MarkDannemiller/JackOLantern/research/concepts/README.md

# Concepts

Received from Mark in chat, 2026-10-24.

| File | What it is | Design cues taken |
|---|---|---|
| `20261024-sketch-notebook.jpg` | Original notebook sketch, "Pumpkin animatronic / scarecrow" | Legless torso on a pole and base; skeletal arms with hands; head with a curled stem; Will Cogley eye mechanism; jaw on a pivot; neck pitch and yaw. Features: looks at approaching people, speaks voice lines, recognises waving and mouth motion; later voice recognition. Camera could hide in the stem |
| `20261024-head-real-build.jpg` | The 2023 head as built | Orange printed facade, blue LED eyes, camera in the nose, toothed jaw, black neck with push rods |
| `20261024-concept-art-cowboy.jpg` | Character concept art (AI image) | Cowboy hat, green bandana with pink stars, tattered orange leather vest with star cut-outs, belt and holster, segmented weathered-orange arm shells with exposed mechanical joints, a metal robotic hand tipping the hat, visible rods in the torso |
