MarkDannemiller/JackOLantern/deliverables/2026-10-25-design-report/index.html

Delta Robotics · design report, revision 2 · 25 Oct 2026 · draft for Mark's review

# Joyful Jack

A body and two moving arms for our animatronic pumpkin cowboy, designed three ways, every screw modelled, each with a step-by-step build guide, and tested in a physics simulation before anything is bought.

Tiers A, B and C side by side

$894Tier A, Beginner

$1,381Tier B, Midrange

$2,370Tier C, Maxed

810parts and fasteners in tier B

Milwaukee M18battery packs

Where Jack comes from

## A head that already works, looking for a body

Jack's head was built in 2023: printed orange face, glowing blue eyes, blinking eyelids, a talking jaw, and a neck that turns and nods. A camera in his nose finds faces so he can look at whoever walks up, and he has a few dozen cowboy voice lines. This project gives him a torso, two arms and hands, and a battery so he can stand on his own all evening.

Original notebook sketch

The first sketch. A scarecrow on a pole, no legs, a heavy base.

The real head

The real head. Reused as-is in every tier.

Concept art

The character. Hat, bandana, tattered vest, weathered orange arm shells.

The three versions

## Pick how much Jack can do

All three share the same head, base, costume and battery system. They differ in the arms, the hands and how much they can sense.

Tier A

Tier A · was under $500

### Beginner

$894

A first build: hobby servos, plywood torso, and still a character people stop for.

See tier A →

Tier B

Tier B · was up to $1,200

### Midrange

$1,381

The one to build for a season of events: smart motors, safer, and he never has to sleep.

See tier B →

Tier C

Tier C · no cap set

### Maxed

$2,370

The show piece: real robot hands with fingers that each move on their own.

See tier C →

| Tier ABeginner | Tier BMidrange | Tier CMaxed
Price (new parts) | $894 | $1,381 | $2,370
Moving joints, each arm | 3 + grip | 5 + 2-motor hand | 6 + 8-motor hand
Hands | Mitt, 1 motor | Glove, 2 motors | Humanoid, 8 motors
Feels resistance | No | Yes | Yes
Battery | 1 pack | 2 packs, hot swap | 2 packs + wall
Swap a battery while running | No | Yes | Yes
Runs the arms | Head computer | Head computer | Own computer
Parts / screws and fittings | 139 / 427 | 198 / 612 | 210 / 614
Build guide | 70 pages | 100 pages | 106 pages

Recommendation: build tier B. It is still the best value: motors that feel resistance make Jack safer around children, and two batteries mean he never has to stop. Modelling every part raised all three prices: proper bearings, belts, shoulder springs and about 600 screws and inserts replace the rough first-pass joints, so tier B is now $1,381 against the old $1,200 cap and tier A $894 against $500. Tier C's hands can be added to a tier B Jack later, since the arms share the same frame, belts and wiring.

What every Jack has

## How he stands, and what powers him

### A bucket of concrete for feet

Jack has no legs. He stands on a steel pipe set into a 5-gallon bucket filled with concrete, about 44 kg, sitting on a 24-inch plywood disc that hides under his costume. The pipe screws into a floor flange cast into the concrete.

### One battery system

He runs on the Milwaukee M18 packs we already own. A dock with a switch and a fuse takes the pack. A cut-off module switches everything off before the pack runs flat, because an M18 pack can't be relied on to protect itself without a Milwaukee tool attached. Converters then make the voltages each part needs.

### A big red stop button

A latching emergency stop on his back cuts power to every motor at once, while the computer stays on. In tiers B and C the button holds a heavy-duty relay, so it also stops the hands.

Tier B with the costume off

Costume off (tier B). The aluminium frame on the steel pole, the shoulder springs either side, and the electronics board. Arms hang on their stops, so a power cut drops nothing.

### How long he runs

A 12 Ah pack holds about 216 watt-hours. We will measure Jack's real power draw on the bench. Until then, here are planning figures (assumed draws, 85% converter efficiency):

If Jack averages | 12 Ah pack | 8 Ah pack
30 W (mostly idle) | ~6 h | ~4 h
50 W (regular gestures) | ~3.7 h | ~2.4 h
80 W (busy all evening) | ~2.3 h | ~1.5 h

Tiers B and C swap packs without stopping, and tier C can also run from the wall.

### Keeping him upright

In the simulation, a push at shoulder height with both arms out tips him at 154–164 N (about 16–17 kg of force). A teenager leaning on his shoulder could do that.

For events: lay two 25 lb sandbags on the plywood disc under the costume: the simulation then needs 205–215 N, about a third more. Or tie the pole to a post.

A

Tier A · was under $500

## Beginner

A first build: hobby servos, plywood torso, and still a character people stop for.

$894new parts; your own flannel shirt

Tier A Joyful Jack, rendered

### How he works

Eight hobby servos, the kind used in RC cars: at each shoulder two 35 kg·cm servos, at the elbow a 25 kg·cm one, each driving its joint through a 3:1 toothed belt, plus one in each mitt. A second servo board joins the one already in the head, so the head's computer runs everything. The torso is a box of 12 mm birch plywood on the steel pole.

### What he can do

- Waves: lifts his arm forward and up and waves from the elbow
- Grips a light candy bag with a one-motor mitt
- Shoulder springs carry the arm's weight, so the small motors only move it
- Runs on one M18 pack with a low-battery cut-off
- Big red stop button on his back

### What he can't

- Feel when he touches someone (no feedback from the motors)
- Twist his upper arm or wrist
- Swap the battery without switching off

139 parts · 427 screws, nuts and inserts · 21 cables · 2.7 kg of printed parts

Tier A arm, costume off

The arm, every part modelled. Belt-driven shoulder and elbow hubs on thin bearings, the servos, the screws that hold them, and the mitt.

Tier A shoulder and balancer

The shoulder. Two extension springs on the torso pull a Dyneema cord over pulleys to a lever on the shoulder hub: a "zero-length spring" balancer that cancels most of the arm's weight at every angle.

Tier A hands

The hands. A cartoon mitt: three fingers as one paddle close against a thumb, driven by one servo on a shoulder-bolt pivot. Rubber pads give it grip.

Tier A from behind, costume off

From behind. The battery pack (red) in its dock, the stop button, and the electronics board.

Tier A exploded view

Every part, pulled apart. Base and pole stay put, the torso lifts, the arms move out, the head rises, and every screw lifts out of its hole.

### Proven in simulation

The whole robot in NVIDIA Isaac Sim with real masses from the 3D model, a 0.25 kg bag in the right hand, the shoulder springs on, and each motor limited so no belt is pulled past its rating.

Wave forearm up, waving for 10 s | Passes | worst joint 35% of motor max, within 3° of target, belts at 58% of rating
Wave, springs removed the same, without the shoulder balancer | Passes | worst joint 56% of motor max, within 3° of target, belts at 92% of rating
Reach and grip arm forward, hand closes | Passes | worst joint 31% of motor max, within 2° of target, belts at 51% of rating
Arm straight out to the side, then forward, 7 s each (stress test) | Limit | the shoulder can't hold it: 19° short of target, at its limit 30% of the time
Emergency stop power cut at full reach | Passes | The arms drop to their rest stops and nothing falls.

### Where the money goes

$894 in new parts, plus 7 small items not yet priced

Arms, motors, belts$299

Power and safety$185

Controllers and computer$14.95

Torso frame$117

Base and pole$80.83

Screws and fittings$95.43

3D-printing filament$69.56

WiringTBD

Costume$32.65

ToolsTBD

Tier A system in Protoboard

The wiring, in Protoboard. Every box is a real part with its voltages; Protoboard checked every connection: 0 problems.

Build guide, tier A (PDF, 70 pages)Step-by-step assembly with every part, screw and torque, made by the Protoboard stack from the same model.

Full parts list for tier A (58 lines)

Group | Item | Qty | Each | Line | Price from
Arms, motors, belts | Shoulder servos (flex x2 + out x2), 35 kg·cm class DIYmall 2 Sets 35kg DS3235 Digital Servo, coreless, full metal gear, 270° (ASIN B0CCNFQC6S); pack = 2 servos + | 2 | $48.00 | $96.00 | source (https://www.amazon.com/dp/B0CCNFQC6S)
Arms, motors, belts | Elbow servos, 25 kg class, 270° DSSERVO DS3225 MG, 270° angle option, with metal arm/horn accessory option (AIFitLab DSSERVO store) | 2 | $20.00 | $40.00 | source (https://aifitlab.com/products/dsservo-ds3225-mg-servo-motor)
Arms, motors, belts | Century 90CS balancer springs Extension spring 0.625 OD, 27 lbf | 4 | $9.37 | $37.48 | source (https://www.centuryspring.com/shop/90cs)
Arms, motors, belts | 6806-2RS joint bearings 6806-2RS bearing 30x42x7, 10-pack (DEEG) | 2 | $13.59 | $27.18 | source (https://www.amazon.com/dp/B0CJ6YY81X)
Arms, motors, belts | GT3 9 mm belts, 240 mm (shoulder joints) 3GT (GT2-3M) closed belt 240 mm / 80T, 9 mm, 5 pcs | 1 | $20.67 | $20.67 | source (https://www.amazon.com/dp/B0FFZ968GT)
Arms, motors, belts | GT3 9 mm belts, 210 mm (elbow) 3GT (GT2-3M) closed belt 210 mm / 70T, 9 mm, 5 pcs | 1 | $20.67 | $20.67 | source (https://www.amazon.com/dp/B0FFZC2YJB)
Arms, motors, belts | Hand grip servos (tier A), MG996R 4-pack Hosyond MG996R 55 g metal-gear digital servo, 4-pack | 1 | $16.99 | $16.99 | source (https://www.amazon.com/s?k=hosyond+mg996r+4+pack)
Arms, motors, belts | 2 mm Dyneema balancer cord 2 mm Dyneema cord, 20 m, 200 kg | 1 | $9.00 | $9.00 | source (https://www.amazon.com/dp/B00Q9IHLBS)
Arms, motors, belts | 624-2RS balancer sheave bearings 624-2RS bearing 4x13x5, 16-pack (uxcell) | 1 | $8.49 | $8.49 | source (https://www.amazon.com/dp/B0CLY84GJX)
Arms, motors, belts | 625-2RS driver outboard bearings 625-2RS bearing 5x16x5, 10-pack (C3) | 1 | $7.99 | $7.99 | source (https://www.amazon.com/dp/B07X8PK5HW)
Arms, motors, belts | Shoulder screws 5 x 8, M4 Shoulder screw 5 mm x 8 mm shoulder, M4, 16 pcs (MECCANIXITY) | 1 | $7.79 | $7.79 | source (https://www.amazon.com/dp/B0FDQVBNB9)
Arms, motors, belts | 5 x 16 mm driver dowels Dowel pin 5x16 mm, 304 stainless, 15 pcs (HARFINGTON) - not hardened | 1 | $6.29 | $6.29 | source (https://www.amazon.com/dp/B0F6CZZTK6)
Power and safety | Milwaukee M18 battery adapter with switch, fuse and 12 AWG leads Generic 'Power Wheel Adapter for Milwaukee M18' with on/off switch, 30 A blade fuse, 12 AWG leads, 1-pack (Ama | 1 | $34.99 | $34.99 | source (https://www.newegg.com/p/1WM-0071-00050)
Power and safety | Bucks (tier A): one 6.8 V rail for both arms, one 5-6 V rail for the head servos, one 5.1 V for the Pi DROK 300W Power Supply Module, DC 3.5-30V to 0.8-29V 10A adjustable buck with voltmeter (DROK product code 200 | 3 | $10.20 | $30.60 | source (https://www.droking.com/dc-buck/300W-Power-Supply-Module-DC-3.5-30V-to-0.8-29V-10A-Buck-Converter-Adjustable-Voltage-Regulator-Adapter-Driver-Module-Voltmeter)
Power and safety | 12 AWG silicone wire, red + black BNTECHGO 12 AWG silicone wire, 10 ft red + 10 ft black (Amazon ASIN B01ABOPMEI) | 1 | $27.52 | $27.52 | source (https://www.newegg.com/PISKEKAT-Work-Lights/BrandSubCat/ID-218576-2092/Page-13)
Power and safety | E-stop enclosure E-stop enclosure, 1-hole yellow (Schneider XALK01H7) - recheck | 1 | $26.02 | $26.02 | source (https://www.mouser.com/ProductDetail/Schneider-Electric/XALK01H7?qs=4R4UwjOJpC3Qi7CgpTrn7w%3D%3D)
Power and safety | Servo extension leads, 300 mm, 10-pack Generic 300 mm male-female servo extension, 26 AWG, JR/Futaba (10 pcs) | 2 | $9.95 | $19.90 | source (https://www.ebay.de/itm/335657377415)
Power and safety | Latching mushroom emergency stop, 22 mm, NC 22mm NC red mushroom emergency stop push button, 40 mm head, latching (ZB2-BE102C / XB2-BS142 style) | 1 | $12.17 | $12.17 | source (https://www.fridayparts.com/22mm-nc-n-c-red-mushroom-emergency-stop-push-button-switch-600v-10a-zb2-be102c-xb2-bs142)
Power and safety | Adjustable low-voltage cutoff for 5S Li-ion (~18 V) pack XH-M609 digital low voltage disconnect module, 12-36 V, relay output (Amazon ASIN B0FJ8NC729, MTDELE) | 1 | $9.99 | $9.99 | source (https://sentinel.rocketium.com/products/amazon/B0FJ8NC729)
Power and safety | Inline ATC fuse holder, 12 AWG Eaton Bussmann BK/HHD ATC in-line fuse holder, 12 Ga. leads (24 A) | 4 | $2.18 | $8.72 | source (https://www.waytekwire.com/product/eaton-s-bussmann-series-bk-hhd-atc-in-line-fuse)
Power and safety | ATC blade fuse assortment Bussmann ATC fuse assortment, variety pack (10/15/20/25/30 A) | 1 | $8.32 | $8.32 | source (https://www.walmart.com/ip/1764066057)
Power and safety | XT60 connector pairs Amass XT60 connectors, 2 pairs, yellow (BuddyRC SKU 002-0201) | 2 | $3.49 | $6.98 | source (https://buddyrc.com/products/genuine-xt60-connectors-2-pairs-yellow-1)
Controllers and computer | Second PCA9685 16-channel servo driver Adafruit 16-Channel 12-bit PWM/Servo Driver, I2C (PCA9685), Product ID 815 | 1 | $14.95 | $14.95 | source (https://www.adafruit.com/product/815)
Torso frame | 1/2 in birch plywood for the tier A torso box 1/2 in birch plywood project panel 2 x 4 ft, A2 (Home Depot) | 1 | $40.22 | $40.22 | source (https://www.homedepot.com/p/Falken-Design-1-2-in-x-2-ft-x-4-ft-Birch-Plywood-Project-Panel-FALKENDESIGN-PW-Birch-A2-1-2-2448/319137400)
Torso frame | 2020 extrusion, cut list 102 mm x2, 190 mm x2 Maker Store USA V-Slot 20x20mm, clear anodized, SKU LR-2020-S, 500 mm length | 2 | $6.75 | $13.50 | source (https://makerstore.cc/product/v-slot-20-x-20mm/)
Torso frame | 6 mm 6061 plate for the neck plate (150 x 150) 6061 aluminium plate 6 mm, 6 x 6 in (152 x 152 mm), 1 pc | 1 | $12.99 | $12.99 | source (https://www.amazon.com/dp/B0H87TP596)
Torso frame | M5 drop-in T-nuts for 2020 Drop-in tee nut M5, 10-pack (Maker Store) | 1 | $11.93 | $11.93 | source (https://makerstore.cc/product/drop-in-tee-nuts-pack-of-10/)
Torso frame | 1/4 in plywood, 2 x 4 ft project panel (torso ribs, tier A) B/C Sanded Plywood Project Panel 1/4 in x 2 ft x 4 ft (Home Depot Internet # 205748601) | 1 | $11.22 | $11.22 | source (https://homedepot.com/p/1-4-in-x-2-ft-x-4-ft-B-C-Sanded-Plywood-Project-Panel-00102/205748601)
Torso frame | #4 x 1/2 in wood screws (trays, board) #4 x 1/2 in flat head wood screw, zinc, 100 pcs | 1 | $7.35 | $7.35 | source (https://www.amazon.com/dp/B07C52W8WL)
Torso frame | Cast 90 deg corner brackets, 20 series Cast 90 deg corner bracket 20 series (Maker Store) | 4 | $1.80 | $7.20 | source (https://makerstore.cc/product/cast-90-degree-corner-bracket/)
Torso frame | #8 x 1-1/4 in wood screws (ply torso) #8 x 1-1/4 in flat head wood screw, 100 pcs (Hillman 35054) | 1 | $6.98 | $6.98 | source (https://www.amazon.com/dp/B00OTWQSIS)
Torso frame | M5 hammer-in tee nuts M5 hammer-in tee nut, 4-prong, zinc, 60 pcs (Hitefu) | 1 | $5.49 | $5.49 | source (https://www.amazon.com/dp/B0CLJBLYSC)
Torso frame | #8 x 3/4 in wood screw TBD | 1 | TBD | TBD
Base and pole | ALTERNATE for the 24 in round pine board: 3/4 in birch plywood 2x2 ft project panel, cut to a 24 in circle in-house Falken Design 3/4 in x 2 ft x 2 ft Birch Plywood Project Panel, FALKENDESIGN-PW-Birch-A2-3-4-2424 (HD 31913741 | 1 | $29.49 | $29.49 | source (https://www.homedepot.com/p/Falken-Design-3-4-in-x-2-ft-x-2-ft-Birch-Plywood-Project-Panel-FALKENDESIGN-PW-Birch-A2-3-4-2424/319137413)
Base and pole | 1 in x 30 in black nipple (mast) 1 in x 30 in Sch 40 black steel nipple, threaded both ends | 1 | $17.75 | $17.75 | source (https://www.globalindustrial.com/p/1-x-30-schedule-40-black-carbon-steel-nipple-700-3000-psi)
Base and pole | 1 in floor flange for center post Southland 1 in. Black Malleable Iron Threaded Floor Flange 521-605HN | 2 | $6.97 | $13.94 | source (https://homedepot.com/p/Southland-1-in-Black-Malleable-Iron-Threaded-Floor-Flange-521-605HN/100179931)
Base and pole | hex-bolt-1-4-20x1.25in (kit includes the nylock nuts and washers) 1/4-20 x 1-1/4 in hex bolt kit with nylock nuts and washers, 18 sets | 1 | $8.99 | $8.99 | source (https://www.amazon.com/dp/B0DM1WDZRL)
Base and pole | Concrete mix to fill bucket (~18.9 L = 0.667 cu ft) Quikrete Concrete Mix No. 1101, 80 lb bag (Home Depot model 110180) | 1 | $5.68 | $5.68 | source (https://shopsavvy.com/products/quickrete-80lb-concrete-mix)
Base and pole | 5 US gallon plastic bucket (ballast base) The Home Depot 5 Gallon Orange Homer Bucket, model 05GLHD2 (Internet #100087613) | 1 | $4.98 | $4.98 | source (https://www.homedepot.com/p/The-Home-Depot-5-Gallon-Orange-Homer-Bucket-05GLHD2/100087613)
Screws and fittings | Heat-set inserts M4 Heat-set insert M4 x 8.1, 50 pcs (CNC Kitchen via 3DJake) - recheck | 2 | $11.18 | $22.36 | source (https://www.3djake.com/cnc-kitchen/threaded-inserts-m4-standard)
Screws and fittings | Heat-set inserts M3 Heat-set insert M3 x 5.7, 100 pcs (Prusa, CNC Kitchen design) - recheck | 2 | $10.99 | $21.98 | source (https://www.prusa3d.com/product/heat-set-inserts/)
Screws and fittings | Socket head cap screws M4 (10 mm x32, 12 mm x4, 16 mm x8, 25 mm x2) SHCS M4 kit 6/8/10/12/16/20/25 mm, black oxide 12.9, 520 pcs | 1 | $8.99 | $8.99 | source (https://www.amazon.com/dp/B0GG8SZC1W)
Screws and fittings | Socket head cap screws M5 (10 mm x4, 12 mm x6, 16 mm x4, 20 mm x8) SHCS M5 kit 8/10/12/16/20/25/30 mm, black oxide 12.9, 290 pcs | 1 | $8.99 | $8.99 | source (https://www.amazon.com/dp/B0GG8RHBP7)
Screws and fittings | Socket head cap screws M3 (8 mm x8, 12 mm x56) SHCS M3 kit 6/8/10/12/16/20/25/30 mm, black oxide 12.9, 600 pcs | 1 | $7.99 | $7.99 | source (https://www.amazon.com/dp/B0DZT7HVTM)
Screws and fittings | Socket head cap screws M3 x 14 SHCS M3 x 14, black oxide 12.9, 120 pcs | 1 | $5.49 | $5.49 | source (https://www.amazon.com/dp/B0F31SWDP3)
Screws and fittings | iso7089-m4 M4 flat washer 9 mm OD, 304 SS, 100 pcs | 1 | $4.99 | $4.99 | source (https://www.amazon.com/dp/B0BGH6YLB7)
Screws and fittings | iso7089-m5 M5 flat washer 10 mm OD, 304 SS, 100 pcs | 1 | $4.99 | $4.99 | source (https://www.amazon.com/dp/B0BGHBH8RM)
Screws and fittings | iso10511-m4 M4 nylon-insert lock nut, 304 SS, 80 pcs | 1 | $4.86 | $4.86 | source (https://www.amazon.com/dp/B0DHLHY34R)
Screws and fittings | iso10511-m5 M5 nylon-insert lock nut, 304 SS, 50 pcs | 1 | $4.79 | $4.79 | source (https://www.amazon.com/dp/B0D8THJQNM)
3D-printing filament | PETG-CF filament (2123 g printed) PETG-CF 1 kg (Elegoo), black | 3 | $18.99 | $56.97 | source (https://www.amazon.com/dp/B0F37YCK6K)
3D-printing filament | PETG filament (555 g printed) PETG 1 kg (Elegoo Rapid PETG), black | 1 | $12.59 | $12.59 | source (https://www.amazon.com/dp/B0CPF7FDTG)
Wiring | 14 AWG silicone wire, 1.3 m (red and black counted) TBD | 1 | TBD | TBD
Wiring | 16 AWG silicone wire, 1.9 m (red and black counted) TBD | 1 | TBD | TBD
Wiring | 18 AWG silicone wire, 2.8 m (red and black counted) TBD | 1 | TBD | TBD
Wiring | 20 AWG silicone wire, 0.3 m (red and black counted) TBD | 1 | TBD | TBD
Wiring | 26 AWG silicone wire, 0.5 m (red and black counted) TBD | 1 | TBD | TBD
Costume | Cowboy / western vest TiaoBug Men's 3-piece faux suede western cowboy vest set (vest + bandanna + hat), black | 1 | $32.65 | $32.65 | source (https://www.walmart.com/ip/9980614009)
Tools | M5 tap and handle TBD | 1 | TBD | TBD
Total (TBD rows not included) | | | | $894

B

Tier B · was up to $1,200

## Midrange

The one to build for a season of events: smart motors, safer, and he never has to sleep.

$1,381new parts

Tier B Joyful Jack, rendered

### How he works

Fourteen Feetech STS3215 smart servos, the motors used in popular open-source robot arms. At each shoulder and elbow the servo drives a hollow hub on two thin bearings through a 3:1 toothed belt; the upper-arm and wrist twists are driven directly. A spring-and-cable balancer at each shoulder carries the arm's weight. An aluminium frame in the torso carries two Milwaukee packs, joined so one can be swapped live.

### What he can do

- Waves properly: the upper arm twists, so the hand comes up palm out
- Glove hands that open and close around a cup or a bag handle
- Every motor reports its position, load and temperature
- Two battery packs: pull one while the other keeps him going
- Tells you when the battery is getting low

### What he can't

- Move individual fingers
- Hold an arm straight out to the side for long (shown in the simulation below)

198 parts · 612 screws, nuts and inserts · 35 cables · 2.7 kg of printed parts

Tier B arm, costume off

The arm, every part modelled. Belt-driven shoulder and elbow hubs on thin bearings, the servos, the screws that hold them, and the glove hand.

Tier B shoulder and balancer

The shoulder. Two extension springs on the torso pull a Dyneema cord over pulleys to a lever on the shoulder hub: a "zero-length spring" balancer that cancels most of the arm's weight at every angle.

Tier B hands

The hands. A glove hand in a big cartoon glove: four fingers linked to close together around an object, and a separately driven thumb.

Tier B from behind, costume off

From behind. The battery packs (red) in their docks, the stop button, and the electronics board.

Tier B exploded view

Every part, pulled apart. Base and pole stay put, the torso lifts, the arms move out, the head rises, and every screw lifts out of its hole.

### Proven in simulation

The whole robot in NVIDIA Isaac Sim with real masses from the 3D model, a 0.25 kg bag in the right hand, the shoulder springs on, and each motor limited so no belt is pulled past its rating.

Wave forearm up, waving for 10 s | Passes | worst joint 65% of motor max, within 1° of target, belt briefly at its limit
Wave, springs removed the same, without the shoulder balancer | Limit | the shoulder can't hold it: 38° short of target, at its limit 14% of the time
Reach and grip arm forward, hand closes | Passes | worst joint 40% of motor max, within 2° of target, belts at 61% of rating
Arm straight out to the side, then forward, 7 s each (stress test) | Limit | the shoulder can't hold it: 99° short of target, at its limit 45% of the time
Emergency stop power cut at full reach | Passes | The arms drop to their rest stops and nothing falls.

### Where the money goes

$1,381 in new parts, plus 5 small items not yet priced

Arms, motors, belts$454

Hands$17.99

Power and safety$353

Controllers and computer$24.93

Torso frame$205

Base and pole$89.82

Screws and fittings$110

3D-printing filament$69.56

Wiring$11.97

Costume$44.63

ToolsTBD

Tier B system in Protoboard

The wiring, in Protoboard. Every box is a real part with its voltages; Protoboard checked every connection: 0 problems.

Build guide, tier B (PDF, 100 pages)Step-by-step assembly with every part, screw and torque, made by the Protoboard stack from the same model.

Full parts list for tier B (64 lines)

Group | Item | Qty | Each | Line | Price from
Arms, motors, belts | Serial bus servo 12 V 30 kg.cm (wrist/forearm/hand joints) Feetech ST3215-C047 12V 30 kg.cm, 1:345 (Seeed SKU 108090003); equivalent STS3215-C018 12V 1/345 | 14 | $22.00 | $308 | source (https://www.seeedstudio.com/STS3215-30KG-Serial-Servo-p-6340.html)
Arms, motors, belts | Century 90CS balancer springs Extension spring 0.625 OD, 27 lbf | 4 | $9.37 | $37.48 | source (https://www.centuryspring.com/shop/90cs)
Arms, motors, belts | 6806-2RS joint bearings 6806-2RS bearing 30x42x7, 10-pack (DEEG) | 2 | $13.59 | $27.18 | source (https://www.amazon.com/dp/B0CJ6YY81X)
Arms, motors, belts | GT3 9 mm belts, 240 mm (shoulder joints) 3GT (GT2-3M) closed belt 240 mm / 80T, 9 mm, 5 pcs | 1 | $20.67 | $20.67 | source (https://www.amazon.com/dp/B0FFZ968GT)
Arms, motors, belts | GT3 9 mm belts, 210 mm (elbow) 3GT (GT2-3M) closed belt 210 mm / 70T, 9 mm, 5 pcs | 1 | $20.67 | $20.67 | source (https://www.amazon.com/dp/B0FFZC2YJB)
Arms, motors, belts | 2 mm Dyneema balancer cord 2 mm Dyneema cord, 20 m, 200 kg | 1 | $9.00 | $9.00 | source (https://www.amazon.com/dp/B00Q9IHLBS)
Arms, motors, belts | 624-2RS balancer sheave bearings 624-2RS bearing 4x13x5, 16-pack (uxcell) | 1 | $8.49 | $8.49 | source (https://www.amazon.com/dp/B0CLY84GJX)
Arms, motors, belts | 625-2RS driver outboard bearings 625-2RS bearing 5x16x5, 10-pack (C3) | 1 | $7.99 | $7.99 | source (https://www.amazon.com/dp/B07X8PK5HW)
Arms, motors, belts | Shoulder screws 5 x 8, M4 Shoulder screw 5 mm x 8 mm shoulder, M4, 16 pcs (MECCANIXITY) | 1 | $7.79 | $7.79 | source (https://www.amazon.com/dp/B0FDQVBNB9)
Arms, motors, belts | 5 x 16 mm driver dowels Dowel pin 5x16 mm, 304 stainless, 15 pcs (HARFINGTON) - not hardened | 1 | $6.29 | $6.29 | source (https://www.amazon.com/dp/B0F6CZZTK6)
Hands | TPU 95A filament 1 kg ELEGOO TPU 95A 1.75 mm 1 kg | 1 | $17.99 | $17.99 | source (https://us.elegoo.com/products/tpu-filament-1-75mm-colored-1kg)
Power and safety | 18 AWG silicone wire, red + black BNTECHGO 18 AWG silicone wire spool, 25 ft red + 25 ft black (150 strands tinned copper, 200 C, 600 V) | 1 | $45.99 | $45.99 | source (https://bigamart.com/product/bntechgo-18-gauge-silicone-wire-spool-50-ft-ultra-flexible-high-temp-200-deg-c-600v-18-awg-silicone-wire-150-strands-of-tinned-co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)
Power and safety | Milwaukee M18 battery adapter with switch, fuse and 12 AWG leads Generic 'Power Wheel Adapter for Milwaukee M18' with on/off switch, 30 A blade fuse, 12 AWG leads, 1-pack (Ama | 1 | $34.99 | $34.99 | source (https://www.newegg.com/p/1WM-0071-00050)
Power and safety | Milwaukee M18 battery adapter with switch, fuse and 12 AWG leads Generic 'Power Wheel Adapter for Milwaukee M18' with on/off switch, 30 A blade fuse, 12 AWG leads, 1-pack (Ama | 1 | $34.99 | $34.99 | source (https://www.newegg.com/p/1WM-0071-00050)
Power and safety | 18 V -> 12 V DC-DC buck, 20 A EKYLIN 24V to 12V 20A 240W step-down converter, DC 15-40V input (Amazon ASIN B01JAIC9EM) | 2 | $17.47 | $34.94 | source (https://www.amazon.com/dp/B01JAIC9EM)
Power and safety | Blade fuse block, 6-way ATC/ATO, with negative bus Sea-Dog blade style LED indicator fuse block with negative bus bar, 6 circuit, 445185-1 | 1 | $30.99 | $30.99 | source (https://www.drsa.com/products/sea-dog-blade-style-led-indicator-fuse-block-w-negative-bus-bar-6-circuit-445185-1)
Power and safety | ALTERNATE for the Pi 5 V buck: Pololu D24V50F5 5 V 5 A step-down Pololu D24V50F5, item #2851 | 1 | $29.95 | $29.95 | source (https://www.pololu.com/product/2851)
Power and safety | Ideal-diode OR of two battery inputs GODIYMODULES / DIY-Module 40A-60A ideal diode module, single channel (Amazon ASIN B0DDBYNDX5), one per input i | 2 | $13.99 | $27.98 | source (https://www.amazon.com/dp/B0DDBYNDX5)
Power and safety | 12 AWG silicone wire, red + black BNTECHGO 12 AWG silicone wire, 10 ft red + 10 ft black (Amazon ASIN B01ABOPMEI) | 1 | $27.52 | $27.52 | source (https://www.newegg.com/PISKEKAT-Work-Lights/BrandSubCat/ID-218576-2092/Page-13)
Power and safety | E-stop enclosure E-stop enclosure, 1-hole yellow (Schneider XALK01H7) - recheck | 1 | $26.02 | $26.02 | source (https://www.mouser.com/ProductDetail/Schneider-Electric/XALK01H7?qs=4R4UwjOJpC3Qi7CgpTrn7w%3D%3D)
Power and safety | Latching mushroom emergency stop, 22 mm, NC 22mm NC red mushroom emergency stop push button, 40 mm head, latching (ZB2-BE102C / XB2-BS142 style) | 1 | $12.17 | $12.17 | source (https://www.fridayparts.com/22mm-nc-n-c-red-mushroom-emergency-stop-push-button-switch-600v-10a-zb2-be102c-xb2-bs142)
Power and safety | XT60 connector pairs Amass XT60 connectors, 2 pairs, yellow (BuddyRC SKU 002-0201) | 3 | $3.49 | $10.47 | source (https://buddyrc.com/products/genuine-xt60-connectors-2-pairs-yellow-1)
Power and safety | Buck for the head's servo rail (5-6 V) DROK 300W Power Supply Module, DC 3.5-30V to 0.8-29V 10A adjustable buck with voltmeter (DROK product code 200 | 1 | $10.20 | $10.20 | source (https://www.droking.com/dc-buck/300W-Power-Supply-Module-DC-3.5-30V-to-0.8-29V-10A-Buck-Converter-Adjustable-Voltage-Regulator-Adapter-Driver-Module-Voltmeter)
Power and safety | Adjustable low-voltage cutoff for 5S Li-ion (~18 V) pack XH-M609 digital low voltage disconnect module, 12-36 V, relay output (Amazon ASIN B0FJ8NC729, MTDELE) | 1 | $9.99 | $9.99 | source (https://sentinel.rocketium.com/products/amazon/B0FJ8NC729)
Power and safety | Relay >=30 A for actuator rail, switched by e-stop TEMCo 24V 40A 4-pin Bosch-style automotive relay, SPST (SKU CN0345) | 1 | $8.73 | $8.73 | source (https://temcoindustrial.com/24v-40a-4-pin-bosch-style-automotive-relay-spst/)
Power and safety | ATC blade fuse assortment Bussmann ATC fuse assortment, variety pack (10/15/20/25/30 A) | 1 | $8.32 | $8.32 | source (https://www.walmart.com/ip/1764066057)
Controllers and computer | Current/voltage monitor, I2C (chosen) Adafruit INA228 I2C 85V 20-bit high/low side power monitor, STEMMA QT (product 5832) | 1 | $14.95 | $14.95 | source (https://www.adafruit.com/product/5832)
Controllers and computer | Bus servo driver / USB-TTL adapter Waveshare Bus Servo Adapter (A), SKU 25514 | 2 | $4.99 | $9.98 | source (https://www.waveshare.com/bus-servo-adapter-a.htm)
Torso frame | M5 drop-in T-nuts for 2020 Drop-in tee nut M5, 10-pack (Maker Store) | 6 | $11.93 | $71.58 | source (https://makerstore.cc/product/drop-in-tee-nuts-pack-of-10/)
Torso frame | 2020 extrusion, cut list 100 mm x4, 102 mm x2, 180 mm x4, 190 mm x2, 340 mm x4 Maker Store USA V-Slot 20x20mm, clear anodized, SKU LR-2020-S, 500 mm length | 7 | $6.75 | $47.25 | source (https://makerstore.cc/product/v-slot-20-x-20mm/)
Torso frame | Cast 90 deg corner brackets, 20 series Cast 90 deg corner bracket 20 series (Maker Store) | 20 | $1.80 | $36.00 | source (https://makerstore.cc/product/cast-90-degree-corner-bracket/)
Torso frame | Plate for the torso base plate (220 x 140) 6061 aluminium plate 1/4 in, 6 x 12 in (152 x 305 mm) | 1 | $18.99 | $18.99 | source (https://www.amazon.com/dp/B0BF18PQJG)
Torso frame | 6 mm 6061 plate for the neck plate (150 x 150) 6061 aluminium plate 6 mm, 6 x 6 in (152 x 152 mm), 1 pc | 1 | $12.99 | $12.99 | source (https://www.amazon.com/dp/B0H87TP596)
Torso frame | 1/4 in plywood panel for the electronics board B/C Sanded Plywood Project Panel 1/4 in x 2 ft x 4 ft (Home Depot Internet # 205748601) | 1 | $11.22 | $11.22 | source (https://homedepot.com/p/1-4-in-x-2-ft-x-4-ft-B-C-Sanded-Plywood-Project-Panel-00102/205748601)
Torso frame | #4 x 1/2 in wood screws (trays, board) #4 x 1/2 in flat head wood screw, zinc, 100 pcs | 1 | $7.35 | $7.35 | source (https://www.amazon.com/dp/B07C52W8WL)
Base and pole | ALTERNATE for the 24 in round pine board: 3/4 in birch plywood 2x2 ft project panel, cut to a 24 in circle in-house Falken Design 3/4 in x 2 ft x 2 ft Birch Plywood Project Panel, FALKENDESIGN-PW-Birch-A2-3-4-2424 (HD 31913741 | 1 | $29.49 | $29.49 | source (https://www.homedepot.com/p/Falken-Design-3-4-in-x-2-ft-x-2-ft-Birch-Plywood-Project-Panel-FALKENDESIGN-PW-Birch-A2-3-4-2424/319137413)
Base and pole | 1 in x 30 in black nipple (mast) 1 in x 30 in Sch 40 black steel nipple, threaded both ends | 1 | $17.75 | $17.75 | source (https://www.globalindustrial.com/p/1-x-30-schedule-40-black-carbon-steel-nipple-700-3000-psi)
Base and pole | 1 in floor flange for center post Southland 1 in. Black Malleable Iron Threaded Floor Flange 521-605HN | 2 | $6.97 | $13.94 | source (https://homedepot.com/p/Southland-1-in-Black-Malleable-Iron-Threaded-Floor-Flange-521-605HN/100179931)
Base and pole | hex-bolt-1-4-20x1in (kit includes the nylock nuts and washers) 1/4-20 x 1 in hex bolt kit with nylock nuts and washers, 18 sets | 1 | $8.99 | $8.99 | source (https://www.amazon.com/dp/B0DM1ZJJYB)
Base and pole | hex-bolt-1-4-20x1.25in (kit includes the nylock nuts and washers) 1/4-20 x 1-1/4 in hex bolt kit with nylock nuts and washers, 18 sets | 1 | $8.99 | $8.99 | source (https://www.amazon.com/dp/B0DM1WDZRL)
Base and pole | Concrete mix to fill bucket (~18.9 L = 0.667 cu ft) Quikrete Concrete Mix No. 1101, 80 lb bag (Home Depot model 110180) | 1 | $5.68 | $5.68 | source (https://shopsavvy.com/products/quickrete-80lb-concrete-mix)
Base and pole | 5 US gallon plastic bucket (ballast base) The Home Depot 5 Gallon Orange Homer Bucket, model 05GLHD2 (Internet #100087613) | 1 | $4.98 | $4.98 | source (https://www.homedepot.com/p/The-Home-Depot-5-Gallon-Orange-Homer-Bucket-05GLHD2/100087613)
Screws and fittings | Heat-set inserts M3 Heat-set insert M3 x 5.7, 100 pcs (Prusa, CNC Kitchen design) - recheck | 2 | $10.99 | $21.98 | source (https://www.prusa3d.com/product/heat-set-inserts/)
Screws and fittings | Socket head cap screws M5 (10 mm x41, 12 mm x18, 20 mm x4) SHCS M5 kit 8/10/12/16/20/25/30 mm, black oxide 12.9, 290 pcs | 2 | $8.99 | $17.98 | source (https://www.amazon.com/dp/B0GG8RHBP7)
Screws and fittings | Servo case screws PA2X8 M2 x 8 self-tapping pan head, 50 pcs (METALLIXITY) | 2 | $5.69 | $11.38 | source (https://www.amazon.com/dp/B0FJDJ9H5V)
Screws and fittings | Heat-set inserts M4 Heat-set insert M4 x 8.1, 50 pcs (CNC Kitchen via 3DJake) - recheck | 1 | $11.18 | $11.18 | source (https://www.3djake.com/cnc-kitchen/threaded-inserts-m4-standard)
Screws and fittings | Socket head cap screws M4 (12 mm x4, 16 mm x8, 20 mm x4) SHCS M4 kit 6/8/10/12/16/20/25 mm, black oxide 12.9, 520 pcs | 1 | $8.99 | $8.99 | source (https://www.amazon.com/dp/B0GG8SZC1W)
Screws and fittings | Socket head cap screws M3 (6 mm x16, 8 mm x32, 12 mm x64, 30 mm x12) SHCS M3 kit 6/8/10/12/16/20/25/30 mm, black oxide 12.9, 600 pcs | 1 | $7.99 | $7.99 | source (https://www.amazon.com/dp/B0DZT7HVTM)
Screws and fittings | Servo case screws PA2X6 M2 x 6 self-tapping pan head, 50 pcs (METALLIXITY) | 1 | $5.69 | $5.69 | source (https://www.amazon.com/dp/B0FJDMLVFY)
Screws and fittings | Socket head cap screws M3 x 14 SHCS M3 x 14, black oxide 12.9, 120 pcs | 1 | $5.49 | $5.49 | source (https://www.amazon.com/dp/B0F31SWDP3)
Screws and fittings | iso7089-m4 M4 flat washer 9 mm OD, 304 SS, 100 pcs | 1 | $4.99 | $4.99 | source (https://www.amazon.com/dp/B0BGH6YLB7)
Screws and fittings | iso7089-m5 M5 flat washer 10 mm OD, 304 SS, 100 pcs | 1 | $4.99 | $4.99 | source (https://www.amazon.com/dp/B0BGHBH8RM)
Screws and fittings | iso10511-m4 M4 nylon-insert lock nut, 304 SS, 80 pcs | 1 | $4.86 | $4.86 | source (https://www.amazon.com/dp/B0DHLHY34R)
Screws and fittings | iso10511-m5 M5 nylon-insert lock nut, 304 SS, 50 pcs | 1 | $4.79 | $4.79 | source (https://www.amazon.com/dp/B0D8THJQNM)
3D-printing filament | PETG-CF filament (2071 g printed) PETG-CF 1 kg (Elegoo), black | 3 | $18.99 | $56.97 | source (https://www.amazon.com/dp/B0F37YCK6K)
3D-printing filament | PETG filament (582 g printed) PETG 1 kg (Elegoo Rapid PETG), black | 1 | $12.59 | $12.59 | source (https://www.amazon.com/dp/B0CPF7FDTG)
Wiring | Feetech 5264 3-pin bus cables (14 in the chains) Feetech 5264 3P servo cable 900 mm, 6 pcs (Waveshare) - recheck | 3 | $3.99 | $11.97 | source (https://www.waveshare.com/sr-cable-5264-3pin.htm?sku=34172)
Wiring | 14 AWG silicone wire, 2.9 m (red and black counted) TBD | 1 | TBD | TBD
Wiring | 16 AWG silicone wire, 1.0 m (red and black counted) TBD | 1 | TBD | TBD
Wiring | 20 AWG silicone wire, 0.9 m (red and black counted) TBD | 1 | TBD | TBD
Wiring | 26 AWG silicone wire, 0.4 m (red and black counted) TBD | 1 | TBD | TBD
Costume | Cowboy / western vest TiaoBug Men's 3-piece faux suede western cowboy vest set (vest + bandanna + hat), black | 1 | $32.65 | $32.65 | source (https://www.walmart.com/ip/9980614009)
Costume | Men's plaid flannel shirt George Men's and Big Men's Flannel Shirt with Long Sleeves (Walmart item 5454053875) | 1 | $11.98 | $11.98 | source (https://www.walmart.com/ip/George-Men-s-and-Big-Men-s-Flannel-Shirt-with-Long-Sleeves-Sizes-XS-3XLT/5454053875)
Tools | M5 tap and handle TBD | 1 | TBD | TBD
Total (TBD rows not included) | | | | $1,381

C

Tier C · no cap set

## Maxed

The show piece: real robot hands with fingers that each move on their own.

$2,370new parts

Tier C Joyful Jack, rendered

### How he works

Tier B's arm, upgraded: stronger 50 kg·cm STS3250 motors at both shoulder joints and the elbow (still through belts), plus a wrist that bends. Each hand is a Pollen Robotics AmazingHand: an open-source hand with eight tiny motors in the palm. A Raspberry Pi 5 in the chest runs the arms and hands. A mains supply joins the two battery packs.

### What he can do

- Humanoid hands: four fingers, each with two moving joints
- A wrist that bends as well as twists, for a hat-tip like the concept art
- Batteries plus wall power, so he can run all day indoors
- His own computer in the chest for the arms and hands

### What he can't

- Thumbs (the hand used has four fingers, which suits a cartoon)
- Strong grip: the hand's grip force is not published

210 parts · 614 screws, nuts and inserts · 43 cables · 2.4 kg of printed parts

Tier C arm, costume off

The arm, every part modelled. Belt-driven shoulder and elbow hubs on thin bearings, the servos, the screws that hold them, and the AmazingHand.

Tier C shoulder and balancer

The shoulder. Two extension springs on the torso pull a Dyneema cord over pulleys to a lever on the shoulder hub: a "zero-length spring" balancer that cancels most of the arm's weight at every angle.

Tier C hands

The hands. The Pollen AmazingHand: four fingers, two joints each, eight micro servos, 400 g. Open source (designs CC BY 4.0), sold as a kit by Seeed Studio.

Tier C from behind, costume off

From behind. The battery packs (red) in their docks, the stop button, and the electronics board.

Tier C exploded view

Every part, pulled apart. Base and pole stay put, the torso lifts, the arms move out, the head rises, and every screw lifts out of its hole.

### Proven in simulation

The whole robot in NVIDIA Isaac Sim with real masses from the 3D model, a 0.25 kg bag in the right hand, the shoulder springs on, and each motor limited so no belt is pulled past its rating.

Wave forearm up, waving for 10 s | Passes | worst joint 37% of motor max, within 2° of target, belts at 96% of rating
Wave, springs removed the same, without the shoulder balancer | Limit | the shoulder can't hold it: 43° short of target, at its limit 20% of the time
Reach and grip arm forward, hand closes | Passes | worst joint 36% of motor max, within 2° of target, belts at 92% of rating
Arm straight out to the side, then forward, 7 s each (stress test) | Limit | the shoulder can't hold it: 59° short of target, at its limit 39% of the time
Emergency stop power cut at full reach | Passes | The arms drop to their rest stops and nothing falls.

### Where the money goes

$2,370 in new parts, plus 5 small items not yet priced

Arms, motors, belts$860

Hands$216

Power and safety$548

Controllers and computer$211

Torso frame$205

Base and pole$89.82

Screws and fittings$118

3D-printing filament$69.56

Wiring$7.98

Costume$44.63

ToolsTBD

Tier C system in Protoboard

The wiring, in Protoboard. Every box is a real part with its voltages; Protoboard checked every connection: 0 errors, 2 notes explained in the decision log.

Build guide, tier C (PDF, 106 pages)Step-by-step assembly with every part, screw and torque, made by the Protoboard stack from the same model.

Full parts list for tier C (76 lines)

Group | Item | Qty | Each | Line | Price from
Arms, motors, belts | High-torque serial bus servo (shoulder/elbow joints) Feetech STS3250 (ST-3250-C001, 12 V 50 kg.cm, magnetic encoder, double shaft, with bracket); alt variant STS32 | 6 | $97.00 | $582 | source (https://aifitlab.com/products/feetech-sts3250-servo-motor)
Arms, motors, belts | Serial bus servo 12 V 30 kg.cm (wrist/forearm/hand joints) Feetech ST3215-C047 12V 30 kg.cm, 1:345 (Seeed SKU 108090003); equivalent STS3215-C018 12V 1/345 | 6 | $22.00 | $132 | source (https://www.seeedstudio.com/STS3215-30KG-Serial-Servo-p-6340.html)
Arms, motors, belts | Century 90CS balancer springs Extension spring 0.625 OD, 27 lbf | 4 | $9.37 | $37.48 | source (https://www.centuryspring.com/shop/90cs)
Arms, motors, belts | 6806-2RS joint bearings 6806-2RS bearing 30x42x7, 10-pack (DEEG) | 2 | $13.59 | $27.18 | source (https://www.amazon.com/dp/B0CJ6YY81X)
Arms, motors, belts | GT3 9 mm belts, 240 mm (shoulder joints) 3GT (GT2-3M) closed belt 240 mm / 80T, 9 mm, 5 pcs | 1 | $20.67 | $20.67 | source (https://www.amazon.com/dp/B0FFZ968GT)
Arms, motors, belts | GT3 9 mm belts, 210 mm (elbow) 3GT (GT2-3M) closed belt 210 mm / 70T, 9 mm, 5 pcs | 1 | $20.67 | $20.67 | source (https://www.amazon.com/dp/B0FFZC2YJB)
Arms, motors, belts | 2 mm Dyneema balancer cord 2 mm Dyneema cord, 20 m, 200 kg | 1 | $9.00 | $9.00 | source (https://www.amazon.com/dp/B00Q9IHLBS)
Arms, motors, belts | 624-2RS balancer sheave bearings 624-2RS bearing 4x13x5, 16-pack (uxcell) | 1 | $8.49 | $8.49 | source (https://www.amazon.com/dp/B0CLY84GJX)
Arms, motors, belts | 625-2RS driver outboard bearings 625-2RS bearing 5x16x5, 10-pack (C3) | 1 | $7.99 | $7.99 | source (https://www.amazon.com/dp/B07X8PK5HW)
Arms, motors, belts | Shoulder screws 5 x 8, M4 Shoulder screw 5 mm x 8 mm shoulder, M4, 16 pcs (MECCANIXITY) | 1 | $7.79 | $7.79 | source (https://www.amazon.com/dp/B0FDQVBNB9)
Arms, motors, belts | 5 x 16 mm driver dowels Dowel pin 5x16 mm, 304 stainless, 15 pcs (HARFINGTON) - not hardened | 1 | $6.29 | $6.29 | source (https://www.amazon.com/dp/B0F6CZZTK6)
Hands | AmazingHand kit, right hand Seeed Studio Amazing Hand (Right Hand) developer kit, SKU 100063642 | 1 | $99.00 | $99.00 | source (https://www.seeedstudio.com/Amazing-Hand-Right-Hand-The-Open-Source-Robotic-Hand-Developer-Kit.html)
Hands | AmazingHand kit, left hand Seeed Studio Amazing Hand (Left Hand) kit, SKU 100062181 | 1 | $99.00 | $99.00 | source (https://www.seeedstudio.com/amazinghand-open-source-robotic-hand-kit.html)
Hands | TPU 95A filament 1 kg ELEGOO TPU 95A 1.75 mm 1 kg | 1 | $17.99 | $17.99 | source (https://us.elegoo.com/products/tpu-filament-1-75mm-colored-1kg)
Power and safety | 5 V hand servo rail buck (one per hand) Pololu D36V50F5 5 V 5.5 A step-down, item 4091 | 2 | $39.95 | $79.90 | source (https://www.pololu.com/product/4091)
Power and safety | 18 AWG silicone wire, red + black BNTECHGO 18 AWG silicone wire spool, 25 ft red + 25 ft black (150 strands tinned copper, 200 C, 600 V) | 1 | $45.99 | $45.99 | source (https://bigamart.com/product/bntechgo-18-gauge-silicone-wire-spool-50-ft-ultra-flexible-high-temp-200-deg-c-600v-18-awg-silicone-wire-150-strands-of-tinned-co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)
Power and safety | Ideal-diode OR of two battery inputs GODIYMODULES / DIY-Module 40A-60A ideal diode module, single channel (Amazon ASIN B0DDBYNDX5), one per input i | 3 | $13.99 | $41.97 | source (https://www.amazon.com/dp/B0DDBYNDX5)
Power and safety | Custom PDB: JLCPCB 2-layer 100x100 mm, 5 pcs, economic PCBA (lot) JLCPCB | 1 | $38.00 | $38.00 | source (https://jlcpcb.com/help/article/pcb-assembly-price)
Power and safety | Milwaukee M18 battery adapter with switch, fuse and 12 AWG leads Generic 'Power Wheel Adapter for Milwaukee M18' with on/off switch, 30 A blade fuse, 12 AWG leads, 1-pack (Ama | 1 | $34.99 | $34.99 | source (https://www.newegg.com/p/1WM-0071-00050)
Power and safety | Milwaukee M18 battery adapter with switch, fuse and 12 AWG leads Generic 'Power Wheel Adapter for Milwaukee M18' with on/off switch, 30 A blade fuse, 12 AWG leads, 1-pack (Ama | 1 | $34.99 | $34.99 | source (https://www.newegg.com/p/1WM-0071-00050)
Power and safety | 18 V -> 12 V DC-DC buck, 20 A EKYLIN 24V to 12V 20A 240W step-down converter, DC 15-40V input (Amazon ASIN B01JAIC9EM) | 2 | $17.47 | $34.94 | source (https://www.amazon.com/dp/B01JAIC9EM)
Power and safety | 24 V mains supply (third OR input) Mean Well LRS-350-24 | 1 | $31.40 | $31.40 | source (https://punchouttest.digikey.com.mx/en/products/detail/mean-well-usa-inc/LRS-350-24/7705034)
Power and safety | Blade fuse block, 6-way ATC/ATO, with negative bus Sea-Dog blade style LED indicator fuse block with negative bus bar, 6 circuit, 445185-1 | 1 | $30.99 | $30.99 | source (https://www.drsa.com/products/sea-dog-blade-style-led-indicator-fuse-block-w-negative-bus-bar-6-circuit-445185-1)
Power and safety | ALTERNATE for the Pi 5 V buck: Pololu D24V50F5 5 V 5 A step-down Pololu D24V50F5, item #2851 | 1 | $29.95 | $29.95 | source (https://www.pololu.com/product/2851)
Power and safety | 12 AWG silicone wire, red + black BNTECHGO 12 AWG silicone wire, 10 ft red + 10 ft black (Amazon ASIN B01ABOPMEI) | 1 | $27.52 | $27.52 | source (https://www.newegg.com/PISKEKAT-Work-Lights/BrandSubCat/ID-218576-2092/Page-13)
Power and safety | E-stop enclosure E-stop enclosure, 1-hole yellow (Schneider XALK01H7) - recheck | 1 | $26.02 | $26.02 | source (https://www.mouser.com/ProductDetail/Schneider-Electric/XALK01H7?qs=4R4UwjOJpC3Qi7CgpTrn7w%3D%3D)
Power and safety | Latching mushroom emergency stop, 22 mm, NC 22mm NC red mushroom emergency stop push button, 40 mm head, latching (ZB2-BE102C / XB2-BS142 style) | 1 | $12.17 | $12.17 | source (https://www.fridayparts.com/22mm-nc-n-c-red-mushroom-emergency-stop-push-button-switch-600v-10a-zb2-be102c-xb2-bs142)
Power and safety | XT60 connector pairs Amass XT60 connectors, 2 pairs, yellow (BuddyRC SKU 002-0201) | 3 | $3.49 | $10.47 | source (https://buddyrc.com/products/genuine-xt60-connectors-2-pairs-yellow-1)
Power and safety | Buck for the torso Raspberry Pi 5, set to 5.1 V (tier C) DROK 300W Power Supply Module, DC 3.5-30V to 0.8-29V 10A adjustable buck with voltmeter (DROK product code 200 | 1 | $10.20 | $10.20 | source (https://www.droking.com/dc-buck/300W-Power-Supply-Module-DC-3.5-30V-to-0.8-29V-10A-Buck-Converter-Adjustable-Voltage-Regulator-Adapter-Driver-Module-Voltmeter)
Power and safety | Buck for the head's servo rail (5-6 V) DROK 300W Power Supply Module, DC 3.5-30V to 0.8-29V 10A adjustable buck with voltmeter (DROK product code 200 | 1 | $10.20 | $10.20 | source (https://www.droking.com/dc-buck/300W-Power-Supply-Module-DC-3.5-30V-to-0.8-29V-10A-Buck-Converter-Adjustable-Voltage-Regulator-Adapter-Driver-Module-Voltmeter)
Power and safety | Adjustable low-voltage cutoff for 5S Li-ion (~18 V) pack XH-M609 digital low voltage disconnect module, 12-36 V, relay output (Amazon ASIN B0FJ8NC729, MTDELE) | 1 | $9.99 | $9.99 | source (https://sentinel.rocketium.com/products/amazon/B0FJ8NC729)
Power and safety | Relay >=30 A for actuator rail, switched by e-stop TEMCo 24V 40A 4-pin Bosch-style automotive relay, SPST (SKU CN0345) | 1 | $8.73 | $8.73 | source (https://temcoindustrial.com/24v-40a-4-pin-bosch-style-automotive-relay-spst/)
Power and safety | ATC blade fuse assortment Bussmann ATC fuse assortment, variety pack (10/15/20/25/30 A) | 1 | $8.32 | $8.32 | source (https://www.walmart.com/ip/1764066057)
Power and safety | Custom PDB: current/voltage monitor (one per input) TI INA226AIDGSR | 3 | $2.66 | $7.98 | source (https://punchouttest.digikey.com.mx/en/products/detail/texas-instruments/INA226AIDGSR/2687236)
Power and safety | Custom PDB: eFuse per output branch TI TPS25982 (TPS259824ONRGET, 24-VQFN 4x4) | 2 | $3.82 | $7.64 | source (https://punchouttest.digikey.com.mx/en/products/detail/texas-instruments/TPS259824ONRGET/10273222)
Power and safety | Custom PDB: ideal-diode controller (one per OR input) TI LM74700QDBVRQ1 | 3 | $1.89 | $5.67 | source (https://punchouttest.digikey.com.mx/en/products/detail/texas-instruments/LM74700QDBVRQ1/10434692)
Controllers and computer | Main computer Raspberry Pi 5 8 GB | 1 | $175 | $175 | source (https://www.pishop.us/product/raspberry-pi-5-8gb/)
Controllers and computer | Current/voltage monitor, I2C (chosen) Adafruit INA228 I2C 85V 20-bit high/low side power monitor, STEMMA QT (product 5832) | 1 | $14.95 | $14.95 | source (https://www.adafruit.com/product/5832)
Controllers and computer | Pi cooling Raspberry Pi Active Cooler (SC1148) | 1 | $10.95 | $10.95 | source (https://www.pishop.us/product/raspberry-pi-active-cooler/)
Controllers and computer | Bus servo driver / USB-TTL adapter Waveshare Bus Servo Adapter (A), SKU 25514 | 2 | $4.99 | $9.98 | source (https://www.waveshare.com/bus-servo-adapter-a.htm)
Torso frame | M5 drop-in T-nuts for 2020 Drop-in tee nut M5, 10-pack (Maker Store) | 6 | $11.93 | $71.58 | source (https://makerstore.cc/product/drop-in-tee-nuts-pack-of-10/)
Torso frame | 2020 extrusion, cut list 100 mm x4, 102 mm x2, 180 mm x4, 190 mm x2, 340 mm x4 Maker Store USA V-Slot 20x20mm, clear anodized, SKU LR-2020-S, 500 mm length | 7 | $6.75 | $47.25 | source (https://makerstore.cc/product/v-slot-20-x-20mm/)
Torso frame | Cast 90 deg corner brackets, 20 series Cast 90 deg corner bracket 20 series (Maker Store) | 20 | $1.80 | $36.00 | source (https://makerstore.cc/product/cast-90-degree-corner-bracket/)
Torso frame | Plate for the torso base plate (220 x 140) 6061 aluminium plate 1/4 in, 6 x 12 in (152 x 305 mm) | 1 | $18.99 | $18.99 | source (https://www.amazon.com/dp/B0BF18PQJG)
Torso frame | 6 mm 6061 plate for the neck plate (150 x 150) 6061 aluminium plate 6 mm, 6 x 6 in (152 x 152 mm), 1 pc | 1 | $12.99 | $12.99 | source (https://www.amazon.com/dp/B0H87TP596)
Torso frame | 1/4 in plywood panel for the electronics board B/C Sanded Plywood Project Panel 1/4 in x 2 ft x 4 ft (Home Depot Internet # 205748601) | 1 | $11.22 | $11.22 | source (https://homedepot.com/p/1-4-in-x-2-ft-x-4-ft-B-C-Sanded-Plywood-Project-Panel-00102/205748601)
Torso frame | #4 x 1/2 in wood screws (trays, board) #4 x 1/2 in flat head wood screw, zinc, 100 pcs | 1 | $7.35 | $7.35 | source (https://www.amazon.com/dp/B07C52W8WL)
Base and pole | ALTERNATE for the 24 in round pine board: 3/4 in birch plywood 2x2 ft project panel, cut to a 24 in circle in-house Falken Design 3/4 in x 2 ft x 2 ft Birch Plywood Project Panel, FALKENDESIGN-PW-Birch-A2-3-4-2424 (HD 31913741 | 1 | $29.49 | $29.49 | source (https://www.homedepot.com/p/Falken-Design-3-4-in-x-2-ft-x-2-ft-Birch-Plywood-Project-Panel-FALKENDESIGN-PW-Birch-A2-3-4-2424/319137413)
Base and pole | 1 in x 30 in black nipple (mast) 1 in x 30 in Sch 40 black steel nipple, threaded both ends | 1 | $17.75 | $17.75 | source (https://www.globalindustrial.com/p/1-x-30-schedule-40-black-carbon-steel-nipple-700-3000-psi)
Base and pole | 1 in floor flange for center post Southland 1 in. Black Malleable Iron Threaded Floor Flange 521-605HN | 2 | $6.97 | $13.94 | source (https://homedepot.com/p/Southland-1-in-Black-Malleable-Iron-Threaded-Floor-Flange-521-605HN/100179931)
Base and pole | hex-bolt-1-4-20x1in (kit includes the nylock nuts and washers) 1/4-20 x 1 in hex bolt kit with nylock nuts and washers, 18 sets | 1 | $8.99 | $8.99 | source (https://www.amazon.com/dp/B0DM1ZJJYB)
Base and pole | hex-bolt-1-4-20x1.25in (kit includes the nylock nuts and washers) 1/4-20 x 1-1/4 in hex bolt kit with nylock nuts and washers, 18 sets | 1 | $8.99 | $8.99 | source (https://www.amazon.com/dp/B0DM1WDZRL)
Base and pole | Concrete mix to fill bucket (~18.9 L = 0.667 cu ft) Quikrete Concrete Mix No. 1101, 80 lb bag (Home Depot model 110180) | 1 | $5.68 | $5.68 | source (https://shopsavvy.com/products/quickrete-80lb-concrete-mix)
Base and pole | 5 US gallon plastic bucket (ballast base) The Home Depot 5 Gallon Orange Homer Bucket, model 05GLHD2 (Internet #100087613) | 1 | $4.98 | $4.98 | source (https://www.homedepot.com/p/The-Home-Depot-5-Gallon-Orange-Homer-Bucket-05GLHD2/100087613)
Screws and fittings | Heat-set inserts M3 Heat-set insert M3 x 5.7, 100 pcs (Prusa, CNC Kitchen design) - recheck | 2 | $10.99 | $21.98 | source (https://www.prusa3d.com/product/heat-set-inserts/)
Screws and fittings | Socket head cap screws M5 (10 mm x41, 12 mm x18, 20 mm x4) SHCS M5 kit 8/10/12/16/20/25/30 mm, black oxide 12.9, 290 pcs | 2 | $8.99 | $17.98 | source (https://www.amazon.com/dp/B0GG8RHBP7)
Screws and fittings | Socket head cap screws M3 (6 mm x16, 8 mm x16, 12 mm x72, 20 mm x8, 30 mm x12) SHCS M3 kit 6/8/10/12/16/20/25/30 mm, black oxide 12.9, 600 pcs | 2 | $7.99 | $15.98 | source (https://www.amazon.com/dp/B0DZT7HVTM)
Screws and fittings | Servo case screws PA2X8 M2 x 8 self-tapping pan head, 50 pcs (METALLIXITY) | 2 | $5.69 | $11.38 | source (https://www.amazon.com/dp/B0FJDJ9H5V)
Screws and fittings | Heat-set inserts M4 Heat-set insert M4 x 8.1, 50 pcs (CNC Kitchen via 3DJake) - recheck | 1 | $11.18 | $11.18 | source (https://www.3djake.com/cnc-kitchen/threaded-inserts-m4-standard)
Screws and fittings | Socket head cap screws M4 (12 mm x4, 16 mm x8, 20 mm x4) SHCS M4 kit 6/8/10/12/16/20/25 mm, black oxide 12.9, 520 pcs | 1 | $8.99 | $8.99 | source (https://www.amazon.com/dp/B0GG8SZC1W)
Screws and fittings | Servo case screws PA2X6 M2 x 6 self-tapping pan head, 50 pcs (METALLIXITY) | 1 | $5.69 | $5.69 | source (https://www.amazon.com/dp/B0FJDMLVFY)
Screws and fittings | Socket head cap screws M3 x 14 SHCS M3 x 14, black oxide 12.9, 120 pcs | 1 | $5.49 | $5.49 | source (https://www.amazon.com/dp/B0F31SWDP3)
Screws and fittings | iso7089-m4 M4 flat washer 9 mm OD, 304 SS, 100 pcs | 1 | $4.99 | $4.99 | source (https://www.amazon.com/dp/B0BGH6YLB7)
Screws and fittings | iso7089-m5 M5 flat washer 10 mm OD, 304 SS, 100 pcs | 1 | $4.99 | $4.99 | source (https://www.amazon.com/dp/B0BGHBH8RM)
Screws and fittings | iso10511-m4 M4 nylon-insert lock nut, 304 SS, 80 pcs | 1 | $4.86 | $4.86 | source (https://www.amazon.com/dp/B0DHLHY34R)
Screws and fittings | iso10511-m5 M5 nylon-insert lock nut, 304 SS, 50 pcs | 1 | $4.79 | $4.79 | source (https://www.amazon.com/dp/B0D8THJQNM)
3D-printing filament | PETG-CF filament (2194 g printed) PETG-CF 1 kg (Elegoo), black | 3 | $18.99 | $56.97 | source (https://www.amazon.com/dp/B0F37YCK6K)
3D-printing filament | PETG filament (163 g printed) PETG 1 kg (Elegoo Rapid PETG), black | 1 | $12.59 | $12.59 | source (https://www.amazon.com/dp/B0CPF7FDTG)
Wiring | Feetech 5264 3-pin bus cables (12 in the chains) Feetech 5264 3P servo cable 900 mm, 6 pcs (Waveshare) - recheck | 2 | $3.99 | $7.98 | source (https://www.waveshare.com/sr-cable-5264-3pin.htm?sku=34172)
Wiring | 14 AWG silicone wire, 3.0 m (red and black counted) TBD | 1 | TBD | TBD
Wiring | 16 AWG silicone wire, 1.0 m (red and black counted) TBD | 1 | TBD | TBD
Wiring | 20 AWG silicone wire, 0.9 m (red and black counted) TBD | 1 | TBD | TBD
Wiring | 26 AWG silicone wire, 0.4 m (red and black counted) TBD | 1 | TBD | TBD
Costume | Cowboy / western vest TiaoBug Men's 3-piece faux suede western cowboy vest set (vest + bandanna + hat), black | 1 | $32.65 | $32.65 | source (https://www.walmart.com/ip/9980614009)
Costume | Men's plaid flannel shirt George Men's and Big Men's Flannel Shirt with Long Sleeves (Walmart item 5454053875) | 1 | $11.98 | $11.98 | source (https://www.walmart.com/ip/George-Men-s-and-Big-Men-s-Flannel-Shirt-with-Long-Sleeves-Sizes-XS-3XLT/5454053875)
Tools | M5 tap and handle TBD | 1 | TBD | TBD
Total (TBD rows not included) | | | | $2,370

See him move

## Animations

A walkthrough of the recommended build, the physics simulation of its wave, then each tier taken apart and put back together.

System walkthrough, tier B. The wave, the costume coming off, the battery packs and electronics, the shoulder springs, the arm and glove hand, and the head. 37 seconds.

Isaac Sim, tier B wave. The physics simulation: real masses, a 0.25 kg bag in the hand, motors with their real torque and speed limits, shoulder springs on. Every joint keeps up and no belt passes its rating.

Tier A exploded view

Tier B exploded view

Tier C exploded view

Before we build

## What still needs a decision or a test

### Decisions for Mark

1. Which tier to build. Recommended: B, with C's hands as a later upgrade.
2. Sign the design brief (it sets what "done" means: runtime per pack, tip test, gesture list).
3. What Jack should hold: we assumed a 0.25 kg candy bag.
4. Gestures: keep arms raised forward rather than straight out sideways (the simulation's one limit), or add a second spring at the shoulder-out joint.
5. Indoor only, or outdoors too? Rain changes the electronics enclosure.
6. Is the overall height (about 1.7 m with the hat) right?

### Bench tests before the first event

1. Set each shoulder and elbow servo's torque limit (the simulation's belt limit) before the first power-up.
2. Weigh the head (assumed 2 kg in the tip check).
3. Measure average power with the arms moving, which sets the real runtime.
4. Check the stop relay switches on reliably from a part-drained pack (tiers B and C).
5. Set the low-battery cut-off from the cell datasheet (about 15–16 V).
6. Tip test with sandbags, and a pinch check at every joint.

### Things we found in the existing head

Its code sets two pins by physical number while using the chip's own pin numbering, so the "power" pins for the neck limit switch may not exist. One file imports a misspelled library name, and voice lines use paths from the old computer. None of this affects the body design, but they are worth fixing when the software is next opened.

### How sure are these numbers?

Prices were looked up on 24 Oct 2026, mostly from store listings, and will move; quantities come straight from the 3D model, packs bought whole. A few items (some wire gauges, an M5 tap) are not priced yet. The simulation uses the model's weights and the makers' motor ratings; the hobby servos publish no continuous rating, so we assumed a third of their maximum. The belt rating is the belt maker's figure. The head's 2 kg is an assumption until weighed. Nothing has been ordered.

Built in the Protoboard stack: the head, body, arms and power systems of all three tiers are modelled and checked in projects/internal/2026-10-24-joyful-jack/protoboard (choose a tier with JJ_TIER=a|b|c). Mechanical model, every part and fastener: protoboard/cad/mech. Build guides: protoboard release 0.2.0-a/b/c. Simulation: NVIDIA Isaac Sim 6.2, protoboard/cad/mech/sim, results in protoboard/docs/sim-results.md. Wiring cut lists: protoboard/docs/wiring. Renders: Blender. Prices: research/sourcing/20261025-bom-v2.md. Decisions: protoboard/docs/decisions.md.
