MarkDannemiller/JackOLantern/research/links.md

# Links

<!--
PHASE 1. The ledger. One row per link, newest first.

A link whose takeaway you cannot write in one line was not actually read.
Every row is dated: a vendor capability, a price or a stock level is only
true on the day it was captured.

Tags, short and lowercase: part, reference-design, manufacturing, standard,
competitor, teardown, tooling, paper.

Search order for this repo: Firecrawl, then Exa, then native search. Report
every drop - which tool failed, on what, and what you used instead.
-->

| URL | Title | Captured | Takeaway | Tag |
|---|---|---|---|---|
|  |  |  |  |  |

## Search drops

<!-- Every time a search tool failed and you fell back. Date, tool, what it
failed on, what you used instead. -->

-
