MarkDannemiller/JackOLantern/research/sourcing/20261025-bom-v2.md

# BOM v2 per tier (generated by build_bom_v2.py; do not edit)

Quantities come from the built model; prices are point-in-time (2026-10-24). Rules at the end.

## Tier A: $894.06 (old cap $500)

By group: arm $298.55, base $80.83, control $14.95, costume $32.65, fasteners $95.43, power $185.21, print $69.56, tools $0.00, torso $116.88, wiring $0.00

Unpriced (TBD): #8 x 3/4 in wood screw; M5 tap and handle; 14 AWG silicone wire, 1.3 m (red and black counted); 16 AWG silicone wire, 1.9 m (red and black counted); 18 AWG silicone wire, 2.8 m (red and black counted); 20 AWG silicone wire, 0.3 m (red and black counted); 26 AWG silicone wire, 0.5 m (red and black counted)

| Group | Item | Choice | Need | Qty | Unit $ | Line $ | Vendor | Confidence |
|---|---|---|---:|---:|---:|---:|---|---|
| base | 5 US gallon plastic bucket (ballast base) | The Home Depot 5 Gallon Orange Homer Bucket, model 05GLHD2 (Internet # | 1 | 1 | 4.98 | 4.98 | The Home Depot | from listing/secondary source |
| base | Concrete mix to fill bucket (~18.9 L = 0.667 cu ft) | Quikrete Concrete Mix No. 1101, 80 lb bag (Home Depot model 110180) | 1 | 1 | 5.68 | 5.68 | Lowe's (price via ShopSavvy aggregator) | from listing/secondary source |
| base | 1 in floor flange for center post | Southland 1 in. Black Malleable Iron Threaded Floor Flange 521-605HN | 2 | 2 | 6.97 | 13.94 | The Home Depot | from listing/secondary source |
| base | ALTERNATE for the 24 in round pine board: 3/4 in birch plywood 2x2 ft project panel, cut to a 24 in circle in-house | Falken Design 3/4 in x 2 ft x 2 ft Birch Plywood Project Panel, FALKEN | 1 | 1 | 29.49 | 29.49 | The Home Depot | from listing/secondary source |
| power | Milwaukee M18 battery adapter with switch, fuse and 12 AWG leads | Generic 'Power Wheel Adapter for Milwaukee M18' with on/off switch, 30 | 1 | 1 | 34.99 | 34.99 | Newegg (third-party seller); Amazon alternative https://www.amazon.com/dp/B0BVG1HTM2 | from listing/secondary source |
| power | Adjustable low-voltage cutoff for 5S Li-ion (~18 V) pack | XH-M609 digital low voltage disconnect module, 12-36 V, relay output ( | 1 | 1 | 9.99 | 9.99 | Amazon (MTDELE), price via tracker | from listing/secondary source |
| power | Latching mushroom emergency stop, 22 mm, NC | 22mm NC red mushroom emergency stop push button, 40 mm head, latching  | 1 | 1 | 12.17 | 12.17 | FridayParts | verified on vendor page |
| power | ATC blade fuse assortment | Bussmann ATC fuse assortment, variety pack (10/15/20/25/30 A) | 1 | 1 | 8.32 | 8.32 | Walmart | from listing/secondary source |
| power | 12 AWG silicone wire, red + black | BNTECHGO 12 AWG silicone wire, 10 ft red + 10 ft black (Amazon ASIN B0 | 1 | 1 | 27.52 | 27.52 | Newegg (category listing); Amazon https://www.amazon.com/dp/B01ABOPMEI | from listing/secondary source |
| costume | Cowboy / western vest | TiaoBug Men's 3-piece faux suede western cowboy vest set (vest + banda | 1 | 1 | 32.65 | 32.65 | Walmart (marketplace seller TiaoBug) | from listing/secondary source |
| power | Servo extension leads, 300 mm, 10-pack | Generic 300 mm male-female servo extension, 26 AWG, JR/Futaba (10 pcs) | 2 | 2 | 9.95 | 19.90 | eBay (US seller) | from listing/secondary source |
| power | Inline ATC fuse holder, 12 AWG | Eaton Bussmann BK/HHD ATC in-line fuse holder, 12 Ga. leads (24 A) | 4 | 4 | 2.18 | 8.72 | Waytek | from listing/secondary source |
| power | XT60 connector pairs | Amass XT60 connectors, 2 pairs, yellow (BuddyRC SKU 002-0201) | 2 | 2 | 3.49 | 6.98 | BuddyRC | verified on vendor page |
| arm | Shoulder servos (flex x2 + out x2), 35 kg·cm class | DIYmall 2 Sets 35kg DS3235 Digital Servo, coreless, full metal gear, 2 | 2 | 2 | 48.00 | 96.00 | Amazon (DIYmall) | from listing/secondary source |
| arm | Elbow servos, 25 kg class, 270° | DSSERVO DS3225 MG, 270° angle option, with metal arm/horn accessory op | 2 | 2 | 20.00 | 40.00 | AIFitLab (DSSERVO reseller) | from listing/secondary source |
| arm | Hand grip servos (tier A), MG996R 4-pack | Hosyond MG996R 55 g metal-gear digital servo, 4-pack | 1 | 1 | 16.99 | 16.99 | Amazon | from listing/secondary source |
| control | Second PCA9685 16-channel servo driver | Adafruit 16-Channel 12-bit PWM/Servo Driver, I2C (PCA9685), Product ID | 1 | 1 | 14.95 | 14.95 | Adafruit | verified on vendor page |
| power | Bucks (tier A): one 6.8 V rail for both arms, one 5-6 V rail for the head servos, one 5.1 V for the Pi | DROK 300W Power Supply Module, DC 3.5-30V to 0.8-29V 10A adjustable bu | 3 | 3 | 10.20 | 30.60 | DROK (droking.com) | verified on vendor page |
| torso | 1/4 in plywood, 2 x 4 ft project panel (torso ribs, tier A) | B/C Sanded Plywood Project Panel 1/4 in x 2 ft x 4 ft (Home Depot Inte | 1 | 1 | 11.22 | 11.22 | Home Depot | from listing/secondary source |
| arm | 6806-2RS joint bearings | 6806-2RS bearing 30x42x7, 10-pack (DEEG) | 12 | 2 | 13.59 | 27.18 | Amazon (DEEG) | listing |
| arm | 625-2RS driver outboard bearings | 625-2RS bearing 5x16x5, 10-pack (C3) | 6 | 1 | 7.99 | 7.99 | Amazon | listing |
| arm | 624-2RS balancer sheave bearings | 624-2RS bearing 4x13x5, 16-pack (uxcell) | 4 | 1 | 8.49 | 8.49 | Amazon (uxcell) | listing |
| arm | GT3 9 mm belts, 240 mm (shoulder joints) | 3GT (GT2-3M) closed belt 240 mm / 80T, 9 mm, 5 pcs | 4 | 1 | 20.67 | 20.67 | Amazon | listing |
| arm | GT3 9 mm belts, 210 mm (elbow) | 3GT (GT2-3M) closed belt 210 mm / 70T, 9 mm, 5 pcs | 2 | 1 | 20.67 | 20.67 | Amazon | listing |
| arm | 5 x 16 mm driver dowels | Dowel pin 5x16 mm, 304 stainless, 15 pcs (HARFINGTON) - not hardened | 6 | 1 | 6.29 | 6.29 | Amazon (HARFINGTON) | listing |
| arm | Century 90CS balancer springs | Extension spring 0.625 OD, 27 lbf | 4 | 4 | 9.37 | 37.48 | Century Spring | listing |
| arm | 2 mm Dyneema balancer cord | 2 mm Dyneema cord, 20 m, 200 kg | 1 | 1 | 9.00 | 9.00 | Amazon | listing |
| arm | Shoulder screws 5 x 8, M4 | Shoulder screw 5 mm x 8 mm shoulder, M4, 16 pcs (MECCANIXITY) | 4 | 1 | 7.79 | 7.79 | Amazon (MECCANIXITY) | listing |
| fasteners | Heat-set inserts M3 | Heat-set insert M3 x 5.7, 100 pcs (Prusa, CNC Kitchen design) - rechec | 96 | 2 | 10.99 | 21.98 | Prusa Research | listing |
| fasteners | Heat-set inserts M4 | Heat-set insert M4 x 8.1, 50 pcs (CNC Kitchen via 3DJake) - recheck | 48 | 2 | 11.18 | 22.36 | 3DJake (CNC Kitchen reseller, US site) | listing |
| fasteners | Socket head cap screws M3 (8 mm x8, 12 mm x56) | SHCS M3 kit 6/8/10/12/16/20/25/30 mm, black oxide 12.9, 600 pcs | 56 | 1 | 7.99 | 7.99 | Amazon | listing |
| fasteners | Socket head cap screws M3 x 14 | SHCS M3 x 14, black oxide 12.9, 120 pcs | 64 | 1 | 5.49 | 5.49 | Amazon | listing |
| fasteners | Socket head cap screws M4 (10 mm x32, 12 mm x4, 16 mm x8, 25 mm x2) | SHCS M4 kit 6/8/10/12/16/20/25 mm, black oxide 12.9, 520 pcs | 32 | 1 | 8.99 | 8.99 | Amazon | listing |
| fasteners | Socket head cap screws M5 (10 mm x4, 12 mm x6, 16 mm x4, 20 mm x8) | SHCS M5 kit 8/10/12/16/20/25/30 mm, black oxide 12.9, 290 pcs | 8 | 1 | 8.99 | 8.99 | Amazon | listing |
| fasteners | iso10511-m4 | M4 nylon-insert lock nut, 304 SS, 80 pcs | 2 | 1 | 4.86 | 4.86 | Amazon | listing |
| fasteners | iso10511-m5 | M5 nylon-insert lock nut, 304 SS, 50 pcs | 4 | 1 | 4.79 | 4.79 | Amazon | listing |
| fasteners | iso7089-m4 | M4 flat washer 9 mm OD, 304 SS, 100 pcs | 12 | 1 | 4.99 | 4.99 | Amazon | listing |
| fasteners | iso7089-m5 | M5 flat washer 10 mm OD, 304 SS, 100 pcs | 4 | 1 | 4.99 | 4.99 | Amazon | listing |
| base | hex-bolt-1-4-20x1.25in (kit includes the nylock nuts and washers) | 1/4-20 x 1-1/4 in hex bolt kit with nylock nuts and washers, 18 sets | 8 | 1 | 8.99 | 8.99 | Amazon | listing |
| torso | #8 x 1-1/4 in wood screws (ply torso) | #8 x 1-1/4 in flat head wood screw, 100 pcs (Hillman 35054) | 16 | 1 | 6.98 | 6.98 | Amazon (Hillman) | listing |
| torso | #8 x 3/4 in wood screw | TBD | 1 | 1 |  | TBD | TBD | TBD |
| torso | #4 x 1/2 in wood screws (trays, board) | #4 x 1/2 in flat head wood screw, zinc, 100 pcs | 16 | 1 | 7.35 | 7.35 | Amazon | listing |
| torso | M5 hammer-in tee nuts | M5 hammer-in tee nut, 4-prong, zinc, 60 pcs (Hitefu) | 8 | 1 | 5.49 | 5.49 | Amazon (Hitefu) | listing |
| torso | M5 drop-in T-nuts for 2020 | Drop-in tee nut M5, 10-pack (Maker Store) | 4 | 1 | 11.93 | 11.93 | Maker Store USA | listing |
| torso | Cast 90 deg corner brackets, 20 series | Cast 90 deg corner bracket 20 series (Maker Store) | 4 | 4 | 1.80 | 7.20 | Maker Store USA | listing |
| torso | 2020 extrusion, cut list 102 mm x2, 190 mm x2 | Maker Store USA V-Slot 20x20mm, clear anodized, SKU LR-2020-S, 500 mm  | 584 | 2 | 6.75 | 13.50 | Maker Store USA | estimate |
| tools | M5 tap and handle | TBD | 1 | 1 |  | TBD | TBD | TBD |
| base | 1 in x 30 in black nipple (mast) | 1 in x 30 in Sch 40 black steel nipple, threaded both ends | 1 | 1 | 17.75 | 17.75 | Global Industrial (MSI) | listing |
| torso | 6 mm 6061 plate for the neck plate (150 x 150) | 6061 aluminium plate 6 mm, 6 x 6 in (152 x 152 mm), 1 pc | 1 | 1 | 12.99 | 12.99 | Amazon | listing |
| torso | 1/2 in birch plywood for the tier A torso box | 1/2 in birch plywood project panel 2 x 4 ft, A2 (Home Depot) | 1 | 1 | 40.22 | 40.22 | Home Depot (Falken Design) | snippet, unconfirmed |
| print | PETG-CF filament (2123 g printed) | PETG-CF 1 kg (Elegoo), black | 2.44 | 3 | 18.99 | 56.97 | Amazon (ELEGOO) | listing |
| print | PETG filament (555 g printed) | PETG 1 kg (Elegoo Rapid PETG), black | 0.64 | 1 | 12.59 | 12.59 | Amazon (ELEGOO) | listing |
| power | E-stop enclosure | E-stop enclosure, 1-hole yellow (Schneider XALK01H7) - recheck | 1 | 1 | 26.02 | 26.02 | Mouser | listing |
| wiring | 14 AWG silicone wire, 1.3 m (red and black counted) | TBD | 1 | 1 |  | TBD | TBD | TBD |
| wiring | 16 AWG silicone wire, 1.9 m (red and black counted) | TBD | 1 | 1 |  | TBD | TBD | TBD |
| wiring | 18 AWG silicone wire, 2.8 m (red and black counted) | TBD | 1 | 1 |  | TBD | TBD | TBD |
| wiring | 20 AWG silicone wire, 0.3 m (red and black counted) | TBD | 1 | 1 |  | TBD | TBD | TBD |
| wiring | 26 AWG silicone wire, 0.5 m (red and black counted) | TBD | 1 | 1 |  | TBD | TBD | TBD |

## Tier B: $1,381.40 (old cap $1200)

By group: arm $453.56, base $89.82, control $24.93, costume $44.63, fasteners $110.31, hand $17.99, power $353.25, print $69.56, tools $0.00, torso $205.38, wiring $11.97

Unpriced (TBD): M5 tap and handle; 14 AWG silicone wire, 2.9 m (red and black counted); 16 AWG silicone wire, 1.0 m (red and black counted); 20 AWG silicone wire, 0.9 m (red and black counted); 26 AWG silicone wire, 0.4 m (red and black counted)

| Group | Item | Choice | Need | Qty | Unit $ | Line $ | Vendor | Confidence |
|---|---|---|---:|---:|---:|---:|---|---|
| base | 5 US gallon plastic bucket (ballast base) | The Home Depot 5 Gallon Orange Homer Bucket, model 05GLHD2 (Internet # | 1 | 1 | 4.98 | 4.98 | The Home Depot | from listing/secondary source |
| base | Concrete mix to fill bucket (~18.9 L = 0.667 cu ft) | Quikrete Concrete Mix No. 1101, 80 lb bag (Home Depot model 110180) | 1 | 1 | 5.68 | 5.68 | Lowe's (price via ShopSavvy aggregator) | from listing/secondary source |
| base | 1 in floor flange for center post | Southland 1 in. Black Malleable Iron Threaded Floor Flange 521-605HN | 2 | 2 | 6.97 | 13.94 | The Home Depot | from listing/secondary source |
| base | ALTERNATE for the 24 in round pine board: 3/4 in birch plywood 2x2 ft project panel, cut to a 24 in circle in-house | Falken Design 3/4 in x 2 ft x 2 ft Birch Plywood Project Panel, FALKEN | 1 | 1 | 29.49 | 29.49 | The Home Depot | from listing/secondary source |
| power | Milwaukee M18 battery adapter with switch, fuse and 12 AWG leads | Generic 'Power Wheel Adapter for Milwaukee M18' with on/off switch, 30 | 1 | 1 | 34.99 | 34.99 | Newegg (third-party seller); Amazon alternative https://www.amazon.com/dp/B0BVG1HTM2 | from listing/secondary source |
| power | Adjustable low-voltage cutoff for 5S Li-ion (~18 V) pack | XH-M609 digital low voltage disconnect module, 12-36 V, relay output ( | 1 | 1 | 9.99 | 9.99 | Amazon (MTDELE), price via tracker | from listing/secondary source |
| power | Latching mushroom emergency stop, 22 mm, NC | 22mm NC red mushroom emergency stop push button, 40 mm head, latching  | 1 | 1 | 12.17 | 12.17 | FridayParts | verified on vendor page |
| power | ATC blade fuse assortment | Bussmann ATC fuse assortment, variety pack (10/15/20/25/30 A) | 1 | 1 | 8.32 | 8.32 | Walmart | from listing/secondary source |
| power | 12 AWG silicone wire, red + black | BNTECHGO 12 AWG silicone wire, 10 ft red + 10 ft black (Amazon ASIN B0 | 1 | 1 | 27.52 | 27.52 | Newegg (category listing); Amazon https://www.amazon.com/dp/B01ABOPMEI | from listing/secondary source |
| costume | Cowboy / western vest | TiaoBug Men's 3-piece faux suede western cowboy vest set (vest + banda | 1 | 1 | 32.65 | 32.65 | Walmart (marketplace seller TiaoBug) | from listing/secondary source |
| costume | Men's plaid flannel shirt | George Men's and Big Men's Flannel Shirt with Long Sleeves (Walmart it | 1 | 1 | 11.98 | 11.98 | Walmart | from listing/secondary source |
| power | Blade fuse block, 6-way ATC/ATO, with negative bus | Sea-Dog blade style LED indicator fuse block with negative bus bar, 6  | 1 | 1 | 30.99 | 30.99 | DRSA | from listing/secondary source |
| power | 18 AWG silicone wire, red + black | BNTECHGO 18 AWG silicone wire spool, 25 ft red + 25 ft black (150 stra | 1 | 1 | 45.99 | 45.99 | Bigamart (reseller) | from listing/secondary source |
| power | XT60 connector pairs | Amass XT60 connectors, 2 pairs, yellow (BuddyRC SKU 002-0201) | 3 | 3 | 3.49 | 10.47 | BuddyRC | verified on vendor page |
| power | ALTERNATE for the Pi 5 V buck: Pololu D24V50F5 5 V 5 A step-down | Pololu D24V50F5, item #2851 | 1 | 1 | 29.95 | 29.95 | Pololu | from listing/secondary source |
| power | Buck for the head's servo rail (5-6 V) | DROK 300W Power Supply Module, DC 3.5-30V to 0.8-29V 10A adjustable bu | 1 | 1 | 10.20 | 10.20 | DROK (droking.com) | verified on vendor page |
| control | Current/voltage monitor, I2C (chosen) | Adafruit INA228 I2C 85V 20-bit high/low side power monitor, STEMMA QT  | 1 | 1 | 14.95 | 14.95 | Adafruit | verified on vendor page |
| power | Relay >=30 A for actuator rail, switched by e-stop | TEMCo 24V 40A 4-pin Bosch-style automotive relay, SPST (SKU CN0345) | 1 | 1 | 8.73 | 8.73 | TEMCo Industrial | verified on vendor page |
| arm | Serial bus servo 12 V 30 kg.cm (wrist/forearm/hand joints) | Feetech ST3215-C047 12V 30 kg.cm, 1:345 (Seeed SKU 108090003); equival | 14 | 14 | 22.00 | 308.00 | Seeed Studio | verified on vendor page |
| control | Bus servo driver / USB-TTL adapter | Waveshare Bus Servo Adapter (A), SKU 25514 | 2 | 2 | 4.99 | 9.98 | Waveshare | verified on vendor page |
| power | 18 V -> 12 V DC-DC buck, 20 A | EKYLIN 24V to 12V 20A 240W step-down converter, DC 15-40V input (Amazo | 2 | 2 | 17.47 | 34.94 | Amazon (sold by LinkoTech) | from listing/secondary source |
| power | Ideal-diode OR of two battery inputs | GODIYMODULES / DIY-Module 40A-60A ideal diode module, single channel ( | 2 | 2 | 13.99 | 27.98 | Amazon (sold by DIY-Module) | from listing/secondary source |
| power | Milwaukee M18 battery adapter with switch, fuse and 12 AWG leads | Generic 'Power Wheel Adapter for Milwaukee M18' with on/off switch, 30 | 1 | 1 | 34.99 | 34.99 | Newegg (third-party seller); Amazon alternative https://www.amazon.com/dp/B0BVG1HTM2 | from listing/secondary source |
| hand | TPU 95A filament 1 kg | ELEGOO TPU 95A 1.75 mm 1 kg | 1 | 1 | 17.99 | 17.99 | ELEGOO (US store) | from listing/secondary source |
| arm | 6806-2RS joint bearings | 6806-2RS bearing 30x42x7, 10-pack (DEEG) | 20 | 2 | 13.59 | 27.18 | Amazon (DEEG) | listing |
| arm | 625-2RS driver outboard bearings | 625-2RS bearing 5x16x5, 10-pack (C3) | 6 | 1 | 7.99 | 7.99 | Amazon | listing |
| arm | 624-2RS balancer sheave bearings | 624-2RS bearing 4x13x5, 16-pack (uxcell) | 4 | 1 | 8.49 | 8.49 | Amazon (uxcell) | listing |
| arm | GT3 9 mm belts, 240 mm (shoulder joints) | 3GT (GT2-3M) closed belt 240 mm / 80T, 9 mm, 5 pcs | 4 | 1 | 20.67 | 20.67 | Amazon | listing |
| arm | GT3 9 mm belts, 210 mm (elbow) | 3GT (GT2-3M) closed belt 210 mm / 70T, 9 mm, 5 pcs | 2 | 1 | 20.67 | 20.67 | Amazon | listing |
| arm | 5 x 16 mm driver dowels | Dowel pin 5x16 mm, 304 stainless, 15 pcs (HARFINGTON) - not hardened | 6 | 1 | 6.29 | 6.29 | Amazon (HARFINGTON) | listing |
| arm | Century 90CS balancer springs | Extension spring 0.625 OD, 27 lbf | 4 | 4 | 9.37 | 37.48 | Century Spring | listing |
| arm | 2 mm Dyneema balancer cord | 2 mm Dyneema cord, 20 m, 200 kg | 1 | 1 | 9.00 | 9.00 | Amazon | listing |
| arm | Shoulder screws 5 x 8, M4 | Shoulder screw 5 mm x 8 mm shoulder, M4, 16 pcs (MECCANIXITY) | 2 | 1 | 7.79 | 7.79 | Amazon (MECCANIXITY) | listing |
| fasteners | Heat-set inserts M3 | Heat-set insert M3 x 5.7, 100 pcs (Prusa, CNC Kitchen design) - rechec | 108 | 2 | 10.99 | 21.98 | Prusa Research | listing |
| fasteners | Heat-set inserts M4 | Heat-set insert M4 x 8.1, 50 pcs (CNC Kitchen via 3DJake) - recheck | 14 | 1 | 11.18 | 11.18 | 3DJake (CNC Kitchen reseller, US site) | listing |
| fasteners | Socket head cap screws M3 (6 mm x16, 8 mm x32, 12 mm x64, 30 mm x12) | SHCS M3 kit 6/8/10/12/16/20/25/30 mm, black oxide 12.9, 600 pcs | 64 | 1 | 7.99 | 7.99 | Amazon | listing |
| fasteners | Socket head cap screws M3 x 14 | SHCS M3 x 14, black oxide 12.9, 120 pcs | 56 | 1 | 5.49 | 5.49 | Amazon | listing |
| fasteners | Socket head cap screws M4 (12 mm x4, 16 mm x8, 20 mm x4) | SHCS M4 kit 6/8/10/12/16/20/25 mm, black oxide 12.9, 520 pcs | 8 | 1 | 8.99 | 8.99 | Amazon | listing |
| fasteners | Socket head cap screws M5 (10 mm x41, 12 mm x18, 20 mm x4) | SHCS M5 kit 8/10/12/16/20/25/30 mm, black oxide 12.9, 290 pcs | 41 | 2 | 8.99 | 17.98 | Amazon | listing |
| fasteners | Servo case screws PA2X6 | M2 x 6 self-tapping pan head, 50 pcs (METALLIXITY) | 32 | 1 | 5.69 | 5.69 | Amazon (METALLIXITY) | listing |
| fasteners | Servo case screws PA2X8 | M2 x 8 self-tapping pan head, 50 pcs (METALLIXITY) | 80 | 2 | 5.69 | 11.38 | Amazon (METALLIXITY) | listing |
| fasteners | iso10511-m4 | M4 nylon-insert lock nut, 304 SS, 80 pcs | 4 | 1 | 4.86 | 4.86 | Amazon | listing |
| fasteners | iso10511-m5 | M5 nylon-insert lock nut, 304 SS, 50 pcs | 4 | 1 | 4.79 | 4.79 | Amazon | listing |
| fasteners | iso7089-m4 | M4 flat washer 9 mm OD, 304 SS, 100 pcs | 16 | 1 | 4.99 | 4.99 | Amazon | listing |
| fasteners | iso7089-m5 | M5 flat washer 10 mm OD, 304 SS, 100 pcs | 4 | 1 | 4.99 | 4.99 | Amazon | listing |
| base | hex-bolt-1-4-20x1in (kit includes the nylock nuts and washers) | 1/4-20 x 1 in hex bolt kit with nylock nuts and washers, 18 sets | 4 | 1 | 8.99 | 8.99 | Amazon | listing |
| base | hex-bolt-1-4-20x1.25in (kit includes the nylock nuts and washers) | 1/4-20 x 1-1/4 in hex bolt kit with nylock nuts and washers, 18 sets | 4 | 1 | 8.99 | 8.99 | Amazon | listing |
| torso | #4 x 1/2 in wood screws (trays, board) | #4 x 1/2 in flat head wood screw, zinc, 100 pcs | 24 | 1 | 7.35 | 7.35 | Amazon | listing |
| torso | M5 drop-in T-nuts for 2020 | Drop-in tee nut M5, 10-pack (Maker Store) | 49 | 6 | 11.93 | 71.58 | Maker Store USA | listing |
| torso | Cast 90 deg corner brackets, 20 series | Cast 90 deg corner bracket 20 series (Maker Store) | 20 | 20 | 1.80 | 36.00 | Maker Store USA | listing |
| torso | 2020 extrusion, cut list 100 mm x4, 102 mm x2, 180 mm x4, 190 mm x2, 340 mm x4 | Maker Store USA V-Slot 20x20mm, clear anodized, SKU LR-2020-S, 500 mm  | 3064 | 7 | 6.75 | 47.25 | Maker Store USA | estimate |
| tools | M5 tap and handle | TBD | 1 | 1 |  | TBD | TBD | TBD |
| base | 1 in x 30 in black nipple (mast) | 1 in x 30 in Sch 40 black steel nipple, threaded both ends | 1 | 1 | 17.75 | 17.75 | Global Industrial (MSI) | listing |
| torso | 6 mm 6061 plate for the neck plate (150 x 150) | 6061 aluminium plate 6 mm, 6 x 6 in (152 x 152 mm), 1 pc | 1 | 1 | 12.99 | 12.99 | Amazon | listing |
| torso | Plate for the torso base plate (220 x 140) | 6061 aluminium plate 1/4 in, 6 x 12 in (152 x 305 mm) | 1 | 1 | 18.99 | 18.99 | Amazon | listing |
| torso | 1/4 in plywood panel for the electronics board | B/C Sanded Plywood Project Panel 1/4 in x 2 ft x 4 ft (Home Depot Inte | 1 | 1 | 11.22 | 11.22 | Home Depot | from listing/secondary source |
| print | PETG-CF filament (2071 g printed) | PETG-CF 1 kg (Elegoo), black | 2.38 | 3 | 18.99 | 56.97 | Amazon (ELEGOO) | listing |
| print | PETG filament (582 g printed) | PETG 1 kg (Elegoo Rapid PETG), black | 0.67 | 1 | 12.59 | 12.59 | Amazon (ELEGOO) | listing |
| wiring | Feetech 5264 3-pin bus cables (14 in the chains) | Feetech 5264 3P servo cable 900 mm, 6 pcs (Waveshare) - recheck | 14 | 3 | 3.99 | 11.97 | Waveshare | listing |
| power | E-stop enclosure | E-stop enclosure, 1-hole yellow (Schneider XALK01H7) - recheck | 1 | 1 | 26.02 | 26.02 | Mouser | listing |
| wiring | 14 AWG silicone wire, 2.9 m (red and black counted) | TBD | 1 | 1 |  | TBD | TBD | TBD |
| wiring | 16 AWG silicone wire, 1.0 m (red and black counted) | TBD | 1 | 1 |  | TBD | TBD | TBD |
| wiring | 20 AWG silicone wire, 0.9 m (red and black counted) | TBD | 1 | 1 |  | TBD | TBD | TBD |
| wiring | 26 AWG silicone wire, 0.4 m (red and black counted) | TBD | 1 | 1 |  | TBD | TBD | TBD |

## Tier C: $2,370.13

By group: arm $859.56, base $89.82, control $210.88, costume $44.63, fasteners $118.30, hand $215.99, power $548.03, print $69.56, tools $0.00, torso $205.38, wiring $7.98

Unpriced (TBD): M5 tap and handle; 14 AWG silicone wire, 3.0 m (red and black counted); 16 AWG silicone wire, 1.0 m (red and black counted); 20 AWG silicone wire, 0.9 m (red and black counted); 26 AWG silicone wire, 0.4 m (red and black counted)

| Group | Item | Choice | Need | Qty | Unit $ | Line $ | Vendor | Confidence |
|---|---|---|---:|---:|---:|---:|---|---|
| base | 5 US gallon plastic bucket (ballast base) | The Home Depot 5 Gallon Orange Homer Bucket, model 05GLHD2 (Internet # | 1 | 1 | 4.98 | 4.98 | The Home Depot | from listing/secondary source |
| base | Concrete mix to fill bucket (~18.9 L = 0.667 cu ft) | Quikrete Concrete Mix No. 1101, 80 lb bag (Home Depot model 110180) | 1 | 1 | 5.68 | 5.68 | Lowe's (price via ShopSavvy aggregator) | from listing/secondary source |
| base | 1 in floor flange for center post | Southland 1 in. Black Malleable Iron Threaded Floor Flange 521-605HN | 2 | 2 | 6.97 | 13.94 | The Home Depot | from listing/secondary source |
| base | ALTERNATE for the 24 in round pine board: 3/4 in birch plywood 2x2 ft project panel, cut to a 24 in circle in-house | Falken Design 3/4 in x 2 ft x 2 ft Birch Plywood Project Panel, FALKEN | 1 | 1 | 29.49 | 29.49 | The Home Depot | from listing/secondary source |
| power | Milwaukee M18 battery adapter with switch, fuse and 12 AWG leads | Generic 'Power Wheel Adapter for Milwaukee M18' with on/off switch, 30 | 1 | 1 | 34.99 | 34.99 | Newegg (third-party seller); Amazon alternative https://www.amazon.com/dp/B0BVG1HTM2 | from listing/secondary source |
| power | Adjustable low-voltage cutoff for 5S Li-ion (~18 V) pack | XH-M609 digital low voltage disconnect module, 12-36 V, relay output ( | 1 | 1 | 9.99 | 9.99 | Amazon (MTDELE), price via tracker | from listing/secondary source |
| power | Latching mushroom emergency stop, 22 mm, NC | 22mm NC red mushroom emergency stop push button, 40 mm head, latching  | 1 | 1 | 12.17 | 12.17 | FridayParts | verified on vendor page |
| power | ATC blade fuse assortment | Bussmann ATC fuse assortment, variety pack (10/15/20/25/30 A) | 1 | 1 | 8.32 | 8.32 | Walmart | from listing/secondary source |
| power | 12 AWG silicone wire, red + black | BNTECHGO 12 AWG silicone wire, 10 ft red + 10 ft black (Amazon ASIN B0 | 1 | 1 | 27.52 | 27.52 | Newegg (category listing); Amazon https://www.amazon.com/dp/B01ABOPMEI | from listing/secondary source |
| costume | Cowboy / western vest | TiaoBug Men's 3-piece faux suede western cowboy vest set (vest + banda | 1 | 1 | 32.65 | 32.65 | Walmart (marketplace seller TiaoBug) | from listing/secondary source |
| costume | Men's plaid flannel shirt | George Men's and Big Men's Flannel Shirt with Long Sleeves (Walmart it | 1 | 1 | 11.98 | 11.98 | Walmart | from listing/secondary source |
| power | Blade fuse block, 6-way ATC/ATO, with negative bus | Sea-Dog blade style LED indicator fuse block with negative bus bar, 6  | 1 | 1 | 30.99 | 30.99 | DRSA | from listing/secondary source |
| power | 18 AWG silicone wire, red + black | BNTECHGO 18 AWG silicone wire spool, 25 ft red + 25 ft black (150 stra | 1 | 1 | 45.99 | 45.99 | Bigamart (reseller) | from listing/secondary source |
| power | XT60 connector pairs | Amass XT60 connectors, 2 pairs, yellow (BuddyRC SKU 002-0201) | 3 | 3 | 3.49 | 10.47 | BuddyRC | verified on vendor page |
| power | ALTERNATE for the Pi 5 V buck: Pololu D24V50F5 5 V 5 A step-down | Pololu D24V50F5, item #2851 | 1 | 1 | 29.95 | 29.95 | Pololu | from listing/secondary source |
| power | Buck for the torso Raspberry Pi 5, set to 5.1 V (tier C) | DROK 300W Power Supply Module, DC 3.5-30V to 0.8-29V 10A adjustable bu | 1 | 1 | 10.20 | 10.20 | DROK (droking.com) | verified on vendor page |
| power | Buck for the head's servo rail (5-6 V) | DROK 300W Power Supply Module, DC 3.5-30V to 0.8-29V 10A adjustable bu | 1 | 1 | 10.20 | 10.20 | DROK (droking.com) | verified on vendor page |
| control | Current/voltage monitor, I2C (chosen) | Adafruit INA228 I2C 85V 20-bit high/low side power monitor, STEMMA QT  | 1 | 1 | 14.95 | 14.95 | Adafruit | verified on vendor page |
| power | Relay >=30 A for actuator rail, switched by e-stop | TEMCo 24V 40A 4-pin Bosch-style automotive relay, SPST (SKU CN0345) | 1 | 1 | 8.73 | 8.73 | TEMCo Industrial | verified on vendor page |
| arm | High-torque serial bus servo (shoulder/elbow joints) | Feetech STS3250 (ST-3250-C001, 12 V 50 kg.cm, magnetic encoder, double | 6 | 6 | 97.00 | 582.00 | AIFit Lab (Feetech reseller) | from listing/secondary source |
| arm | Serial bus servo 12 V 30 kg.cm (wrist/forearm/hand joints) | Feetech ST3215-C047 12V 30 kg.cm, 1:345 (Seeed SKU 108090003); equival | 6 | 6 | 22.00 | 132.00 | Seeed Studio | verified on vendor page |
| hand | AmazingHand kit, right hand | Seeed Studio Amazing Hand (Right Hand) developer kit, SKU 100063642 | 1 | 1 | 99.00 | 99.00 | Seeed Studio | verified on vendor page |
| hand | AmazingHand kit, left hand | Seeed Studio Amazing Hand (Left Hand) kit, SKU 100062181 | 1 | 1 | 99.00 | 99.00 | Seeed Studio | verified on vendor page |
| power | 5 V hand servo rail buck (one per hand) | Pololu D36V50F5 5 V 5.5 A step-down, item 4091 | 2 | 2 | 39.95 | 79.90 | Pololu | verified on vendor page |
| control | Main computer | Raspberry Pi 5 8 GB | 1 | 1 | 175.00 | 175.00 | PiShop.us (approved reseller) | verified on vendor page |
| control | Pi cooling | Raspberry Pi Active Cooler (SC1148) | 1 | 1 | 10.95 | 10.95 | PiShop.us | verified on vendor page |
| control | Bus servo driver / USB-TTL adapter | Waveshare Bus Servo Adapter (A), SKU 25514 | 2 | 2 | 4.99 | 9.98 | Waveshare | verified on vendor page |
| power | 18 V -> 12 V DC-DC buck, 20 A | EKYLIN 24V to 12V 20A 240W step-down converter, DC 15-40V input (Amazo | 2 | 2 | 17.47 | 34.94 | Amazon (sold by LinkoTech) | from listing/secondary source |
| power | Ideal-diode OR of two battery inputs | GODIYMODULES / DIY-Module 40A-60A ideal diode module, single channel ( | 3 | 3 | 13.99 | 41.97 | Amazon (sold by DIY-Module) | from listing/secondary source |
| power | Milwaukee M18 battery adapter with switch, fuse and 12 AWG leads | Generic 'Power Wheel Adapter for Milwaukee M18' with on/off switch, 30 | 1 | 1 | 34.99 | 34.99 | Newegg (third-party seller); Amazon alternative https://www.amazon.com/dp/B0BVG1HTM2 | from listing/secondary source |
| power | 24 V mains supply (third OR input) | Mean Well LRS-350-24 | 1 | 1 | 31.40 | 31.40 | DigiKey | from listing/secondary source |
| hand | TPU 95A filament 1 kg | ELEGOO TPU 95A 1.75 mm 1 kg | 1 | 1 | 17.99 | 17.99 | ELEGOO (US store) | from listing/secondary source |
| power | Custom PDB: JLCPCB 2-layer 100x100 mm, 5 pcs, economic PCBA (lot) | JLCPCB | 1 | 1 | 38.00 | 38.00 | JLCPCB | estimate |
| power | Custom PDB: ideal-diode controller (one per OR input) | TI LM74700QDBVRQ1 | 3 | 3 | 1.89 | 5.67 | DigiKey | from listing/secondary source |
| power | Custom PDB: eFuse per output branch | TI TPS25982 (TPS259824ONRGET, 24-VQFN 4x4) | 2 | 2 | 3.82 | 7.64 | DigiKey | from listing/secondary source |
| power | Custom PDB: current/voltage monitor (one per input) | TI INA226AIDGSR | 3 | 3 | 2.66 | 7.98 | DigiKey | from listing/secondary source |
| arm | 6806-2RS joint bearings | 6806-2RS bearing 30x42x7, 10-pack (DEEG) | 20 | 2 | 13.59 | 27.18 | Amazon (DEEG) | listing |
| arm | 625-2RS driver outboard bearings | 625-2RS bearing 5x16x5, 10-pack (C3) | 6 | 1 | 7.99 | 7.99 | Amazon | listing |
| arm | 624-2RS balancer sheave bearings | 624-2RS bearing 4x13x5, 16-pack (uxcell) | 4 | 1 | 8.49 | 8.49 | Amazon (uxcell) | listing |
| arm | GT3 9 mm belts, 240 mm (shoulder joints) | 3GT (GT2-3M) closed belt 240 mm / 80T, 9 mm, 5 pcs | 4 | 1 | 20.67 | 20.67 | Amazon | listing |
| arm | GT3 9 mm belts, 210 mm (elbow) | 3GT (GT2-3M) closed belt 210 mm / 70T, 9 mm, 5 pcs | 2 | 1 | 20.67 | 20.67 | Amazon | listing |
| arm | 5 x 16 mm driver dowels | Dowel pin 5x16 mm, 304 stainless, 15 pcs (HARFINGTON) - not hardened | 6 | 1 | 6.29 | 6.29 | Amazon (HARFINGTON) | listing |
| arm | Century 90CS balancer springs | Extension spring 0.625 OD, 27 lbf | 4 | 4 | 9.37 | 37.48 | Century Spring | listing |
| arm | 2 mm Dyneema balancer cord | 2 mm Dyneema cord, 20 m, 200 kg | 1 | 1 | 9.00 | 9.00 | Amazon | listing |
| arm | Shoulder screws 5 x 8, M4 | Shoulder screw 5 mm x 8 mm shoulder, M4, 16 pcs (MECCANIXITY) | 2 | 1 | 7.79 | 7.79 | Amazon (MECCANIXITY) | listing |
| fasteners | Heat-set inserts M3 | Heat-set insert M3 x 5.7, 100 pcs (Prusa, CNC Kitchen design) - rechec | 116 | 2 | 10.99 | 21.98 | Prusa Research | listing |
| fasteners | Heat-set inserts M4 | Heat-set insert M4 x 8.1, 50 pcs (CNC Kitchen via 3DJake) - recheck | 14 | 1 | 11.18 | 11.18 | 3DJake (CNC Kitchen reseller, US site) | listing |
| fasteners | Socket head cap screws M3 (6 mm x16, 8 mm x16, 12 mm x72, 20 mm x8, 30 mm x12) | SHCS M3 kit 6/8/10/12/16/20/25/30 mm, black oxide 12.9, 600 pcs | 72 | 2 | 7.99 | 15.98 | Amazon | listing |
| fasteners | Socket head cap screws M3 x 14 | SHCS M3 x 14, black oxide 12.9, 120 pcs | 56 | 1 | 5.49 | 5.49 | Amazon | listing |
| fasteners | Socket head cap screws M4 (12 mm x4, 16 mm x8, 20 mm x4) | SHCS M4 kit 6/8/10/12/16/20/25 mm, black oxide 12.9, 520 pcs | 8 | 1 | 8.99 | 8.99 | Amazon | listing |
| fasteners | Socket head cap screws M5 (10 mm x41, 12 mm x18, 20 mm x4) | SHCS M5 kit 8/10/12/16/20/25/30 mm, black oxide 12.9, 290 pcs | 41 | 2 | 8.99 | 17.98 | Amazon | listing |
| fasteners | Servo case screws PA2X6 | M2 x 6 self-tapping pan head, 50 pcs (METALLIXITY) | 16 | 1 | 5.69 | 5.69 | Amazon (METALLIXITY) | listing |
| fasteners | Servo case screws PA2X8 | M2 x 8 self-tapping pan head, 50 pcs (METALLIXITY) | 80 | 2 | 5.69 | 11.38 | Amazon (METALLIXITY) | listing |
| fasteners | iso10511-m4 | M4 nylon-insert lock nut, 304 SS, 80 pcs | 4 | 1 | 4.86 | 4.86 | Amazon | listing |
| fasteners | iso10511-m5 | M5 nylon-insert lock nut, 304 SS, 50 pcs | 4 | 1 | 4.79 | 4.79 | Amazon | listing |
| fasteners | iso7089-m4 | M4 flat washer 9 mm OD, 304 SS, 100 pcs | 16 | 1 | 4.99 | 4.99 | Amazon | listing |
| fasteners | iso7089-m5 | M5 flat washer 10 mm OD, 304 SS, 100 pcs | 4 | 1 | 4.99 | 4.99 | Amazon | listing |
| base | hex-bolt-1-4-20x1in (kit includes the nylock nuts and washers) | 1/4-20 x 1 in hex bolt kit with nylock nuts and washers, 18 sets | 4 | 1 | 8.99 | 8.99 | Amazon | listing |
| base | hex-bolt-1-4-20x1.25in (kit includes the nylock nuts and washers) | 1/4-20 x 1-1/4 in hex bolt kit with nylock nuts and washers, 18 sets | 4 | 1 | 8.99 | 8.99 | Amazon | listing |
| torso | #4 x 1/2 in wood screws (trays, board) | #4 x 1/2 in flat head wood screw, zinc, 100 pcs | 34 | 1 | 7.35 | 7.35 | Amazon | listing |
| torso | M5 drop-in T-nuts for 2020 | Drop-in tee nut M5, 10-pack (Maker Store) | 49 | 6 | 11.93 | 71.58 | Maker Store USA | listing |
| torso | Cast 90 deg corner brackets, 20 series | Cast 90 deg corner bracket 20 series (Maker Store) | 20 | 20 | 1.80 | 36.00 | Maker Store USA | listing |
| torso | 2020 extrusion, cut list 100 mm x4, 102 mm x2, 180 mm x4, 190 mm x2, 340 mm x4 | Maker Store USA V-Slot 20x20mm, clear anodized, SKU LR-2020-S, 500 mm  | 3064 | 7 | 6.75 | 47.25 | Maker Store USA | estimate |
| tools | M5 tap and handle | TBD | 1 | 1 |  | TBD | TBD | TBD |
| base | 1 in x 30 in black nipple (mast) | 1 in x 30 in Sch 40 black steel nipple, threaded both ends | 1 | 1 | 17.75 | 17.75 | Global Industrial (MSI) | listing |
| torso | 6 mm 6061 plate for the neck plate (150 x 150) | 6061 aluminium plate 6 mm, 6 x 6 in (152 x 152 mm), 1 pc | 1 | 1 | 12.99 | 12.99 | Amazon | listing |
| torso | Plate for the torso base plate (220 x 140) | 6061 aluminium plate 1/4 in, 6 x 12 in (152 x 305 mm) | 1 | 1 | 18.99 | 18.99 | Amazon | listing |
| torso | 1/4 in plywood panel for the electronics board | B/C Sanded Plywood Project Panel 1/4 in x 2 ft x 4 ft (Home Depot Inte | 1 | 1 | 11.22 | 11.22 | Home Depot | from listing/secondary source |
| print | PETG-CF filament (2194 g printed) | PETG-CF 1 kg (Elegoo), black | 2.52 | 3 | 18.99 | 56.97 | Amazon (ELEGOO) | listing |
| print | PETG filament (163 g printed) | PETG 1 kg (Elegoo Rapid PETG), black | 0.19 | 1 | 12.59 | 12.59 | Amazon (ELEGOO) | listing |
| wiring | Feetech 5264 3-pin bus cables (12 in the chains) | Feetech 5264 3P servo cable 900 mm, 6 pcs (Waveshare) - recheck | 12 | 2 | 3.99 | 7.98 | Waveshare | listing |
| power | E-stop enclosure | E-stop enclosure, 1-hole yellow (Schneider XALK01H7) - recheck | 1 | 1 | 26.02 | 26.02 | Mouser | listing |
| wiring | 14 AWG silicone wire, 3.0 m (red and black counted) | TBD | 1 | 1 |  | TBD | TBD | TBD |
| wiring | 16 AWG silicone wire, 1.0 m (red and black counted) | TBD | 1 | 1 |  | TBD | TBD | TBD |
| wiring | 20 AWG silicone wire, 0.9 m (red and black counted) | TBD | 1 | 1 |  | TBD | TBD | TBD |
| wiring | 26 AWG silicone wire, 0.4 m (red and black counted) | TBD | 1 | 1 |  | TBD | TBD | TBD |

## Rules

* packs are bought whole: qty = ceil(need / pack); fasteners get 10 % spare before packing
  * a socket-screw kit's per-size count is not stated by the sellers: assumed pack / sizes (TBD: confirm)
  * filament = printed mass x 1.15 (supports, purge, failed prints; assumption), whole 1 kg spools
  * extrusion is bin-packed into 500 mm bars with 3 mm kerf; ends tapped M5 by the builder
  * an item without a price is a TBD row: it counts as unpriced, never as $0
The old caps (A < $500, B <= $1200) are reported for comparison only: the user lifted them for this round.
