MarkDannemiller/JackOLantern/research/sourcing/20261024-bom-final.md

# Joyful Jack: final bills of materials by tier

Generated by `build_final_bom.py` from `20261024-bom.json` (researched 2026-10-24) plus the substitutions made to fit the caps. Prices are point-in-time and mostly from listings or search snippets; each row keeps its source and confidence in the JSON. The existing head (Raspberry Pi 4, PCA9685, head servos, camera) and the Milwaukee M18 packs are not counted (Mark, 2026-10-24).

## Tier A: $498.05 (cap $500, headroom $1.95)

| Group | Item | Choice | Qty | Unit | Line |
|---|---|---|---:|---:|---:|
| arm | Shoulder servos (flex x2 + out x2), 35 kg·cm class | DIYmall 2 Sets 35kg DS3235 Digital Servo, coreless, full metal gear, 2 | 2 | $48.00 | $96.00 |
| arm | Elbow servos, 25 kg class, 270° | DSSERVO DS3225 MG, 270° angle option, with metal arm/horn accessory op | 2 | $20.00 | $40.00 |
| arm | Extension springs, shoulder counterbalance | Grainger 1NAE3 crossover centre loop extension spring, 0.5 in OD, 0.06 | 2 | $9.08 | $18.16 |
| arm | Hand grip servos (tier A), MG996R 4-pack | Hosyond MG996R 55 g metal-gear digital servo, 4-pack | 1 | $16.99 | $16.99 |
| base | ALTERNATE for the 24 in round pine board: 3/4 in birch plywood 2x2 ft project panel, cut to a 24 in circle in-house | Falken Design 3/4 in x 2 ft x 2 ft Birch Plywood Project Panel, FALKEN | 1 | $29.49 | $29.49 |
| base | 1 in black steel pipe, ~36 in, threaded both ends (center post) | PLUMBFLEX 1 in. x 36 in. Black Steel Pipe 1036PBL (1 in nominal, 1.315 | 1 | $16.06 | $16.06 |
| base | 1 in floor flange for center post | Southland 1 in. Black Malleable Iron Threaded Floor Flange 521-605HN | 1 | $6.97 | $6.97 |
| base | Concrete mix to fill bucket (~18.9 L = 0.667 cu ft) | Quikrete Concrete Mix No. 1101, 80 lb bag (Home Depot model 110180) | 1 | $5.68 | $5.68 |
| base | 5 US gallon plastic bucket (ballast base) | The Home Depot 5 Gallon Orange Homer Bucket, model 05GLHD2 (Internet # | 1 | $4.98 | $4.98 |
| control | Second PCA9685 16-channel servo driver | Adafruit 16-Channel 12-bit PWM/Servo Driver, I2C (PCA9685), Product ID | 1 | $14.95 | $14.95 |
| costume | Cowboy / western vest | TiaoBug Men's 3-piece faux suede western cowboy vest set (vest + banda | 1 | $32.65 | $32.65 |
| fasteners | M3 socket head cap screw kit | MYWISH 550-Piece M3 Hex Socket Cap Screws and Nuts Kit, 304 stainless, | 1 | $17.73 | $17.73 |
| power | Milwaukee M18 battery adapter with switch, fuse and 12 AWG leads | Generic 'Power Wheel Adapter for Milwaukee M18' with on/off switch, 30 | 1 | $34.99 | $34.99 |
| power | Bucks (tier A): one 6.8 V rail for both arms, one 5-6 V rail for the head servos, one 5.1 V for the Pi | DROK 300W Power Supply Module, DC 3.5-30V to 0.8-29V 10A adjustable bu | 3 | $10.20 | $30.60 |
| power | 12 AWG silicone wire, red + black | BNTECHGO 12 AWG silicone wire, 10 ft red + 10 ft black (Amazon ASIN B0 | 1 | $27.52 | $27.52 |
| power | Servo extension leads, 300 mm, 10-pack | Generic 300 mm male-female servo extension, 26 AWG, JR/Futaba (10 pcs) | 2 | $9.95 | $19.90 |
| power | Latching mushroom emergency stop, 22 mm, NC | 22mm NC red mushroom emergency stop push button, 40 mm head, latching  | 1 | $12.17 | $12.17 |
| power | Adjustable low-voltage cutoff for 5S Li-ion (~18 V) pack | XH-M609 digital low voltage disconnect module, 12-36 V, relay output ( | 1 | $9.99 | $9.99 |
| power | Inline ATC fuse holder, 12 AWG | Eaton Bussmann BK/HHD ATC in-line fuse holder, 12 Ga. leads (24 A) | 4 | $2.18 | $8.72 |
| power | ATC blade fuse assortment | Bussmann ATC fuse assortment, variety pack (10/15/20/25/30 A) | 1 | $8.32 | $8.32 |
| power | XT60 connector pairs | Amass XT60 connectors, 2 pairs, yellow (BuddyRC SKU 002-0201) | 2 | $3.49 | $6.98 |
| torso | PETG filament 1 kg | ELEGOO PETG PRO 1.75 mm 1 kg | 2 | $13.99 | $27.98 |
| torso | 1/4 in plywood, 2 x 4 ft project panel (torso ribs, tier A) | B/C Sanded Plywood Project Panel 1/4 in x 2 ft x 4 ft (Home Depot Inte | 1 | $11.22 | $11.22 |

## Tier B: $1,174.95 (cap $1,200, headroom $25.05)

| Group | Item | Choice | Qty | Unit | Line |
|---|---|---|---:|---:|---:|
| arm | Serial bus servo 12 V 30 kg.cm (wrist/forearm/hand joints) | Feetech ST3215-C047 12V 30 kg.cm, 1:345 (Seeed SKU 108090003); equival | 14 | $22.00 | $308.00 |
| arm | 8 mm shaft bearings | Phidgets Flanged Rotary Bearing for 8mm shaft (2 pcs), TRM4500_0 | 6 | $4.00 | $24.00 |
| arm | Extension springs, shoulder counterbalance | Grainger 1NAE3 crossover centre loop extension spring, 0.5 in OD, 0.06 | 2 | $9.08 | $18.16 |
| arm | GT2 driven pulley (large), shoulder flex reduction | Phidgets GT2 Pulley 8mm bore 60 teeth, TRM4105_0 | 6 | $3.00 | $18.00 |
| arm | GT2 drive pulley (small), shoulder flex reduction | Phidgets GT2 Pulley 8mm bore 22 teeth, TRM4102_0 | 6 | $2.75 | $16.50 |
| arm | GT2 6 mm closed belt, 220 mm | Phidgets GT2 closed-loop timing belt 6 mm x 220 mm, TRM4203_0 | 6 | $1.50 | $9.00 |
| arm | 8 mm steel shaft | Phidgets 8mm precision ground rotary shaft, TRM4000_0, 1 m (cut to len | 1 | $6.50 | $6.50 |
| base | ALTERNATE for the 24 in round pine board: 3/4 in birch plywood 2x2 ft project panel, cut to a 24 in circle in-house | Falken Design 3/4 in x 2 ft x 2 ft Birch Plywood Project Panel, FALKEN | 1 | $29.49 | $29.49 |
| base | Collar on 1 in pipe to set torso height | Kee Klamp 75-6 Collar, size 6 (fits 1 in nominal / 1.315 in OD pipe),  | 1 | $16.85 | $16.85 |
| base | 1 in black steel pipe, ~36 in, threaded both ends (center post) | PLUMBFLEX 1 in. x 36 in. Black Steel Pipe 1036PBL (1 in nominal, 1.315 | 1 | $16.06 | $16.06 |
| base | 1 in floor flange for center post | Southland 1 in. Black Malleable Iron Threaded Floor Flange 521-605HN | 1 | $6.97 | $6.97 |
| base | Concrete mix to fill bucket (~18.9 L = 0.667 cu ft) | Quikrete Concrete Mix No. 1101, 80 lb bag (Home Depot model 110180) | 1 | $5.68 | $5.68 |
| base | 5 US gallon plastic bucket (ballast base) | The Home Depot 5 Gallon Orange Homer Bucket, model 05GLHD2 (Internet # | 1 | $4.98 | $4.98 |
| control | Current/voltage monitor, I2C (chosen) | Adafruit INA228 I2C 85V 20-bit high/low side power monitor, STEMMA QT  | 1 | $14.95 | $14.95 |
| control | Bus servo driver / USB-TTL adapter | Waveshare Bus Servo Adapter (A), SKU 25514 | 2 | $4.99 | $9.98 |
| costume | Cowboy / western vest | TiaoBug Men's 3-piece faux suede western cowboy vest set (vest + banda | 1 | $32.65 | $32.65 |
| costume | Large white cartoon 4-finger gloves | Fun World Adult Giant Cartoon Hand Gloves, item FUN6197AD (4-finger, w | 1 | $19.99 | $19.99 |
| costume | Men's plaid flannel shirt | George Men's and Big Men's Flannel Shirt with Long Sleeves (Walmart it | 1 | $11.98 | $11.98 |
| fasteners | M5 tee nuts for 2020 (25 pack) | Maker Store Tee Nuts (25 Pack), SKU HARD-TNUT-PACK25, M5 option | 3 | $20.00 | $60.00 |
| fasteners | M5 low-profile screws, 10 mm (25 pack) | Maker Store M5 Low Profile Screws, SKU SCREWS-M5-LP, 10 mm x 25 pcs | 3 | $6.20 | $18.60 |
| fasteners | M3 socket head cap screw kit | MYWISH 550-Piece M3 Hex Socket Cap Screws and Nuts Kit, 304 stainless, | 1 | $17.73 | $17.73 |
| fasteners | M3 heat-set inserts, 100-pack | CNC Kitchen Heat Set Inserts - M3 standard (M3 x 5.7 mm), 100 pcs, sol | 1 | $10.99 | $10.99 |
| hand | TPU 95A filament 1 kg | ELEGOO TPU 95A 1.75 mm 1 kg | 1 | $17.99 | $17.99 |
| power | 18 AWG silicone wire, red + black | BNTECHGO 18 AWG silicone wire spool, 25 ft red + 25 ft black (150 stra | 1 | $45.99 | $45.99 |
| power | Milwaukee M18 battery adapter with switch, fuse and 12 AWG leads | Generic 'Power Wheel Adapter for Milwaukee M18' with on/off switch, 30 | 1 | $34.99 | $34.99 |
| power | Milwaukee M18 battery adapter with switch, fuse and 12 AWG leads | Generic 'Power Wheel Adapter for Milwaukee M18' with on/off switch, 30 | 1 | $34.99 | $34.99 |
| power | 18 V -> 12 V DC-DC buck, 20 A | EKYLIN 24V to 12V 20A 240W step-down converter, DC 15-40V input (Amazo | 2 | $17.47 | $34.94 |
| power | Blade fuse block, 6-way ATC/ATO, with negative bus | Sea-Dog blade style LED indicator fuse block with negative bus bar, 6  | 1 | $30.99 | $30.99 |
| power | ALTERNATE for the Pi 5 V buck: Pololu D24V50F5 5 V 5 A step-down | Pololu D24V50F5, item #2851 | 1 | $29.95 | $29.95 |
| power | Ideal-diode OR of two battery inputs | GODIYMODULES / DIY-Module 40A-60A ideal diode module, single channel ( | 2 | $13.99 | $27.98 |
| power | 12 AWG silicone wire, red + black | BNTECHGO 12 AWG silicone wire, 10 ft red + 10 ft black (Amazon ASIN B0 | 1 | $27.52 | $27.52 |
| power | Latching mushroom emergency stop, 22 mm, NC | 22mm NC red mushroom emergency stop push button, 40 mm head, latching  | 1 | $12.17 | $12.17 |
| power | XT60 connector pairs | Amass XT60 connectors, 2 pairs, yellow (BuddyRC SKU 002-0201) | 3 | $3.49 | $10.47 |
| power | Buck for the head's servo rail (5-6 V) | DROK 300W Power Supply Module, DC 3.5-30V to 0.8-29V 10A adjustable bu | 1 | $10.20 | $10.20 |
| power | Adjustable low-voltage cutoff for 5S Li-ion (~18 V) pack | XH-M609 digital low voltage disconnect module, 12-36 V, relay output ( | 1 | $9.99 | $9.99 |
| power | Relay >=30 A for actuator rail, switched by e-stop | TEMCo 24V 40A 4-pin Bosch-style automotive relay, SPST (SKU CN0345) | 1 | $8.73 | $8.73 |
| power | ATC blade fuse assortment | Bussmann ATC fuse assortment, variety pack (10/15/20/25/30 A) | 1 | $8.32 | $8.32 |
| torso | 2020 V-slot extrusion, 500 mm | Maker Store USA V-Slot 20x20mm, clear anodized, SKU LR-2020-S, 500 mm  | 10 | $6.75 | $67.50 |
| torso | Corner brackets for 2020 | Maker Store Cast 90 Degree Corner Bracket, SKU BRAC-90CAST | 24 | $1.80 | $43.20 |
| torso | PETG filament 1 kg | ELEGOO PETG PRO 1.75 mm 1 kg | 3 | $13.99 | $41.97 |

## Tier C: $2,139.69 (no cap)

| Group | Item | Choice | Qty | Unit | Line |
|---|---|---|---:|---:|---:|
| arm | High-torque serial bus servo (shoulder/elbow joints) | Feetech STS3250 (ST-3250-C001, 12 V 50 kg.cm, magnetic encoder, double | 6 | $97.00 | $582.00 |
| arm | Serial bus servo 12 V 30 kg.cm (wrist/forearm/hand joints) | Feetech ST3215-C047 12V 30 kg.cm, 1:345 (Seeed SKU 108090003); equival | 6 | $22.00 | $132.00 |
| arm | 8 mm shaft bearings | Phidgets Flanged Rotary Bearing for 8mm shaft (2 pcs), TRM4500_0 | 6 | $4.00 | $24.00 |
| arm | Extension springs, shoulder counterbalance | Grainger 1NAE3 crossover centre loop extension spring, 0.5 in OD, 0.06 | 2 | $9.08 | $18.16 |
| arm | GT2 driven pulley (large), shoulder flex reduction | Phidgets GT2 Pulley 8mm bore 60 teeth, TRM4105_0 | 6 | $3.00 | $18.00 |
| arm | GT2 drive pulley (small), shoulder flex reduction | Phidgets GT2 Pulley 8mm bore 22 teeth, TRM4102_0 | 6 | $2.75 | $16.50 |
| arm | GT2 6 mm closed belt, 220 mm | Phidgets GT2 closed-loop timing belt 6 mm x 220 mm, TRM4203_0 | 6 | $1.50 | $9.00 |
| arm | 8 mm steel shaft | Phidgets 8mm precision ground rotary shaft, TRM4000_0, 1 m (cut to len | 1 | $6.50 | $6.50 |
| base | ALTERNATE for the 24 in round pine board: 3/4 in birch plywood 2x2 ft project panel, cut to a 24 in circle in-house | Falken Design 3/4 in x 2 ft x 2 ft Birch Plywood Project Panel, FALKEN | 1 | $29.49 | $29.49 |
| base | Collar on 1 in pipe to set torso height | Kee Klamp 75-6 Collar, size 6 (fits 1 in nominal / 1.315 in OD pipe),  | 1 | $16.85 | $16.85 |
| base | 1 in black steel pipe, ~36 in, threaded both ends (center post) | PLUMBFLEX 1 in. x 36 in. Black Steel Pipe 1036PBL (1 in nominal, 1.315 | 1 | $16.06 | $16.06 |
| base | 1 in floor flange for center post | Southland 1 in. Black Malleable Iron Threaded Floor Flange 521-605HN | 1 | $6.97 | $6.97 |
| base | Concrete mix to fill bucket (~18.9 L = 0.667 cu ft) | Quikrete Concrete Mix No. 1101, 80 lb bag (Home Depot model 110180) | 1 | $5.68 | $5.68 |
| base | 5 US gallon plastic bucket (ballast base) | The Home Depot 5 Gallon Orange Homer Bucket, model 05GLHD2 (Internet # | 1 | $4.98 | $4.98 |
| control | Main computer | Raspberry Pi 5 8 GB | 1 | $175.00 | $175.00 |
| control | Current/voltage monitor, I2C (chosen) | Adafruit INA228 I2C 85V 20-bit high/low side power monitor, STEMMA QT  | 1 | $14.95 | $14.95 |
| control | Pi cooling | Raspberry Pi Active Cooler (SC1148) | 1 | $10.95 | $10.95 |
| control | Bus servo driver / USB-TTL adapter | Waveshare Bus Servo Adapter (A), SKU 25514 | 2 | $4.99 | $9.98 |
| costume | Cowboy / western vest | TiaoBug Men's 3-piece faux suede western cowboy vest set (vest + banda | 1 | $32.65 | $32.65 |
| costume | Men's plaid flannel shirt | George Men's and Big Men's Flannel Shirt with Long Sleeves (Walmart it | 1 | $11.98 | $11.98 |
| fasteners | M5 tee nuts for 2020 (25 pack) | Maker Store Tee Nuts (25 Pack), SKU HARD-TNUT-PACK25, M5 option | 3 | $20.00 | $60.00 |
| fasteners | M5 low-profile screws, 10 mm (25 pack) | Maker Store M5 Low Profile Screws, SKU SCREWS-M5-LP, 10 mm x 25 pcs | 3 | $6.20 | $18.60 |
| fasteners | M3 socket head cap screw kit | MYWISH 550-Piece M3 Hex Socket Cap Screws and Nuts Kit, 304 stainless, | 1 | $17.73 | $17.73 |
| fasteners | M3 heat-set inserts, 100-pack | CNC Kitchen Heat Set Inserts - M3 standard (M3 x 5.7 mm), 100 pcs, sol | 1 | $10.99 | $10.99 |
| hand | AmazingHand kit, right hand | Seeed Studio Amazing Hand (Right Hand) developer kit, SKU 100063642 | 1 | $99.00 | $99.00 |
| hand | AmazingHand kit, left hand | Seeed Studio Amazing Hand (Left Hand) kit, SKU 100062181 | 1 | $99.00 | $99.00 |
| hand | TPU 95A filament 1 kg | ELEGOO TPU 95A 1.75 mm 1 kg | 1 | $17.99 | $17.99 |
| power | 5 V hand servo rail buck (one per hand) | Pololu D36V50F5 5 V 5.5 A step-down, item 4091 | 2 | $39.95 | $79.90 |
| power | 18 AWG silicone wire, red + black | BNTECHGO 18 AWG silicone wire spool, 25 ft red + 25 ft black (150 stra | 1 | $45.99 | $45.99 |
| power | Ideal-diode OR of two battery inputs | GODIYMODULES / DIY-Module 40A-60A ideal diode module, single channel ( | 3 | $13.99 | $41.97 |
| power | Custom PDB: JLCPCB 2-layer 100x100 mm, 5 pcs, economic PCBA (lot) | JLCPCB | 1 | $38.00 | $38.00 |
| power | Milwaukee M18 battery adapter with switch, fuse and 12 AWG leads | Generic 'Power Wheel Adapter for Milwaukee M18' with on/off switch, 30 | 1 | $34.99 | $34.99 |
| power | Milwaukee M18 battery adapter with switch, fuse and 12 AWG leads | Generic 'Power Wheel Adapter for Milwaukee M18' with on/off switch, 30 | 1 | $34.99 | $34.99 |
| power | 18 V -> 12 V DC-DC buck, 20 A | EKYLIN 24V to 12V 20A 240W step-down converter, DC 15-40V input (Amazo | 2 | $17.47 | $34.94 |
| power | 24 V mains supply (third OR input) | Mean Well LRS-350-24 | 1 | $31.40 | $31.40 |
| power | Blade fuse block, 6-way ATC/ATO, with negative bus | Sea-Dog blade style LED indicator fuse block with negative bus bar, 6  | 1 | $30.99 | $30.99 |
| power | ALTERNATE for the Pi 5 V buck: Pololu D24V50F5 5 V 5 A step-down | Pololu D24V50F5, item #2851 | 1 | $29.95 | $29.95 |
| power | 12 AWG silicone wire, red + black | BNTECHGO 12 AWG silicone wire, 10 ft red + 10 ft black (Amazon ASIN B0 | 1 | $27.52 | $27.52 |
| power | Latching mushroom emergency stop, 22 mm, NC | 22mm NC red mushroom emergency stop push button, 40 mm head, latching  | 1 | $12.17 | $12.17 |
| power | XT60 connector pairs | Amass XT60 connectors, 2 pairs, yellow (BuddyRC SKU 002-0201) | 3 | $3.49 | $10.47 |
| power | Buck for the torso Raspberry Pi 5, set to 5.1 V (tier C) | DROK 300W Power Supply Module, DC 3.5-30V to 0.8-29V 10A adjustable bu | 1 | $10.20 | $10.20 |
| power | Buck for the head's servo rail (5-6 V) | DROK 300W Power Supply Module, DC 3.5-30V to 0.8-29V 10A adjustable bu | 1 | $10.20 | $10.20 |
| power | Adjustable low-voltage cutoff for 5S Li-ion (~18 V) pack | XH-M609 digital low voltage disconnect module, 12-36 V, relay output ( | 1 | $9.99 | $9.99 |
| power | Relay >=30 A for actuator rail, switched by e-stop | TEMCo 24V 40A 4-pin Bosch-style automotive relay, SPST (SKU CN0345) | 1 | $8.73 | $8.73 |
| power | ATC blade fuse assortment | Bussmann ATC fuse assortment, variety pack (10/15/20/25/30 A) | 1 | $8.32 | $8.32 |
| power | Custom PDB: current/voltage monitor (one per input) | TI INA226AIDGSR | 3 | $2.66 | $7.98 |
| power | Custom PDB: eFuse per output branch | TI TPS25982 (TPS259824ONRGET, 24-VQFN 4x4) | 2 | $3.82 | $7.64 |
| power | Custom PDB: ideal-diode controller (one per OR input) | TI LM74700QDBVRQ1 | 3 | $1.89 | $5.67 |
| torso | 2020 V-slot extrusion, 500 mm | Maker Store USA V-Slot 20x20mm, clear anodized, SKU LR-2020-S, 500 mm  | 10 | $6.75 | $67.50 |
| torso | Corner brackets for 2020 | Maker Store Cast 90 Degree Corner Bracket, SKU BRAC-90CAST | 24 | $1.80 | $43.20 |
| torso | PETG filament 1 kg | ELEGOO PETG PRO 1.75 mm 1 kg | 3 | $13.99 | $41.97 |
