MarkDannemiller/JackOLantern/research/sourcing/20261024-bom.md

# Joyful Jack: sourcing BOM, three tiers

Prices read 2026-10-24 with web search and fetch only (no distributor APIs: the hub doctor reports amazon-data and distributor-data degraded). Nothing ordered. Source data: `20261024-bom.json` (one row per item with specs, spec source, notes). Conf.: **V** verified on vendor page, **L** listing or secondary source (search snippet, tracker, mirror), **E** labelled estimate. Shipping and tax excluded. Amazon links are untagged: `AMAZON_PARTNER_TAG` is unset on this machine.

## Totals

| Tier | Shared | Tier items | **Total** | Cap | Over / under |
|---|---:|---:|---:|---|---|
| A | 423.94 | 480.39 | **904.33** | < $500 | over by $404.33 |
| B | 423.94 | 1179.30 | **1603.24** | <= $1200 | over by $403.24 |
| C | 423.94 | 1708.82 | **2132.76** | none (aim < ~$3000-3500) | under by $1367.24 |

Tier total = shared items + that tier's items. Unpriced lines (null) count as $0 and are listed under Gaps.

## Shared (all tiers)

| Group | Item | Choice | Qty | Unit (USD) | Line (USD) | Conf. | Link |
|---|---|---|---:|---:|---:|---|---|
| base | 5 US gallon plastic bucket (ballast base) | The Home Depot 5 Gallon Orange Homer Bucket, model 05GLHD2 (Internet #100087613) | 1 | 4.98 | 4.98 | L | [link](https://www.homedepot.com/p/The-Home-Depot-5-Gallon-Orange-Homer-Bucket-05GLHD2/100087613) |
| base | Concrete mix to fill bucket (~18.9 L = 0.667 cu ft) | Quikrete Concrete Mix No. 1101, 80 lb bag (Home Depot model 110180) | 2 | 5.68 | 11.36 | L | [link](https://shopsavvy.com/products/quickrete-80lb-concrete-mix) |
| base | 1 in black steel pipe, ~36 in, threaded both ends (center post) | PLUMBFLEX 1 in. x 36 in. Black Steel Pipe 1036PBL (1 in nominal, 1.315 in OD) | 1 | 16.06 | 16.06 | L | [link](https://www.homedepot.com/p/PLUMBFLEX-1-in-x-36-in-Black-Steel-Pipe-1036PBL/307752681) |
| base | 1 in floor flange for center post | Southland 1 in. Black Malleable Iron Threaded Floor Flange 521-605HN | 1 | 6.97 | 6.97 | L | [link](https://homedepot.com/p/Southland-1-in-Black-Malleable-Iron-Threaded-Floor-Flange-521-605HN/100179931) |
| base | 24 in round 3/4 in wood disc (base top / skirt plate) | 0.75 in. x 24 in. x 24 in. Edge-Glued Round Pine Board, pack of 1 (model 1-24) | 1 | 52.04 | 52.04 | L | [link](https://www.homedepot.com/p/0-75-in-x-24-in-x-24-in-Edge-Glued-Round-Common-Softwood-Boards-Pine-Wood-Round-Boards-Pack-of-1-1-24/328667854) |
| base | Collar on 1 in pipe to set torso height | Kee Klamp 75-6 Collar, size 6 (fits 1 in nominal / 1.315 in OD pipe), galvanized, set screw included | 1 | 16.85 | 16.85 | V | [link](https://www.simplifiedbuilding.com/75-6-collar-1) |
| power | Milwaukee M18 battery adapter with switch, fuse and 12 AWG leads | Generic 'Power Wheel Adapter for Milwaukee M18' with on/off switch, 30 A blade fuse, 12 AWG leads, 1-pack (Amazon ASIN B0BVG1HTM2, seller LIANQUAN) | 1 | 34.99 | 34.99 | L | [link](https://www.newegg.com/p/1WM-0071-00050) |
| power | Adjustable low-voltage cutoff for 5S Li-ion (~18 V) pack | XH-M609 digital low voltage disconnect module, 12-36 V, relay output (Amazon ASIN B0FJ8NC729, MTDELE) | 1 | 9.99 | 9.99 | L | [link](https://sentinel.rocketium.com/products/amazon/B0FJ8NC729) |
| power | 18 V to 5 V buck for Raspberry Pi, >=5 A | Pololu D36V50F5, 5 V 5.5 A step-down regulator (Pololu item #4091) | 1 | 39.95 | 39.95 | V | [link](https://www.pololu.com/product/4091) |
| power | Latching mushroom emergency stop, 22 mm, NC | 22mm NC red mushroom emergency stop push button, 40 mm head, latching (ZB2-BE102C / XB2-BS142 style) | 1 | 12.17 | 12.17 | V | [link](https://www.fridayparts.com/22mm-nc-n-c-red-mushroom-emergency-stop-push-button-switch-600v-10a-zb2-be102c-xb2-bs142) |
| power | Relay >=30 A for actuator rail, switched by e-stop | TEMCo 24V 40A 4-pin Bosch-style automotive relay, SPST (SKU CN0345) | 1 | 8.73 | 8.73 | V | [link](https://temcoindustrial.com/24v-40a-4-pin-bosch-style-automotive-relay-spst/) |
| power | Blade fuse block, 6-way ATC/ATO, with negative bus | Sea-Dog blade style LED indicator fuse block with negative bus bar, 6 circuit, 445185-1 | 1 | 30.99 | 30.99 | L | [link](https://www.drsa.com/products/sea-dog-blade-style-led-indicator-fuse-block-w-negative-bus-bar-6-circuit-445185-1) |
| power | ATC blade fuse assortment | Bussmann ATC fuse assortment, variety pack (10/15/20/25/30 A) | 1 | 8.32 | 8.32 | L | [link](https://www.walmart.com/ip/1764066057) |
| power | 12 AWG silicone wire, red + black | BNTECHGO 12 AWG silicone wire, 10 ft red + 10 ft black (Amazon ASIN B01ABOPMEI) | 1 | 27.52 | 27.52 | L | [link](https://www.newegg.com/PISKEKAT-Work-Lights/BrandSubCat/ID-218576-2092/Page-13) |
| power | 18 AWG silicone wire, red + black | BNTECHGO 18 AWG silicone wire spool, 25 ft red + 25 ft black (150 strands tinned copper, 200 C, 600 V) | 1 | 45.99 | 45.99 | L | [link](https://bigamart.com/product/bntechgo-18-gauge-silicone-wire-spool-50-ft-ultra-flexible-high-temp-200-deg-c-600v-18-awg-silicone-wire-150-strands-of-tinned-copper-wi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) |
| power | XT60 connector pairs | Amass XT60 connectors, 2 pairs, yellow (BuddyRC SKU 002-0201) | 3 | 3.49 | 10.47 | V | [link](https://buddyrc.com/products/genuine-xt60-connectors-2-pairs-yellow-1) |
| control | Current/voltage monitor, I2C (chosen) | Adafruit INA228 I2C 85V 20-bit high/low side power monitor, STEMMA QT (product 5832) | 1 | 14.95 | 14.95 | V | [link](https://www.adafruit.com/product/5832) |
| costume | Men's plaid flannel shirt | George Men's and Big Men's Flannel Shirt with Long Sleeves (Walmart item 5454053875) | 1 | 11.98 | 11.98 | L | [link](https://www.walmart.com/ip/George-Men-s-and-Big-Men-s-Flannel-Shirt-with-Long-Sleeves-Sizes-XS-3XLT/5454053875) |
| costume | Cowboy / western vest | TiaoBug Men's 3-piece faux suede western cowboy vest set (vest + bandanna + hat), black | 1 | 32.65 | 32.65 | L | [link](https://www.walmart.com/ip/9980614009) |
| costume | Bandana | Red/navy paisley cotton bandana, 22 x 22 in | 1 | 6.99 | 6.99 | L | [link](https://www.walmart.com/ip/140581042) |
| costume | Large white cartoon 4-finger gloves | Fun World Adult Giant Cartoon Hand Gloves, item FUN6197AD (4-finger, white, one size) | 1 | 19.99 | 19.99 | V | [link](https://www.halloweencostumes.com/adult-giant-cartoon-hand-gloves.html) |
| | **Subtotal** | | | | **423.94** | | |

Reference only, not bought (qty 0): M18 HIGH OUTPUT 12.0 Ah (48-11-1812) and XC8.0 (48-11-1880) packs; a generic INA226 board; swap alternates. See the JSON.

## Tier A, Beginner (8 PWM servos)

| Group | Item | Choice | Qty | Unit (USD) | Line (USD) | Conf. | Link |
|---|---|---|---:|---:|---:|---|---|
| arm | Shoulder servos (flex x2 + out x2), 35 kg·cm class | DIYmall 2 Sets 35kg DS3235 Digital Servo, coreless, full metal gear, 270° (ASIN B0CCNFQC6S); pack = 2 servos + 2x 25T servo arms + accessories. Standard (non-HV) DS3235 / DS3235-270 per the DSSERVO datasheet. | 2 | 48.00 | 96.00 | L | [link](https://www.amazon.com/dp/B0CCNFQC6S) |
| arm | Elbow servos, 25 kg class, 270° | DSSERVO DS3225 MG, 270° angle option, with metal arm/horn accessory option (AIFitLab DSSERVO store) | 2 | 20.00 | 40.00 | L | [link](https://aifitlab.com/products/dsservo-ds3225-mg-servo-motor) |
| hand | Hand servos, 20 kg class | DSSERVO DS3218 MG, 270° option, Metal Arm / Metal Servo Horn accessory option (AIFitLab DSSERVO store) | 2 | 17.00 | 34.00 | V | [link](https://aifitlab.com/products/dsservo-ds3218-mg-servo-motor) |
| control | Second PCA9685 16-channel servo driver | Adafruit 16-Channel 12-bit PWM/Servo Driver, I2C (PCA9685), Product ID 815 | 1 | 14.95 | 14.95 | V | [link](https://www.adafruit.com/product/815) |
| power | Servo-rail bucks: one per arm (2) plus one for the head's existing servo rail (1) | DROK 300W Power Supply Module, DC 3.5-30V to 0.8-29V 10A adjustable buck with voltmeter (DROK product code 200143) | 3 | 10.20 | 30.60 | V | [link](https://www.droking.com/dc-buck/300W-Power-Supply-Module-DC-3.5-30V-to-0.8-29V-10A-Buck-Converter-Adjustable-Voltage-Regulator-Adapter-Driver-Module-Voltmeter) |
| arm | Aluminium multi-function servo brackets (for 8 servos) | 4PCS Multi-function Servo Motor Bracket, aluminium, for MG995/MG996R standard servos (eBay item 234045722398); 4 brackets per pack | 2 | 10.99 | 21.98 | L | [link](https://www.ebay.com/itm/234045722398) |
| arm | Shoulder-flex 2:1 reduction: servo spline to 8 mm REX adapter | ServoCity 8mm REX Servo Shaft (25 Tooth Spline, 36mm Length), SKU 1922-0025-0036 | 2 | 10.99 | 21.98 | V | [link](https://www.servocity.com/8mm-rex-servo-shaft-25-tooth-spline-36mm-length/) |
| arm | Shoulder-flex 2:1 reduction: 20T driver pulley | ServoCity 2mm Pitch GT2 Pinion Timing Pulley (8mm REX Bore, 20 Tooth), SKU 3422-4008-0020 | 2 | 7.99 | 15.98 | V | [link](https://www.servocity.com/2mm-pitch-gt2-pinion-timing-pulley-8mm-rex-bore-20-tooth/) |
| arm | Shoulder-flex 2:1 reduction: 40T driven pulley | ServoCity 2mm Pitch GT2 Pinion Timing Pulley (8mm REX Bore, 40 Tooth), SKU 3422-4008-0040 | 2 | 9.99 | 19.98 | V | [link](https://www.servocity.com/2mm-pitch-gt2-pinion-timing-pulley-8mm-rex-bore-40-tooth/) |
| arm | Shoulder-flex closed GT2 belt | ServoCity 2mm Pitch GT2 Timing Belt (6mm Width, 216mm Pitch Length, 108 Tooth), SKU 3423-0006-0216 | 2 | 3.79 | 7.58 | V | [link](https://www.servocity.com/2mm-pitch-gt2-timing-belt-6mm-width-216mm-pitch-length-108-tooth/) |
| arm | Shoulder-flex output shaft, 8 mm | ServoCity 8mm REX Shaft with E-Clip (Stainless Steel, 104mm Length), 2106 series, SKU 2106-4008-1040 | 2 | 5.59 | 11.18 | V | [link](https://www.servocity.com/2106-series-stainless-steel-rex-shaft-8mm-diameter-104mm-length/) |
| arm | 608-size bearings (8x22x7 mm) for the shoulder shafts | ServoCity 8mm ID Non-Flanged Ball Bearing (22mm OD, 7mm Thickness), 2-pack, SKU 1600-0722-0008 | 2 | 3.99 | 7.98 | V | [link](https://www.servocity.com/8mm-id-x-22mm-od-non-flanged-ball-bearing-2-pack/) |
| arm | Shoulder counterbalance springs | STOREHOUSE Assorted Spring Set, 200-piece (extension and compression), Harbor Freight SKU 67562 | 1 | 4.99 | 4.99 | V | [link](https://www.harborfreight.com/200-piece-assorted-spring-set-67562.html) |
| torso | PETG filament 1.75 mm, 1 kg | Polymaker PolyLite PETG 1.75 mm 1 kg (Grey, MatterHackers SKU MUR5Z8PG) | 3 | 21.99 | 65.97 | L | [link](https://matterhackers.com/store/l/polymaker-polylite-petg-grey-175mm-1kg/sk/MUR5Z8PG) |
| torso | 6 mm (1/4 in) Baltic birch plywood, 12x24 in, laser grade | Woodpeckers Baltic Birch Plywood 6 mm (1/4 in) x 12 x 24 in, B/BB grade, box of 6 sheets | 1 | 50.11 | 50.11 | L | [link](https://woodartsupply.com/products/baltic-birch-plywood-6-mm-1-4-x-12-x-24-inch-craft-wood-box-of-6-b-bb-grade-baltic-birch-sheets-perfect-for-laser-cnc-cutting-and-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) |
| fasteners | M3 socket head cap screw kit | MYWISH 550-Piece M3 Hex Socket Cap Screws and Nuts Kit, 304 stainless, DIN912, with washers and wrenches (SF-TZ00085) | 1 | 17.73 | 17.73 | L | [link](https://www.homedepot.com/p/MYWISH-550-Piece-M3-Hex-Socket-Cap-Screws-and-Nuts-Kit-304-Stainless-Steel-DIN912-with-Washers-and-Wrenches-SF-TZ00085/337777102) |
| fasteners | M4 screw kit | MYWISH 380-Piece M4 Screw Nuts & Bolts Assortment Kit, 304 stainless, button head socket cap (SF-TZ00003) | 1 | 8.39 | 8.39 | L | [link](https://www.homedepot.com/p/MYWISH-380-Pieces-M4-Screw-Nuts-Bolts-Assortment-Kit-304-Stainless-Steel-Button-Head-Socket-Cap-Metric-Screws-Bolts-in-Silver-SF-TZ00003/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) |
| fasteners | M3 heat-set inserts, 100-pack | CNC Kitchen Heat Set Inserts - M3 standard (M3 x 5.7 mm), 100 pcs, sold by Prusa Research | 1 | 10.99 | 10.99 | V | [link](https://www.prusa3d.com/product/heat-set-inserts-m3-standard-100-pcs/) |
| | **Subtotal** | | | | **480.39** | | |

## Tier B, Midrange (14 Feetech STS bus servos on 12 V)

| Group | Item | Choice | Qty | Unit (USD) | Line (USD) | Conf. | Link |
|---|---|---|---:|---:|---:|---|---|
| arm | High-torque serial bus servo (shoulder/elbow joints) | Feetech STS3250 (ST-3250-C001, 12 V 50 kg.cm, magnetic encoder, double shaft, with bracket); alt variant STS3250-C002 (1/345) at OpenELAB | 6 | 97.00 | 582.00 | L | [link](https://aifitlab.com/products/feetech-sts3250-servo-motor) |
| arm | Serial bus servo 12 V 30 kg.cm (wrist/forearm/hand joints) | Feetech ST3215-C047 12V 30 kg.cm, 1:345 (Seeed SKU 108090003); equivalent STS3215-C018 12V 1/345 | 8 | 22.00 | 176.00 | V | [link](https://www.seeedstudio.com/STS3215-30KG-Serial-Servo-p-6340.html) |
| control | Bus servo driver / USB-TTL adapter | Waveshare Bus Servo Adapter (A), SKU 25514 | 2 | 4.99 | 9.98 | V | [link](https://www.waveshare.com/bus-servo-adapter-a.htm) |
| power | 18 V -> 12 V DC-DC buck, 20 A | EKYLIN 24V to 12V 20A 240W step-down converter, DC 15-40V input (Amazon ASIN B01JAIC9EM) | 2 | 17.47 | 34.94 | L | [link](https://www.amazon.com/dp/B01JAIC9EM) |
| power | 2nd M18 battery adapter (same as shared) | Generic 'Power Wheel Adapter for Milwaukee M18' with on/off switch, 30 A blade fuse, 12 AWG leads, 1-pack (Amazon ASIN B0BVG1HTM2, seller LIANQUAN) | 1 | 34.99 | 34.99 | L | [link](https://www.newegg.com/p/1WM-0071-00050) |
| power | Ideal-diode OR of two battery inputs | GODIYMODULES / DIY-Module 40A-60A ideal diode module, single channel (Amazon ASIN B0DDBYNDX5), one per input into a common bus | 2 | 13.99 | 27.98 | L | [link](https://www.amazon.com/dp/B0DDBYNDX5) |
| torso | 2020 V-slot extrusion, 500 mm | Maker Store USA V-Slot 20x20mm, clear anodized, SKU LR-2020-S, 500 mm length | 10 | 6.75 | 67.50 | E | [link](https://makerstore.cc/product/v-slot-20-x-20mm/) |
| torso | Corner brackets for 2020 | Maker Store Cast 90 Degree Corner Bracket, SKU BRAC-90CAST | 24 | 1.80 | 43.20 | V | [link](https://makerstore.cc/product/cast-90-degree-corner-bracket/) |
| fasteners | M5 tee nuts for 2020 (25 pack) | Maker Store Tee Nuts (25 Pack), SKU HARD-TNUT-PACK25, M5 option | 3 | 20.00 | 60.00 | E | [link](https://makerstore.cc/product/tee-nuts-25-pack/) |
| fasteners | M5 low-profile screws, 10 mm (25 pack) | Maker Store M5 Low Profile Screws, SKU SCREWS-M5-LP, 10 mm x 25 pcs | 3 | 6.20 | 18.60 | E | [link](https://makerstore.cc/product-category/screws/low-profile/low-profile-m5/) |
| arm | GT2 drive pulley (small), shoulder flex reduction | Phidgets GT2 Pulley 8mm bore 22 teeth, TRM4102_0 | 2 | 2.75 | 5.50 | V | [link](https://www.phidgets.com/?prodid=751) |
| arm | GT2 driven pulley (large), shoulder flex reduction | Phidgets GT2 Pulley 8mm bore 60 teeth, TRM4105_0 | 2 | 3.00 | 6.00 | V | [link](https://www.phidgets.com/?prodid=754) |
| arm | GT2 6 mm closed belt, 220 mm | Phidgets GT2 closed-loop timing belt 6 mm x 220 mm, TRM4203_0 | 2 | 1.50 | 3.00 | V | [link](https://phidgets.com/?catid=42&pcid=35&tier=2) |
| arm | GT2 6 mm closed belt, 276 mm | Phidgets GT2 closed-loop timing belt 6 mm x 276 mm, TRM4204_0 | 2 | 1.50 | 3.00 | V | [link](https://phidgets.com/?catid=42&pcid=35&tier=2) |
| arm | 8 mm steel shaft | Phidgets 8mm precision ground rotary shaft, TRM4000_0, 1 m (cut to length) | 1 | 6.50 | 6.50 | V | [link](https://www.phidgets.com/?tier=3&catid=83&pcid=74&prodid=730) |
| arm | 8 mm shaft bearings | Phidgets Flanged Rotary Bearing for 8mm shaft (2 pcs), TRM4500_0 | 2 | 4.00 | 8.00 | V | [link](https://www.phidgets.com/?prodid=874) |
| torso | PETG filament 1 kg | ELEGOO PETG PRO 1.75 mm 1 kg | 4 | 13.99 | 55.96 | L | [link](https://us.elegoo.com/products/petg-pro-filament-1-75mm-colored-1kg) |
| hand | TPU 95A filament 1 kg | ELEGOO TPU 95A 1.75 mm 1 kg | 1 | 17.99 | 17.99 | L | [link](https://us.elegoo.com/products/tpu-filament-1-75mm-colored-1kg) |
| arm | Extension springs, shoulder counterbalance | Grainger 1NAE3 crossover centre loop extension spring, 0.5 in OD, 0.063 in wire, carbon steel, pack of 3 | 2 | 9.08 | 18.16 | L | [link](https://www.grainger.com/product/Extension-Spring-Crossover-1NAE3) |
| | **Subtotal** | | | | **1179.30** | | |

## Tier C, Maxed (B's arms + wrist pitch + AmazingHand x2)

Tier C carries every tier B line (tagged `(Carried from tier B.)` in the JSON) except: STS3215 8 -> 4 (fingers and thumb replaced by the hands) and ideal-diode modules 2 -> 3 (24 V mains input).

| Group | Item | Choice | Qty | Unit (USD) | Line (USD) | Conf. | Link |
|---|---|---|---:|---:|---:|---|---|
| arm | High-torque serial bus servo (shoulder/elbow joints) | Feetech STS3250 (ST-3250-C001, 12 V 50 kg.cm, magnetic encoder, double shaft, with bracket); alt variant STS3250-C002 (1/345) at OpenELAB | 6 | 97.00 | 582.00 | L | [link](https://aifitlab.com/products/feetech-sts3250-servo-motor) |
| arm | Serial bus servo 12 V 30 kg.cm (wrist/forearm/hand joints) | Feetech ST3215-C047 12V 30 kg.cm, 1:345 (Seeed SKU 108090003); equivalent STS3215-C018 12V 1/345 | 4 | 22.00 | 88.00 | V | [link](https://www.seeedstudio.com/STS3215-30KG-Serial-Servo-p-6340.html) |
| control | Bus servo driver / USB-TTL adapter | Waveshare Bus Servo Adapter (A), SKU 25514 | 2 | 4.99 | 9.98 | V | [link](https://www.waveshare.com/bus-servo-adapter-a.htm) |
| power | 18 V -> 12 V DC-DC buck, 20 A | EKYLIN 24V to 12V 20A 240W step-down converter, DC 15-40V input (Amazon ASIN B01JAIC9EM) | 2 | 17.47 | 34.94 | L | [link](https://www.amazon.com/dp/B01JAIC9EM) |
| power | 2nd M18 battery adapter (same as shared) | Generic 'Power Wheel Adapter for Milwaukee M18' with on/off switch, 30 A blade fuse, 12 AWG leads, 1-pack (Amazon ASIN B0BVG1HTM2, seller LIANQUAN) | 1 | 34.99 | 34.99 | L | [link](https://www.newegg.com/p/1WM-0071-00050) |
| power | Ideal-diode OR of two battery inputs | GODIYMODULES / DIY-Module 40A-60A ideal diode module, single channel (Amazon ASIN B0DDBYNDX5), one per input into a common bus | 3 | 13.99 | 41.97 | L | [link](https://www.amazon.com/dp/B0DDBYNDX5) |
| torso | 2020 V-slot extrusion, 500 mm | Maker Store USA V-Slot 20x20mm, clear anodized, SKU LR-2020-S, 500 mm length | 10 | 6.75 | 67.50 | E | [link](https://makerstore.cc/product/v-slot-20-x-20mm/) |
| torso | Corner brackets for 2020 | Maker Store Cast 90 Degree Corner Bracket, SKU BRAC-90CAST | 24 | 1.80 | 43.20 | V | [link](https://makerstore.cc/product/cast-90-degree-corner-bracket/) |
| fasteners | M5 tee nuts for 2020 (25 pack) | Maker Store Tee Nuts (25 Pack), SKU HARD-TNUT-PACK25, M5 option | 3 | 20.00 | 60.00 | E | [link](https://makerstore.cc/product/tee-nuts-25-pack/) |
| fasteners | M5 low-profile screws, 10 mm (25 pack) | Maker Store M5 Low Profile Screws, SKU SCREWS-M5-LP, 10 mm x 25 pcs | 3 | 6.20 | 18.60 | E | [link](https://makerstore.cc/product-category/screws/low-profile/low-profile-m5/) |
| arm | GT2 drive pulley (small), shoulder flex reduction | Phidgets GT2 Pulley 8mm bore 22 teeth, TRM4102_0 | 2 | 2.75 | 5.50 | V | [link](https://www.phidgets.com/?prodid=751) |
| arm | GT2 driven pulley (large), shoulder flex reduction | Phidgets GT2 Pulley 8mm bore 60 teeth, TRM4105_0 | 2 | 3.00 | 6.00 | V | [link](https://www.phidgets.com/?prodid=754) |
| arm | GT2 6 mm closed belt, 220 mm | Phidgets GT2 closed-loop timing belt 6 mm x 220 mm, TRM4203_0 | 2 | 1.50 | 3.00 | V | [link](https://phidgets.com/?catid=42&pcid=35&tier=2) |
| arm | GT2 6 mm closed belt, 276 mm | Phidgets GT2 closed-loop timing belt 6 mm x 276 mm, TRM4204_0 | 2 | 1.50 | 3.00 | V | [link](https://phidgets.com/?catid=42&pcid=35&tier=2) |
| arm | 8 mm steel shaft | Phidgets 8mm precision ground rotary shaft, TRM4000_0, 1 m (cut to length) | 1 | 6.50 | 6.50 | V | [link](https://www.phidgets.com/?tier=3&catid=83&pcid=74&prodid=730) |
| arm | 8 mm shaft bearings | Phidgets Flanged Rotary Bearing for 8mm shaft (2 pcs), TRM4500_0 | 2 | 4.00 | 8.00 | V | [link](https://www.phidgets.com/?prodid=874) |
| torso | PETG filament 1 kg | ELEGOO PETG PRO 1.75 mm 1 kg | 4 | 13.99 | 55.96 | L | [link](https://us.elegoo.com/products/petg-pro-filament-1-75mm-colored-1kg) |
| hand | TPU 95A filament 1 kg | ELEGOO TPU 95A 1.75 mm 1 kg | 1 | 17.99 | 17.99 | L | [link](https://us.elegoo.com/products/tpu-filament-1-75mm-colored-1kg) |
| arm | Extension springs, shoulder counterbalance | Grainger 1NAE3 crossover centre loop extension spring, 0.5 in OD, 0.063 in wire, carbon steel, pack of 3 | 2 | 9.08 | 18.16 | L | [link](https://www.grainger.com/product/Extension-Spring-Crossover-1NAE3) |
| hand | AmazingHand kit, right hand | Seeed Studio Amazing Hand (Right Hand) developer kit, SKU 100063642 | 1 | 99.00 | 99.00 | V | [link](https://www.seeedstudio.com/Amazing-Hand-Right-Hand-The-Open-Source-Robotic-Hand-Developer-Kit.html) |
| hand | AmazingHand kit, left hand | Seeed Studio Amazing Hand (Left Hand) kit, SKU 100062181 | 1 | 99.00 | 99.00 | V | [link](https://www.seeedstudio.com/amazinghand-open-source-robotic-hand-kit.html) |
| hand | Bus servo USB adapter for hands (optional, Pi-side single bus) | Waveshare Bus Servo Adapter (A) | 1 | 4.99 | 4.99 | V | [link](https://www.waveshare.com/bus-servo-adapter-a.htm) |
| power | 5 V hand servo rail buck (one per hand) | Pololu D36V50F5 5 V 5.5 A step-down, item 4091 | 2 | 39.95 | 79.90 | V | [link](https://www.pololu.com/product/4091) |
| arm | Wrist pitch servo (one per arm) | Feetech ST3215-C047 (STS3215) 12 V 30 kg.cm, SKU 108090003 | 2 | 22.00 | 44.00 | V | [link](https://www.seeedstudio.com/STS3215-30KG-Serial-Servo-p-6340.html) |
| control | Main computer | Raspberry Pi 5 8 GB | 1 | 175.00 | 175.00 | V | [link](https://www.pishop.us/product/raspberry-pi-5-8gb/) |
| control | Pi cooling | Raspberry Pi Active Cooler (SC1148) | 1 | 10.95 | 10.95 | V | [link](https://www.pishop.us/product/raspberry-pi-active-cooler/) |
| power | 24 V mains supply (third OR input) | Mean Well LRS-350-24 | 1 | 31.40 | 31.40 | L | [link](https://punchouttest.digikey.com.mx/en/products/detail/mean-well-usa-inc/LRS-350-24/7705034) |
| power | Custom PDB: ideal-diode controller (one per OR input) | TI LM74700QDBVRQ1 | 3 | 1.89 | 5.67 | L | [link](https://punchouttest.digikey.com.mx/en/products/detail/texas-instruments/LM74700QDBVRQ1/10434692) |
| power | Custom PDB: N-channel MOSFETs for the ideal diodes | TBD | 3 | n/a | TBD | E | - |
| power | Custom PDB: eFuse per output branch | TI TPS25982 (TPS259824ONRGET, 24-VQFN 4x4) | 2 | 3.82 | 7.64 | L | [link](https://punchouttest.digikey.com.mx/en/products/detail/texas-instruments/TPS259824ONRGET/10273222) |
| power | Custom PDB: current/voltage monitor (one per input) | TI INA226AIDGSR | 3 | 2.66 | 7.98 | L | [link](https://punchouttest.digikey.com.mx/en/products/detail/texas-instruments/INA226AIDGSR/2687236) |
| power | Custom PDB: JLCPCB 2-layer 100x100 mm, 5 pcs, economic PCBA (lot) | JLCPCB | 1 | 38.00 | 38.00 | E | [link](https://jlcpcb.com/help/article/pcb-assembly-price) |
| | **Subtotal** | | | | **1708.82** | | |

## Over the cap: cheapest swaps

Every swap price below is a real listing from this session (see the JSON alternates, qty 0) or a line already in the BOM. Nothing is dropped from the files; the swaps are proposals for Mark.

**Shared swaps (help every tier), -$39.54:**

| Swap | Saves |
|---|---:|
| 24 in pine round ($52.04) -> Falken 3/4 in 2x2 ft birch panel, cut round in-house ($29.49) | 22.55 |
| Drop the separate bandana: the TiaoBug vest set already includes one | 6.99 |
| Pololu D36V50F5 ($39.95) -> Pololu D24V50F5 5 V 5 A, 38 V max in ($29.95) | 10.00 |

**Tier A** is $904.33 as specced, over by **$404.33**. The shared set alone is $423.94 (base $108, power and safety $229, costume $72), which leaves $76 for 8 servos that cost $170. Cheapest swaps that keep the scope:

| Swap | Saves |
|---|---:|
| Shared swaps above | 39.54 |
| Polymaker PETG ($21.99) -> ELEGOO PETG PRO ($13.99), x3 | 24.00 |
| Print the 20T/40T GT2 pulleys onto the included metal horns; drop the ServoCity REX servo shafts and pulleys (keep the belts, shafts and bearings) | 57.94 |
| Print the servo brackets; drop the 2 aluminium bracket packs | 21.98 |
| **Result** | **$760.87, still over by $260.87** |

Scope or accounting levers that would close the rest (Mark's call, in this order): take plywood, PETG and fastener kits from shop stock (-$129.19 -> $631.68); count the costume outside the cap (-$64.62 -> $567.06); drop the shoulder-out pair, 3 servos per arm (-$48.00 -> $519.06); power the head from its existing supply instead of a third DROK buck (-$10.20 -> $508.86); buy short 12 AWG and 18 AWG kits instead of the 20 ft and 50 ft spools (saves part of the $73.51 wire spend; a cheaper priced listing was not found). **Conclusion: tier A under $500 is not reachable with the full shared base, safety and power set unless shop stock and the costume are outside the cap.**

**Tier B** is $1,603.24, over by **$403.24**. The 6 STS3250 at $97 are $582 (and that price is weak: a search snippet for a backordered listing). Cheapest swap:

| Swap | Saves |
|---|---:|
| All 6 STS3250 -> STS3215-C047 12 V 30 kg·cm ($22, Seeed, verified), each on a 22T:60T GT2 stage (2.73:1): -$450.00, plus 4 more Phidgets belt sets (22T $2.75 + 60T $3.00 + belt $1.50 + bearing pair $4.00) for shoulder-out and elbow, +$45.00 | 405.00 |
| **Result** | **$1,198.24, under by $1.76** |
| Plus the shared swaps | **$1,158.70, under by $41.30** |

Trade-off: through 2.73:1 the STS3215 gives about 82 kg·cm stall and 27 kg·cm rated at the joint (from 30 / 10 kg·cm at 12 V), above the 48 kg·cm static shoulder estimate only with the spring counterbalance, and the joints run 2.73x slower. Keeping the STS3250 on shoulder flex only (swap 4) comes to $1,308.70 with the shared swaps, still over by $108.70. Re-price the STS3250 from Feetech's own AliExpress store or Partabot before deciding: at about $43 each the mixed build would fit.

**Tier C** is $2,132.76, inside the $3,000-3,500 aim. Applying the tier B servo swap here too would bring it to $1,727.76.

## Key findings

- **M18 over-discharge: assume the pack does not cut itself off behind a plain adapter.** Milwaukee lists "Discharge Protection" and per-cell monitoring as battery features but does not say the pack disconnects itself without a tool ([Milwaukee](https://www.milwaukeetool.com/products/details/m18-redlithium-compact-battery-two-pack/48-11-1811)). The Power Tool Institute says protection electronics are not all inside the pack and that an adapter "may not allow it to appropriately protect the battery during discharge" ([PTI](https://www.powertoolinstitute.com/?p=376)). Adapter makers warn about it or add their own cutoff ([PartsBuilt](https://www.partsbuilt.com/battery-adapter-with-low-voltage-protection-milwaukee-dewalt-compatible)). So the shared BOM keeps the XH-M609 cutoff, set to about 15.0-16.0 V (TBD from the cell datasheet). Its 20 A relay switches the main relay coil, not the actuator current.
- **M18 reference packs:** HIGH OUTPUT HD12.0 (48-11-1812): 18 V, 12.0 Ah; XC8.0 (48-11-1880): 18 V, 8.0 Ah. These figures come from retailer pages because the spec table on milwaukeetool.com did not load (the site lists both as no longer available). 216 Wh and 144 Wh are 18 V x Ah, not Milwaukee figures.
- **E-stop relay coil:** TEMCo 40 A relay with a 24 V coil. Whether it pulls in at 15 V is not published: bench-test before committing. A 12 V coil would be overdriven at 21 V (1.75x).
- **INA226 vs INA228:** the shared line is the Adafruit INA228 ($14.95, 85 V, verified). Generic INA226 boards are about $2-4 street price (no US vendor price confirmed) and use a 0.1 ohm shunt that reads only to about 0.8 A. Either part needs an external shunt to read the full actuator current.
- **STS3215 12 V variant:** C018 and C047 are both the 12 V, 30 kg·cm, 1:345 part; no Feetech page distinguishing them was found. The 7.4 V parts are C001 (1/345), C044 (1/191) and C046 (1/147).
- **AmazingHand** ([repo](https://github.com/pollen-robotics/AmazingHand), [Seeed wiki](https://wiki.seeedstudio.com/hand_amazinghand/)): 8 Feetech SCS0009 per hand (4 fingers x 2 DOF, all in the palm), 400 g; Pollen's published BOM is EUR 116.89 / $135.59 for the mechanics, $148.80 with the Waveshare driver; Feetech SCS bus from a Waveshare driver (Python on a Pi) or an Arduino with the TTL Linker; external 5 V / 2 A per hand; software Apache 2.0, CAD CC BY 4.0; grip force not published. Seeed sells kits at $99 per hand (kit contents not listed by Seeed: confirm).
- **Hand comparison:** LEAP Hand, 16 Dynamixel XC330, about $1,797 per hand from ROBOTIS, CAD CC BY-NC-SA (non-commercial). InMoov hand, 5 tendon fingers with servos in the forearm, no current cost found. Inspire RH56DFX from about $5,783 per hand (reseller). **Recommended: AmazingHand.** It already has 4 fingers, keeps its actuators in the palm and costs about 1/18 of a LEAP hand.

## Alternates and risks

- **Price confidence:** Amazon, Home Depot, Walmart and Newegg hid prices from fetch, so most of their prices are search snippets (L). The DigiKey IC prices come from a DigiKey mirror. The concrete price is from a tracker last updated May 2025. Re-check before ordering.
- **Tier A servo rail:** the DS3235 is 5-7.4 V (32 kg·cm at 6 V, 35 at 7.4 V), so a 6.0-6.8 V rail gives about 32-33 kg·cm. Worst-case arm stall is about 19.4 A, so the BOM uses one DROK 10 A buck per arm rather than one 20 A module (generic 20 A modules are 15 A continuous), plus one for the head (its load is TBD).
- **Tier A springs:** the $4.99 Harbor Freight assortment has no published rates and is likely too light for 20-40 N. Size real springs once CAD gives arm mass and centre of mass.
- **Tier B 12 V bucks:** 2 EKYLIN 15-40 V to 12 V 20 A modules, one per arm, since all 14 servos stalling at once draw about 47 A. Whether they hold 12 V at 15 V input is unknown; this matters at the end of a pack. They also take 24 V, which suits tier C.
- **Ideal-diode modules:** no ready-made dual-input LM74700 or LM5050 board rated 20 A or more was found. The BOM uses single-channel 40 A modules (controller IC not named) with their outputs tied.
- **M18 adapter fuse:** its 30 A fuse is above its leads' 18-20 A rating. Fuse lower downstream.
- **Tier B extrusion:** 10 x 500 mm instead of 8 (a 350 x 250 x 450 box has 12 edges, about 4.2 m). Maker Store shows one price range per product, so the extrusion, T-nut and screw lines are marked E.
- **Tier C hand bus:** the Waveshare Bus Servo Adapter (A) page states 9-12.6 V input, which conflicts with 5 V SCS0009 use; Pollen's BOM uses a Waveshare driver at 5 V. Confirm before relying on it. Never share a bus with the 12 V STS servos.
- **Tier C power ICs:** the TPS25982 tops out at 24 V recommended (30 V absolute max), so use it on the 12 V branches only; TI points to the pin-compatible TPS25983 (26 V, 20 A, not priced). The JLCPCB $38 is an estimate (5 boards, economic assembly, about 120 joints and 5 extended parts) that excludes components, shipping and 2 oz copper.
- **Raspberry Pi 5 8 GB:** $175 at PiShop (it has risen from $80 at launch; $175 since April 2026); Adafruit shows $200. The Active Cooler is $10.95, not the old $5.

## Gaps (could not find)

- STS3250: no Feetech-official or US-authorised price; $97 is a search snippet for a backordered listing.
- Custom PDB MOSFETs: part not chosen, price null.
- INA226 board from a US vendor; SCS0009 sold singly in the US.
- Fuse block voltage and current rating; XT60 current rating; relay coil current and minimum pull-in voltage; the cutoff module's standby drain.
- Exact contents of the Seeed AmazingHand kit; grip force for any of the open hands.
- Current InMoov hand cost; TPS25983 price; JLCPCB shipping.
- DSSERVO's own store has no prices; DS3225MG dimensions are missing and its torque figures conflict between sellers.
