MarkDannemiller/JackOLantern/(list of files, cad)

Other CAD files:
inbox/vendor-cad/amazinghand-finger-frame-1.step
protoboard/parts/catalog/towerpro-sg90/artifacts/cad/towerpro-sg90.step
protoboard/parts/local/mech/bearing-624-2rs/body.step
protoboard/parts/local/mech/bearing-625-2rs/body.step
protoboard/parts/local/mech/bearing-6806-2rs/body.step
protoboard/parts/local/mech/brac-90cast-20/body.step
protoboard/parts/local/mech/bucket-5gal/body.step
protoboard/parts/local/mech/concrete-fill/body.step
protoboard/parts/local/mech/dowel-5x16/body.step
protoboard/parts/local/mech/dyneema-2mm-260/body.step
protoboard/parts/local/mech/floor-flange-1in/body.step
protoboard/parts/local/mech/gt3-belt-210-9mm/body.step
protoboard/parts/local/mech/gt3-belt-240-9mm/body.step
protoboard/parts/local/mech/hfs5-2020-100-rail-y-bc--rail_y_top_l/body.step
protoboard/parts/local/mech/hfs5-2020-100-rail-y/body.step
protoboard/parts/local/mech/hfs5-2020-102-neck-post-bc--neck_post_f/body.step
protoboard/parts/local/mech/hfs5-2020-102-neck-post/body.step
protoboard/parts/local/mech/hfs5-2020-180-rail-x-bc--rail_x_bot_f/body.step
protoboard/parts/local/mech/hfs5-2020-180-rail-x-bc--rail_x_top_f/body.step
protoboard/parts/local/mech/hfs5-2020-180-rail-x/body.step
protoboard/parts/local/mech/hfs5-2020-190-balancer-column/body.step
protoboard/parts/local/mech/hfs5-2020-340-upright-bc--upright_rb/body.step
protoboard/parts/local/mech/hfs5-2020-340-upright/body.step
protoboard/parts/local/mech/hw/heatset-insert-m3/out/body.step
protoboard/parts/local/mech/hw/heatset-insert-m4/out/body.step
protoboard/parts/local/mech/hw/nylock-1-4-20/out/body.step
protoboard/parts/local/mech/hw/pa2x6/out/body.step
protoboard/parts/local/mech/hw/pa2x8/out/body.step
protoboard/parts/local/mech/hw/tnut-2020-m5/out/body.step
protoboard/parts/local/mech/jj-body-bus/body.step
protoboard/parts/local/mech/jj-body-dock/body.step
protoboard/parts/local/mech/jj-body-drok/body.step
protoboard/parts/local/mech/jj-body-ekylin/body.step
protoboard/parts/local/mech/jj-body-estop/body.step
protoboard/parts/local/mech/jj-body-fuse_inline/body.step
protoboard/parts/local/mech/jj-body-fuses/body.step
protoboard/parts/local/mech/jj-body-ideal_diode/body.step
protoboard/parts/local/mech/jj-body-lvc/body.step
protoboard/parts/local/mech/jj-body-monitor/body.step
protoboard/parts/local/mech/jj-body-pack/body.step
protoboard/parts/local/mech/jj-body-pca/body.step
protoboard/parts/local/mech/jj-body-pi5/body.step
protoboard/parts/local/mech/jj-body-pololu/body.step
protoboard/parts/local/mech/jj-body-relay/body.step
protoboard/parts/local/mech/pipe-nipple-1x30/body.step
protoboard/parts/local/mech/pollen-amazinghand-l/body.step
protoboard/parts/local/mech/pollen-amazinghand-r/body.step
protoboard/parts/local/mech/servo-ds3235/body.step
protoboard/parts/local/mech/servo-sts3215/body.step
protoboard/parts/local/mech/servo-sts3250/body.step
protoboard/parts/local/mech/spring-century-90cs/body.step
protoboard/parts/local/mech/spring-to5220rcs/body.step
protoboard/src/mech/parts/jj-arm-elbow-housing-a/body.step
protoboard/src/mech/parts/jj-arm-elbow-housing/body.step
protoboard/src/mech/parts/jj-arm-fore-body-a/body.step
protoboard/src/mech/parts/jj-arm-fore-body/body.step
protoboard/src/mech/parts/jj-arm-fore-fork-in-a/body.step
protoboard/src/mech/parts/jj-arm-fore-fork-in/body.step
protoboard/src/mech/parts/jj-arm-fore-fork-out-a/body.step
protoboard/src/mech/parts/jj-arm-fore-fork-out/body.step
protoboard/src/mech/parts/jj-arm-j1-bal-anchor-a/body.step
protoboard/src/mech/parts/jj-arm-j1-bal-anchor/body.step
protoboard/src/mech/parts/jj-arm-j1-bal-equalizer-a/body.step
protoboard/src/mech/parts/jj-arm-j1-bal-equalizer/body.step
protoboard/src/mech/parts/jj-arm-j1-bal-lever-a/body.step
protoboard/src/mech/parts/jj-arm-j1-bal-lever/body.step
protoboard/src/mech/parts/jj-arm-j1-bal-post-a/body.step
protoboard/src/mech/parts/jj-arm-j1-bal-post/body.step
protoboard/src/mech/parts/jj-arm-j1-bal-spool-a/body.step
protoboard/src/mech/parts/jj-arm-j1-bal-spool/body.step
protoboard/src/mech/parts/jj-arm-j1-housing-a/body.step
protoboard/src/mech/parts/jj-arm-j1-housing/body.step
protoboard/src/mech/parts/jj-arm-upper-head-a/body.step
protoboard/src/mech/parts/jj-arm-upper-head/body.step
protoboard/src/mech/parts/jj-arm-yoke-a/body.step
protoboard/src/mech/parts/jj-arm-yoke/body.step
protoboard/src/mech/parts/jj-base-skirt/body.step
protoboard/src/mech/parts/jj-cable-sheave-22/body.step
protoboard/src/mech/parts/jj-cap-48t/body.step
protoboard/src/mech/parts/jj-cap-60t/body.step
protoboard/src/mech/parts/jj-electronics-board-a/body.step
protoboard/src/mech/parts/jj-electronics-board-b/body.step
protoboard/src/mech/parts/jj-electronics-board-c/body.step
protoboard/src/mech/parts/jj-estop-bracket-a/body.step
protoboard/src/mech/parts/jj-estop-bracket-bc/body.step
protoboard/src/mech/parts/jj-hand-b-fingers-l/body.step
protoboard/src/mech/parts/jj-hand-b-fingers/body.step
protoboard/src/mech/parts/jj-hand-b-palm-l/body.step
protoboard/src/mech/parts/jj-hand-b-palm/body.step
protoboard/src/mech/parts/jj-hand-b-thumb-l/body.step
protoboard/src/mech/parts/jj-hand-b-thumb/body.step
protoboard/src/mech/parts/jj-hand-c-adapter-l/body.step
protoboard/src/mech/parts/jj-hand-c-adapter/body.step
protoboard/src/mech/parts/jj-hub-48t-gt3/body.step
protoboard/src/mech/parts/jj-hub-60t-gt3/body.step
protoboard/src/mech/parts/jj-mitt-a-paddle-l/body.step
protoboard/src/mech/parts/jj-mitt-a-paddle/body.step
protoboard/src/mech/parts/jj-mitt-a-palm-l/body.step
protoboard/src/mech/parts/jj-mitt-a-palm/body.step
protoboard/src/mech/parts/jj-neck-plate/body.step
protoboard/src/mech/parts/jj-pulley-16t-gt3-horn/body.step
protoboard/src/mech/parts/jj-pulley-20t-gt3-horn/body.step
protoboard/src/mech/parts/jj-torso-a-bottom/body.step
protoboard/src/mech/parts/jj-torso-a-side-l/body.step
protoboard/src/mech/parts/jj-torso-a-side-r/body.step
protoboard/src/mech/parts/jj-torso-a-top/body.step
protoboard/src/mech/parts/jj-torso-base-plate/body.step
protoboard/src/mech/parts/jj-tray-bus/body.step
protoboard/src/mech/parts/jj-tray-drok/body.step
protoboard/src/mech/parts/jj-tray-ekylin/body.step
protoboard/src/mech/parts/jj-tray-fuse_inline/body.step
protoboard/src/mech/parts/jj-tray-fuses/body.step
protoboard/src/mech/parts/jj-tray-ideal_diode/body.step
protoboard/src/mech/parts/jj-tray-lvc/body.step
protoboard/src/mech/parts/jj-tray-monitor/body.step
protoboard/src/mech/parts/jj-tray-pca/body.step
protoboard/src/mech/parts/jj-tray-pi5/body.step
protoboard/src/mech/parts/jj-tray-pololu/body.step
protoboard/src/mech/parts/jj-tray-relay/body.step
protoboard/src/mech/parts/jj-twist-horn-disc/body.step
protoboard/src/mech/parts/jj-twist-hub/body.step
protoboard/src/mech/parts/jj-wrist-c-block-l/body.step
protoboard/src/mech/parts/jj-wrist-c-block/body.step
protoboard/src/mech/parts/jj-wrist-c-fork-in-l/body.step
protoboard/src/mech/parts/jj-wrist-c-fork-in/body.step
protoboard/src/mech/parts/jj-wrist-c-fork-out-l/body.step
protoboard/src/mech/parts/jj-wrist-c-fork-out/body.step
inbox/vendor-cad/amazinghand-link.step
inbox/vendor-cad/amazinghand-finger-frame-2.step
inbox/vendor-cad/amazinghand-r-wrist-interface.step
inbox/vendor-cad/amazinghand-proximal-shell.step
inbox/vendor-cad/amazinghand-distal.step
inbox/vendor-cad/amazinghand-r-top-shell.step
inbox/vendor-cad/amazinghand-r-palm-shell.step
inbox/vendor-cad/amazinghand-gimbal.step
inbox/vendor-cad/amazinghand-r-hand-plate.step
inbox/vendor-cad/amazinghand-distal-shell.step
inbox/vendor-cad/amazinghand-proximal.step
inbox/20261024-facade.f3z
inbox/20261024-facade.stp
inbox/20261024-head-assembly.f3z
inbox/20261024-head-assembly.stp
protoboard/parts/local/mech/hw/hex-bolt-1-4-20x1.25in/out/body.step
protoboard/parts/local/mech/hw/hex-bolt-1-4-20x1in/out/body.step
protoboard/parts/local/mech/hw/iso10511-m4/out/body.step
protoboard/parts/local/mech/hw/iso10511-m5/out/body.step
protoboard/parts/local/mech/hw/iso4762-m3x12/out/body.step
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
