MarkDannemiller/JackOLantern/protoboard/docs/wiring/harness-a.md

# Wiring harness, tier A (generated by cad/mech/harness.py; do not edit)

21 cables. Lengths are cut lengths from the assembled model (rules at the end).

| Cable | From | To | Conductors | AWG | Ends | Cut (mm) | Note |
|---|---|---|---|---|---|---:|---|
| dock-lvc | dock:lead_plus | lvc:vin | +, - | 12 | XT60 / ferrules | 450 | pack trunk, 30 A dock fuse; return paired from dock |
| lvc-fuse-pi | lvc:vout | fuse_pi:vin | + | 18 | ferrules / USB-C pigtail | 290 | 5 V computer feeds |
| lvc-estop | lvc:vout | estop:vin | + | 20 | ferrules / 6.3 mm spade | 290 | E-stop chain (relay coil) |
| estop-fuse-head | estop:vout | fuse_head:vin | + | 16 | ferrules / servo header | 440 | head and hand servo rails |
| estop-fuse-arm | estop:vout | fuse_arm:vin | + | 14 | ring terminal / 6.3 mm spade / ferrules | 500 | actuator feeds |
| fuse-buck-pi | fuse_pi:vout | buck_pi:vin | +, - | 18 | ferrules / USB-C pigtail | 390 | 5 V computer feeds; return paired from dock |
| fuse-buck-head | fuse_head:vout | buck_head:vin | +, - | 16 | ferrules / servo header | 260 | head and hand servo rails; return paired from dock |
| fuse-buck-arm | fuse_arm:vout | buck_arm:vin | +, - | 14 | ring terminal / 6.3 mm spade / ferrules | 220 | actuator feeds; return paired from dock |
| pi-5v | buck_pi:vout | head:pi_5v_in | +, - | 18 | ferrules / USB-C pigtail | 380 | 5 V computer feeds; return paired from dock |
| head-servo-rail | buck_head:vout | head:servo_vplus_in | +, - | 16 | ferrules / servo header | 460 | head and hand servo rails; return paired from dock |
| arm-rail | buck_arm:vout | arm_driver:vplus_in | +, - | 14 | ring terminal / 6.3 mm spade / ferrules | 190 | actuator feeds; return paired from head |
| arm-driver-i2c | head:i2c | arm_driver:i2c | i2c | 26 | STEMMA QT / JST-SH 4-pin | 480 | I2C |
| arm-driver-logic | head:logic_3v3 | arm_driver:vcc | +, - | 18 | ferrules | 480 | other power; return paired from head |
| ch0 | arm_driver:ch0 | arm_r:shoulder_flex_servo | signal, V+, GND | 22 | 3-pin 0.1 in servo plug (extension lead) | 630 | hobby servo signal + power |
| ch1 | arm_driver:ch1 | arm_r:shoulder_out_servo | signal, V+, GND | 22 | 3-pin 0.1 in servo plug (extension lead) | 700 | hobby servo signal + power |
| ch2 | arm_driver:ch2 | arm_r:elbow_servo | signal, V+, GND | 22 | 3-pin 0.1 in servo plug (extension lead) | 780 | hobby servo signal + power |
| ch3 | arm_driver:ch3 | arm_r:grip_servo | signal, V+, GND | 22 | 3-pin 0.1 in servo plug (extension lead) | 1070 | hobby servo signal + power |
| ch4 | arm_driver:ch4 | arm_l:shoulder_flex_servo | signal, V+, GND | 22 | 3-pin 0.1 in servo plug (extension lead) | 540 | hobby servo signal + power |
| ch5 | arm_driver:ch5 | arm_l:shoulder_out_servo | signal, V+, GND | 22 | 3-pin 0.1 in servo plug (extension lead) | 710 | hobby servo signal + power |
| ch6 | arm_driver:ch6 | arm_l:elbow_servo | signal, V+, GND | 22 | 3-pin 0.1 in servo plug (extension lead) | 780 | hobby servo signal + power |
| ch7 | arm_driver:ch7 | arm_l:grip_servo | signal, V+, GND | 22 | 3-pin 0.1 in servo plug (extension lead) | 1070 | hobby servo signal + power |

## Wire to buy (red and black counted separately)

| AWG | Total (m) |
|---|---:|
| 12 | 0.9 |
| 14 | 1.3 |
| 16 | 1.9 |
| 18 | 2.8 |
| 20 | 0.3 |
| 22 | 6.3 |
| 26 | 0.5 |

## Rules

* a supply and its return travel in one cable (a ground link pairs with the supply link to the same part)
  * the Feetech serial bus is daisy-chained along each arm in joint order, through the hollow joint hubs; the
    model draws it as a star from the adapter (each servo linked to the adapter), the build chains it
  * cut length = path between the ends (sum of the x, y and z offsets, routed along the frame) x 1.1, plus
    80 mm for terminations and service loops, plus 120 mm at every arm joint a cable crosses; rounded up to 10 mm
  * gauge from the current the branch can carry (fuse or regulator rating): 12 AWG for the pack trunk (30 A
    fuse), 14 AWG for the 12 V arm feeds (20 A converters), 16 AWG for the head servo rail (DROK, 10 A),
    18 AWG for 5 V logic feeds, 20 AWG for the E-stop chain, 26 AWG signals; ampacity per the silicone-wire
    sellers' tables cited in research/sourcing (assumption: short runs inside the torso, 200 C silicone)
