MarkDannemiller/JackOLantern/protoboard/docs/wiring/harness-c.md

# Wiring harness, tier C (generated by cad/mech/harness.py; do not edit)

43 cables. Lengths are cut lengths from the assembled model (rules at the end).

| Cable | From | To | Conductors | AWG | Ends | Cut (mm) | Note |
|---|---|---|---|---|---|---:|---|
| arm-r-bus-1 | arm_r/bus_adapter | arm_r/shoulder_flex | signal, V+ 12 V, GND | - | Molex 5264 3-pin both ends (Feetech servo cable) | 650 | daisy chain from the bus adapter; through 0 joint hub(s) |
| arm-r-bus-2 | arm_r/shoulder_flex | arm_r/shoulder_out | signal, V+ 12 V, GND | - | Molex 5264 3-pin both ends (Feetech servo cable) | 410 | daisy chain from the previous servo; through 1 joint hub(s) |
| arm-r-bus-3 | arm_r/shoulder_out | arm_r/upper_twist | signal, V+ 12 V, GND | - | Molex 5264 3-pin both ends (Feetech servo cable) | 300 | daisy chain from the previous servo; through 1 joint hub(s) |
| arm-r-bus-4 | arm_r/upper_twist | arm_r/elbow | signal, V+ 12 V, GND | - | Molex 5264 3-pin both ends (Feetech servo cable) | 280 | daisy chain from the previous servo; through 1 joint hub(s) |
| arm-r-bus-5 | arm_r/elbow | arm_r/wrist_twist | signal, V+ 12 V, GND | - | Molex 5264 3-pin both ends (Feetech servo cable) | 480 | daisy chain from the previous servo; through 1 joint hub(s) |
| arm-r-bus-6 | arm_r/wrist_twist | arm_r/wrist_pitch | signal, V+ 12 V, GND | - | Molex 5264 3-pin both ends (Feetech servo cable) | 310 | daisy chain from the previous servo; through 1 joint hub(s) |
| arm-l-bus-1 | arm_l/bus_adapter | arm_l/shoulder_flex | signal, V+ 12 V, GND | - | Molex 5264 3-pin both ends (Feetech servo cable) | 560 | daisy chain from the bus adapter; through 0 joint hub(s) |
| arm-l-bus-2 | arm_l/shoulder_flex | arm_l/shoulder_out | signal, V+ 12 V, GND | - | Molex 5264 3-pin both ends (Feetech servo cable) | 410 | daisy chain from the previous servo; through 1 joint hub(s) |
| arm-l-bus-3 | arm_l/shoulder_out | arm_l/upper_twist | signal, V+ 12 V, GND | - | Molex 5264 3-pin both ends (Feetech servo cable) | 300 | daisy chain from the previous servo; through 1 joint hub(s) |
| arm-l-bus-4 | arm_l/upper_twist | arm_l/elbow | signal, V+ 12 V, GND | - | Molex 5264 3-pin both ends (Feetech servo cable) | 280 | daisy chain from the previous servo; through 1 joint hub(s) |
| arm-l-bus-5 | arm_l/elbow | arm_l/wrist_twist | signal, V+ 12 V, GND | - | Molex 5264 3-pin both ends (Feetech servo cable) | 480 | daisy chain from the previous servo; through 1 joint hub(s) |
| arm-l-bus-6 | arm_l/wrist_twist | arm_l/wrist_pitch | signal, V+ 12 V, GND | - | Molex 5264 3-pin both ends (Feetech servo cable) | 310 | daisy chain from the previous servo; through 1 joint hub(s) |
| dock1-or | dock_1:lead_plus | or_1:vin | +, - | 12 | XT60 / ferrules | 440 | pack trunk, 30 A dock fuse; return paired from dock_1 |
| dock2-or | dock_2:lead_plus | or_2:vin | +, - | 12 | XT60 / ferrules | 480 | pack trunk, 30 A dock fuse; return paired from dock_1 |
| or1-bus | or_1:vout | monitor:shunt_in | +, - | 12 | XT60 / ferrules | 220 | pack trunk, 30 A dock fuse; return paired from dock_1 |
| or2-bus | or_2:vout | monitor:shunt_in | +, - | 12 | XT60 / ferrules | 150 | pack trunk, 30 A dock fuse; return paired from dock_1 |
| monitor-lvc | monitor:shunt_out | lvc:vin | +, - | 12 | XT60 / ferrules | 270 | pack trunk, 30 A dock fuse; return paired from dock_1 |
| lvc-fuses | lvc:vout | fuses:feed | +, - | 12 | XT60 / ferrules | 180 | pack trunk, 30 A dock fuse; return paired from dock_1 |
| act-relay | fuses:out1 | relay:contact_30 | +, - | 14 | ring terminal / 6.3 mm spade / ferrules | 170 | actuator feeds; return paired from dock_1 |
| estop-feed | fuses:out3 | estop:vin | + | 20 | ferrules / 6.3 mm spade | 320 | E-stop chain (relay coil) |
| estop-coil | estop:vout | relay:coil_86 | +, - | 20 | ferrules / 6.3 mm spade | 300 | E-stop chain (relay coil); return paired from dock_1 |
| relay-arm-r | relay:contact_87 | buck_arm_r:vin | +, - | 14 | ring terminal / 6.3 mm spade / ferrules | 380 | actuator feeds; return paired from dock_1 |
| relay-arm-l | relay:contact_87 | buck_arm_l:vin | +, - | 14 | ring terminal / 6.3 mm spade / ferrules | 280 | actuator feeds; return paired from dock_1 |
| relay-head | relay:contact_87 | buck_head:vin | +, - | 14 | ring terminal / 6.3 mm spade / ferrules | 320 | actuator feeds; return paired from dock_1 |
| pi-feed | fuses:out2 | buck_pi:vin | +, - | 18 | ferrules / USB-C pigtail | 160 | 5 V computer feeds; return paired from dock_1 |
| mains-or | mains:v24 | or_3:vin | +, - | 12 | XT60 / ferrules | TBD | pack trunk, 30 A dock fuse; return paired from dock_1 |
| or3-bus | or_3:vout | monitor:shunt_in | +, - | 12 | XT60 / ferrules | 130 | pack trunk, 30 A dock fuse; return paired from dock_1 |
| pi-5v | buck_pi:vout | head:pi_5v_in | +, - | 18 | ferrules / USB-C pigtail | 460 | 5 V computer feeds; return paired from dock_1 |
| head-servo-rail | buck_head:vout | head:servo_vplus_in | +, - | 16 | ferrules / servo header | 490 | head and hand servo rails; return paired from dock_1 |
| monitor-i2c | head:i2c | monitor:i2c | i2c | 26 | STEMMA QT / JST-SH 4-pin | 370 | I2C |
| monitor-logic | head:logic_3v3 | monitor:vin | +, - | 18 | ferrules | 370 | other power; return paired from dock_1 |
| pi5-feed | fuses:out4 | buck_pi5:vin | +, - | 18 | ferrules / USB-C pigtail | 160 | 5 V computer feeds; return paired from dock_1 |
| pi5-5v | buck_pi5:vout | pi5:usb_c_power | + | 18 | ferrules / USB-C pigtail | TBD | 5 V computer feeds |
| hand-r-feed | relay:contact_87 | buck_hand_r:vin | +, - | 18 | ferrules | 270 | other power; return paired from dock_1 |
| hand-l-feed | relay:contact_87 | buck_hand_l:vin | +, - | 18 | ferrules | 330 | other power; return paired from dock_1 |
| hand-r-5v | buck_hand_r:vout | arm_r:hand_5v | +, - | 18 | ferrules | 890 | other power; return paired from dock_1 |
| hand-l-5v | buck_hand_l:vout | arm_l:hand_5v | +, - | 18 | ferrules | 870 | other power; return paired from dock_1 |
| arm-r-12v | buck_arm_r:vout | arm_r:power_in | +, - | 14 | ring terminal / 6.3 mm spade / ferrules | 170 | actuator feeds; return paired from dock_1 |
| arm-l-12v | buck_arm_l:vout | arm_l:power_in | +, - | 14 | ring terminal / 6.3 mm spade / ferrules | 170 | actuator feeds; return paired from dock_1 |
| arm-r-usb | pi5:usb2_0 | arm_r:usb | usb | - | USB-A to USB-C cable (bought) | TBD | USB |
| arm-l-usb | pi5:usb2_1 | arm_l:usb | usb | - | USB-A to USB-C cable (bought) | TBD | USB |
| hand-r-usb | pi5:usb3_0 | arm_r:hand_usb | usb | - | USB-A to USB-C cable (bought) | TBD | USB |
| hand-l-usb | pi5:usb3_1 | arm_l:hand_usb | usb | - | USB-A to USB-C cable (bought) | TBD | USB |

## Wire to buy (red and black counted separately)

| AWG | Total (m) |
|---|---:|
| 12 | 3.7 |
| 14 | 3.0 |
| 16 | 1.0 |
| 18 | 7.0 |
| 20 | 0.9 |
| 26 | 0.4 |

## Rules

* a supply and its return travel in one cable (a ground link pairs with the supply link to the same part)
  * the Feetech serial bus is daisy-chained along each arm in joint order, through the hollow joint hubs; the
    model draws it as a star from the adapter (each servo linked to the adapter), the build chains it
  * cut length = path between the ends (sum of the x, y and z offsets, routed along the frame) x 1.1, plus
    80 mm for terminations and service loops, plus 120 mm at every arm joint a cable crosses; rounded up to 10 mm
  * gauge from the current the branch can carry (fuse or regulator rating): 12 AWG for the pack trunk (30 A
    fuse), 14 AWG for the 12 V arm feeds (20 A converters), 16 AWG for the head servo rail (DROK, 10 A),
    18 AWG for 5 V logic feeds, 20 AWG for the E-stop chain, 26 AWG signals; ampacity per the silicone-wire
    sellers' tables cited in research/sourcing (assumption: short runs inside the torso, 200 C silicone)
