MarkDannemiller/JackOLantern/protoboard/docs/joyful-jack-b-assembly-guide.html

Joyful Jack, Tier B, MidrangeAssembly guideJJ-B-AG

PR0TOBOARD · UHD

Rev A2026-10-24JJ-B-AG

Assembly guide

Joyful Jack, Tier B, Midrange

Pumpkin-head cowboy: the existing head plus two seven-actuator Feetech arms with glove hands, two hot-swappable M18 packs, battery monitoring and a relay E-stop.

Exploded along each joint's axis in fastener-stack order (229 mates, 588 hardware parts).

Exploded along each joint's axis in fastener-stack order (229 mates, 588 hardware parts).

Steps

42

mechanical and wiring

Mates

229

from assemble()

Hardware

588

screws, spacers, standoffs, nuts

Parts

789

104 BOM lines

## How this guide is made

Steps, parts and hardware come from the UHD model: mates and fastener stacks from assemble(), wiring from wiringChecklist. The coverage table at the end lists where every mate, fastener and wire appears.

A Assumption: the model marks this value as an assumption (assumption trait)D Derived: computed from model values; formula in the provenance appendix— Not in model: the model does not state this value (data gap)Unmarked values are cited from the part's sources (sources.json) or are design values of the model.

PR0TOBOARD · UHDGenerated from the UHD model of joyful-jack by @protoboardai/ext-docsJJ-B-AG · Rev A · 2026-10-24

PR0TOBOARD · UHDJJ-B-AG · Rev A · 2026-10-2401 / 116

Joyful Jack, Tier B, MidrangeAssembly guideJJ-B-AG

# 01Before you begin

## Contents

1. 01Before you begin02
2. 02Kit contents03
3. 03Hardware07
4. 04Build the base: skirt, bucket, flanges and mast13
5. 05Build the torso frame on the top flange (1 of 5)14
6. 06Build the torso frame on the top flange (2 of 5)16
7. 07Build the torso frame on the top flange (3 of 5)18
8. 08Build the torso frame on the top flange (4 of 5)20
9. 09Build the torso frame on the top flange (5 of 5)22
10. 10Fit the neck posts and the neck plate (1 of 2)23
11. 11Fit the neck posts and the neck plate (2 of 2)25
12. 12Fit the electronics board, its trays and the E-stop bracket (1 of 3)26
13. 13Fit the electronics board, its trays and the E-stop bracket (2 of 3)27
14. 14Fit the electronics board, its trays and the E-stop bracket (3 of 3)29
15. 15Put the power parts in their trays and bolt down the battery docks (1 of 2)30
16. 16Put the power parts in their trays and bolt down the battery docks (2 of 2)31
17. 17Right arm: shoulder housing, J1 servo, belt and springs (1 of 2)32
18. 18Right arm: shoulder housing, J1 servo, belt and springs (2 of 2)34
19. 19Right arm: yoke and upper arm (shoulder-out and twist joints) (1 of 3)36
20. 20Right arm: yoke and upper arm (shoulder-out and twist joints) (2 of 3)38
21. 21Right arm: yoke and upper arm (shoulder-out and twist joints) (3 of 3)40
22. 22Right arm: elbow housing and elbow drive (1 of 2)42
23. 23Right arm: elbow housing and elbow drive (2 of 2)43
24. 24Right arm: forearm and wrist-twist joint (1 of 2)45
25. 25Right arm: forearm and wrist-twist joint (2 of 2)47
26. 26Right arm: hand (1 of 2)48
27. 27Right arm: hand (2 of 2)49
28. 28Left arm: shoulder housing, J1 servo, belt and springs (1 of 2)50
29. 29Left arm: shoulder housing, J1 servo, belt and springs (2 of 2)52
30. 30Left arm: yoke and upper arm (shoulder-out and twist joints) (1 of 3)54
31. 31Left arm: yoke and upper arm (shoulder-out and twist joints) (2 of 3)56
32. 32Left arm: yoke and upper arm (shoulder-out and twist joints) (3 of 3)58
33. 33Left arm: elbow housing and elbow drive (1 of 2)60
34. 34Left arm: elbow housing and elbow drive (2 of 2)61
35. 35Left arm: forearm and wrist-twist joint (1 of 2)63
36. 36Left arm: forearm and wrist-twist joint (2 of 2)65
37. 37Left arm: hand (1 of 2)66
38. 38Left arm: hand (2 of 2)67
39. 39Mount the arms on the torso68
40. 40Fit the head on the neck plate69
41. 41Slide the battery packs onto the docks70
42. 42Wire the right arm: servo bus and power71
43. 43Wire the left arm: servo bus and power73
44. 44Wire the head: computer, servo rail and monitor bus75
45. 45Wire the power system: packs, docks, protection, fuses and converters77
46. 46Coverage79

## Tools

- 7 mm nut driver for M4 nyloc hex nut, ISO 10511
- 8 mm nut driver for M5 nyloc hex nut, ISO 10511
- 10 mm nut driver for M5 roll-in T-nut for 2020 extrusion
- 11.1 mm nut driver for 1/4-20 nylon-insert lock nut, zinc

Derived from the fasteners in the model: hex keys from each screw's stated socket or the ISO 4762 socket size for its thread, drivers and spanners from each nut's and standoff's across-flats.

## Reading the figures

Already assembled

Fitted in this step

Hardware for this step

Assembly axis

Parts are drawn exploded along each joint's axis in stacking order, from the model's fastener stacks and mate gaps.

NOTE Each step's torque line gives the tightening torque of the part turned, from the harness's fastener stack. 20 of them are assumptions (marked A): no frame, motor or DJI source states a torque, so they are derated from supplier tables for the screw grade into steel. Threadlocker is only advised where a harness says so (steel into aluminium).

PR0TOBOARD · UHDJJ-B-AG · Rev A · 2026-10-2402 / 116

Joyful Jack, Tier B, MidrangeAssembly guideJJ-B-AG

# 02Kit contentsdocs/joyful-jack-b-bom.json



×24

#4 x 0.5 in flat head wood screw

wood-screw-4x0.5in



×2

1 in floor flange, malleable iron (Anvil FIG 1190)

floor-flange-1in



×1

1 in x 30 in black steel pipe nipple (NPS, threaded both ends)

pipe-nipple-1x30



×8

1/4-20 nylon-insert lock nut, zinc

nylock-1-4-20



×4

1/4-20 x 1 in hex bolt, zinc

hex-bolt-1-4-20x1in



×4

1/4-20 x 1.25 in hex bolt, zinc

hex-bolt-1-4-20x1.25in



×1

2020 aluminium extrusion, 100 mm (rail-y), M5 tapped both ends

hfs5-2020-100-rail-y-bc--rail_y_top_r



×1

2020 aluminium extrusion, 100 mm (rail-y), M5 tapped both ends

hfs5-2020-100-rail-y-bc--rail_y_top_l



×1

2020 aluminium extrusion, 100 mm (rail-y), M5 tapped both ends

hfs5-2020-100-rail-y-bc--rail_y_bot_r



×1

2020 aluminium extrusion, 100 mm (rail-y), M5 tapped both ends

hfs5-2020-100-rail-y-bc--rail_y_bot_l



×1

2020 aluminium extrusion, 102 mm (neck-post), M5 tapped both ends

hfs5-2020-102-neck-post-bc--neck_post_f



×1

2020 aluminium extrusion, 102 mm (neck-post), M5 tapped both ends

hfs5-2020-102-neck-post-bc--neck_post_b



×1

2020 aluminium extrusion, 180 mm (rail-x), M5 tapped both ends

hfs5-2020-180-rail-x-bc--rail_x_top_f



×1

2020 aluminium extrusion, 180 mm (rail-x), M5 tapped both ends

hfs5-2020-180-rail-x-bc--rail_x_top_b



×1

2020 aluminium extrusion, 180 mm (rail-x), M5 tapped both ends

hfs5-2020-180-rail-x-bc--rail_x_bot_f



×1

2020 aluminium extrusion, 180 mm (rail-x), M5 tapped both ends

hfs5-2020-180-rail-x-bc--rail_x_bot_b



×1

2020 aluminium extrusion, 340 mm (upright), M5 tapped both ends

hfs5-2020-340-upright-bc--upright_rf



×1

2020 aluminium extrusion, 340 mm (upright), M5 tapped both ends

hfs5-2020-340-upright-bc--upright_rb



×1

2020 aluminium extrusion, 340 mm (upright), M5 tapped both ends

hfs5-2020-340-upright-bc--upright_lf



×1

2020 aluminium extrusion, 340 mm (upright), M5 tapped both ends

hfs5-2020-340-upright-bc--upright_lb



×6

5 mm x 16 mm hardened steel dowel pin (ISO 8734)

dowel-5x16



×1

5 US gal HDPE bucket (lid not used)

bucket-5gal



×1

6-way ATC fuse block with negative bus

fuse-block-6way



×6

625-2RS ball bearing (5 x 16 x 5 mm)

bearing-625-2rs



×20

6806-2RS ball bearing (30 x 42 x 7 mm)

bearing-6806-2rs

PR0TOBOARD · UHDJJ-B-AG · Rev A · 2026-10-2403 / 116

Joyful Jack, Tier B, MidrangeAssembly guideJJ-B-AG



×1

Adafruit INA228 power monitor (0x44)

adafruit-ina228



×1

Base skirt: 24 in round, 3/4 in birch plywood

jj-base-skirt



×2

Belt-joint bearing cap (48T housing)

jj-cap-48t



×4

Belt-joint bearing cap (60T housing)

jj-cap-60t



×2

Belt-joint hub with 48T GT3 pulley (hollow, 14 mm bore)

jj-hub-48t-gt3



×4

Belt-joint hub with 60T GT3 pulley (hollow, 14 mm bore)

jj-hub-60t-gt3



×20

Cast 90 deg corner bracket, 20 series (one M5 per leg)

brac-90cast-20



×8

Century Spring TO-5220RCS torsion spring (180 deg legs, right hand wind)

spring-to5220rcs



×1

Concrete fill, about 2 x 50 lb bags of quick-setting concrete

concrete-fill



×2

Driver pulley, 16T GT3, on the STS horn

jj-pulley-16t-gt3-horn



×4

Driver pulley, 20T GT3, on the STS horn

jj-pulley-20t-gt3-horn



×1

DROK 300 W adjustable buck (10 A)

drok-300w-buck



×4

DSSERVO DS3225MG 25 kg digital servo (270°)

dsservo-ds3225mg-270



×1

E-stop bracket (on the back of the shoulders)

jj-estop-bracket-bc



×2

EKYLIN 12 V 20 A buck

ekylin-12v-20a-buck



×2

Elbow housing (J4 drum and servo)

jj-arm-elbow-housing



×1

Electronics board, tier B: 6 mm birch plywood 180 x 290

jj-electronics-board-b



×1

Emergency stop, 22 mm, latching, NC

estop-22mm-nc



×14

Feetech STS3215 12 V serial bus servo

feetech-sts3215-c047



×2

Forearm body (J5 servo and twist bearings)

jj-arm-fore-body



×2

Forearm fork plate (inboard)

jj-arm-fore-fork-in



×2

Forearm fork plate (outboard)

jj-arm-fore-fork-out



×1

Glove fingers (four, on one servo)

jj-hand-b-fingers



×1

Glove fingers (four, on one servo) (left)

jj-hand-b-fingers-l



×1

Glove hand palm

jj-hand-b-palm

PR0TOBOARD · UHDJJ-B-AG · Rev A · 2026-10-2404 / 116

Joyful Jack, Tier B, MidrangeAssembly guideJJ-B-AG



×1

Glove hand palm (left)

jj-hand-b-palm-l



×1

Glove thumb

jj-hand-b-thumb



×1

Glove thumb (left)

jj-hand-b-thumb-l



×2

GT3 (3 mm pitch) closed belt, 210 mm (70 teeth), 9 mm wide

gt3-belt-210-9mm



×4

GT3 (3 mm pitch) closed belt, 240 mm (80 teeth), 9 mm wide

gt3-belt-240-9mm



×2

Ideal-diode module, 40 A

ideal-diode-40a



×2

J1 shoulder housing (on the torso)

jj-arm-j1-housing



×2

J1 spring arbor (on hub face B)

jj-arm-j1-spring-arbor



×2

J2 spring arbor (on the yoke's back fork arm)

jj-arm-j2-spring-arbor



×2

M18 battery adapter (switch, 30 A fuse, 12 AWG)

m18-power-wheel-adapter



×116

M3 brass heat-set insert (4.6 mm OD x 5.7 mm)

heatset-insert-m3



×72

M3 x 12 SHCS

iso4762-m3x12



×56

M3 x 14 SHCS

iso4762-m3x14



×12

M3 x 30 SHCS

iso4762-m3x30



×16

M3 x 6 SHCS

iso4762-m3x6



×32

M3 x 8 SHCS

iso4762-m3x8



×8

M4 flat washer, ISO 7089

iso7089-m4



×4

M4 nyloc hex nut, ISO 10511

iso10511-m4



×4

M4 x 20 SHCS

iso4762-m4x20



×4

M5 flat washer, ISO 7089

iso7089-m5



×4

M5 nyloc hex nut, ISO 10511

iso10511-m5



×49

M5 roll-in T-nut for 2020 extrusion

tnut-2020-m5



×41

M5 x 10 SHCS

iso4762-m5x10



×14

M5 x 12 SHCS

iso4762-m5x12



×4

M5 x 20 SHCS

iso4762-m5x20

PR0TOBOARD · UHDJJ-B-AG · Rev A · 2026-10-2405 / 116

Joyful Jack, Tier B, MidrangeAssembly guideJJ-B-AG



×2

Milwaukee M18 REDLITHIUM pack (owned)

milwaukee-m18-pack



×1

Neck plate, 6 mm 6061 aluminium

jj-neck-plate

no CAD

×1

Neck yaw home switch (model TBD)

yaw-home-switch

no CAD

×1

NEMA 17 pancake stepper (model TBD)

nema17-pancake-stepper

no CAD

×1

OV5647 IR-cut camera module

ov5647-ir-cut-camera



×32

PA2.0 x 6 pan head self-tapping screw (for plastic)

pa2x6



×80

PA2.0 x 8 pan head self-tapping screw (for plastic)

pa2x8

no CAD

×1

PCA9685 16-channel servo driver breakout (0x40)

pca9685-16ch-servo-driver



×1

Pololu D24V50F5 5 V 5 A buck

pololu-d24v50f5

no CAD

×1

Raspberry Pi 4 Model B

raspberry-pi-4-model-b



×2

Shoulder yoke

jj-arm-yoke

no CAD

×1

Step/dir stepper driver (model TBD)

stepper-driver-step-dir



×1

TEMCo 24 V 40 A relay (SPST-NO)

temco-relay-24v-40a



×1

Torso base plate, 6 mm 6061 aluminium, 220 x 140

jj-torso-base-plate



×6

TowerPro SG90 Micro Servo

towerpro-sg90



×1

Tray for the 6-way ATC fuse block with negative bus

jj-tray-fuses



×1

Tray for the Adafruit INA228 breakout

jj-tray-monitor



×1

Tray for the DROK 300 W buck converter

jj-tray-drok



×2

Tray for the EKYLIN 12 V 20 A buck converter

jj-tray-ekylin



×2

Tray for the Ideal diode module, 40 A

jj-tray-ideal_diode



×1

Tray for the Pololu D24V50F5 / D36V50F5 5 V regulator

jj-tray-pololu



×1

Tray for the Temco 24 V 40 A automotive relay

jj-tray-relay



×2

Tray for the Waveshare Bus Servo Adapter

jj-tray-bus



×1

Tray for the XH-M609 low-voltage cutoff

jj-tray-lvc



×4

Twist-joint horn disc

jj-twist-horn-disc



×4

Twist-joint hub (6806 pair)

jj-twist-hub



×2

Upper arm (J2 housing, J2 and J3 servos)

jj-arm-upper-head



×4

Waveshare Bus Servo Adapter (A)

waveshare-bus-servo-adapter-a



×1

XH-M609 low-voltage cutoff

xh-m609-lvc

Quantities from the generated BOM; drawings are the parts' CAD artifacts, not to scale.

PR0TOBOARD · UHDJJ-B-AG · Rev A · 2026-10-2406 / 116

Joyful Jack, Tier B, MidrangeAssembly guideJJ-B-AG

# 03Hardwarefastener stacks

Every screw, spacer, standoff and nut is placed by a harness's fastenerStack. The sections below are drawn from those positions and the mate gaps: one hole of each joint, to one scale, millimetres from the structure face.

Hardware by harness (continued)

Harness | Parts placed | Torque | Used in
4 x M5 x 20 socket head cap screw joint head_on_neck_plate | 4 × M5 flat washer, ISO 7089 4 × M5 nyloc hex nut, ISO 10511 4 × M5 x 20 SHCS | 2.5 N·mA M5 nyloc hex nut, ISO 10511 | Step 37
2 x M4 x 20 socket head cap screw ×2 joint dock_1_on_base, dock_2_on_base | 8 × M4 flat washer, ISO 7089 4 × M4 nyloc hex nut, ISO 10511 4 × M4 x 20 SHCS | 1.2 N·mA M4 nyloc hex nut, ISO 10511 | Step 13
2 x M5 x 12 socket head cap screw ×2 joint arm_r_foot, arm_l_foot | 4 × M5 roll-in T-nut for 2020 extrusion 4 × M5 x 12 SHCS | 2.5 N·mA M5 x 12 SHCS | Step 36
4 x 1/4-20 x 1.25 in hex bolt joint body/bucket_on_skirt | 4 × 1/4-20 x 1.25 in hex bolt, zinc 4 × 1/4-20 nylon-insert lock nut, zinc | 6 N·mA 1/4-20 nylon-insert lock nut, zinc | Step 1
4 x 1/4-20 x 1 in hex bolt joint body/plate_on_flange | 4 × 1/4-20 nylon-insert lock nut, zinc 4 × 1/4-20 x 1 in hex bolt, zinc | 8 N·mA 1/4-20 nylon-insert lock nut, zinc | Step 2
1 x M5 x 12 socket head cap screw ×4 joint body/upright_rf_on_plate, body/upright_rb_on_plate, body/upright_lf_on_plate, body/upright_lb_on_plate | 4 × M5 x 12 SHCS | 2.5 N·mA M5 x 12 SHCS | Step 2

PR0TOBOARD · UHDJJ-B-AG · Rev A · 2026-10-2407 / 116

Joyful Jack, Tier B, MidrangeAssembly guideJJ-B-AG

Hardware by harness (continued)

Harness | Parts placed | Torque | Used in

1 x M5 x 10 socket head cap screw ×41
joint body/bracket_01_on_rail, body/bracket_01_on_upright, body/bracket_02_on_rail, body/bracket_02_on_upright, body/bracket_03_on_rail, body/bracket_03_on_upright, body/bracket_04_on_rail, body/bracket_04_on_upright, body/bracket_05_on_rail, body/bracket_05_on_upright, body/bracket_06_on_rail, body/bracket_06_on_upright, body/bracket_07_on_rail, body/bracket_07_on_upright, body/bracket_08_on_rail, body/bracket_08_on_upright, body/bracket_09_on_rail, body/bracket_09_on_upright, body/bracket_10_on_rail, body/bracket_10_on_upright, body/bracket_11_on_rail, body/bracket_11_on_upright, body/bracket_12_on_rail, body/bracket_12_on_upright, body/bracket_13_on_rail, body/bracket_13_on_upright, body/bracket_14_on_rail, body/bracket_14_on_upright, body/bracket_15_on_rail, body/bracket_15_on_upright, body/bracket_16_on_rail, body/bracket_16_on_upright, body/neck_post_f_bracket_0_on_rail, body/neck_post_f_bracket_0_on_post, body/neck_post_f_bracket_1_on_rail, body/neck_post_f_bracket_1_on_post, body/neck_post_b_bracket_0_on_rail, body/neck_post_b_bracket_0_on_post, body/neck_post_b_bracket_1_on_rail, body/neck_post_b_bracket_1_on_post, body/estop_bracket_on_rail

41 × M5 roll-in T-nut for 2020 extrusion
41 × M5 x 10 SHCS

2.5 N·mA M5 x 10 SHCS

Step 2, Step 3, Step 4, Step 5, Step 6, Step 7, Step 8, Step 11
1 x M5 x 12 socket head cap screw ×2 joint body/neck_plate_on_neck_post_f, body/neck_plate_on_neck_post_b | 2 × M5 x 12 SHCS | 2.5 N·mA M5 x 12 SHCS | Step 7, Step 8
1 x M5 x 12 socket head cap screw ×4 joint body/ebd_tab_0, body/ebd_tab_1, body/ebd_tab_2, body/ebd_tab_3 | 4 × M5 roll-in T-nut for 2020 extrusion 4 × M5 x 12 SHCS | 2.5 N·mA M5 x 12 SHCS | Step 9
2 x #4 x 0.5 in flat head wood screw ×12 joint body/tray_or_1_on_board, body/tray_or_2_on_board, body/tray_monitor_on_board, body/tray_lvc_on_board, body/tray_fuses_on_board, body/tray_relay_on_board, body/tray_buck_head_on_board, body/tray_buck_pi_on_board, body/tray_buck_arm_r_on_board, body/tray_buck_arm_l_on_board, body/tray_arm_r__bus_adapter_on_board, body/tray_arm_l__bus_adapter_on_board | 24 × #4 x 0.5 in flat head wood screw | 0.5 N·mA #4 x 0.5 in flat head wood screw | Step 9, Step 10, Step 11

PR0TOBOARD · UHDJJ-B-AG · Rev A · 2026-10-2408 / 116

Joyful Jack, Tier B, MidrangeAssembly guideJJ-B-AG

Hardware by harness (continued)

Harness | Parts placed | Torque | Used in

4 x PA2.0 x 8 pan head self-tapping screw (for plastic) ×20
joint arm_r/arm_r_j1_servo_case_top, arm_r/arm_r_j1_servo_case_bottom, arm_r/arm_r_j2_servo_case_top, arm_r/arm_r_j2_servo_case_bottom, arm_r/arm_r_j3_servo_case_top, arm_r/arm_r_j3_servo_case_bottom, arm_r/arm_r_j4_servo_case_top, arm_r/arm_r_j4_servo_case_bottom, arm_r/arm_r_j5_servo_case_top, arm_r/arm_r_j5_servo_case_bottom, arm_l/arm_l_j1_servo_case_top, arm_l/arm_l_j1_servo_case_bottom, arm_l/arm_l_j2_servo_case_top, arm_l/arm_l_j2_servo_case_bottom, arm_l/arm_l_j3_servo_case_top, arm_l/arm_l_j3_servo_case_bottom, arm_l/arm_l_j4_servo_case_top, arm_l/arm_l_j4_servo_case_bottom, arm_l/arm_l_j5_servo_case_top, arm_l/arm_l_j5_servo_case_bottom

80 × PA2.0 x 8 pan head self-tapping screw (for plastic)

0.15 N·mA PA2.0 x 8 pan head self-tapping screw (for plastic)

Step 14, Step 16, Step 17, Step 19, Step 21, Step 25, Step 27, Step 28, Step 30, Step 32
4 x M3 x 14 socket head cap screw ×6 joint arm_r/arm_r_j1_driver_on_horn, arm_r/arm_r_j2_driver_on_horn, arm_r/arm_r_j4_driver_on_horn, arm_l/arm_l_j1_driver_on_horn, arm_l/arm_l_j2_driver_on_horn, arm_l/arm_l_j4_driver_on_horn | 24 × M3 x 14 SHCS | 0.5 N·mA M3 x 14 SHCS | Step 14, Step 16, Step 19, Step 25, Step 27, Step 30
4 x M3 x 14 socket head cap screw ×6 joint arm_r/arm_r_j1_cap_on_drum, arm_r/arm_r_j2_cap_on_drum, arm_r/arm_r_j4_cap_on_drum, arm_l/arm_l_j1_cap_on_drum, arm_l/arm_l_j2_cap_on_drum, arm_l/arm_l_j4_cap_on_drum | 24 × M3 brass heat-set insert (4.6 mm OD x 5.7 mm) 24 × M3 x 14 SHCS | 0.36 N·mA M3 x 14 SHCS | Step 15, Step 17, Step 20, Step 26, Step 28, Step 31
4 x M3 x 12 socket head cap screw ×16 joint arm_r/arm_r_j1_arbor_on_hub, arm_r/arm_r_yoke_on_j1_hub, arm_r/arm_r_yoke_fork_face_a, arm_r/arm_r_yoke_fork_face_b, arm_r/arm_r_j2_arbor_on_yoke, arm_r/arm_r_fork_in_on_j4, arm_r/arm_r_fork_out_on_j4, arm_r/arm_r_hand_palm_on_wrist, arm_l/arm_l_j1_arbor_on_hub, arm_l/arm_l_yoke_on_j1_hub, arm_l/arm_l_yoke_fork_face_a, arm_l/arm_l_yoke_fork_face_b, arm_l/arm_l_j2_arbor_on_yoke, arm_l/arm_l_fork_in_on_j4, arm_l/arm_l_fork_out_on_j4, arm_l/arm_l_hand_palm_on_wrist | 64 × M3 brass heat-set insert (4.6 mm OD x 5.7 mm) 64 × M3 x 12 SHCS | 0.36 N·mA M3 x 12 SHCS | Step 15, Step 17, Step 18, Step 21, Step 23, Step 26, Step 28, Step 29, Step 32, Step 34
4 x M3 x 6 socket head cap screw ×4 joint arm_r/arm_r_j3_disc_on_horn, arm_r/arm_r_j5_disc_on_horn, arm_l/arm_l_j3_disc_on_horn, arm_l/arm_l_j5_disc_on_horn | 16 × M3 x 6 SHCS | 0.5 N·mA M3 x 6 SHCS | Step 18, Step 22, Step 29, Step 33

PR0TOBOARD · UHDJJ-B-AG · Rev A · 2026-10-2409 / 116

Joyful Jack, Tier B, MidrangeAssembly guideJJ-B-AG

Hardware by harness (continued)

Harness | Parts placed | Torque | Used in
3 x M3 x 30 socket head cap screw ×4 joint arm_r/arm_r_j3_hub_to_disc, arm_r/arm_r_j5_hub_to_disc, arm_l/arm_l_j3_hub_to_disc, arm_l/arm_l_j5_hub_to_disc | 12 × M3 brass heat-set insert (4.6 mm OD x 5.7 mm) 12 × M3 x 30 SHCS | 0.36 N·mA M3 x 30 SHCS | Step 18, Step 22, Step 29, Step 33
4 x M3 x 14 socket head cap screw ×2 joint arm_r/arm_r_elbow_on_j3_hub, arm_l/arm_l_elbow_on_j3_hub | 8 × M3 brass heat-set insert (4.6 mm OD x 5.7 mm) 8 × M3 x 14 SHCS | 0.36 N·mA M3 x 14 SHCS | Step 20, Step 31
2 x M3 x 12 socket head cap screw ×4 joint arm_r/arm_r_fork_in_to_body, arm_r/arm_r_fork_out_to_body, arm_l/arm_l_fork_in_to_body, arm_l/arm_l_fork_out_to_body | 8 × M3 brass heat-set insert (4.6 mm OD x 5.7 mm) 8 × M3 x 12 SHCS | 0.36 N·mA M3 x 12 SHCS | Step 22, Step 33
4 x PA2.0 x 6 pan head self-tapping screw (for plastic) ×8 joint arm_r/arm_r_hand_fingers_servo_case_top, arm_r/arm_r_hand_fingers_servo_case_bottom, arm_r/arm_r_hand_thumb_servo_case_top, arm_r/arm_r_hand_thumb_servo_case_bottom, arm_l/arm_l_hand_fingers_servo_case_top, arm_l/arm_l_hand_fingers_servo_case_bottom, arm_l/arm_l_hand_thumb_servo_case_top, arm_l/arm_l_hand_thumb_servo_case_bottom | 32 × PA2.0 x 6 pan head self-tapping screw (for plastic) | 0.15 N·mA PA2.0 x 6 pan head self-tapping screw (for plastic) | Step 23, Step 34
4 x M3 x 8 socket head cap screw ×8 joint arm_r/arm_r_hand_fingers_on_horn, arm_r/arm_r_hand_fingers_on_rear_horn, arm_r/arm_r_hand_thumb_on_horn, arm_r/arm_r_hand_thumb_on_rear_horn, arm_l/arm_l_hand_fingers_on_horn, arm_l/arm_l_hand_fingers_on_rear_horn, arm_l/arm_l_hand_thumb_on_horn, arm_l/arm_l_hand_thumb_on_rear_horn | 32 × M3 x 8 SHCS | 0.5 N·mA M3 x 8 SHCS | Step 24, Step 35

4 x M5 x 20 socket head cap screw jj-joint-007

2 x M4 x 20 socket head cap screw jj-joint-023

2 x M5 x 12 socket head cap screw jj-joint-029

4 x 1/4-20 x 1.25 in hex bolt jj-joint-001

PR0TOBOARD · UHDJJ-B-AG · Rev A · 2026-10-2410 / 116

Joyful Jack, Tier B, MidrangeAssembly guideJJ-B-AG

4 x 1/4-20 x 1 in hex bolt jj-joint-020

1 x M5 x 12 socket head cap screw jj-joint-021

1 x M5 x 10 socket head cap screw jj-joint-006

1 x M5 x 12 socket head cap screw jj-joint-004

1 x M5 x 12 socket head cap screw jj-joint-022

2 x #4 x 0.5 in flat head wood screw jj-joint-009

4 x PA2.0 x 8 pan head self-tapping screw (for plastic) jj-joint-024

4 x M3 x 14 socket head cap screw jj-joint-025

4 x M3 x 14 socket head cap screw jj-joint-026

4 x M3 x 12 socket head cap screw jj-joint-015

4 x M3 x 6 socket head cap screw jj-joint-013

3 x M3 x 30 socket head cap screw jj-joint-014

PR0TOBOARD · UHDJJ-B-AG · Rev A · 2026-10-2411 / 116

Joyful Jack, Tier B, MidrangeAssembly guideJJ-B-AG

4 x M3 x 14 socket head cap screw jj-joint-016

2 x M3 x 12 socket head cap screw jj-joint-027

4 x PA2.0 x 6 pan head self-tapping screw (for plastic) jj-joint-028

4 x M3 x 8 socket head cap screw jj-joint-017

PR0TOBOARD · UHDJJ-B-AG · Rev A · 2026-10-2412 / 116

Joyful Jack, Tier B, MidrangeAssembly guideJJ-B-AG

1

## Build the base: skirt, bucket, flanges and mast

mates: body/bucket_on_skirt, body/concrete_in_bucket, body/flange_in_concrete, body/mast_in_flange, body/flange_on_mast



A×1

5 US gal HDPE bucket (lid not used)



B×1

Concrete fill, about 2 x 50 lb bags of quick-setting concrete



C×2

1 in floor flange, malleable iron (Anvil FIG 1190)



D×1

1 in x 30 in black steel pipe nipple (NPS, threaded both ends)



E×4

1/4-20 x 1.25 in hex bolt, zinc



F×4

1/4-20 nylon-insert lock nut, zinc

Build the base: skirt, bucket, flanges and mast: parts exploded along each joint's axis in stacking order; lettered as in the parts strip.

Figure 1Build the base: skirt, bucket, flanges and mast: parts exploded along each joint's axis in stacking order; lettered as in the parts strip.

1. Insert 4 × 1/4-20 x 1.25 in hex bolt, zinc from below, up through the bucket bolts (4 x 1/4-20 through the skirt).
2. Seat the 5 US gal HDPE bucket (lid not used) onto the bucket bolts (4 x 1/4-20 through the skirt).
3. Finish with 4 × 1/4-20 nylon-insert lock nut, zinc; tighten until snug.
4. Seat the Concrete fill, about 2 x 50 lb bags of quick-setting concrete onto the inside floor.
5. Seat the 1 in floor flange, malleable iron (Anvil FIG 1190) onto the bottom flange bed (first lift).
6. Seat the 1 in x 30 in black steel pipe nipple (NPS, threaded both ends) onto the 1 in NPT socket.
7. Seat the 1 in floor flange, malleable iron (Anvil FIG 1190) onto the top thread.

Torque 6 N·mA 1/4-20 nylon-insert lock nut, zincTools 11.1 mm nut driverStep 1 of 42

CAUTION Concrete is heavy and sets fast: pour it in the bucket where it will stand, set the bottom flange on the first pour with the mast plumb, pour the rest round it and let it cure before loading the mast.

PR0TOBOARD · UHDJJ-B-AG · Rev A · 2026-10-2413 / 116

Joyful Jack, Tier B, MidrangeAssembly guideJJ-B-AG

2

## Build the torso frame on the top flange (1 of 5)

mates: body/plate_on_flange, body/upright_rf_on_plate, body/upright_rb_on_plate, body/upright_lf_on_plate, body/upright_lb_on_plate, body/bracket_01_on_rail, body/bracket_01_on_upright, body/bracket_02_on_rail



A×1

Torso base plate, 6 mm 6061 aluminium, 220 x 140



B×1

2020 aluminium extrusion, 340 mm (upright), M5 tapped both ends



C×1

2020 aluminium extrusion, 340 mm (upright), M5 tapped both ends



D×1

2020 aluminium extrusion, 340 mm (upright), M5 tapped both ends



E×1

2020 aluminium extrusion, 340 mm (upright), M5 tapped both ends



F×1

Cast 90 deg corner bracket, 20 series (one M5 per leg)



G×1

2020 aluminium extrusion, 180 mm (rail-x), M5 tapped both ends



H×1

2020 aluminium extrusion, 100 mm (rail-y), M5 tapped both ends



J×4

1/4-20 nylon-insert lock nut, zinc



K×4

1/4-20 x 1 in hex bolt, zinc



L×4

M5 x 12 SHCS



M×3

M5 roll-in T-nut for 2020 extrusion



N×3

M5 x 10 SHCS

Build the torso frame on the top flange (1 of 5): parts exploded along each joint's axis in stacking order; lettered as in the parts strip.

Figure 2Build the torso frame on the top flange (1 of 5): parts exploded along each joint's axis in stacking order; lettered as in the parts strip.

PR0TOBOARD · UHDJJ-B-AG · Rev A · 2026-10-2414 / 116

Joyful Jack, Tier B, MidrangeAssembly guideJJ-B-AG

1. Insert 4 × 1/4-20 x 1 in hex bolt, zinc from below, up through the top flange (4 x 1/4-20).
2. Seat the Torso base plate, 6 mm 6061 aluminium, 220 x 140 onto the top flange (4 x 1/4-20).
3. Finish with 4 × 1/4-20 nylon-insert lock nut, zinc; tighten until snug.
4. Seat the 2020 aluminium extrusion, 340 mm (upright), M5 tapped both ends onto the end A (M5 tap).
5. Drive 1 × M5 x 12 SHCS from above, head down.
6. Seat the 2020 aluminium extrusion, 340 mm (upright), M5 tapped both ends onto the end A (M5 tap).
7. Drive 1 × M5 x 12 SHCS from above, head down.
8. Seat the 2020 aluminium extrusion, 340 mm (upright), M5 tapped both ends onto the end A (M5 tap).
9. Drive 1 × M5 x 12 SHCS from above, head down.
10. Seat the 2020 aluminium extrusion, 340 mm (upright), M5 tapped both ends onto the end A (M5 tap).
11. Drive 1 × M5 x 12 SHCS from above, head down.
12. Finish with 1 × M5 roll-in T-nut for 2020 extrusion; tighten until snug.
13. Seat the 2020 aluminium extrusion, 180 mm (rail-x), M5 tapped both ends onto the T-slot (bracket bracket_01).
14. Drive 1 × M5 x 10 SHCS from above, head down.
15. Finish with 1 × M5 roll-in T-nut for 2020 extrusion; tighten until snug.
16. Seat the Cast 90 deg corner bracket, 20 series (one M5 per leg) onto the T-slot (bracket bracket_01).
17. Insert 1 × M5 x 10 SHCS from the opposite side.
18. Finish with 1 × M5 roll-in T-nut for 2020 extrusion; tighten until snug.
19. Seat the 2020 aluminium extrusion, 100 mm (rail-y), M5 tapped both ends onto the T-slot (bracket bracket_02).
20. Drive 1 × M5 x 10 SHCS from above, head down.

Torque 8 N·mA 1/4-20 nylon-insert lock nut, zinc · 4 x 1/4-20 x 1 in hex bolt; 2.5 N·mA M5 x 12 SHCS · 1 x M5 x 12 socket head cap screw; 2.5 N·mA M5 x 10 SHCS · 1 x M5 x 10 socket head cap screwTools 10 mm nut driver, 11.1 mm nut driverStep 2 of 42

TIP Roll each T-nut into its slot before closing the rail; fit brackets loosely, square the box, then tighten.

PR0TOBOARD · UHDJJ-B-AG · Rev A · 2026-10-2415 / 116

Joyful Jack, Tier B, MidrangeAssembly guideJJ-B-AG

3

## Build the torso frame on the top flange (2 of 5)

mates: body/bracket_02_on_upright, body/bracket_03_on_rail, body/bracket_03_on_upright, body/bracket_04_on_rail, body/bracket_04_on_upright, body/bracket_05_on_rail, body/bracket_05_on_upright, body/bracket_06_on_rail



A×4

Cast 90 deg corner bracket, 20 series (one M5 per leg)



B×1

2020 aluminium extrusion, 180 mm (rail-x), M5 tapped both ends



C×1

2020 aluminium extrusion, 100 mm (rail-y), M5 tapped both ends



D×8

M5 roll-in T-nut for 2020 extrusion



E×8

M5 x 10 SHCS

Build the torso frame on the top flange (2 of 5): parts exploded along each joint's axis in stacking order; lettered as in the parts strip.

Figure 3Build the torso frame on the top flange (2 of 5): parts exploded along each joint's axis in stacking order; lettered as in the parts strip.

PR0TOBOARD · UHDJJ-B-AG · Rev A · 2026-10-2416 / 116

Joyful Jack, Tier B, MidrangeAssembly guideJJ-B-AG

1. Finish with 1 × M5 roll-in T-nut for 2020 extrusion; tighten until snug.
2. Seat the Cast 90 deg corner bracket, 20 series (one M5 per leg) onto the T-slot (bracket bracket_02).
3. Insert 1 × M5 x 10 SHCS from the opposite side.
4. Finish with 1 × M5 roll-in T-nut for 2020 extrusion; tighten until snug.
5. Seat the 2020 aluminium extrusion, 180 mm (rail-x), M5 tapped both ends onto the T-slot (bracket bracket_03).
6. Drive 1 × M5 x 10 SHCS from above, head down.
7. Finish with 1 × M5 roll-in T-nut for 2020 extrusion; tighten until snug.
8. Seat a Cast 90 deg corner bracket, 20 series (one M5 per leg) onto each T-slot (bracket bracket_03).
9. Insert 1 × M5 x 10 SHCS from the opposite side. Repeat on all 2.
10. Finish with 1 × M5 roll-in T-nut for 2020 extrusion; tighten until snug.
11. Seat the Cast 90 deg corner bracket, 20 series (one M5 per leg) onto the T-slot (bracket bracket_04).
12. Drive 1 × M5 x 10 SHCS from above, head down.
13. Finish with 1 × M5 roll-in T-nut for 2020 extrusion; tighten until snug.
14. Seat the Cast 90 deg corner bracket, 20 series (one M5 per leg) onto the T-slot (bracket bracket_05).
15. Drive 1 × M5 x 10 SHCS from above, head down.
16. Finish with 1 × M5 roll-in T-nut for 2020 extrusion; tighten until snug.
17. Seat the Cast 90 deg corner bracket, 20 series (one M5 per leg) onto the T-slot (bracket bracket_05).
18. Insert 1 × M5 x 10 SHCS from the opposite side.
19. Finish with 1 × M5 roll-in T-nut for 2020 extrusion; tighten until snug.
20. Seat the 2020 aluminium extrusion, 100 mm (rail-y), M5 tapped both ends onto the T-slot (bracket bracket_06).
21. Drive 1 × M5 x 10 SHCS from above, head down.

Torque 2.5 N·mA M5 x 10 SHCSTools 10 mm nut driverStep 3 of 42

PR0TOBOARD · UHDJJ-B-AG · Rev A · 2026-10-2417 / 116

Joyful Jack, Tier B, MidrangeAssembly guideJJ-B-AG

4

## Build the torso frame on the top flange (3 of 5)

mates: body/bracket_06_on_upright, body/bracket_07_on_rail, body/bracket_07_on_upright, body/bracket_08_on_rail, body/bracket_08_on_upright, body/bracket_09_on_rail, body/bracket_09_on_upright, body/bracket_10_on_rail



A×4

Cast 90 deg corner bracket, 20 series (one M5 per leg)



B×1

2020 aluminium extrusion, 180 mm (rail-x), M5 tapped both ends



C×1

2020 aluminium extrusion, 100 mm (rail-y), M5 tapped both ends



D×8

M5 roll-in T-nut for 2020 extrusion



E×8

M5 x 10 SHCS

Build the torso frame on the top flange (3 of 5): parts exploded along each joint's axis in stacking order; lettered as in the parts strip.

Figure 4Build the torso frame on the top flange (3 of 5): parts exploded along each joint's axis in stacking order; lettered as in the parts strip.

PR0TOBOARD · UHDJJ-B-AG · Rev A · 2026-10-2418 / 116

Joyful Jack, Tier B, MidrangeAssembly guideJJ-B-AG

1. Finish with 1 × M5 roll-in T-nut for 2020 extrusion; tighten until snug.
2. Seat the Cast 90 deg corner bracket, 20 series (one M5 per leg) onto the T-slot (bracket bracket_06).
3. Insert 1 × M5 x 10 SHCS from the opposite side.
4. Finish with 1 × M5 roll-in T-nut for 2020 extrusion; tighten until snug.
5. Seat the Cast 90 deg corner bracket, 20 series (one M5 per leg) onto the T-slot (bracket bracket_07).
6. Drive 1 × M5 x 10 SHCS from above, head down.
7. Finish with 1 × M5 roll-in T-nut for 2020 extrusion; tighten until snug.
8. Seat a Cast 90 deg corner bracket, 20 series (one M5 per leg) onto each T-slot (bracket bracket_07).
9. Insert 1 × M5 x 10 SHCS from the opposite side. Repeat on all 2.
10. Finish with 1 × M5 roll-in T-nut for 2020 extrusion; tighten until snug.
11. Seat the Cast 90 deg corner bracket, 20 series (one M5 per leg) onto the T-slot (bracket bracket_08).
12. Drive 1 × M5 x 10 SHCS from above, head down.
13. Finish with 1 × M5 roll-in T-nut for 2020 extrusion; tighten until snug.
14. Seat the 2020 aluminium extrusion, 180 mm (rail-x), M5 tapped both ends onto the T-slot (bracket bracket_09).
15. Drive 1 × M5 x 10 SHCS from above, head down.
16. Finish with 1 × M5 roll-in T-nut for 2020 extrusion; tighten until snug.
17. Seat the Cast 90 deg corner bracket, 20 series (one M5 per leg) onto the T-slot (bracket bracket_09).
18. Insert 1 × M5 x 10 SHCS from the opposite side.
19. Finish with 1 × M5 roll-in T-nut for 2020 extrusion; tighten until snug.
20. Seat the 2020 aluminium extrusion, 100 mm (rail-y), M5 tapped both ends onto the T-slot (bracket bracket_10).
21. Drive 1 × M5 x 10 SHCS from above, head down.

Torque 2.5 N·mA M5 x 10 SHCSTools 10 mm nut driverStep 4 of 42

PR0TOBOARD · UHDJJ-B-AG · Rev A · 2026-10-2419 / 116

Joyful Jack, Tier B, MidrangeAssembly guideJJ-B-AG

5

## Build the torso frame on the top flange (4 of 5)

mates: body/bracket_10_on_upright, body/bracket_11_on_rail, body/bracket_11_on_upright, body/bracket_12_on_rail, body/bracket_12_on_upright, body/bracket_13_on_rail, body/bracket_13_on_upright, body/bracket_14_on_rail



A×4

Cast 90 deg corner bracket, 20 series (one M5 per leg)



B×1

2020 aluminium extrusion, 180 mm (rail-x), M5 tapped both ends



C×1

2020 aluminium extrusion, 100 mm (rail-y), M5 tapped both ends



D×8

M5 roll-in T-nut for 2020 extrusion



E×8

M5 x 10 SHCS

Build the torso frame on the top flange (4 of 5): parts exploded along each joint's axis in stacking order; lettered as in the parts strip.

Figure 5Build the torso frame on the top flange (4 of 5): parts exploded along each joint's axis in stacking order; lettered as in the parts strip.

PR0TOBOARD · UHDJJ-B-AG · Rev A · 2026-10-2420 / 116

Joyful Jack, Tier B, MidrangeAssembly guideJJ-B-AG

1. Finish with 1 × M5 roll-in T-nut for 2020 extrusion; tighten until snug.
2. Seat the Cast 90 deg corner bracket, 20 series (one M5 per leg) onto the T-slot (bracket bracket_10).
3. Insert 1 × M5 x 10 SHCS from the opposite side.
4. Finish with 1 × M5 roll-in T-nut for 2020 extrusion; tighten until snug.
5. Seat the 2020 aluminium extrusion, 180 mm (rail-x), M5 tapped both ends onto the T-slot (bracket bracket_11).
6. Drive 1 × M5 x 10 SHCS from above, head down.
7. Finish with 1 × M5 roll-in T-nut for 2020 extrusion; tighten until snug.
8. Seat a Cast 90 deg corner bracket, 20 series (one M5 per leg) onto each T-slot (bracket bracket_11).
9. Insert 1 × M5 x 10 SHCS from the opposite side. Repeat on all 2.
10. Finish with 1 × M5 roll-in T-nut for 2020 extrusion; tighten until snug.
11. Seat the Cast 90 deg corner bracket, 20 series (one M5 per leg) onto the T-slot (bracket bracket_12).
12. Drive 1 × M5 x 10 SHCS from above, head down.
13. Finish with 1 × M5 roll-in T-nut for 2020 extrusion; tighten until snug.
14. Seat the Cast 90 deg corner bracket, 20 series (one M5 per leg) onto the T-slot (bracket bracket_13).
15. Drive 1 × M5 x 10 SHCS from above, head down.
16. Finish with 1 × M5 roll-in T-nut for 2020 extrusion; tighten until snug.
17. Seat the Cast 90 deg corner bracket, 20 series (one M5 per leg) onto the T-slot (bracket bracket_13).
18. Insert 1 × M5 x 10 SHCS from the opposite side.
19. Finish with 1 × M5 roll-in T-nut for 2020 extrusion; tighten until snug.
20. Seat the 2020 aluminium extrusion, 100 mm (rail-y), M5 tapped both ends onto the T-slot (bracket bracket_14).
21. Drive 1 × M5 x 10 SHCS from above, head down.

Torque 2.5 N·mA M5 x 10 SHCSTools 10 mm nut driverStep 5 of 42

PR0TOBOARD · UHDJJ-B-AG · Rev A · 2026-10-2421 / 116

Joyful Jack, Tier B, MidrangeAssembly guideJJ-B-AG

6

## Build the torso frame on the top flange (5 of 5)

mates: body/bracket_14_on_upright, body/bracket_15_on_rail, body/bracket_15_on_upright, body/bracket_16_on_rail, body/bracket_16_on_upright



A×3

Cast 90 deg corner bracket, 20 series (one M5 per leg)



B×5

M5 roll-in T-nut for 2020 extrusion



C×5

M5 x 10 SHCS

Build the torso frame on the top flange (5 of 5): parts exploded along each joint's axis in stacking order; lettered as in the parts strip.

Figure 6Build the torso frame on the top flange (5 of 5): parts exploded along each joint's axis in stacking order; lettered as in the parts strip.

1. Finish with 1 × M5 roll-in T-nut for 2020 extrusion; tighten until snug.
2. Seat the Cast 90 deg corner bracket, 20 series (one M5 per leg) onto the T-slot (bracket bracket_14).
3. Insert 1 × M5 x 10 SHCS from the opposite side.
4. Finish with 1 × M5 roll-in T-nut for 2020 extrusion; tighten until snug.
5. Seat the Cast 90 deg corner bracket, 20 series (one M5 per leg) onto the T-slot (bracket bracket_15).
6. Drive 1 × M5 x 10 SHCS from above, head down.
7. Finish with 1 × M5 roll-in T-nut for 2020 extrusion; tighten until snug.
8. Seat a Cast 90 deg corner bracket, 20 series (one M5 per leg) onto each T-slot (bracket bracket_15).
9. Insert 1 × M5 x 10 SHCS from the opposite side. Repeat on all 2.
10. Finish with 1 × M5 roll-in T-nut for 2020 extrusion; tighten until snug.
11. Seat the Cast 90 deg corner bracket, 20 series (one M5 per leg) onto the T-slot (bracket bracket_16).
12. Drive 1 × M5 x 10 SHCS from above, head down.

Torque 2.5 N·mA M5 x 10 SHCSTools 10 mm nut driverStep 6 of 42

PR0TOBOARD · UHDJJ-B-AG · Rev A · 2026-10-2422 / 116

Joyful Jack, Tier B, MidrangeAssembly guideJJ-B-AG

7

## Fit the neck posts and the neck plate (1 of 2)

mates: body/neck_plate_on_neck_post_f, body/neck_post_f_bracket_0_on_rail, body/neck_post_f_bracket_0_on_post, body/neck_post_f_bracket_1_on_rail, body/neck_post_f_bracket_1_on_post



A×2

Cast 90 deg corner bracket, 20 series (one M5 per leg)



B×1

2020 aluminium extrusion, 102 mm (neck-post), M5 tapped both ends



C×1

Neck plate, 6 mm 6061 aluminium



D×1

M5 x 12 SHCS



E×4

M5 roll-in T-nut for 2020 extrusion



F×4

M5 x 10 SHCS

Fit the neck posts and the neck plate (1 of 2): parts exploded along each joint's axis in stacking order; lettered as in the parts strip.

Figure 7Fit the neck posts and the neck plate (1 of 2): parts exploded along each joint's axis in stacking order; lettered as in the parts strip.

1. Seat the Neck plate, 6 mm 6061 aluminium onto the end B (M5 tap).
2. Drive 1 × M5 x 12 SHCS from above, head down.
3. Finish with 1 × M5 roll-in T-nut for 2020 extrusion; tighten until snug.
4. Seat a Cast 90 deg corner bracket, 20 series (one M5 per leg) onto each T-slot (bracket neck_post_f_bracket_0).
5. Drive 1 × M5 x 10 SHCS from above, head down. Repeat on all 2.
6. Finish with 1 × M5 roll-in T-nut for 2020 extrusion; tighten until snug.
7. Seat the 2020 aluminium extrusion, 102 mm (neck-post), M5 tapped both ends onto the T-slot (bracket neck_post_f_bracket_0).
8. Insert 1 × M5 x 10 SHCS from the opposite side.
9. Finish with 1 × M5 roll-in T-nut for 2020 extrusion; tighten until snug.
10. Seat the Cast 90 deg corner bracket, 20 series (one M5 per leg) onto the T-slot (bracket neck_post_f_bracket_1).
11. Insert 1 × M5 x 10 SHCS from the opposite side.

PR0TOBOARD · UHDJJ-B-AG · Rev A · 2026-10-2423 / 116

Joyful Jack, Tier B, MidrangeAssembly guideJJ-B-AG

Torque 2.5 N·mA M5 x 12 SHCS · 1 x M5 x 12 socket head cap screw; 2.5 N·mA M5 x 10 SHCS · 1 x M5 x 10 socket head cap screwTools 10 mm nut driverStep 7 of 42

PR0TOBOARD · UHDJJ-B-AG · Rev A · 2026-10-2424 / 116

Joyful Jack, Tier B, MidrangeAssembly guideJJ-B-AG

8

## Fit the neck posts and the neck plate (2 of 2)

mates: body/neck_plate_on_neck_post_b, body/neck_post_b_bracket_0_on_rail, body/neck_post_b_bracket_0_on_post, body/neck_post_b_bracket_1_on_rail, body/neck_post_b_bracket_1_on_post



A×2

Cast 90 deg corner bracket, 20 series (one M5 per leg)



B×1

2020 aluminium extrusion, 102 mm (neck-post), M5 tapped both ends



C×1

M5 x 12 SHCS



D×4

M5 roll-in T-nut for 2020 extrusion



E×4

M5 x 10 SHCS

Fit the neck posts and the neck plate (2 of 2): parts exploded along each joint's axis in stacking order; lettered as in the parts strip.

Figure 8Fit the neck posts and the neck plate (2 of 2): parts exploded along each joint's axis in stacking order; lettered as in the parts strip.

1. Seat the Neck plate, 6 mm 6061 aluminium onto the end B (M5 tap).
2. Drive 1 × M5 x 12 SHCS from above, head down.
3. Finish with 1 × M5 roll-in T-nut for 2020 extrusion; tighten until snug.
4. Seat a Cast 90 deg corner bracket, 20 series (one M5 per leg) onto each T-slot (bracket neck_post_b_bracket_0).
5. Drive 1 × M5 x 10 SHCS from above, head down. Repeat on all 2.
6. Finish with 1 × M5 roll-in T-nut for 2020 extrusion; tighten until snug.
7. Seat the 2020 aluminium extrusion, 102 mm (neck-post), M5 tapped both ends onto the T-slot (bracket neck_post_b_bracket_0).
8. Insert 1 × M5 x 10 SHCS from the opposite side.
9. Finish with 1 × M5 roll-in T-nut for 2020 extrusion; tighten until snug.
10. Seat the Cast 90 deg corner bracket, 20 series (one M5 per leg) onto the T-slot (bracket neck_post_b_bracket_1).
11. Insert 1 × M5 x 10 SHCS from the opposite side.

PR0TOBOARD · UHDJJ-B-AG · Rev A · 2026-10-2425 / 116

Joyful Jack, Tier B, MidrangeAssembly guideJJ-B-AG

Torque 2.5 N·mA M5 x 12 SHCS · 1 x M5 x 12 socket head cap screw; 2.5 N·mA M5 x 10 SHCS · 1 x M5 x 10 socket head cap screwTools 10 mm nut driverStep 8 of 42

9

## Fit the electronics board, its trays and the E-stop bracket (1 of 3)

mates: body/ebd_tab_0, body/ebd_tab_1, body/ebd_tab_2, body/ebd_tab_3, body/tray_or_1_on_board, body/tray_or_2_on_board



A×1

Electronics board, tier B: 6 mm birch plywood 180 x 290



B×2

Tray for the Ideal diode module, 40 A



C×4

M5 roll-in T-nut for 2020 extrusion



D×4

M5 x 12 SHCS



E×4

#4 x 0.5 in flat head wood screw

Fit the electronics board, its trays and the E-stop bracket (1 of 3): parts exploded along each joint's axis in stacking order; lettered as in the parts strip.

Figure 9Fit the electronics board, its trays and the E-stop bracket (1 of 3): parts exploded along each joint's axis in stacking order; lettered as in the parts strip.

1. Finish with 1 × M5 roll-in T-nut for 2020 extrusion; tighten until snug.
2. Seat a Electronics board, tier B: 6 mm birch plywood 180 x 290 onto each T-slot (bracket ebd_0).
3. Insert 1 × M5 x 12 SHCS from the opposite side. Repeat on all 2.
4. Finish with 1 × M5 roll-in T-nut for 2020 extrusion; tighten until snug.
5. Seat a Electronics board, tier B: 6 mm birch plywood 180 x 290 onto each T-slot (bracket ebd_1).
6. Insert 1 × M5 x 12 SHCS from the opposite side. Repeat on all 2.
7. Seat a Tray for the Ideal diode module, 40 A onto each tray for or_1 (2 x #4 wood screws).
8. Insert 2 × #4 x 0.5 in flat head wood screw from the opposite side. Repeat on all 2.

Torque 2.5 N·mA M5 x 12 SHCS · 1 x M5 x 12 socket head cap screw; 0.5 N·mA #4 x 0.5 in flat head wood screw · 2 x #4 x 0.5 in flat head wood screwTools 10 mm nut driverStep 9 of 42

PR0TOBOARD · UHDJJ-B-AG · Rev A · 2026-10-2426 / 116

Joyful Jack, Tier B, MidrangeAssembly guideJJ-B-AG

10

## Fit the electronics board, its trays and the E-stop bracket (2 of 3)

mates: body/tray_monitor_on_board, body/tray_lvc_on_board, body/tray_fuses_on_board, body/tray_relay_on_board, body/tray_buck_head_on_board, body/tray_buck_pi_on_board



A×1

Tray for the Adafruit INA228 breakout



B×1

Tray for the XH-M609 low-voltage cutoff



C×1

Tray for the 6-way ATC fuse block with negative bus



D×1

Tray for the Temco 24 V 40 A automotive relay



E×1

Tray for the DROK 300 W buck converter



F×1

Tray for the Pololu D24V50F5 / D36V50F5 5 V regulator



G×12

#4 x 0.5 in flat head wood screw

Fit the electronics board, its trays and the E-stop bracket (2 of 3): parts exploded along each joint's axis in stacking order; lettered as in the parts strip.

Figure 10Fit the electronics board, its trays and the E-stop bracket (2 of 3): parts exploded along each joint's axis in stacking order; lettered as in the parts strip.

PR0TOBOARD · UHDJJ-B-AG · Rev A · 2026-10-2427 / 116

Joyful Jack, Tier B, MidrangeAssembly guideJJ-B-AG

1. Seat the Tray for the Adafruit INA228 breakout onto the tray for monitor (2 x #4 wood screws).
2. Insert 2 × #4 x 0.5 in flat head wood screw from the opposite side.
3. Seat the Tray for the XH-M609 low-voltage cutoff onto the tray for lvc (2 x #4 wood screws).
4. Insert 2 × #4 x 0.5 in flat head wood screw from the opposite side.
5. Seat the Tray for the 6-way ATC fuse block with negative bus onto the tray for fuses (2 x #4 wood screws).
6. Insert 2 × #4 x 0.5 in flat head wood screw from the opposite side.
7. Seat the Tray for the Temco 24 V 40 A automotive relay onto the tray for relay (2 x #4 wood screws).
8. Insert 2 × #4 x 0.5 in flat head wood screw from the opposite side.
9. Seat the Tray for the DROK 300 W buck converter onto the tray for buck_head (2 x #4 wood screws).
10. Insert 2 × #4 x 0.5 in flat head wood screw from the opposite side.
11. Seat the Tray for the Pololu D24V50F5 / D36V50F5 5 V regulator onto the tray for buck_pi (2 x #4 wood screws).
12. Insert 2 × #4 x 0.5 in flat head wood screw from the opposite side.

Torque 0.5 N·mA #4 x 0.5 in flat head wood screwStep 10 of 42

PR0TOBOARD · UHDJJ-B-AG · Rev A · 2026-10-2428 / 116

Joyful Jack, Tier B, MidrangeAssembly guideJJ-B-AG

11

## Fit the electronics board, its trays and the E-stop bracket (3 of 3)

mates: body/tray_buck_arm_r_on_board, body/tray_buck_arm_l_on_board, body/tray_arm_r__bus_adapter_on_board, body/tray_arm_l__bus_adapter_on_board, body/estop_bracket_on_rail



A×2

Tray for the EKYLIN 12 V 20 A buck converter



B×2

Tray for the Waveshare Bus Servo Adapter



C×1

E-stop bracket (on the back of the shoulders)



D×8

#4 x 0.5 in flat head wood screw



E×1

M5 roll-in T-nut for 2020 extrusion



F×1

M5 x 10 SHCS

Fit the electronics board, its trays and the E-stop bracket (3 of 3): parts exploded along each joint's axis in stacking order; lettered as in the parts strip.

Figure 11Fit the electronics board, its trays and the E-stop bracket (3 of 3): parts exploded along each joint's axis in stacking order; lettered as in the parts strip.

1. Seat a Tray for the EKYLIN 12 V 20 A buck converter onto each tray for buck_arm_r (2 x #4 wood screws).
2. Insert 2 × #4 x 0.5 in flat head wood screw from the opposite side. Repeat on all 2.
3. Seat a Tray for the Waveshare Bus Servo Adapter onto each tray for arm_r/bus_adapter (2 x #4 wood screws).
4. Insert 2 × #4 x 0.5 in flat head wood screw from the opposite side. Repeat on all 2.
5. Finish with 1 × M5 roll-in T-nut for 2020 extrusion; tighten until snug.
6. Seat the E-stop bracket (on the back of the shoulders) onto the T-slot (bracket estop_bracket).
7. Drive 1 × M5 x 10 SHCS from above, head down.

Torque 0.5 N·mA #4 x 0.5 in flat head wood screw · 2 x #4 x 0.5 in flat head wood screw; 2.5 N·mA M5 x 10 SHCS · 1 x M5 x 10 socket head cap screwTools 10 mm nut driverStep 11 of 42

PR0TOBOARD · UHDJJ-B-AG · Rev A · 2026-10-2429 / 116

Joyful Jack, Tier B, MidrangeAssembly guideJJ-B-AG

12

## Put the power parts in their trays and bolt down the battery docks (1 of 2)

mates: body_or_1_in_tray, body_or_2_in_tray, body_monitor_in_tray, body_lvc_in_tray, body_fuses_in_tray, body_relay_in_tray, body_buck_head_in_tray, body_buck_pi_in_tray



A×2

Ideal-diode module, 40 A



B×1

Adafruit INA228 power monitor (0x44)



C×1

XH-M609 low-voltage cutoff



D×1

6-way ATC fuse block with negative bus



E×1

TEMCo 24 V 40 A relay (SPST-NO)



F×1

DROK 300 W adjustable buck (10 A)



G×1

Pololu D24V50F5 5 V 5 A buck

Put the power parts in their trays and bolt down the battery docks (1 of 2): parts exploded along each joint's axis in stacking order; lettered as in the parts strip.

Figure 12Put the power parts in their trays and bolt down the battery docks (1 of 2): parts exploded along each joint's axis in stacking order; lettered as in the parts strip.

1. Seat a Ideal-diode module, 40 A onto each tray floor (component sits here). Repeat on all 2.
2. Seat the Adafruit INA228 power monitor (0x44) onto the tray floor (component sits here).
3. Seat the XH-M609 low-voltage cutoff onto the tray floor (component sits here).
4. Seat the 6-way ATC fuse block with negative bus onto the tray floor (component sits here).
5. Seat the TEMCo 24 V 40 A relay (SPST-NO) onto the tray floor (component sits here).
6. Seat the DROK 300 W adjustable buck (10 A) onto the tray floor (component sits here).
7. Seat the Pololu D24V50F5 5 V 5 A buck onto the tray floor (component sits here).

Step 12 of 42

PR0TOBOARD · UHDJJ-B-AG · Rev A · 2026-10-2430 / 116

Joyful Jack, Tier B, MidrangeAssembly guideJJ-B-AG

13

## Put the power parts in their trays and bolt down the battery docks (2 of 2)

mates: body_buck_arm_r_in_tray, body_buck_arm_l_in_tray, body_arm_r__bus_adapter_in_tray, body_arm_l__bus_adapter_in_tray, dock_1_on_base, dock_2_on_base, estop_on_bracket



A×2

EKYLIN 12 V 20 A buck



B×2

Waveshare Bus Servo Adapter (A)



C×2

M18 battery adapter (switch, 30 A fuse, 12 AWG)



D×1

Emergency stop, 22 mm, latching, NC



E×8

M4 flat washer, ISO 7089



F×4

M4 nyloc hex nut, ISO 10511



G×4

M4 x 20 SHCS

Put the power parts in their trays and bolt down the battery docks (2 of 2): parts exploded along each joint's axis in stacking order; lettered as in the parts strip.

Figure 13Put the power parts in their trays and bolt down the battery docks (2 of 2): parts exploded along each joint's axis in stacking order; lettered as in the parts strip.

1. Seat a EKYLIN 12 V 20 A buck onto each tray floor (component sits here). Repeat on all 2.
2. Seat a Waveshare Bus Servo Adapter (A) onto each tray floor (component sits here). Repeat on all 2.
3. Fit 2 × M4 flat washer, ISO 7089 on the dock 1 (2 x M4, nylocks underneath).
4. Hold 2 × M4 nyloc hex nut, ISO 10511 under the dock 1 (2 x M4, nylocks underneath).
5. Seat a M18 battery adapter (switch, 30 A fuse, 12 AWG) onto each dock 1 (2 x M4, nylocks underneath).
6. Fit 2 × M4 flat washer, ISO 7089 on the dock 1 (2 x M4, nylocks underneath).
7. Drive 2 × M4 x 20 SHCS from above, head down. Repeat on all 2.
8. Seat the Emergency stop, 22 mm, latching, NC onto the E-stop box (2 x M4 through the box floor, nylocks).

Torque 1.2 N·mA M4 nyloc hex nut, ISO 10511Tools 7 mm nut driverStep 13 of 42

PR0TOBOARD · UHDJJ-B-AG · Rev A · 2026-10-2431 / 116

Joyful Jack, Tier B, MidrangeAssembly guideJJ-B-AG

14

## Right arm: shoulder housing, J1 servo, belt and springs (1 of 2)

mates: arm_r/arm_r_j1_servo_case_top, arm_r/arm_r_j1_servo_case_bottom, arm_r/arm_r_j1_driver_on_horn, arm_r/arm_r_j1_dowel_in_pulley, arm_r/arm_r_j1_driver_bearing_seat, arm_r/arm_r_j1_belt_on_pulley, arm_r/arm_r_j1_bearing_1_seat, arm_r/arm_r_j1_hub_in_bearing_1



A×1

Feetech STS3215 12 V serial bus servo



B×1

Driver pulley, 20T GT3, on the STS horn



C×1

5 mm x 16 mm hardened steel dowel pin (ISO 8734)



D×1

625-2RS ball bearing (5 x 16 x 5 mm)



E×1

GT3 (3 mm pitch) closed belt, 240 mm (80 teeth), 9 mm wide



F×1

6806-2RS ball bearing (30 x 42 x 7 mm)



G×1

Belt-joint hub with 60T GT3 pulley (hollow, 14 mm bore)



H×8

PA2.0 x 8 pan head self-tapping screw (for plastic)



J×4

M3 x 14 SHCS

Right arm: shoulder housing, J1 servo, belt and springs (1 of 2): parts exploded along each joint's axis in stacking order; lettered as in the parts strip.

Figure 14Right arm: shoulder housing, J1 servo, belt and springs (1 of 2): parts exploded along each joint's axis in stacking order; lettered as in the parts strip.

PR0TOBOARD · UHDJJ-B-AG · Rev A · 2026-10-2432 / 116

Joyful Jack, Tier B, MidrangeAssembly guideJJ-B-AG

1. Seat the Feetech STS3215 12 V serial bus servo onto the case top screw holes.
2. Insert 4 × PA2.0 x 8 pan head self-tapping screw (for plastic) from the opposite side.
3. Seat the J1 shoulder housing (on the torso) onto the case bottom screw holes.
4. Insert 4 × PA2.0 x 8 pan head self-tapping screw (for plastic) from the opposite side.
5. Seat the Driver pulley, 20T GT3, on the STS horn onto the output horn.
6. Insert 4 × M3 x 14 SHCS from the opposite side.
7. Lower the 5 mm x 16 mm hardened steel dowel pin (ISO 8734) onto the dowel bore (—— gap).
8. Seat the 625-2RS ball bearing (5 x 16 x 5 mm) onto the J1 driver bearing seat (625).
9. Seat the GT3 (3 mm pitch) closed belt, 240 mm (80 teeth), 9 mm wide onto the belt plane.
10. Seat the 6806-2RS ball bearing (30 x 42 x 7 mm) onto the J1 bearing 1 seat.
11. Seat the Belt-joint hub with 60T GT3 pulley (hollow, 14 mm bore) onto the bore.

Torque 0.15 N·mA PA2.0 x 8 pan head self-tapping screw (for plastic) · 4 x PA2.0 x 8 pan head self-tapping screw (for plastic); 0.5 N·mA M3 x 14 SHCS · 4 x M3 x 14 socket head cap screwStep 14 of 42

TIP Press every heat-set insert into the printed parts first (soldering iron with an insert tip).

TIP Loop the belt on both pulleys before the cap goes on; the centre distance is fixed, so check it skips no tooth when you turn the joint by hand under load.

PR0TOBOARD · UHDJJ-B-AG · Rev A · 2026-10-2433 / 116

Joyful Jack, Tier B, MidrangeAssembly guideJJ-B-AG

15

## Right arm: shoulder housing, J1 servo, belt and springs (2 of 2)

mates: arm_r/arm_r_j1_cap_on_drum, arm_r/arm_r_j1_bearing_2_in_cap, arm_r/arm_r_j1_hub_in_bearing_2, arm_r/arm_r_j1_arbor_on_hub, arm_r/arm_r_j1_spring_0_on_arbor, arm_r/arm_r_j1_spring_1_on_arbor, arm_r/arm_r_yoke_on_j1_hub



A×1

Belt-joint bearing cap (60T housing)



B×1

6806-2RS ball bearing (30 x 42 x 7 mm)



C×1

J1 spring arbor (on hub face B)



D×2

Century Spring TO-5220RCS torsion spring (180 deg legs, right hand wind)



E×1

Shoulder yoke



F×12

M3 brass heat-set insert (4.6 mm OD x 5.7 mm)



G×4

M3 x 14 SHCS



H×8

M3 x 12 SHCS

Right arm: shoulder housing, J1 servo, belt and springs (2 of 2): parts exploded along each joint's axis in stacking order; lettered as in the parts strip.

Figure 15Right arm: shoulder housing, J1 servo, belt and springs (2 of 2): parts exploded along each joint's axis in stacking order; lettered as in the parts strip.

PR0TOBOARD · UHDJJ-B-AG · Rev A · 2026-10-2434 / 116

Joyful Jack, Tier B, MidrangeAssembly guideJJ-B-AG

1. Fit 4 × M3 brass heat-set insert (4.6 mm OD x 5.7 mm) on the J1 cap screws (4 x M3 inserts).
2. Seat the Belt-joint bearing cap (60T housing) onto the J1 cap screws (4 x M3 inserts).
3. Insert 4 × M3 x 14 SHCS from the opposite side.
4. Seat the 6806-2RS ball bearing (30 x 42 x 7 mm) onto the bearing 2 seat.
5. Seat the Belt-joint hub with 60T GT3 pulley (hollow, 14 mm bore) onto the bore.
6. Fit 4 × M3 brass heat-set insert (4.6 mm OD x 5.7 mm) on the hub face b.
7. Seat the J1 spring arbor (on hub face B) onto the hub face b.
8. Insert 4 × M3 x 12 SHCS from the opposite side.
9. Seat a Century Spring TO-5220RCS torsion spring (180 deg legs, right hand wind) onto each spring 1 on the arbor. Repeat on all 2.
10. Fit 4 × M3 brass heat-set insert (4.6 mm OD x 5.7 mm) on the hub face a.
11. Seat the Shoulder yoke onto the hub face a.
12. Insert 4 × M3 x 12 SHCS from the opposite side.

Torque 0.36 N·mA M3 x 14 SHCS · 4 x M3 x 14 socket head cap screw; 0.36 N·mA M3 x 12 SHCS · 4 x M3 x 12 socket head cap screwStep 15 of 42

PR0TOBOARD · UHDJJ-B-AG · Rev A · 2026-10-2435 / 116

Joyful Jack, Tier B, MidrangeAssembly guideJJ-B-AG

16

## Right arm: yoke and upper arm (shoulder-out and twist joints) (1 of 3)

mates: arm_r/arm_r_j2_servo_case_top, arm_r/arm_r_j2_servo_case_bottom, arm_r/arm_r_j2_driver_on_horn, arm_r/arm_r_j2_dowel_in_pulley, arm_r/arm_r_j2_driver_bearing_seat, arm_r/arm_r_j2_belt_on_pulley, arm_r/arm_r_j2_bearing_1_seat, arm_r/arm_r_j2_hub_in_bearing_1



A×1

6806-2RS ball bearing (30 x 42 x 7 mm)



B×1

Upper arm (J2 housing, J2 and J3 servos)



C×1

Feetech STS3215 12 V serial bus servo



D×1

Driver pulley, 20T GT3, on the STS horn



E×1

5 mm x 16 mm hardened steel dowel pin (ISO 8734)



F×1

625-2RS ball bearing (5 x 16 x 5 mm)



G×1

GT3 (3 mm pitch) closed belt, 240 mm (80 teeth), 9 mm wide



H×8

PA2.0 x 8 pan head self-tapping screw (for plastic)



J×4

M3 x 14 SHCS

Right arm: yoke and upper arm (shoulder-out and twist joints) (1 of 3): parts exploded along each joint's axis in stacking order; lettered as in the parts strip.

Figure 16Right arm: yoke and upper arm (shoulder-out and twist joints) (1 of 3): parts exploded along each joint's axis in stacking order; lettered as in the parts strip.

PR0TOBOARD · UHDJJ-B-AG · Rev A · 2026-10-2436 / 116

Joyful Jack, Tier B, MidrangeAssembly guideJJ-B-AG

1. Seat the Feetech STS3215 12 V serial bus servo onto the case top screw holes.
2. Insert 4 × PA2.0 x 8 pan head self-tapping screw (for plastic) from the opposite side.
3. Seat the Upper arm (J2 housing, J2 and J3 servos) onto the case bottom screw holes.
4. Insert 4 × PA2.0 x 8 pan head self-tapping screw (for plastic) from the opposite side.
5. Seat the Driver pulley, 20T GT3, on the STS horn onto the output horn.
6. Insert 4 × M3 x 14 SHCS from the opposite side.
7. Lower the 5 mm x 16 mm hardened steel dowel pin (ISO 8734) onto the dowel bore (—— gap).
8. Seat the 625-2RS ball bearing (5 x 16 x 5 mm) onto the J2 driver bearing seat (625).
9. Seat the GT3 (3 mm pitch) closed belt, 240 mm (80 teeth), 9 mm wide onto the belt plane.
10. Seat the Upper arm (J2 housing, J2 and J3 servos) onto the J2 bearing 1 seat.
11. Seat the 6806-2RS ball bearing (30 x 42 x 7 mm) onto the bore.

Torque 0.15 N·mA PA2.0 x 8 pan head self-tapping screw (for plastic) · 4 x PA2.0 x 8 pan head self-tapping screw (for plastic); 0.5 N·mA M3 x 14 SHCS · 4 x M3 x 14 socket head cap screwStep 16 of 42

CAUTION The torsion springs are preloaded once the legs bear on their stops: keep fingers clear of the legs when the arm swings up.

PR0TOBOARD · UHDJJ-B-AG · Rev A · 2026-10-2437 / 116

Joyful Jack, Tier B, MidrangeAssembly guideJJ-B-AG

17

## Right arm: yoke and upper arm (shoulder-out and twist joints) (2 of 3)

mates: arm_r/arm_r_j2_cap_on_drum, arm_r/arm_r_j2_bearing_2_in_cap, arm_r/arm_r_j2_hub_in_bearing_2, arm_r/arm_r_yoke_fork_face_a, arm_r/arm_r_yoke_fork_face_b, arm_r/arm_r_j3_servo_case_top, arm_r/arm_r_j3_servo_case_bottom, arm_r/arm_r_j3_bearing_up_seat



A×1

Belt-joint hub with 60T GT3 pulley (hollow, 14 mm bore)



B×2

6806-2RS ball bearing (30 x 42 x 7 mm)



C×1

Belt-joint bearing cap (60T housing)



D×1

Feetech STS3215 12 V serial bus servo



E×12

M3 brass heat-set insert (4.6 mm OD x 5.7 mm)



F×4

M3 x 14 SHCS



G×8

M3 x 12 SHCS



H×8

PA2.0 x 8 pan head self-tapping screw (for plastic)

Right arm: yoke and upper arm (shoulder-out and twist joints) (2 of 3): parts exploded along each joint's axis in stacking order; lettered as in the parts strip.

Figure 17Right arm: yoke and upper arm (shoulder-out and twist joints) (2 of 3): parts exploded along each joint's axis in stacking order; lettered as in the parts strip.

PR0TOBOARD · UHDJJ-B-AG · Rev A · 2026-10-2438 / 116

Joyful Jack, Tier B, MidrangeAssembly guideJJ-B-AG

1. Fit 4 × M3 brass heat-set insert (4.6 mm OD x 5.7 mm) on the J2 cap screws (4 x M3 inserts).
2. Seat the Belt-joint bearing cap (60T housing) onto the J2 cap screws (4 x M3 inserts).
3. Insert 4 × M3 x 14 SHCS from the opposite side.
4. Seat the 6806-2RS ball bearing (30 x 42 x 7 mm) onto the bearing 2 seat.
5. Seat the 6806-2RS ball bearing (30 x 42 x 7 mm) onto the bore.
6. Fit 4 × M3 brass heat-set insert (4.6 mm OD x 5.7 mm) on the hub face a.
7. Seat the Belt-joint hub with 60T GT3 pulley (hollow, 14 mm bore) onto the hub face a.
8. Insert 4 × M3 x 12 SHCS from the opposite side.
9. Fit 4 × M3 brass heat-set insert (4.6 mm OD x 5.7 mm) on the hub face b.
10. Seat the Shoulder yoke onto the hub face b.
11. Insert 4 × M3 x 12 SHCS from the opposite side.
12. Seat the Feetech STS3215 12 V serial bus servo onto the case top screw holes.
13. Drive 4 × PA2.0 x 8 pan head self-tapping screw (for plastic) from above, head down.
14. Seat the Upper arm (J2 housing, J2 and J3 servos) onto the case bottom screw holes.
15. Drive 4 × PA2.0 x 8 pan head self-tapping screw (for plastic) from above, head down.
16. Seat the 6806-2RS ball bearing (30 x 42 x 7 mm) onto the J3 upper bearing seat.

Torque 0.36 N·mA M3 x 14 SHCS · 4 x M3 x 14 socket head cap screw; 0.36 N·mA M3 x 12 SHCS · 4 x M3 x 12 socket head cap screw; 0.15 N·mA PA2.0 x 8 pan head self-tapping screw (for plastic) · 4 x PA2.0 x 8 pan head self-tapping screw (for plastic)Step 17 of 42

PR0TOBOARD · UHDJJ-B-AG · Rev A · 2026-10-2439 / 116

Joyful Jack, Tier B, MidrangeAssembly guideJJ-B-AG

18

## Right arm: yoke and upper arm (shoulder-out and twist joints) (3 of 3)

mates: arm_r/arm_r_j3_bearing_lo_seat, arm_r/arm_r_j3_disc_on_horn, arm_r/arm_r_j3_hub_in_bearing, arm_r/arm_r_j3_hub_to_disc, arm_r/arm_r_j2_arbor_on_yoke, arm_r/arm_r_j2_spring_0_on_arbor, arm_r/arm_r_j2_spring_1_on_arbor



A×1

J2 spring arbor (on the yoke's back fork arm)



B×2

Century Spring TO-5220RCS torsion spring (180 deg legs, right hand wind)



C×1

6806-2RS ball bearing (30 x 42 x 7 mm)



D×1

Twist-joint horn disc



E×1

Twist-joint hub (6806 pair)



F×4

M3 x 6 SHCS



G×7

M3 brass heat-set insert (4.6 mm OD x 5.7 mm)



H×3

M3 x 30 SHCS



J×4

M3 x 12 SHCS

Right arm: yoke and upper arm (shoulder-out and twist joints) (3 of 3): parts exploded along each joint's axis in stacking order; lettered as in the parts strip.

Figure 18Right arm: yoke and upper arm (shoulder-out and twist joints) (3 of 3): parts exploded along each joint's axis in stacking order; lettered as in the parts strip.

PR0TOBOARD · UHDJJ-B-AG · Rev A · 2026-10-2440 / 116

Joyful Jack, Tier B, MidrangeAssembly guideJJ-B-AG

1. Seat the 6806-2RS ball bearing (30 x 42 x 7 mm) onto the J3 lower bearing seat.
2. Seat the Twist-joint horn disc onto the output horn.
3. Drive 4 × M3 x 6 SHCS from above, head down.
4. Seat the Twist-joint hub (6806 pair) onto the bore.
5. Fit 3 × M3 brass heat-set insert (4.6 mm OD x 5.7 mm) on the hub screws (3 x M3 inserts).
6. Seat the Twist-joint hub (6806 pair) onto the hub screws (3 x M3 inserts).
7. Drive 3 × M3 x 30 SHCS from above, head down.
8. Fit 4 × M3 brass heat-set insert (4.6 mm OD x 5.7 mm) on the J2 spring arbor seat (4 x M3 inserts).
9. Seat the J2 spring arbor (on the yoke's back fork arm) onto the J2 spring arbor seat (4 x M3 inserts).
10. Insert 4 × M3 x 12 SHCS from the opposite side.
11. Seat a Century Spring TO-5220RCS torsion spring (180 deg legs, right hand wind) onto each spring 1 on the arbor. Repeat on all 2.

Torque 0.5 N·mA M3 x 6 SHCS · 4 x M3 x 6 socket head cap screw; 0.36 N·mA M3 x 30 SHCS · 3 x M3 x 30 socket head cap screw; 0.36 N·mA M3 x 12 SHCS · 4 x M3 x 12 socket head cap screwStep 18 of 42

PR0TOBOARD · UHDJJ-B-AG · Rev A · 2026-10-2441 / 116

Joyful Jack, Tier B, MidrangeAssembly guideJJ-B-AG

19

## Right arm: elbow housing and elbow drive (1 of 2)

mates: arm_r/arm_r_j4_servo_case_top, arm_r/arm_r_j4_servo_case_bottom, arm_r/arm_r_j4_driver_on_horn, arm_r/arm_r_j4_dowel_in_pulley, arm_r/arm_r_j4_driver_bearing_seat, arm_r/arm_r_j4_belt_on_pulley



A×1

Feetech STS3215 12 V serial bus servo



B×1

Driver pulley, 16T GT3, on the STS horn



C×1

5 mm x 16 mm hardened steel dowel pin (ISO 8734)



D×1

625-2RS ball bearing (5 x 16 x 5 mm)



E×1

GT3 (3 mm pitch) closed belt, 210 mm (70 teeth), 9 mm wide



F×8

PA2.0 x 8 pan head self-tapping screw (for plastic)



G×4

M3 x 14 SHCS

Right arm: elbow housing and elbow drive (1 of 2): parts exploded along each joint's axis in stacking order; lettered as in the parts strip.

Figure 19Right arm: elbow housing and elbow drive (1 of 2): parts exploded along each joint's axis in stacking order; lettered as in the parts strip.

1. Seat the Feetech STS3215 12 V serial bus servo onto the case top screw holes.
2. Insert 4 × PA2.0 x 8 pan head self-tapping screw (for plastic) from the opposite side.
3. Seat the Elbow housing (J4 drum and servo) onto the case bottom screw holes.
4. Insert 4 × PA2.0 x 8 pan head self-tapping screw (for plastic) from the opposite side.
5. Seat the Driver pulley, 16T GT3, on the STS horn onto the output horn.
6. Insert 4 × M3 x 14 SHCS from the opposite side.
7. Lower the 5 mm x 16 mm hardened steel dowel pin (ISO 8734) onto the dowel bore (—— gap).
8. Seat the 625-2RS ball bearing (5 x 16 x 5 mm) onto the J4 driver bearing seat (625).
9. Seat the GT3 (3 mm pitch) closed belt, 210 mm (70 teeth), 9 mm wide onto the belt plane.

PR0TOBOARD · UHDJJ-B-AG · Rev A · 2026-10-2442 / 116

Joyful Jack, Tier B, MidrangeAssembly guideJJ-B-AG

Torque 0.15 N·mA PA2.0 x 8 pan head self-tapping screw (for plastic) · 4 x PA2.0 x 8 pan head self-tapping screw (for plastic); 0.5 N·mA M3 x 14 SHCS · 4 x M3 x 14 socket head cap screwStep 19 of 42

20

## Right arm: elbow housing and elbow drive (2 of 2)

mates: arm_r/arm_r_j4_bearing_1_seat, arm_r/arm_r_j4_hub_in_bearing_1, arm_r/arm_r_j4_cap_on_drum, arm_r/arm_r_j4_bearing_2_in_cap, arm_r/arm_r_j4_hub_in_bearing_2, arm_r/arm_r_elbow_on_j3_hub



A×1

Elbow housing (J4 drum and servo)



B×2

6806-2RS ball bearing (30 x 42 x 7 mm)



C×1

Belt-joint hub with 48T GT3 pulley (hollow, 14 mm bore)



D×1

Belt-joint bearing cap (48T housing)



E×8

M3 brass heat-set insert (4.6 mm OD x 5.7 mm)



F×8

M3 x 14 SHCS

Right arm: elbow housing and elbow drive (2 of 2): parts exploded along each joint's axis in stacking order; lettered as in the parts strip.

Figure 20Right arm: elbow housing and elbow drive (2 of 2): parts exploded along each joint's axis in stacking order; lettered as in the parts strip.

1. Seat the 6806-2RS ball bearing (30 x 42 x 7 mm) onto the J4 bearing 1 seat.
2. Seat a Belt-joint hub with 48T GT3 pulley (hollow, 14 mm bore) onto each bore. Repeat on all 2.
3. Fit 4 × M3 brass heat-set insert (4.6 mm OD x 5.7 mm) on the J4 cap screws (4 x M3 inserts).
4. Seat the Belt-joint bearing cap (48T housing) onto the J4 cap screws (4 x M3 inserts).
5. Insert 4 × M3 x 14 SHCS from the opposite side.
6. Seat the 6806-2RS ball bearing (30 x 42 x 7 mm) onto the bearing 2 seat.
7. Fit 4 × M3 brass heat-set insert (4.6 mm OD x 5.7 mm) on the output face (under the flange).
8. Seat the Elbow housing (J4 drum and servo) onto the output face (under the flange).
9. Drive 4 × M3 x 14 SHCS from above, head down.

PR0TOBOARD · UHDJJ-B-AG · Rev A · 2026-10-2443 / 116

Joyful Jack, Tier B, MidrangeAssembly guideJJ-B-AG

Torque 0.36 N·mA M3 x 14 SHCS · 4 x M3 x 14 socket head cap screw; 0.36 N·mA M3 x 14 SHCS · 4 x M3 x 14 socket head cap screwStep 20 of 42

PR0TOBOARD · UHDJJ-B-AG · Rev A · 2026-10-2444 / 116

Joyful Jack, Tier B, MidrangeAssembly guideJJ-B-AG

21

## Right arm: forearm and wrist-twist joint (1 of 2)

mates: arm_r/arm_r_fork_in_on_j4, arm_r/arm_r_fork_out_on_j4, arm_r/arm_r_j5_servo_case_top, arm_r/arm_r_j5_servo_case_bottom, arm_r/arm_r_j5_bearing_up_seat, arm_r/arm_r_j5_bearing_lo_seat



A×1

Forearm fork plate (inboard)



B×1

Forearm fork plate (outboard)



C×1

Feetech STS3215 12 V serial bus servo



D×2

6806-2RS ball bearing (30 x 42 x 7 mm)



E×8

M3 brass heat-set insert (4.6 mm OD x 5.7 mm)



F×8

M3 x 12 SHCS



G×8

PA2.0 x 8 pan head self-tapping screw (for plastic)

Right arm: forearm and wrist-twist joint (1 of 2): parts exploded along each joint's axis in stacking order; lettered as in the parts strip.

Figure 21Right arm: forearm and wrist-twist joint (1 of 2): parts exploded along each joint's axis in stacking order; lettered as in the parts strip.

PR0TOBOARD · UHDJJ-B-AG · Rev A · 2026-10-2445 / 116

Joyful Jack, Tier B, MidrangeAssembly guideJJ-B-AG

1. Fit 4 × M3 brass heat-set insert (4.6 mm OD x 5.7 mm) on the hub face b.
2. Seat the Forearm fork plate (inboard) onto the hub face b.
3. Insert 4 × M3 x 12 SHCS from the opposite side.
4. Fit 4 × M3 brass heat-set insert (4.6 mm OD x 5.7 mm) on the hub face a.
5. Seat the Forearm fork plate (outboard) onto the hub face a.
6. Insert 4 × M3 x 12 SHCS from the opposite side.
7. Seat the Feetech STS3215 12 V serial bus servo onto the case top screw holes.
8. Drive 4 × PA2.0 x 8 pan head self-tapping screw (for plastic) from above, head down.
9. Seat the Forearm body (J5 servo and twist bearings) onto the case bottom screw holes.
10. Drive 4 × PA2.0 x 8 pan head self-tapping screw (for plastic) from above, head down.
11. Seat a 6806-2RS ball bearing (30 x 42 x 7 mm) onto each J5 upper bearing seat. Repeat on all 2.

Torque 0.36 N·mA M3 x 12 SHCS · 4 x M3 x 12 socket head cap screw; 0.15 N·mA PA2.0 x 8 pan head self-tapping screw (for plastic) · 4 x PA2.0 x 8 pan head self-tapping screw (for plastic)Step 21 of 42

PR0TOBOARD · UHDJJ-B-AG · Rev A · 2026-10-2446 / 116

Joyful Jack, Tier B, MidrangeAssembly guideJJ-B-AG

22

## Right arm: forearm and wrist-twist joint (2 of 2)

mates: arm_r/arm_r_j5_disc_on_horn, arm_r/arm_r_j5_hub_in_bearing, arm_r/arm_r_j5_hub_to_disc, arm_r/arm_r_fork_in_to_body, arm_r/arm_r_fork_out_to_body



A×1

Forearm body (J5 servo and twist bearings)



B×1

Twist-joint horn disc



C×1

Twist-joint hub (6806 pair)



D×4

M3 x 6 SHCS



E×7

M3 brass heat-set insert (4.6 mm OD x 5.7 mm)



F×3

M3 x 30 SHCS



G×4

M3 x 12 SHCS

Right arm: forearm and wrist-twist joint (2 of 2): parts exploded along each joint's axis in stacking order; lettered as in the parts strip.

Figure 22Right arm: forearm and wrist-twist joint (2 of 2): parts exploded along each joint's axis in stacking order; lettered as in the parts strip.

1. Seat the Twist-joint horn disc onto the output horn.
2. Drive 4 × M3 x 6 SHCS from above, head down.
3. Seat the Twist-joint hub (6806 pair) onto the bore.
4. Fit 3 × M3 brass heat-set insert (4.6 mm OD x 5.7 mm) on the hub screws (3 x M3 inserts).
5. Seat the Twist-joint hub (6806 pair) onto the hub screws (3 x M3 inserts).
6. Drive 3 × M3 x 30 SHCS from above, head down.
7. Fit 2 × M3 brass heat-set insert (4.6 mm OD x 5.7 mm) on the forearm body, fork in screws (2 x M3 inserts).
8. Seat the Forearm body (J5 servo and twist bearings) onto the forearm body, fork in screws (2 x M3 inserts).
9. Insert 2 × M3 x 12 SHCS from the opposite side.
10. Fit 2 × M3 brass heat-set insert (4.6 mm OD x 5.7 mm) on the forearm body, fork out screws (2 x M3 inserts).
11. Seat the Forearm fork plate (outboard) onto the forearm body, fork out screws (2 x M3 inserts).
12. Insert 2 × M3 x 12 SHCS from the opposite side.

PR0TOBOARD · UHDJJ-B-AG · Rev A · 2026-10-2447 / 116

Joyful Jack, Tier B, MidrangeAssembly guideJJ-B-AG

Torque 0.5 N·mA M3 x 6 SHCS · 4 x M3 x 6 socket head cap screw; 0.36 N·mA M3 x 30 SHCS · 3 x M3 x 30 socket head cap screw; 0.36 N·mA M3 x 12 SHCS · 2 x M3 x 12 socket head cap screwStep 22 of 42

23

## Right arm: hand (1 of 2)

mates: arm_r/arm_r_hand_palm_on_wrist, arm_r/arm_r_hand_fingers_servo_case_top, arm_r/arm_r_hand_fingers_servo_case_bottom, arm_r/arm_r_hand_thumb_servo_case_top, arm_r/arm_r_hand_thumb_servo_case_bottom



A×1

Glove hand palm



B×2

Feetech STS3215 12 V serial bus servo



C×4

M3 brass heat-set insert (4.6 mm OD x 5.7 mm)



D×4

M3 x 12 SHCS



E×16

PA2.0 x 6 pan head self-tapping screw (for plastic)

Right arm: hand (1 of 2): parts exploded along each joint's axis in stacking order; lettered as in the parts strip.

Figure 23Right arm: hand (1 of 2): parts exploded along each joint's axis in stacking order; lettered as in the parts strip.

1. Fit 4 × M3 brass heat-set insert (4.6 mm OD x 5.7 mm) on the output face (under the flange).
2. Seat the Glove hand palm onto the output face (under the flange).
3. Drive 4 × M3 x 12 SHCS from above, head down.
4. Seat a Feetech STS3215 12 V serial bus servo onto each case top screw holes.
5. Insert 4 × PA2.0 x 6 pan head self-tapping screw (for plastic) from the opposite side. Repeat on all 2.
6. Seat a Glove hand palm onto each case bottom screw holes.
7. Insert 4 × PA2.0 x 6 pan head self-tapping screw (for plastic) from the opposite side. Repeat on all 2.

Torque 0.36 N·mA M3 x 12 SHCS · 4 x M3 x 12 socket head cap screw; 0.15 N·mA PA2.0 x 6 pan head self-tapping screw (for plastic) · 4 x PA2.0 x 6 pan head self-tapping screw (for plastic)Step 23 of 42

PR0TOBOARD · UHDJJ-B-AG · Rev A · 2026-10-2448 / 116

Joyful Jack, Tier B, MidrangeAssembly guideJJ-B-AG

24

## Right arm: hand (2 of 2)

mates: arm_r/arm_r_hand_fingers_on_horn, arm_r/arm_r_hand_fingers_on_rear_horn, arm_r/arm_r_hand_thumb_on_horn, arm_r/arm_r_hand_thumb_on_rear_horn



A×1

Glove fingers (four, on one servo)



B×1

Glove thumb



C×16

M3 x 8 SHCS

Right arm: hand (2 of 2): parts exploded along each joint's axis in stacking order; lettered as in the parts strip.

Figure 24Right arm: hand (2 of 2): parts exploded along each joint's axis in stacking order; lettered as in the parts strip.

1. Seat a Glove fingers (four, on one servo) onto each output horn.
2. Insert 4 × M3 x 8 SHCS from the opposite side. Repeat on all 2.
3. Seat a Glove thumb onto each output horn.
4. Insert 4 × M3 x 8 SHCS from the opposite side. Repeat on all 2.

Torque 0.5 N·mA M3 x 8 SHCSStep 24 of 42

PR0TOBOARD · UHDJJ-B-AG · Rev A · 2026-10-2449 / 116

Joyful Jack, Tier B, MidrangeAssembly guideJJ-B-AG

25

## Left arm: shoulder housing, J1 servo, belt and springs (1 of 2)

mates: arm_l/arm_l_j1_servo_case_top, arm_l/arm_l_j1_servo_case_bottom, arm_l/arm_l_j1_driver_on_horn, arm_l/arm_l_j1_dowel_in_pulley, arm_l/arm_l_j1_driver_bearing_seat, arm_l/arm_l_j1_belt_on_pulley, arm_l/arm_l_j1_bearing_1_seat, arm_l/arm_l_j1_hub_in_bearing_1



A×1

Feetech STS3215 12 V serial bus servo



B×1

Driver pulley, 20T GT3, on the STS horn



C×1

5 mm x 16 mm hardened steel dowel pin (ISO 8734)



D×1

625-2RS ball bearing (5 x 16 x 5 mm)



E×1

GT3 (3 mm pitch) closed belt, 240 mm (80 teeth), 9 mm wide



F×1

6806-2RS ball bearing (30 x 42 x 7 mm)



G×1

Belt-joint hub with 60T GT3 pulley (hollow, 14 mm bore)



H×8

PA2.0 x 8 pan head self-tapping screw (for plastic)



J×4

M3 x 14 SHCS

Left arm: shoulder housing, J1 servo, belt and springs (1 of 2): parts exploded along each joint's axis in stacking order; lettered as in the parts strip.

Figure 25Left arm: shoulder housing, J1 servo, belt and springs (1 of 2): parts exploded along each joint's axis in stacking order; lettered as in the parts strip.

PR0TOBOARD · UHDJJ-B-AG · Rev A · 2026-10-2450 / 116

Joyful Jack, Tier B, MidrangeAssembly guideJJ-B-AG

1. Seat the Feetech STS3215 12 V serial bus servo onto the case top screw holes.
2. Insert 4 × PA2.0 x 8 pan head self-tapping screw (for plastic) from the opposite side.
3. Seat the J1 shoulder housing (on the torso) onto the case bottom screw holes.
4. Insert 4 × PA2.0 x 8 pan head self-tapping screw (for plastic) from the opposite side.
5. Seat the Driver pulley, 20T GT3, on the STS horn onto the output horn.
6. Insert 4 × M3 x 14 SHCS from the opposite side.
7. Lower the 5 mm x 16 mm hardened steel dowel pin (ISO 8734) onto the dowel bore (—— gap).
8. Seat the 625-2RS ball bearing (5 x 16 x 5 mm) onto the J1 driver bearing seat (625).
9. Seat the GT3 (3 mm pitch) closed belt, 240 mm (80 teeth), 9 mm wide onto the belt plane.
10. Seat the 6806-2RS ball bearing (30 x 42 x 7 mm) onto the J1 bearing 1 seat.
11. Seat the Belt-joint hub with 60T GT3 pulley (hollow, 14 mm bore) onto the bore.

Torque 0.15 N·mA PA2.0 x 8 pan head self-tapping screw (for plastic) · 4 x PA2.0 x 8 pan head self-tapping screw (for plastic); 0.5 N·mA M3 x 14 SHCS · 4 x M3 x 14 socket head cap screwStep 25 of 42

PR0TOBOARD · UHDJJ-B-AG · Rev A · 2026-10-2451 / 116

Joyful Jack, Tier B, MidrangeAssembly guideJJ-B-AG

26

## Left arm: shoulder housing, J1 servo, belt and springs (2 of 2)

mates: arm_l/arm_l_j1_cap_on_drum, arm_l/arm_l_j1_bearing_2_in_cap, arm_l/arm_l_j1_hub_in_bearing_2, arm_l/arm_l_j1_arbor_on_hub, arm_l/arm_l_j1_spring_0_on_arbor, arm_l/arm_l_j1_spring_1_on_arbor, arm_l/arm_l_yoke_on_j1_hub



A×1

Belt-joint bearing cap (60T housing)



B×1

6806-2RS ball bearing (30 x 42 x 7 mm)



C×1

J1 spring arbor (on hub face B)



D×2

Century Spring TO-5220RCS torsion spring (180 deg legs, right hand wind)



E×1

Shoulder yoke



F×12

M3 brass heat-set insert (4.6 mm OD x 5.7 mm)



G×4

M3 x 14 SHCS



H×8

M3 x 12 SHCS

Left arm: shoulder housing, J1 servo, belt and springs (2 of 2): parts exploded along each joint's axis in stacking order; lettered as in the parts strip.

Figure 26Left arm: shoulder housing, J1 servo, belt and springs (2 of 2): parts exploded along each joint's axis in stacking order; lettered as in the parts strip.

PR0TOBOARD · UHDJJ-B-AG · Rev A · 2026-10-2452 / 116

Joyful Jack, Tier B, MidrangeAssembly guideJJ-B-AG

1. Fit 4 × M3 brass heat-set insert (4.6 mm OD x 5.7 mm) on the J1 cap screws (4 x M3 inserts).
2. Seat the Belt-joint bearing cap (60T housing) onto the J1 cap screws (4 x M3 inserts).
3. Insert 4 × M3 x 14 SHCS from the opposite side.
4. Seat the 6806-2RS ball bearing (30 x 42 x 7 mm) onto the bearing 2 seat.
5. Seat the Belt-joint hub with 60T GT3 pulley (hollow, 14 mm bore) onto the bore.
6. Fit 4 × M3 brass heat-set insert (4.6 mm OD x 5.7 mm) on the hub face b.
7. Seat the J1 spring arbor (on hub face B) onto the hub face b.
8. Insert 4 × M3 x 12 SHCS from the opposite side.
9. Seat a Century Spring TO-5220RCS torsion spring (180 deg legs, right hand wind) onto each spring 1 on the arbor. Repeat on all 2.
10. Fit 4 × M3 brass heat-set insert (4.6 mm OD x 5.7 mm) on the hub face a.
11. Seat the Shoulder yoke onto the hub face a.
12. Insert 4 × M3 x 12 SHCS from the opposite side.

Torque 0.36 N·mA M3 x 14 SHCS · 4 x M3 x 14 socket head cap screw; 0.36 N·mA M3 x 12 SHCS · 4 x M3 x 12 socket head cap screwStep 26 of 42

PR0TOBOARD · UHDJJ-B-AG · Rev A · 2026-10-2453 / 116

Joyful Jack, Tier B, MidrangeAssembly guideJJ-B-AG

27

## Left arm: yoke and upper arm (shoulder-out and twist joints) (1 of 3)

mates: arm_l/arm_l_j2_servo_case_top, arm_l/arm_l_j2_servo_case_bottom, arm_l/arm_l_j2_driver_on_horn, arm_l/arm_l_j2_dowel_in_pulley, arm_l/arm_l_j2_driver_bearing_seat, arm_l/arm_l_j2_belt_on_pulley, arm_l/arm_l_j2_bearing_1_seat, arm_l/arm_l_j2_hub_in_bearing_1



A×1

6806-2RS ball bearing (30 x 42 x 7 mm)



B×1

Upper arm (J2 housing, J2 and J3 servos)



C×1

Feetech STS3215 12 V serial bus servo



D×1

Driver pulley, 20T GT3, on the STS horn



E×1

5 mm x 16 mm hardened steel dowel pin (ISO 8734)



F×1

625-2RS ball bearing (5 x 16 x 5 mm)



G×1

GT3 (3 mm pitch) closed belt, 240 mm (80 teeth), 9 mm wide



H×8

PA2.0 x 8 pan head self-tapping screw (for plastic)



J×4

M3 x 14 SHCS

Left arm: yoke and upper arm (shoulder-out and twist joints) (1 of 3): parts exploded along each joint's axis in stacking order; lettered as in the parts strip.

Figure 27Left arm: yoke and upper arm (shoulder-out and twist joints) (1 of 3): parts exploded along each joint's axis in stacking order; lettered as in the parts strip.

PR0TOBOARD · UHDJJ-B-AG · Rev A · 2026-10-2454 / 116

Joyful Jack, Tier B, MidrangeAssembly guideJJ-B-AG

1. Seat the Feetech STS3215 12 V serial bus servo onto the case top screw holes.
2. Insert 4 × PA2.0 x 8 pan head self-tapping screw (for plastic) from the opposite side.
3. Seat the Upper arm (J2 housing, J2 and J3 servos) onto the case bottom screw holes.
4. Insert 4 × PA2.0 x 8 pan head self-tapping screw (for plastic) from the opposite side.
5. Seat the Driver pulley, 20T GT3, on the STS horn onto the output horn.
6. Insert 4 × M3 x 14 SHCS from the opposite side.
7. Lower the 5 mm x 16 mm hardened steel dowel pin (ISO 8734) onto the dowel bore (—— gap).
8. Seat the 625-2RS ball bearing (5 x 16 x 5 mm) onto the J2 driver bearing seat (625).
9. Seat the GT3 (3 mm pitch) closed belt, 240 mm (80 teeth), 9 mm wide onto the belt plane.
10. Seat the Upper arm (J2 housing, J2 and J3 servos) onto the J2 bearing 1 seat.
11. Seat the 6806-2RS ball bearing (30 x 42 x 7 mm) onto the bore.

Torque 0.15 N·mA PA2.0 x 8 pan head self-tapping screw (for plastic) · 4 x PA2.0 x 8 pan head self-tapping screw (for plastic); 0.5 N·mA M3 x 14 SHCS · 4 x M3 x 14 socket head cap screwStep 27 of 42

PR0TOBOARD · UHDJJ-B-AG · Rev A · 2026-10-2455 / 116

Joyful Jack, Tier B, MidrangeAssembly guideJJ-B-AG

28

## Left arm: yoke and upper arm (shoulder-out and twist joints) (2 of 3)

mates: arm_l/arm_l_j2_cap_on_drum, arm_l/arm_l_j2_bearing_2_in_cap, arm_l/arm_l_j2_hub_in_bearing_2, arm_l/arm_l_yoke_fork_face_a, arm_l/arm_l_yoke_fork_face_b, arm_l/arm_l_j3_servo_case_top, arm_l/arm_l_j3_servo_case_bottom, arm_l/arm_l_j3_bearing_up_seat



A×1

Belt-joint hub with 60T GT3 pulley (hollow, 14 mm bore)



B×2

6806-2RS ball bearing (30 x 42 x 7 mm)



C×1

Belt-joint bearing cap (60T housing)



D×1

Feetech STS3215 12 V serial bus servo



E×12

M3 brass heat-set insert (4.6 mm OD x 5.7 mm)



F×4

M3 x 14 SHCS



G×8

M3 x 12 SHCS



H×8

PA2.0 x 8 pan head self-tapping screw (for plastic)

Left arm: yoke and upper arm (shoulder-out and twist joints) (2 of 3): parts exploded along each joint's axis in stacking order; lettered as in the parts strip.

Figure 28Left arm: yoke and upper arm (shoulder-out and twist joints) (2 of 3): parts exploded along each joint's axis in stacking order; lettered as in the parts strip.

PR0TOBOARD · UHDJJ-B-AG · Rev A · 2026-10-2456 / 116

Joyful Jack, Tier B, MidrangeAssembly guideJJ-B-AG

1. Fit 4 × M3 brass heat-set insert (4.6 mm OD x 5.7 mm) on the J2 cap screws (4 x M3 inserts).
2. Seat the Belt-joint bearing cap (60T housing) onto the J2 cap screws (4 x M3 inserts).
3. Insert 4 × M3 x 14 SHCS from the opposite side.
4. Seat the 6806-2RS ball bearing (30 x 42 x 7 mm) onto the bearing 2 seat.
5. Seat the 6806-2RS ball bearing (30 x 42 x 7 mm) onto the bore.
6. Fit 4 × M3 brass heat-set insert (4.6 mm OD x 5.7 mm) on the hub face a.
7. Seat the Belt-joint hub with 60T GT3 pulley (hollow, 14 mm bore) onto the hub face a.
8. Insert 4 × M3 x 12 SHCS from the opposite side.
9. Fit 4 × M3 brass heat-set insert (4.6 mm OD x 5.7 mm) on the hub face b.
10. Seat the Shoulder yoke onto the hub face b.
11. Insert 4 × M3 x 12 SHCS from the opposite side.
12. Seat the Feetech STS3215 12 V serial bus servo onto the case top screw holes.
13. Drive 4 × PA2.0 x 8 pan head self-tapping screw (for plastic) from above, head down.
14. Seat the Upper arm (J2 housing, J2 and J3 servos) onto the case bottom screw holes.
15. Drive 4 × PA2.0 x 8 pan head self-tapping screw (for plastic) from above, head down.
16. Seat the 6806-2RS ball bearing (30 x 42 x 7 mm) onto the J3 upper bearing seat.

Torque 0.36 N·mA M3 x 14 SHCS · 4 x M3 x 14 socket head cap screw; 0.36 N·mA M3 x 12 SHCS · 4 x M3 x 12 socket head cap screw; 0.15 N·mA PA2.0 x 8 pan head self-tapping screw (for plastic) · 4 x PA2.0 x 8 pan head self-tapping screw (for plastic)Step 28 of 42

PR0TOBOARD · UHDJJ-B-AG · Rev A · 2026-10-2457 / 116

Joyful Jack, Tier B, MidrangeAssembly guideJJ-B-AG

29

## Left arm: yoke and upper arm (shoulder-out and twist joints) (3 of 3)

mates: arm_l/arm_l_j3_bearing_lo_seat, arm_l/arm_l_j3_disc_on_horn, arm_l/arm_l_j3_hub_in_bearing, arm_l/arm_l_j3_hub_to_disc, arm_l/arm_l_j2_arbor_on_yoke, arm_l/arm_l_j2_spring_0_on_arbor, arm_l/arm_l_j2_spring_1_on_arbor



A×1

J2 spring arbor (on the yoke's back fork arm)



B×2

Century Spring TO-5220RCS torsion spring (180 deg legs, right hand wind)



C×1

6806-2RS ball bearing (30 x 42 x 7 mm)



D×1

Twist-joint horn disc



E×1

Twist-joint hub (6806 pair)



F×4

M3 x 6 SHCS



G×7

M3 brass heat-set insert (4.6 mm OD x 5.7 mm)



H×3

M3 x 30 SHCS



J×4

M3 x 12 SHCS

Left arm: yoke and upper arm (shoulder-out and twist joints) (3 of 3): parts exploded along each joint's axis in stacking order; lettered as in the parts strip.

Figure 29Left arm: yoke and upper arm (shoulder-out and twist joints) (3 of 3): parts exploded along each joint's axis in stacking order; lettered as in the parts strip.

PR0TOBOARD · UHDJJ-B-AG · Rev A · 2026-10-2458 / 116

Joyful Jack, Tier B, MidrangeAssembly guideJJ-B-AG

1. Seat the 6806-2RS ball bearing (30 x 42 x 7 mm) onto the J3 lower bearing seat.
2. Seat the Twist-joint horn disc onto the output horn.
3. Drive 4 × M3 x 6 SHCS from above, head down.
4. Seat the Twist-joint hub (6806 pair) onto the bore.
5. Fit 3 × M3 brass heat-set insert (4.6 mm OD x 5.7 mm) on the hub screws (3 x M3 inserts).
6. Seat the Twist-joint hub (6806 pair) onto the hub screws (3 x M3 inserts).
7. Drive 3 × M3 x 30 SHCS from above, head down.
8. Fit 4 × M3 brass heat-set insert (4.6 mm OD x 5.7 mm) on the J2 spring arbor seat (4 x M3 inserts).
9. Seat the J2 spring arbor (on the yoke's back fork arm) onto the J2 spring arbor seat (4 x M3 inserts).
10. Insert 4 × M3 x 12 SHCS from the opposite side.
11. Seat a Century Spring TO-5220RCS torsion spring (180 deg legs, right hand wind) onto each spring 1 on the arbor. Repeat on all 2.

Torque 0.5 N·mA M3 x 6 SHCS · 4 x M3 x 6 socket head cap screw; 0.36 N·mA M3 x 30 SHCS · 3 x M3 x 30 socket head cap screw; 0.36 N·mA M3 x 12 SHCS · 4 x M3 x 12 socket head cap screwStep 29 of 42

PR0TOBOARD · UHDJJ-B-AG · Rev A · 2026-10-2459 / 116

Joyful Jack, Tier B, MidrangeAssembly guideJJ-B-AG

30

## Left arm: elbow housing and elbow drive (1 of 2)

mates: arm_l/arm_l_j4_servo_case_top, arm_l/arm_l_j4_servo_case_bottom, arm_l/arm_l_j4_driver_on_horn, arm_l/arm_l_j4_dowel_in_pulley, arm_l/arm_l_j4_driver_bearing_seat, arm_l/arm_l_j4_belt_on_pulley



A×1

Feetech STS3215 12 V serial bus servo



B×1

Driver pulley, 16T GT3, on the STS horn



C×1

5 mm x 16 mm hardened steel dowel pin (ISO 8734)



D×1

625-2RS ball bearing (5 x 16 x 5 mm)



E×1

GT3 (3 mm pitch) closed belt, 210 mm (70 teeth), 9 mm wide



F×8

PA2.0 x 8 pan head self-tapping screw (for plastic)



G×4

M3 x 14 SHCS

Left arm: elbow housing and elbow drive (1 of 2): parts exploded along each joint's axis in stacking order; lettered as in the parts strip.

Figure 30Left arm: elbow housing and elbow drive (1 of 2): parts exploded along each joint's axis in stacking order; lettered as in the parts strip.

1. Seat the Feetech STS3215 12 V serial bus servo onto the case top screw holes.
2. Insert 4 × PA2.0 x 8 pan head self-tapping screw (for plastic) from the opposite side.
3. Seat the Elbow housing (J4 drum and servo) onto the case bottom screw holes.
4. Insert 4 × PA2.0 x 8 pan head self-tapping screw (for plastic) from the opposite side.
5. Seat the Driver pulley, 16T GT3, on the STS horn onto the output horn.
6. Insert 4 × M3 x 14 SHCS from the opposite side.
7. Lower the 5 mm x 16 mm hardened steel dowel pin (ISO 8734) onto the dowel bore (—— gap).
8. Seat the 625-2RS ball bearing (5 x 16 x 5 mm) onto the J4 driver bearing seat (625).
9. Seat the GT3 (3 mm pitch) closed belt, 210 mm (70 teeth), 9 mm wide onto the belt plane.

PR0TOBOARD · UHDJJ-B-AG · Rev A · 2026-10-2460 / 116

Joyful Jack, Tier B, MidrangeAssembly guideJJ-B-AG

Torque 0.15 N·mA PA2.0 x 8 pan head self-tapping screw (for plastic) · 4 x PA2.0 x 8 pan head self-tapping screw (for plastic); 0.5 N·mA M3 x 14 SHCS · 4 x M3 x 14 socket head cap screwStep 30 of 42

31

## Left arm: elbow housing and elbow drive (2 of 2)

mates: arm_l/arm_l_j4_bearing_1_seat, arm_l/arm_l_j4_hub_in_bearing_1, arm_l/arm_l_j4_cap_on_drum, arm_l/arm_l_j4_bearing_2_in_cap, arm_l/arm_l_j4_hub_in_bearing_2, arm_l/arm_l_elbow_on_j3_hub



A×1

Elbow housing (J4 drum and servo)



B×2

6806-2RS ball bearing (30 x 42 x 7 mm)



C×1

Belt-joint hub with 48T GT3 pulley (hollow, 14 mm bore)



D×1

Belt-joint bearing cap (48T housing)



E×8

M3 brass heat-set insert (4.6 mm OD x 5.7 mm)



F×8

M3 x 14 SHCS

Left arm: elbow housing and elbow drive (2 of 2): parts exploded along each joint's axis in stacking order; lettered as in the parts strip.

Figure 31Left arm: elbow housing and elbow drive (2 of 2): parts exploded along each joint's axis in stacking order; lettered as in the parts strip.

1. Seat the 6806-2RS ball bearing (30 x 42 x 7 mm) onto the J4 bearing 1 seat.
2. Seat a Belt-joint hub with 48T GT3 pulley (hollow, 14 mm bore) onto each bore. Repeat on all 2.
3. Fit 4 × M3 brass heat-set insert (4.6 mm OD x 5.7 mm) on the J4 cap screws (4 x M3 inserts).
4. Seat the Belt-joint bearing cap (48T housing) onto the J4 cap screws (4 x M3 inserts).
5. Insert 4 × M3 x 14 SHCS from the opposite side.
6. Seat the 6806-2RS ball bearing (30 x 42 x 7 mm) onto the bearing 2 seat.
7. Fit 4 × M3 brass heat-set insert (4.6 mm OD x 5.7 mm) on the output face (under the flange).
8. Seat the Elbow housing (J4 drum and servo) onto the output face (under the flange).
9. Drive 4 × M3 x 14 SHCS from above, head down.

PR0TOBOARD · UHDJJ-B-AG · Rev A · 2026-10-2461 / 116

Joyful Jack, Tier B, MidrangeAssembly guideJJ-B-AG

Torque 0.36 N·mA M3 x 14 SHCS · 4 x M3 x 14 socket head cap screw; 0.36 N·mA M3 x 14 SHCS · 4 x M3 x 14 socket head cap screwStep 31 of 42

PR0TOBOARD · UHDJJ-B-AG · Rev A · 2026-10-2462 / 116

Joyful Jack, Tier B, MidrangeAssembly guideJJ-B-AG

32

## Left arm: forearm and wrist-twist joint (1 of 2)

mates: arm_l/arm_l_fork_in_on_j4, arm_l/arm_l_fork_out_on_j4, arm_l/arm_l_j5_servo_case_top, arm_l/arm_l_j5_servo_case_bottom, arm_l/arm_l_j5_bearing_up_seat, arm_l/arm_l_j5_bearing_lo_seat



A×1

Forearm fork plate (inboard)



B×1

Forearm fork plate (outboard)



C×1

Feetech STS3215 12 V serial bus servo



D×2

6806-2RS ball bearing (30 x 42 x 7 mm)



E×8

M3 brass heat-set insert (4.6 mm OD x 5.7 mm)



F×8

M3 x 12 SHCS



G×8

PA2.0 x 8 pan head self-tapping screw (for plastic)

Left arm: forearm and wrist-twist joint (1 of 2): parts exploded along each joint's axis in stacking order; lettered as in the parts strip.

Figure 32Left arm: forearm and wrist-twist joint (1 of 2): parts exploded along each joint's axis in stacking order; lettered as in the parts strip.

PR0TOBOARD · UHDJJ-B-AG · Rev A · 2026-10-2463 / 116

Joyful Jack, Tier B, MidrangeAssembly guideJJ-B-AG

1. Fit 4 × M3 brass heat-set insert (4.6 mm OD x 5.7 mm) on the hub face b.
2. Seat the Forearm fork plate (inboard) onto the hub face b.
3. Insert 4 × M3 x 12 SHCS from the opposite side.
4. Fit 4 × M3 brass heat-set insert (4.6 mm OD x 5.7 mm) on the hub face a.
5. Seat the Forearm fork plate (outboard) onto the hub face a.
6. Insert 4 × M3 x 12 SHCS from the opposite side.
7. Seat the Feetech STS3215 12 V serial bus servo onto the case top screw holes.
8. Drive 4 × PA2.0 x 8 pan head self-tapping screw (for plastic) from above, head down.
9. Seat the Forearm body (J5 servo and twist bearings) onto the case bottom screw holes.
10. Drive 4 × PA2.0 x 8 pan head self-tapping screw (for plastic) from above, head down.
11. Seat a 6806-2RS ball bearing (30 x 42 x 7 mm) onto each J5 upper bearing seat. Repeat on all 2.

Torque 0.36 N·mA M3 x 12 SHCS · 4 x M3 x 12 socket head cap screw; 0.15 N·mA PA2.0 x 8 pan head self-tapping screw (for plastic) · 4 x PA2.0 x 8 pan head self-tapping screw (for plastic)Step 32 of 42

PR0TOBOARD · UHDJJ-B-AG · Rev A · 2026-10-2464 / 116

Joyful Jack, Tier B, MidrangeAssembly guideJJ-B-AG

33

## Left arm: forearm and wrist-twist joint (2 of 2)

mates: arm_l/arm_l_j5_disc_on_horn, arm_l/arm_l_j5_hub_in_bearing, arm_l/arm_l_j5_hub_to_disc, arm_l/arm_l_fork_in_to_body, arm_l/arm_l_fork_out_to_body



A×1

Forearm body (J5 servo and twist bearings)



B×1

Twist-joint horn disc



C×1

Twist-joint hub (6806 pair)



D×4

M3 x 6 SHCS



E×7

M3 brass heat-set insert (4.6 mm OD x 5.7 mm)



F×3

M3 x 30 SHCS



G×4

M3 x 12 SHCS

Left arm: forearm and wrist-twist joint (2 of 2): parts exploded along each joint's axis in stacking order; lettered as in the parts strip.

Figure 33Left arm: forearm and wrist-twist joint (2 of 2): parts exploded along each joint's axis in stacking order; lettered as in the parts strip.

1. Seat the Twist-joint horn disc onto the output horn.
2. Drive 4 × M3 x 6 SHCS from above, head down.
3. Seat the Twist-joint hub (6806 pair) onto the bore.
4. Fit 3 × M3 brass heat-set insert (4.6 mm OD x 5.7 mm) on the hub screws (3 x M3 inserts).
5. Seat the Twist-joint hub (6806 pair) onto the hub screws (3 x M3 inserts).
6. Drive 3 × M3 x 30 SHCS from above, head down.
7. Fit 2 × M3 brass heat-set insert (4.6 mm OD x 5.7 mm) on the forearm body, fork in screws (2 x M3 inserts).
8. Seat the Forearm body (J5 servo and twist bearings) onto the forearm body, fork in screws (2 x M3 inserts).
9. Insert 2 × M3 x 12 SHCS from the opposite side.
10. Fit 2 × M3 brass heat-set insert (4.6 mm OD x 5.7 mm) on the forearm body, fork out screws (2 x M3 inserts).
11. Seat the Forearm fork plate (outboard) onto the forearm body, fork out screws (2 x M3 inserts).
12. Insert 2 × M3 x 12 SHCS from the opposite side.

PR0TOBOARD · UHDJJ-B-AG · Rev A · 2026-10-2465 / 116

Joyful Jack, Tier B, MidrangeAssembly guideJJ-B-AG

Torque 0.5 N·mA M3 x 6 SHCS · 4 x M3 x 6 socket head cap screw; 0.36 N·mA M3 x 30 SHCS · 3 x M3 x 30 socket head cap screw; 0.36 N·mA M3 x 12 SHCS · 2 x M3 x 12 socket head cap screwStep 33 of 42

34

## Left arm: hand (1 of 2)

mates: arm_l/arm_l_hand_palm_on_wrist, arm_l/arm_l_hand_fingers_servo_case_top, arm_l/arm_l_hand_fingers_servo_case_bottom, arm_l/arm_l_hand_thumb_servo_case_top, arm_l/arm_l_hand_thumb_servo_case_bottom



A×1

Glove hand palm (left)



B×2

Feetech STS3215 12 V serial bus servo



C×4

M3 brass heat-set insert (4.6 mm OD x 5.7 mm)



D×4

M3 x 12 SHCS



E×16

PA2.0 x 6 pan head self-tapping screw (for plastic)

Left arm: hand (1 of 2): parts exploded along each joint's axis in stacking order; lettered as in the parts strip.

Figure 34Left arm: hand (1 of 2): parts exploded along each joint's axis in stacking order; lettered as in the parts strip.

1. Fit 4 × M3 brass heat-set insert (4.6 mm OD x 5.7 mm) on the output face (under the flange).
2. Seat the Glove hand palm (left) onto the output face (under the flange).
3. Drive 4 × M3 x 12 SHCS from above, head down.
4. Seat a Feetech STS3215 12 V serial bus servo onto each case top screw holes.
5. Insert 4 × PA2.0 x 6 pan head self-tapping screw (for plastic) from the opposite side. Repeat on all 2.
6. Seat a Glove hand palm (left) onto each case bottom screw holes.
7. Insert 4 × PA2.0 x 6 pan head self-tapping screw (for plastic) from the opposite side. Repeat on all 2.

Torque 0.36 N·mA M3 x 12 SHCS · 4 x M3 x 12 socket head cap screw; 0.15 N·mA PA2.0 x 6 pan head self-tapping screw (for plastic) · 4 x PA2.0 x 6 pan head self-tapping screw (for plastic)Step 34 of 42

PR0TOBOARD · UHDJJ-B-AG · Rev A · 2026-10-2466 / 116

Joyful Jack, Tier B, MidrangeAssembly guideJJ-B-AG

35

## Left arm: hand (2 of 2)

mates: arm_l/arm_l_hand_fingers_on_horn, arm_l/arm_l_hand_fingers_on_rear_horn, arm_l/arm_l_hand_thumb_on_horn, arm_l/arm_l_hand_thumb_on_rear_horn



A×1

Glove fingers (four, on one servo) (left)



B×1

Glove thumb (left)



C×16

M3 x 8 SHCS

Left arm: hand (2 of 2): parts exploded along each joint's axis in stacking order; lettered as in the parts strip.

Figure 35Left arm: hand (2 of 2): parts exploded along each joint's axis in stacking order; lettered as in the parts strip.

1. Seat a Glove fingers (four, on one servo) (left) onto each output horn.
2. Insert 4 × M3 x 8 SHCS from the opposite side. Repeat on all 2.
3. Seat a Glove thumb (left) onto each output horn.
4. Insert 4 × M3 x 8 SHCS from the opposite side. Repeat on all 2.

Torque 0.5 N·mA M3 x 8 SHCSStep 35 of 42

PR0TOBOARD · UHDJJ-B-AG · Rev A · 2026-10-2467 / 116

Joyful Jack, Tier B, MidrangeAssembly guideJJ-B-AG

36

## Mount the arms on the torso

mates: arm_r_foot, arm_l_foot



A×2

J1 shoulder housing (on the torso)



B×4

M5 roll-in T-nut for 2020 extrusion



C×4

M5 x 12 SHCS

Mount the arms on the torso: parts exploded along each joint's axis in stacking order; lettered as in the parts strip.

Figure 36Mount the arms on the torso: parts exploded along each joint's axis in stacking order; lettered as in the parts strip.

1. Finish with 2 × M5 roll-in T-nut for 2020 extrusion; tighten until snug.
2. Seat the J1 shoulder housing (on the torso) onto the T-slot (bracket f).
3. Drive 2 × M5 x 12 SHCS from above, head down.
4. Finish with 2 × M5 roll-in T-nut for 2020 extrusion; tighten until snug.
5. Seat the J1 shoulder housing (on the torso) onto the T-slot (bracket f).
6. Drive 2 × M5 x 12 SHCS from above, head down.

Torque 2.5 N·mA M5 x 12 SHCSTools 10 mm nut driverStep 36 of 42

PR0TOBOARD · UHDJJ-B-AG · Rev A · 2026-10-2468 / 116

Joyful Jack, Tier B, MidrangeAssembly guideJJ-B-AG

37

## Fit the head on the neck plate

mates: head_on_neck_plate



A×1

Head



B×4

M5 flat washer, ISO 7089



C×4

M5 nyloc hex nut, ISO 10511



D×4

M5 x 20 SHCS

Fit the head on the neck plate: parts exploded along each joint's axis in stacking order; lettered as in the parts strip.

Figure 37Fit the head on the neck plate: parts exploded along each joint's axis in stacking order; lettered as in the parts strip.

1. Fit 4 × M5 flat washer, ISO 7089 on the head base (4 x M5, drill to match the head).
2. Hold 4 × M5 nyloc hex nut, ISO 10511 under the head base (4 x M5, drill to match the head).
3. Seat the Head onto the head base (4 x M5, drill to match the head).
4. Drive 4 × M5 x 20 SHCS from above, head down.

Torque 2.5 N·mA M5 nyloc hex nut, ISO 10511Tools 8 mm nut driverStep 37 of 42

WARNING The head's base screw pattern is not in the received CAD: mark and drill the neck plate from the head itself before this step.

PR0TOBOARD · UHDJJ-B-AG · Rev A · 2026-10-2469 / 116

Joyful Jack, Tier B, MidrangeAssembly guideJJ-B-AG

38

## Slide the battery packs onto the docks

mates: pack_1_on_dock_1, pack_2_on_dock_2



A×2

Milwaukee M18 REDLITHIUM pack (owned)

Slide the battery packs onto the docks: parts exploded along each joint's axis in stacking order; lettered as in the parts strip.

Figure 38Slide the battery packs onto the docks: parts exploded along each joint's axis in stacking order; lettered as in the parts strip.

1. Seat a Milwaukee M18 REDLITHIUM pack (owned) onto each pack rail (the pack slides on from the back). Repeat on all 2.

Step 38 of 42

CAUTION Fit the packs last, with the E-stop pressed in, after the wiring has been checked.

PR0TOBOARD · UHDJJ-B-AG · Rev A · 2026-10-2470 / 116

Joyful Jack, Tier B, MidrangeAssembly guideJJ-B-AG

39

## Wire the right arm: servo bus and power

links: arm_r_12v, arm_r_gnd, arm_r_usb, arm_r/shoulder_flex_bus, arm_r/shoulder_flex_vplus, arm_r/shoulder_flex_gnd, arm_r/shoulder_out_bus, arm_r/shoulder_out_vplus, arm_r/shoulder_out_gnd, arm_r/upper_twist_bus, arm_r/upper_twist_vplus, arm_r/upper_twist_gnd, arm_r/elbow_bus, arm_r/elbow_vplus, arm_r/elbow_gnd, arm_r/wrist_twist_bus, arm_r/wrist_twist_vplus, arm_r/wrist_twist_gnd, arm_r/fingers_bus, arm_r/fingers_vplus, arm_r/fingers_gnd, arm_r/thumb_bus, arm_r/thumb_vplus, arm_r/thumb_gnd

A×1

Raspberry Pi 4 Model B

Figure 39Pad-to-pad connections from the stored links (wiringChecklist); crossovers in accent.

PR0TOBOARD · UHDJJ-B-AG · Rev A · 2026-10-2471 / 116

Joyful Jack, Tier B, MidrangeAssembly guideJJ-B-AG

1. Connect arm_r_12v, arm_r_gnd, USB to the right arm's bus, shoulder_flex bus, shoulder_flex V+, shoulder_flex GND, shoulder_out bus, shoulder_out V+, shoulder_out GND, upper_twist bus, upper_twist V+, upper_twist GND, elbow bus, elbow V+, elbow GND, wrist_twist bus, wrist_twist V+, wrist_twist GND, fingers bus, fingers V+, fingers GND, thumb bus, thumb V+, thumb GND as in the table (24 connections).

Wire the right arm: servo bus and power (continued)

Link | From | To | | Termination | DRC
arm_r_12v | Buck, right arm (12 V) vout | Bus adapter power_in | | power | configured
arm_r_gnd | M18 dock 1 lead_minus | Bus adapter gnd | | power | configured
USB to the right arm's bus | Head computer usb_a | Bus adapter usb | | usb | configured
shoulder_flex bus | Bus adapter bus | Shoulder flex (STS3215, 2.73:1 belt) bus | | custom | configured
shoulder_flex V+ | Bus adapter bus_vplus | Shoulder flex (STS3215, 2.73:1 belt) bus_vplus | | power | configured
shoulder_flex GND | Bus adapter gnd | Shoulder flex (STS3215, 2.73:1 belt) bus_gnd | | power | configured
shoulder_out bus | Bus adapter bus | Shoulder out (STS3215, 2.73:1 belt) bus | | custom | configured
shoulder_out V+ | Bus adapter bus_vplus | Shoulder out (STS3215, 2.73:1 belt) bus_vplus | | power | configured
shoulder_out GND | Bus adapter gnd | Shoulder out (STS3215, 2.73:1 belt) bus_gnd | | power | configured
upper_twist bus | Bus adapter bus | Upper-arm twist (STS3215) bus | | custom | configured
upper_twist V+ | Bus adapter bus_vplus | Upper-arm twist (STS3215) bus_vplus | | power | configured
upper_twist GND | Bus adapter gnd | Upper-arm twist (STS3215) bus_gnd | | power | configured
elbow bus | Bus adapter bus | Elbow (STS3215, 2.73:1 belt) bus | | custom | configured
elbow V+ | Bus adapter bus_vplus | Elbow (STS3215, 2.73:1 belt) bus_vplus | | power | configured
elbow GND | Bus adapter gnd | Elbow (STS3215, 2.73:1 belt) bus_gnd | | power | configured
wrist_twist bus | Bus adapter bus | Wrist twist (STS3215) bus | | custom | configured
wrist_twist V+ | Bus adapter bus_vplus | Wrist twist (STS3215) bus_vplus | | power | configured
wrist_twist GND | Bus adapter gnd | Wrist twist (STS3215) bus_gnd | | power | configured
fingers bus | Bus adapter bus | Four linked fingers (STS3215) bus | | custom | configured
fingers V+ | Bus adapter bus_vplus | Four linked fingers (STS3215) bus_vplus | | power | configured
fingers GND | Bus adapter gnd | Four linked fingers (STS3215) bus_gnd | | power | configured
thumb bus | Bus adapter bus | Thumb (STS3215) bus | | custom | configured
thumb V+ | Bus adapter bus_vplus | Thumb (STS3215) bus_vplus | | power | configured
thumb GND | Bus adapter gnd | Thumb (STS3215) bus_gnd | | power | configured

Step 39 of 42

PR0TOBOARD · UHDJJ-B-AG · Rev A · 2026-10-2472 / 116

Joyful Jack, Tier B, MidrangeAssembly guideJJ-B-AG

40

## Wire the left arm: servo bus and power

links: arm_l_12v, arm_l_gnd, arm_l_usb, arm_l/shoulder_flex_bus, arm_l/shoulder_flex_vplus, arm_l/shoulder_flex_gnd, arm_l/shoulder_out_bus, arm_l/shoulder_out_vplus, arm_l/shoulder_out_gnd, arm_l/upper_twist_bus, arm_l/upper_twist_vplus, arm_l/upper_twist_gnd, arm_l/elbow_bus, arm_l/elbow_vplus, arm_l/elbow_gnd, arm_l/wrist_twist_bus, arm_l/wrist_twist_vplus, arm_l/wrist_twist_gnd, arm_l/fingers_bus, arm_l/fingers_vplus, arm_l/fingers_gnd, arm_l/thumb_bus, arm_l/thumb_vplus, arm_l/thumb_gnd

Figure 40Pad-to-pad connections from the stored links (wiringChecklist); crossovers in accent.

PR0TOBOARD · UHDJJ-B-AG · Rev A · 2026-10-2473 / 116

Joyful Jack, Tier B, MidrangeAssembly guideJJ-B-AG

1. Connect arm_l_12v, arm_l_gnd, USB to the left arm's bus, shoulder_flex bus, shoulder_flex V+, shoulder_flex GND, shoulder_out bus, shoulder_out V+, shoulder_out GND, upper_twist bus, upper_twist V+, upper_twist GND, elbow bus, elbow V+, elbow GND, wrist_twist bus, wrist_twist V+, wrist_twist GND, fingers bus, fingers V+, fingers GND, thumb bus, thumb V+, thumb GND as in the table (24 connections).

Wire the left arm: servo bus and power (continued)

Link | From | To | | Termination | DRC
arm_l_12v | Buck, left arm (12 V) vout | Bus adapter power_in | | power | configured
arm_l_gnd | M18 dock 1 lead_minus | Bus adapter gnd | | power | configured
USB to the left arm's bus | Head computer usb_b | Bus adapter usb | | usb | configured
shoulder_flex bus | Bus adapter bus | Shoulder flex (STS3215, 2.73:1 belt) bus | | custom | configured
shoulder_flex V+ | Bus adapter bus_vplus | Shoulder flex (STS3215, 2.73:1 belt) bus_vplus | | power | configured
shoulder_flex GND | Bus adapter gnd | Shoulder flex (STS3215, 2.73:1 belt) bus_gnd | | power | configured
shoulder_out bus | Bus adapter bus | Shoulder out (STS3215, 2.73:1 belt) bus | | custom | configured
shoulder_out V+ | Bus adapter bus_vplus | Shoulder out (STS3215, 2.73:1 belt) bus_vplus | | power | configured
shoulder_out GND | Bus adapter gnd | Shoulder out (STS3215, 2.73:1 belt) bus_gnd | | power | configured
upper_twist bus | Bus adapter bus | Upper-arm twist (STS3215) bus | | custom | configured
upper_twist V+ | Bus adapter bus_vplus | Upper-arm twist (STS3215) bus_vplus | | power | configured
upper_twist GND | Bus adapter gnd | Upper-arm twist (STS3215) bus_gnd | | power | configured
elbow bus | Bus adapter bus | Elbow (STS3215, 2.73:1 belt) bus | | custom | configured
elbow V+ | Bus adapter bus_vplus | Elbow (STS3215, 2.73:1 belt) bus_vplus | | power | configured
elbow GND | Bus adapter gnd | Elbow (STS3215, 2.73:1 belt) bus_gnd | | power | configured
wrist_twist bus | Bus adapter bus | Wrist twist (STS3215) bus | | custom | configured
wrist_twist V+ | Bus adapter bus_vplus | Wrist twist (STS3215) bus_vplus | | power | configured
wrist_twist GND | Bus adapter gnd | Wrist twist (STS3215) bus_gnd | | power | configured
fingers bus | Bus adapter bus | Four linked fingers (STS3215) bus | | custom | configured
fingers V+ | Bus adapter bus_vplus | Four linked fingers (STS3215) bus_vplus | | power | configured
fingers GND | Bus adapter gnd | Four linked fingers (STS3215) bus_gnd | | power | configured
thumb bus | Bus adapter bus | Thumb (STS3215) bus | | custom | configured
thumb V+ | Bus adapter bus_vplus | Thumb (STS3215) bus_vplus | | power | configured
thumb GND | Bus adapter gnd | Thumb (STS3215) bus_gnd | | power | configured

Step 40 of 42

PR0TOBOARD · UHDJJ-B-AG · Rev A · 2026-10-2474 / 116

Joyful Jack, Tier B, MidrangeAssembly guideJJ-B-AG

41

## Wire the head: computer, servo rail and monitor bus

links: monitor_lvc, relay_head, pi_feed, buck_head_gnd, monitor_gnd, pi_5v, head_servo_rail, head_gnd, monitor_i2c, monitor_logic

A×1

PCA9685 16-channel servo driver breakout (0x40)

Figure 41Pad-to-pad connections from the stored links (wiringChecklist); crossovers in accent.

PR0TOBOARD · UHDJJ-B-AG · Rev A · 2026-10-2475 / 116

Joyful Jack, Tier B, MidrangeAssembly guideJJ-B-AG

1. Connect monitor_lvc, relay_head, pi_feed, buck_head_gnd, monitor_gnd, Pi 5 V, Head servo rail, head_gnd, I2C to the pack monitor (0x44), monitor_logic as in the table (11 connections).

Wire the head: computer, servo rail and monitor bus (continued)

Link | From | To | | Termination | DRC
monitor_lvc | Pack monitor (INA228, 0x44) shunt_out | Low-voltage cutoff vin | | power | configured
relay_head | Actuator relay contact_87 | Buck, head servos (5.0 V) vin | | power | configured
pi_feed | Fuse block out2 | Buck, head Pi (5 V) vin | | power | configured
buck_head_gnd | M18 dock 1 lead_minus | Buck, head servos (5.0 V) gnd | | power | configured
monitor_gnd | M18 dock 1 lead_minus | Pack monitor (INA228, 0x44) gnd | | power | configured
Pi 5 V | Buck, head Pi (5 V) vout | Head computer pi_5v_in | | power | configured
Head servo rail | Buck, head servos (5.0 V) vout | Servo driver servo_vplus_in | | power | configured
head_gnd | M18 dock 1 lead_minus | Head computer gnd | | power | configured
I2C to the pack monitor (0x44) | Head computer 3 · 5 | Pack monitor (INA228, 0x44) SDA · SCL | | i2c | configured
monitor_logic | Head computer 1 | Pack monitor (INA228, 0x44) vin | | power | configured

Step 41 of 42

PR0TOBOARD · UHDJJ-B-AG · Rev A · 2026-10-2476 / 116

Joyful Jack, Tier B, MidrangeAssembly guideJJ-B-AG

42

## Wire the power system: packs, docks, protection, fuses and converters

links: pack1_dock, pack1_neg, pack2_dock, pack2_neg, dock1_or, dock2_or, gnd_common, or1_bus, or2_bus, lvc_gnd, lvc_fuses, fuses_gnd, act_relay, estop_feed, estop_coil, relay_coil_gnd, relay_arm_r, relay_arm_l, buck_pi_gnd, buck_arm_r_gnd, buck_arm_l_gnd, or_1_gnd, or_2_gnd

Figure 42Pad-to-pad connections from the stored links (wiringChecklist); crossovers in accent.

PR0TOBOARD · UHDJJ-B-AG · Rev A · 2026-10-2477 / 116

Joyful Jack, Tier B, MidrangeAssembly guideJJ-B-AG

1. Connect pack1_dock, pack1_neg, pack2_dock, pack2_neg, dock1_or, dock2_or, Pack negatives joined, OR bus (pack 1), OR bus (pack 2), lvc_gnd, lvc_fuses, fuses_gnd, Actuator feed to relay contacts, estop_feed, E-stop chain holds the relay, relay_coil_gnd, relay_arm_r, relay_arm_l, buck_pi_gnd, buck_arm_r_gnd, buck_arm_l_gnd, or_1_gnd, or_2_gnd as in the table (23 connections).

Wire the power system: packs, docks, protection, fuses and converters (continued)

Link | From | To | | Termination | DRC
pack1_dock | M18 pack 1 (owned) pack_plus | M18 dock 1 dock_plus | | power | configured
pack1_neg | M18 pack 1 (owned) pack_minus | M18 dock 1 dock_minus | | power | configured
pack2_dock | M18 pack 2 (owned) pack_plus | M18 dock 2 dock_plus | | power | configured
pack2_neg | M18 pack 2 (owned) pack_minus | M18 dock 2 dock_minus | | power | configured
dock1_or | M18 dock 1 lead_plus | Ideal diode, pack 1 vin | | power | configured
dock2_or | M18 dock 2 lead_plus | Ideal diode, pack 2 vin | | power | configured
Pack negatives joined | M18 dock 1 lead_minus | M18 dock 2 lead_minus | | power | configured
OR bus (pack 1) | Ideal diode, pack 1 vout | Pack monitor (INA228, 0x44) shunt_in | | power | configured
OR bus (pack 2) | Ideal diode, pack 2 vout | Pack monitor (INA228, 0x44) shunt_in | | power | configured
lvc_gnd | M18 dock 1 lead_minus | Low-voltage cutoff gnd | | power | configured
lvc_fuses | Low-voltage cutoff vout | Fuse block feed | | power | configured
fuses_gnd | M18 dock 1 lead_minus | Fuse block neg_bus | | power | configured
Actuator feed to relay contacts | Fuse block out1 | Actuator relay contact_30 | | power | configured
estop_feed | Fuse block out3 | Emergency stop vin | | power | configured
E-stop chain holds the relay | Emergency stop vout | Actuator relay coil_86 | | power | configured
relay_coil_gnd | M18 dock 1 lead_minus | Actuator relay coil_85 | | power | configured
relay_arm_r | Actuator relay contact_87 | Buck, right arm (12 V) vin | | power | configured
relay_arm_l | Actuator relay contact_87 | Buck, left arm (12 V) vin | | power | configured
buck_pi_gnd | M18 dock 1 lead_minus | Buck, head Pi (5 V) gnd | | power | configured
buck_arm_r_gnd | M18 dock 1 lead_minus | Buck, right arm (12 V) gnd | | power | configured
buck_arm_l_gnd | M18 dock 1 lead_minus | Buck, left arm (12 V) gnd | | power | configured
or_1_gnd | M18 dock 1 lead_minus | Ideal diode, pack 1 gnd | | power | configured
or_2_gnd | M18 dock 1 lead_minus | Ideal diode, pack 2 gnd | | power | configured

Step 42 of 42

PR0TOBOARD · UHDJJ-B-AG · Rev A · 2026-10-2478 / 116

Joyful Jack, Tier B, MidrangeAssembly guideJJ-B-AG

# 46Coverageassemble() · wiringChecklist

Every rigid mate, every hardware placement and every electrical link in the model, and the step that covers it. The verifier fails the guide if any row is not covered.

## Mates

Mates (continued)

Mate | Interfaces | Harness | Step
head_on_neck_plate | body/neck_plate.head_seat ↔ head.base | j_head_on_neck_plate | 37 · Fit the head on the neck plate
body_or_1_in_tray | body/tray__or_1.floor ↔ or_1.bottom | — | 12 · Put the power parts in their trays and bolt down the battery docks (1 of 2)
body_or_2_in_tray | body/tray__or_2.floor ↔ or_2.bottom | — | 12 · Put the power parts in their trays and bolt down the battery docks (1 of 2)
body_monitor_in_tray | body/tray__monitor.floor ↔ monitor.bottom | — | 12 · Put the power parts in their trays and bolt down the battery docks (1 of 2)
body_lvc_in_tray | body/tray__lvc.floor ↔ lvc.bottom | — | 12 · Put the power parts in their trays and bolt down the battery docks (1 of 2)
body_fuses_in_tray | body/tray__fuses.floor ↔ fuses.bottom | — | 12 · Put the power parts in their trays and bolt down the battery docks (1 of 2)
body_relay_in_tray | body/tray__relay.floor ↔ relay.bottom | — | 12 · Put the power parts in their trays and bolt down the battery docks (1 of 2)
body_buck_head_in_tray | body/tray__buck_head.floor ↔ buck_head.bottom | — | 12 · Put the power parts in their trays and bolt down the battery docks (1 of 2)
body_buck_pi_in_tray | body/tray__buck_pi.floor ↔ buck_pi.bottom | — | 12 · Put the power parts in their trays and bolt down the battery docks (1 of 2)
body_buck_arm_r_in_tray | body/tray__buck_arm_r.floor ↔ buck_arm_r.bottom | — | 13 · Put the power parts in their trays and bolt down the battery docks (2 of 2)
body_buck_arm_l_in_tray | body/tray__buck_arm_l.floor ↔ buck_arm_l.bottom | — | 13 · Put the power parts in their trays and bolt down the battery docks (2 of 2)
body_arm_r__bus_adapter_in_tray | body/tray__arm_r__bus_adapter.floor ↔ arm_r/bus_adapter.bottom | — | 13 · Put the power parts in their trays and bolt down the battery docks (2 of 2)

PR0TOBOARD · UHDJJ-B-AG · Rev A · 2026-10-2479 / 116

Joyful Jack, Tier B, MidrangeAssembly guideJJ-B-AG

Mates (continued)

Mate | Interfaces | Harness | Step
body_arm_l__bus_adapter_in_tray | body/tray__arm_l__bus_adapter.floor ↔ arm_l/bus_adapter.bottom | — | 13 · Put the power parts in their trays and bolt down the battery docks (2 of 2)
dock_1_on_base | body/base_plate.dock_1_seat ↔ dock_1.mount | j_dock_1_on_base | 13 · Put the power parts in their trays and bolt down the battery docks (2 of 2)
pack_1_on_dock_1 | dock_1.top ↔ pack_1.bottom | — | 38 · Slide the battery packs onto the docks
dock_2_on_base | body/base_plate.dock_2_seat ↔ dock_2.mount | j_dock_2_on_base | 13 · Put the power parts in their trays and bolt down the battery docks (2 of 2)
pack_2_on_dock_2 | dock_2.top ↔ pack_2.bottom | — | 38 · Slide the battery packs onto the docks
estop_on_bracket | body/estop_bracket.estop_seat ↔ estop.bottom | — | 13 · Put the power parts in their trays and bolt down the battery docks (2 of 2)
arm_r_foot | body/rail_y_top_r.foot_r ↔ arm_r/j1_housing.torso_mount | j_arm_r_foot | 36 · Mount the arms on the torso
arm_l_foot | body/rail_y_top_l.foot_l ↔ arm_l/j1_housing.torso_mount | j_arm_l_foot | 36 · Mount the arms on the torso
body/bucket_on_skirt | body/skirt.bucket_seat ↔ body/bucket.bottom | j_bucket_on_skirt | 1 · Build the base: skirt, bucket, flanges and mast
body/concrete_in_bucket | body/bucket.floor ↔ body/concrete.bottom | — | 1 · Build the base: skirt, bucket, flanges and mast
body/flange_in_concrete | body/concrete.flange_seat ↔ body/flange_bottom.face | — | 1 · Build the base: skirt, bucket, flanges and mast
body/mast_in_flange | body/flange_bottom.socket ↔ body/mast.end_a | — | 1 · Build the base: skirt, bucket, flanges and mast
body/flange_on_mast | body/mast.end_b ↔ body/flange_top.socket | — | 1 · Build the base: skirt, bucket, flanges and mast
body/plate_on_flange | body/base_plate.flange_seat ↔ body/flange_top.face | j_plate_on_flange | 2 · Build the torso frame on the top flange (1 of 5)
body/upright_rf_on_plate | body/upright_rf.end_a ↔ body/base_plate.upright_rf_seat | j_upright_rf_on_plate | 2 · Build the torso frame on the top flange (1 of 5)
body/upright_rb_on_plate | body/upright_rb.end_a ↔ body/base_plate.upright_rb_seat | j_upright_rb_on_plate | 2 · Build the torso frame on the top flange (1 of 5)
body/upright_lf_on_plate | body/upright_lf.end_a ↔ body/base_plate.upright_lf_seat | j_upright_lf_on_plate | 2 · Build the torso frame on the top flange (1 of 5)
body/upright_lb_on_plate | body/upright_lb.end_a ↔ body/base_plate.upright_lb_seat | j_upright_lb_on_plate | 2 · Build the torso frame on the top flange (1 of 5)

PR0TOBOARD · UHDJJ-B-AG · Rev A · 2026-10-2480 / 116

Joyful Jack, Tier B, MidrangeAssembly guideJJ-B-AG

Mates (continued)

Mate | Interfaces | Harness | Step
body/bracket_01_on_rail | body/rail_x_top_f.bracket_01_slot ↔ body/bracket_01.leg_a | j_bracket_01_on_rail | 2 · Build the torso frame on the top flange (1 of 5)
body/bracket_01_on_upright | body/upright_rf.bracket_01_slot ↔ body/bracket_01.leg_b | j_bracket_01_on_upright | 2 · Build the torso frame on the top flange (1 of 5)
body/bracket_02_on_rail | body/rail_y_top_r.bracket_02_slot ↔ body/bracket_02.leg_a | j_bracket_02_on_rail | 2 · Build the torso frame on the top flange (1 of 5)
body/bracket_02_on_upright | body/upright_rf.bracket_02_slot ↔ body/bracket_02.leg_b | j_bracket_02_on_upright | 3 · Build the torso frame on the top flange (2 of 5)
body/bracket_03_on_rail | body/rail_x_top_b.bracket_03_slot ↔ body/bracket_03.leg_a | j_bracket_03_on_rail | 3 · Build the torso frame on the top flange (2 of 5)
body/bracket_03_on_upright | body/upright_rb.bracket_03_slot ↔ body/bracket_03.leg_b | j_bracket_03_on_upright | 3 · Build the torso frame on the top flange (2 of 5)
body/bracket_04_on_rail | body/rail_y_top_r.bracket_04_slot ↔ body/bracket_04.leg_a | j_bracket_04_on_rail | 3 · Build the torso frame on the top flange (2 of 5)
body/bracket_04_on_upright | body/upright_rb.bracket_04_slot ↔ body/bracket_04.leg_b | j_bracket_04_on_upright | 3 · Build the torso frame on the top flange (2 of 5)
body/bracket_05_on_rail | body/rail_x_top_f.bracket_05_slot ↔ body/bracket_05.leg_a | j_bracket_05_on_rail | 3 · Build the torso frame on the top flange (2 of 5)
body/bracket_05_on_upright | body/upright_lf.bracket_05_slot ↔ body/bracket_05.leg_b | j_bracket_05_on_upright | 3 · Build the torso frame on the top flange (2 of 5)
body/bracket_06_on_rail | body/rail_y_top_l.bracket_06_slot ↔ body/bracket_06.leg_a | j_bracket_06_on_rail | 3 · Build the torso frame on the top flange (2 of 5)
body/bracket_06_on_upright | body/upright_lf.bracket_06_slot ↔ body/bracket_06.leg_b | j_bracket_06_on_upright | 4 · Build the torso frame on the top flange (3 of 5)
body/bracket_07_on_rail | body/rail_x_top_b.bracket_07_slot ↔ body/bracket_07.leg_a | j_bracket_07_on_rail | 4 · Build the torso frame on the top flange (3 of 5)
body/bracket_07_on_upright | body/upright_lb.bracket_07_slot ↔ body/bracket_07.leg_b | j_bracket_07_on_upright | 4 · Build the torso frame on the top flange (3 of 5)
body/bracket_08_on_rail | body/rail_y_top_l.bracket_08_slot ↔ body/bracket_08.leg_a | j_bracket_08_on_rail | 4 · Build the torso frame on the top flange (3 of 5)
body/bracket_08_on_upright | body/upright_lb.bracket_08_slot ↔ body/bracket_08.leg_b | j_bracket_08_on_upright | 4 · Build the torso frame on the top flange (3 of 5)
body/bracket_09_on_rail | body/rail_x_bot_f.bracket_09_slot ↔ body/bracket_09.leg_a | j_bracket_09_on_rail | 4 · Build the torso frame on the top flange (3 of 5)
body/bracket_09_on_upright | body/upright_rf.bracket_09_slot ↔ body/bracket_09.leg_b | j_bracket_09_on_upright | 4 · Build the torso frame on the top flange (3 of 5)
body/bracket_10_on_rail | body/rail_y_bot_r.bracket_10_slot ↔ body/bracket_10.leg_a | j_bracket_10_on_rail | 4 · Build the torso frame on the top flange (3 of 5)
body/bracket_10_on_upright | body/upright_rf.bracket_10_slot ↔ body/bracket_10.leg_b | j_bracket_10_on_upright | 5 · Build the torso frame on the top flange (4 of 5)

PR0TOBOARD · UHDJJ-B-AG · Rev A · 2026-10-2481 / 116

Joyful Jack, Tier B, MidrangeAssembly guideJJ-B-AG

Mates (continued)

Mate | Interfaces | Harness | Step
body/bracket_11_on_rail | body/rail_x_bot_b.bracket_11_slot ↔ body/bracket_11.leg_a | j_bracket_11_on_rail | 5 · Build the torso frame on the top flange (4 of 5)
body/bracket_11_on_upright | body/upright_rb.bracket_11_slot ↔ body/bracket_11.leg_b | j_bracket_11_on_upright | 5 · Build the torso frame on the top flange (4 of 5)
body/bracket_12_on_rail | body/rail_y_bot_r.bracket_12_slot ↔ body/bracket_12.leg_a | j_bracket_12_on_rail | 5 · Build the torso frame on the top flange (4 of 5)
body/bracket_12_on_upright | body/upright_rb.bracket_12_slot ↔ body/bracket_12.leg_b | j_bracket_12_on_upright | 5 · Build the torso frame on the top flange (4 of 5)
body/bracket_13_on_rail | body/rail_x_bot_f.bracket_13_slot ↔ body/bracket_13.leg_a | j_bracket_13_on_rail | 5 · Build the torso frame on the top flange (4 of 5)
body/bracket_13_on_upright | body/upright_lf.bracket_13_slot ↔ body/bracket_13.leg_b | j_bracket_13_on_upright | 5 · Build the torso frame on the top flange (4 of 5)
body/bracket_14_on_rail | body/rail_y_bot_l.bracket_14_slot ↔ body/bracket_14.leg_a | j_bracket_14_on_rail | 5 · Build the torso frame on the top flange (4 of 5)
body/bracket_14_on_upright | body/upright_lf.bracket_14_slot ↔ body/bracket_14.leg_b | j_bracket_14_on_upright | 6 · Build the torso frame on the top flange (5 of 5)
body/bracket_15_on_rail | body/rail_x_bot_b.bracket_15_slot ↔ body/bracket_15.leg_a | j_bracket_15_on_rail | 6 · Build the torso frame on the top flange (5 of 5)
body/bracket_15_on_upright | body/upright_lb.bracket_15_slot ↔ body/bracket_15.leg_b | j_bracket_15_on_upright | 6 · Build the torso frame on the top flange (5 of 5)
body/bracket_16_on_rail | body/rail_y_bot_l.bracket_16_slot ↔ body/bracket_16.leg_a | j_bracket_16_on_rail | 6 · Build the torso frame on the top flange (5 of 5)
body/bracket_16_on_upright | body/upright_lb.bracket_16_slot ↔ body/bracket_16.leg_b | j_bracket_16_on_upright | 6 · Build the torso frame on the top flange (5 of 5)
body/neck_plate_on_neck_post_f | body/neck_post_f.end_b ↔ body/neck_plate.neck_post_f_seat | j_neck_plate_on_neck_post_f | 7 · Fit the neck posts and the neck plate (1 of 2)

PR0TOBOARD · UHDJJ-B-AG · Rev A · 2026-10-2482 / 116

Joyful Jack, Tier B, MidrangeAssembly guideJJ-B-AG

Mates (continued)

Mate | Interfaces | Harness | Step
body/neck_post_f_bracket_0_on_rail | body/rail_x_top_f.neck_post_f_bracket_0_slot ↔ body/neck_post_f_bracket_0.leg_a | j_neck_post_f_bracket_0_on_rail | 7 · Fit the neck posts and the neck plate (1 of 2)
body/neck_post_f_bracket_0_on_post | body/neck_post_f.neck_post_f_bracket_0_slot ↔ body/neck_post_f_bracket_0.leg_b | j_neck_post_f_bracket_0_on_post | 7 · Fit the neck posts and the neck plate (1 of 2)
body/neck_post_f_bracket_1_on_rail | body/rail_x_top_f.neck_post_f_bracket_1_slot ↔ body/neck_post_f_bracket_1.leg_a | j_neck_post_f_bracket_1_on_rail | 7 · Fit the neck posts and the neck plate (1 of 2)
body/neck_post_f_bracket_1_on_post | body/neck_post_f.neck_post_f_bracket_1_slot ↔ body/neck_post_f_bracket_1.leg_b | j_neck_post_f_bracket_1_on_post | 7 · Fit the neck posts and the neck plate (1 of 2)
body/neck_plate_on_neck_post_b | body/neck_post_b.end_b ↔ body/neck_plate.neck_post_b_seat | j_neck_plate_on_neck_post_b | 8 · Fit the neck posts and the neck plate (2 of 2)
body/neck_post_b_bracket_0_on_rail | body/rail_x_top_b.neck_post_b_bracket_0_slot ↔ body/neck_post_b_bracket_0.leg_a | j_neck_post_b_bracket_0_on_rail | 8 · Fit the neck posts and the neck plate (2 of 2)
body/neck_post_b_bracket_0_on_post | body/neck_post_b.neck_post_b_bracket_0_slot ↔ body/neck_post_b_bracket_0.leg_b | j_neck_post_b_bracket_0_on_post | 8 · Fit the neck posts and the neck plate (2 of 2)
body/neck_post_b_bracket_1_on_rail | body/rail_x_top_b.neck_post_b_bracket_1_slot ↔ body/neck_post_b_bracket_1.leg_a | j_neck_post_b_bracket_1_on_rail | 8 · Fit the neck posts and the neck plate (2 of 2)
body/neck_post_b_bracket_1_on_post | body/neck_post_b.neck_post_b_bracket_1_slot ↔ body/neck_post_b_bracket_1.leg_b | j_neck_post_b_bracket_1_on_post | 8 · Fit the neck posts and the neck plate (2 of 2)
body/ebd_tab_0 | body/upright_rf.ebd_0_slot ↔ body/ebd.tab_0 | j_ebd_tab_0 | 9 · Fit the electronics board, its trays and the E-stop bracket (1 of 3)
body/ebd_tab_1 | body/upright_lf.ebd_1_slot ↔ body/ebd.tab_1 | j_ebd_tab_1 | 9 · Fit the electronics board, its trays and the E-stop bracket (1 of 3)
body/ebd_tab_2 | body/upright_rf.ebd_2_slot ↔ body/ebd.tab_2 | j_ebd_tab_2 | 9 · Fit the electronics board, its trays and the E-stop bracket (1 of 3)

PR0TOBOARD · UHDJJ-B-AG · Rev A · 2026-10-2483 / 116

Joyful Jack, Tier B, MidrangeAssembly guideJJ-B-AG

Mates (continued)

Mate | Interfaces | Harness | Step
body/ebd_tab_3 | body/upright_lf.ebd_3_slot ↔ body/ebd.tab_3 | j_ebd_tab_3 | 9 · Fit the electronics board, its trays and the E-stop bracket (1 of 3)
body/tray_or_1_on_board | body/ebd.tray_or_1 ↔ body/tray__or_1.back | j_tray_or_1_on_board | 9 · Fit the electronics board, its trays and the E-stop bracket (1 of 3)
body/tray_or_2_on_board | body/ebd.tray_or_2 ↔ body/tray__or_2.back | j_tray_or_2_on_board | 9 · Fit the electronics board, its trays and the E-stop bracket (1 of 3)
body/tray_monitor_on_board | body/ebd.tray_monitor ↔ body/tray__monitor.back | j_tray_monitor_on_board | 10 · Fit the electronics board, its trays and the E-stop bracket (2 of 3)
body/tray_lvc_on_board | body/ebd.tray_lvc ↔ body/tray__lvc.back | j_tray_lvc_on_board | 10 · Fit the electronics board, its trays and the E-stop bracket (2 of 3)
body/tray_fuses_on_board | body/ebd.tray_fuses ↔ body/tray__fuses.back | j_tray_fuses_on_board | 10 · Fit the electronics board, its trays and the E-stop bracket (2 of 3)
body/tray_relay_on_board | body/ebd.tray_relay ↔ body/tray__relay.back | j_tray_relay_on_board | 10 · Fit the electronics board, its trays and the E-stop bracket (2 of 3)
body/tray_buck_head_on_board | body/ebd.tray_buck_head ↔ body/tray__buck_head.back | j_tray_buck_head_on_board | 10 · Fit the electronics board, its trays and the E-stop bracket (2 of 3)
body/tray_buck_pi_on_board | body/ebd.tray_buck_pi ↔ body/tray__buck_pi.back | j_tray_buck_pi_on_board | 10 · Fit the electronics board, its trays and the E-stop bracket (2 of 3)
body/tray_buck_arm_r_on_board | body/ebd.tray_buck_arm_r ↔ body/tray__buck_arm_r.back | j_tray_buck_arm_r_on_board | 11 · Fit the electronics board, its trays and the E-stop bracket (3 of 3)
body/tray_buck_arm_l_on_board | body/ebd.tray_buck_arm_l ↔ body/tray__buck_arm_l.back | j_tray_buck_arm_l_on_board | 11 · Fit the electronics board, its trays and the E-stop bracket (3 of 3)

PR0TOBOARD · UHDJJ-B-AG · Rev A · 2026-10-2484 / 116

Joyful Jack, Tier B, MidrangeAssembly guideJJ-B-AG

Mates (continued)

Mate | Interfaces | Harness | Step
body/tray_arm_r__bus_adapter_on_board | body/ebd.tray_arm_r__bus_adapter ↔ body/tray__arm_r__bus_adapter.back | j_tray_arm_r__bus_adapter_on_board | 11 · Fit the electronics board, its trays and the E-stop bracket (3 of 3)
body/tray_arm_l__bus_adapter_on_board | body/ebd.tray_arm_l__bus_adapter ↔ body/tray__arm_l__bus_adapter.back | j_tray_arm_l__bus_adapter_on_board | 11 · Fit the electronics board, its trays and the E-stop bracket (3 of 3)
body/estop_bracket_on_rail | body/rail_x_top_b.estop_bracket_slot ↔ body/estop_bracket.on_rail | j_estop_bracket_on_rail | 11 · Fit the electronics board, its trays and the E-stop bracket (3 of 3)
arm_r/arm_r_j1_servo_case_top | arm_r/shoulder_flex.case_top ↔ arm_r/j1_housing.j1_servo_case_top | j_arm_r_j1_servo_case_top | 14 · Right arm: shoulder housing, J1 servo, belt and springs (1 of 2)
arm_r/arm_r_j1_servo_case_bottom | arm_r/shoulder_flex.case_bottom ↔ arm_r/j1_housing.j1_servo_case_bottom | j_arm_r_j1_servo_case_bottom | 14 · Right arm: shoulder housing, J1 servo, belt and springs (1 of 2)
arm_r/arm_r_j1_driver_on_horn | arm_r/shoulder_flex.horn ↔ arm_r/j1_driver.horn | j_arm_r_j1_driver_on_horn | 14 · Right arm: shoulder housing, J1 servo, belt and springs (1 of 2)
arm_r/arm_r_j1_dowel_in_pulley | arm_r/j1_driver.dowel ↔ arm_r/j1_dowel.end | — | 14 · Right arm: shoulder housing, J1 servo, belt and springs (1 of 2)
arm_r/arm_r_j1_driver_bearing_seat | arm_r/j1_housing.j1_driver_seat ↔ arm_r/j1_driver_bearing.od_face_top | — | 14 · Right arm: shoulder housing, J1 servo, belt and springs (1 of 2)
arm_r/arm_r_j1_belt_on_pulley | arm_r/j1_driver.belt ↔ arm_r/j1_belt.driver | — | 14 · Right arm: shoulder housing, J1 servo, belt and springs (1 of 2)

PR0TOBOARD · UHDJJ-B-AG · Rev A · 2026-10-2485 / 116

Joyful Jack, Tier B, MidrangeAssembly guideJJ-B-AG

Mates (continued)

Mate | Interfaces | Harness | Step
arm_r/arm_r_j1_bearing_1_seat | arm_r/j1_housing.j1_seat_1 ↔ arm_r/j1_bearing_1.od_face_top | — | 14 · Right arm: shoulder housing, J1 servo, belt and springs (1 of 2)
arm_r/arm_r_j1_hub_in_bearing_1 | arm_r/j1_bearing_1.bore ↔ arm_r/j1_hub.journal_1 | — | 14 · Right arm: shoulder housing, J1 servo, belt and springs (1 of 2)
arm_r/arm_r_j1_cap_on_drum | arm_r/j1_housing.j1_cap_seat ↔ arm_r/j1_cap.to_drum | j_arm_r_j1_cap_on_drum | 15 · Right arm: shoulder housing, J1 servo, belt and springs (2 of 2)
arm_r/arm_r_j1_bearing_2_in_cap | arm_r/j1_cap.seat ↔ arm_r/j1_bearing_2.od_face_top | — | 15 · Right arm: shoulder housing, J1 servo, belt and springs (2 of 2)
arm_r/arm_r_j1_hub_in_bearing_2 | arm_r/j1_bearing_2.bore ↔ arm_r/j1_hub.journal_2 | — | 15 · Right arm: shoulder housing, J1 servo, belt and springs (2 of 2)
arm_r/arm_r_j1_arbor_on_hub | arm_r/j1_hub.face_b ↔ arm_r/j1_arbor.on_hub | j_arm_r_j1_arbor_on_hub | 15 · Right arm: shoulder housing, J1 servo, belt and springs (2 of 2)
arm_r/arm_r_j1_spring_0_on_arbor | arm_r/j1_arbor.spring_0 ↔ arm_r/j1_spring_0.bore_a | — | 15 · Right arm: shoulder housing, J1 servo, belt and springs (2 of 2)
arm_r/arm_r_j1_spring_1_on_arbor | arm_r/j1_arbor.spring_1 ↔ arm_r/j1_spring_1.bore_a | — | 15 · Right arm: shoulder housing, J1 servo, belt and springs (2 of 2)
arm_r/arm_r_yoke_on_j1_hub | arm_r/j1_hub.face_a ↔ arm_r/yoke.on_j1_hub | j_arm_r_yoke_on_j1_hub | 15 · Right arm: shoulder housing, J1 servo, belt and springs (2 of 2)
arm_r/arm_r_j2_servo_case_top | arm_r/shoulder_out.case_top ↔ arm_r/upper.j2_servo_case_top | j_arm_r_j2_servo_case_top | 16 · Right arm: yoke and upper arm (shoulder-out and twist joints) (1 of 3)
arm_r/arm_r_j2_servo_case_bottom | arm_r/shoulder_out.case_bottom ↔ arm_r/upper.j2_servo_case_bottom | j_arm_r_j2_servo_case_bottom | 16 · Right arm: yoke and upper arm (shoulder-out and twist joints) (1 of 3)
arm_r/arm_r_j2_driver_on_horn | arm_r/shoulder_out.horn ↔ arm_r/j2_driver.horn | j_arm_r_j2_driver_on_horn | 16 · Right arm: yoke and upper arm (shoulder-out and twist joints) (1 of 3)
arm_r/arm_r_j2_dowel_in_pulley | arm_r/j2_driver.dowel ↔ arm_r/j2_dowel.end | — | 16 · Right arm: yoke and upper arm (shoulder-out and twist joints) (1 of 3)

PR0TOBOARD · UHDJJ-B-AG · Rev A · 2026-10-2486 / 116

Joyful Jack, Tier B, MidrangeAssembly guideJJ-B-AG

Mates (continued)

Mate | Interfaces | Harness | Step
arm_r/arm_r_j2_driver_bearing_seat | arm_r/upper.j2_driver_seat ↔ arm_r/j2_driver_bearing.od_face_top | — | 16 · Right arm: yoke and upper arm (shoulder-out and twist joints) (1 of 3)
arm_r/arm_r_j2_belt_on_pulley | arm_r/j2_driver.belt ↔ arm_r/j2_belt.driver | — | 16 · Right arm: yoke and upper arm (shoulder-out and twist joints) (1 of 3)
arm_r/arm_r_j2_bearing_1_seat | arm_r/upper.j2_seat_1 ↔ arm_r/j2_bearing_1.od_face_top | — | 16 · Right arm: yoke and upper arm (shoulder-out and twist joints) (1 of 3)
arm_r/arm_r_j2_hub_in_bearing_1 | arm_r/j2_bearing_1.bore ↔ arm_r/j2_hub.journal_1 | — | 16 · Right arm: yoke and upper arm (shoulder-out and twist joints) (1 of 3)
arm_r/arm_r_j2_cap_on_drum | arm_r/upper.j2_cap_seat ↔ arm_r/j2_cap.to_drum | j_arm_r_j2_cap_on_drum | 17 · Right arm: yoke and upper arm (shoulder-out and twist joints) (2 of 3)
arm_r/arm_r_j2_bearing_2_in_cap | arm_r/j2_cap.seat ↔ arm_r/j2_bearing_2.od_face_top | — | 17 · Right arm: yoke and upper arm (shoulder-out and twist joints) (2 of 3)
arm_r/arm_r_j2_hub_in_bearing_2 | arm_r/j2_bearing_2.bore ↔ arm_r/j2_hub.journal_2 | — | 17 · Right arm: yoke and upper arm (shoulder-out and twist joints) (2 of 3)
arm_r/arm_r_yoke_fork_face_a | arm_r/j2_hub.face_a ↔ arm_r/yoke.fork_face_a | j_arm_r_yoke_fork_face_a | 17 · Right arm: yoke and upper arm (shoulder-out and twist joints) (2 of 3)
arm_r/arm_r_yoke_fork_face_b | arm_r/j2_hub.face_b ↔ arm_r/yoke.fork_face_b | j_arm_r_yoke_fork_face_b | 17 · Right arm: yoke and upper arm (shoulder-out and twist joints) (2 of 3)
arm_r/arm_r_j3_servo_case_top | arm_r/upper_twist.case_top ↔ arm_r/upper.j3_servo_case_top | j_arm_r_j3_servo_case_top | 17 · Right arm: yoke and upper arm (shoulder-out and twist joints) (2 of 3)

PR0TOBOARD · UHDJJ-B-AG · Rev A · 2026-10-2487 / 116

Joyful Jack, Tier B, MidrangeAssembly guideJJ-B-AG

Mates (continued)

Mate | Interfaces | Harness | Step
arm_r/arm_r_j3_servo_case_bottom | arm_r/upper_twist.case_bottom ↔ arm_r/upper.j3_servo_case_bottom | j_arm_r_j3_servo_case_bottom | 17 · Right arm: yoke and upper arm (shoulder-out and twist joints) (2 of 3)
arm_r/arm_r_j3_bearing_up_seat | arm_r/upper.j3_seat_up ↔ arm_r/j3_bearing_up.od_face_top | — | 17 · Right arm: yoke and upper arm (shoulder-out and twist joints) (2 of 3)
arm_r/arm_r_j3_bearing_lo_seat | arm_r/upper.j3_seat_lo ↔ arm_r/j3_bearing_lo.od_face_top | — | 18 · Right arm: yoke and upper arm (shoulder-out and twist joints) (3 of 3)
arm_r/arm_r_j3_disc_on_horn | arm_r/upper_twist.horn ↔ arm_r/j3_disc.horn | j_arm_r_j3_disc_on_horn | 18 · Right arm: yoke and upper arm (shoulder-out and twist joints) (3 of 3)
arm_r/arm_r_j3_hub_in_bearing | arm_r/j3_bearing_lo.bore ↔ arm_r/j3_hub.journal | — | 18 · Right arm: yoke and upper arm (shoulder-out and twist joints) (3 of 3)
arm_r/arm_r_j3_hub_to_disc | arm_r/j3_disc.hub ↔ arm_r/j3_hub.top | j_arm_r_j3_hub_to_disc | 18 · Right arm: yoke and upper arm (shoulder-out and twist joints) (3 of 3)
arm_r/arm_r_j2_arbor_on_yoke | arm_r/yoke.arbor_seat ↔ arm_r/j2_arbor.on_yoke | j_arm_r_j2_arbor_on_yoke | 18 · Right arm: yoke and upper arm (shoulder-out and twist joints) (3 of 3)
arm_r/arm_r_j2_spring_0_on_arbor | arm_r/j2_arbor.spring_0 ↔ arm_r/j2_spring_0.bore_a | — | 18 · Right arm: yoke and upper arm (shoulder-out and twist joints) (3 of 3)
arm_r/arm_r_j2_spring_1_on_arbor | arm_r/j2_arbor.spring_1 ↔ arm_r/j2_spring_1.bore_a | — | 18 · Right arm: yoke and upper arm (shoulder-out and twist joints) (3 of 3)

PR0TOBOARD · UHDJJ-B-AG · Rev A · 2026-10-2488 / 116

Joyful Jack, Tier B, MidrangeAssembly guideJJ-B-AG

Mates (continued)

Mate | Interfaces | Harness | Step
arm_r/arm_r_j4_servo_case_top | arm_r/elbow.case_top ↔ arm_r/elbow_housing.j4_servo_case_top | j_arm_r_j4_servo_case_top | 19 · Right arm: elbow housing and elbow drive (1 of 2)
arm_r/arm_r_j4_servo_case_bottom | arm_r/elbow.case_bottom ↔ arm_r/elbow_housing.j4_servo_case_bottom | j_arm_r_j4_servo_case_bottom | 19 · Right arm: elbow housing and elbow drive (1 of 2)
arm_r/arm_r_j4_driver_on_horn | arm_r/elbow.horn ↔ arm_r/j4_driver.horn | j_arm_r_j4_driver_on_horn | 19 · Right arm: elbow housing and elbow drive (1 of 2)
arm_r/arm_r_j4_dowel_in_pulley | arm_r/j4_driver.dowel ↔ arm_r/j4_dowel.end | — | 19 · Right arm: elbow housing and elbow drive (1 of 2)
arm_r/arm_r_j4_driver_bearing_seat | arm_r/elbow_housing.j4_driver_seat ↔ arm_r/j4_driver_bearing.od_face_top | — | 19 · Right arm: elbow housing and elbow drive (1 of 2)
arm_r/arm_r_j4_belt_on_pulley | arm_r/j4_driver.belt ↔ arm_r/j4_belt.driver | — | 19 · Right arm: elbow housing and elbow drive (1 of 2)
arm_r/arm_r_j4_bearing_1_seat | arm_r/elbow_housing.j4_seat_1 ↔ arm_r/j4_bearing_1.od_face_top | — | 20 · Right arm: elbow housing and elbow drive (2 of 2)
arm_r/arm_r_j4_hub_in_bearing_1 | arm_r/j4_bearing_1.bore ↔ arm_r/j4_hub.journal_1 | — | 20 · Right arm: elbow housing and elbow drive (2 of 2)

PR0TOBOARD · UHDJJ-B-AG · Rev A · 2026-10-2489 / 116

Joyful Jack, Tier B, MidrangeAssembly guideJJ-B-AG

Mates (continued)

Mate | Interfaces | Harness | Step
arm_r/arm_r_j4_cap_on_drum | arm_r/elbow_housing.j4_cap_seat ↔ arm_r/j4_cap.to_drum | j_arm_r_j4_cap_on_drum | 20 · Right arm: elbow housing and elbow drive (2 of 2)
arm_r/arm_r_j4_bearing_2_in_cap | arm_r/j4_cap.seat ↔ arm_r/j4_bearing_2.od_face_top | — | 20 · Right arm: elbow housing and elbow drive (2 of 2)
arm_r/arm_r_j4_hub_in_bearing_2 | arm_r/j4_bearing_2.bore ↔ arm_r/j4_hub.journal_2 | — | 20 · Right arm: elbow housing and elbow drive (2 of 2)
arm_r/arm_r_elbow_on_j3_hub | arm_r/j3_hub.out ↔ arm_r/elbow_housing.on_j3 | j_arm_r_elbow_on_j3_hub | 20 · Right arm: elbow housing and elbow drive (2 of 2)
arm_r/arm_r_fork_in_on_j4 | arm_r/j4_hub.face_b ↔ arm_r/fork_in.on_hub | j_arm_r_fork_in_on_j4 | 21 · Right arm: forearm and wrist-twist joint (1 of 2)
arm_r/arm_r_fork_out_on_j4 | arm_r/j4_hub.face_a ↔ arm_r/fork_out.on_hub | j_arm_r_fork_out_on_j4 | 21 · Right arm: forearm and wrist-twist joint (1 of 2)
arm_r/arm_r_j5_servo_case_top | arm_r/wrist_twist.case_top ↔ arm_r/fore.j5_servo_case_top | j_arm_r_j5_servo_case_top | 21 · Right arm: forearm and wrist-twist joint (1 of 2)
arm_r/arm_r_j5_servo_case_bottom | arm_r/wrist_twist.case_bottom ↔ arm_r/fore.j5_servo_case_bottom | j_arm_r_j5_servo_case_bottom | 21 · Right arm: forearm and wrist-twist joint (1 of 2)
arm_r/arm_r_j5_bearing_up_seat | arm_r/fore.j5_seat_up ↔ arm_r/j5_bearing_up.od_face_top | — | 21 · Right arm: forearm and wrist-twist joint (1 of 2)
arm_r/arm_r_j5_bearing_lo_seat | arm_r/fore.j5_seat_lo ↔ arm_r/j5_bearing_lo.od_face_top | — | 21 · Right arm: forearm and wrist-twist joint (1 of 2)
arm_r/arm_r_j5_disc_on_horn | arm_r/wrist_twist.horn ↔ arm_r/j5_disc.horn | j_arm_r_j5_disc_on_horn | 22 · Right arm: forearm and wrist-twist joint (2 of 2)
arm_r/arm_r_j5_hub_in_bearing | arm_r/j5_bearing_lo.bore ↔ arm_r/j5_hub.journal | — | 22 · Right arm: forearm and wrist-twist joint (2 of 2)
arm_r/arm_r_j5_hub_to_disc | arm_r/j5_disc.hub ↔ arm_r/j5_hub.top | j_arm_r_j5_hub_to_disc | 22 · Right arm: forearm and wrist-twist joint (2 of 2)
arm_r/arm_r_fork_in_to_body | arm_r/fore.to_fork_in ↔ arm_r/fork_in.to_body | j_arm_r_fork_in_to_body | 22 · Right arm: forearm and wrist-twist joint (2 of 2)
arm_r/arm_r_fork_out_to_body | arm_r/fore.to_fork_out ↔ arm_r/fork_out.to_body | j_arm_r_fork_out_to_body | 22 · Right arm: forearm and wrist-twist joint (2 of 2)
arm_r/arm_r_hand_palm_on_wrist | arm_r/j5_hub.out ↔ arm_r/hand__palm.on_wrist | j_arm_r_hand_palm_on_wrist | 23 · Right arm: hand (1 of 2)

PR0TOBOARD · UHDJJ-B-AG · Rev A · 2026-10-2490 / 116

Joyful Jack, Tier B, MidrangeAssembly guideJJ-B-AG

Mates (continued)

Mate | Interfaces | Harness | Step
arm_r/arm_r_hand_fingers_servo_case_top | arm_r/fingers.case_top ↔ arm_r/hand__palm.fingers_servo_case_top | j_arm_r_hand_fingers_servo_case_top | 23 · Right arm: hand (1 of 2)
arm_r/arm_r_hand_fingers_servo_case_bottom | arm_r/fingers.case_bottom ↔ arm_r/hand__palm.fingers_servo_case_bottom | j_arm_r_hand_fingers_servo_case_bottom | 23 · Right arm: hand (1 of 2)
arm_r/arm_r_hand_thumb_servo_case_top | arm_r/thumb.case_top ↔ arm_r/hand__palm.thumb_servo_case_top | j_arm_r_hand_thumb_servo_case_top | 23 · Right arm: hand (1 of 2)
arm_r/arm_r_hand_thumb_servo_case_bottom | arm_r/thumb.case_bottom ↔ arm_r/hand__palm.thumb_servo_case_bottom | j_arm_r_hand_thumb_servo_case_bottom | 23 · Right arm: hand (1 of 2)
arm_r/arm_r_hand_fingers_on_horn | arm_r/fingers.horn ↔ arm_r/hand__fingers.on_horn | j_arm_r_hand_fingers_on_horn | 24 · Right arm: hand (2 of 2)
arm_r/arm_r_hand_fingers_on_rear_horn | arm_r/fingers.horn_back ↔ arm_r/hand__fingers.on_rear_horn | j_arm_r_hand_fingers_on_rear_horn | 24 · Right arm: hand (2 of 2)
arm_r/arm_r_hand_thumb_on_horn | arm_r/thumb.horn ↔ arm_r/hand__thumb.on_horn | j_arm_r_hand_thumb_on_horn | 24 · Right arm: hand (2 of 2)
arm_r/arm_r_hand_thumb_on_rear_horn | arm_r/thumb.horn_back ↔ arm_r/hand__thumb.on_rear_horn | j_arm_r_hand_thumb_on_rear_horn | 24 · Right arm: hand (2 of 2)
arm_l/arm_l_j1_servo_case_top | arm_l/shoulder_flex.case_top ↔ arm_l/j1_housing.j1_servo_case_top | j_arm_l_j1_servo_case_top | 25 · Left arm: shoulder housing, J1 servo, belt and springs (1 of 2)
arm_l/arm_l_j1_servo_case_bottom | arm_l/shoulder_flex.case_bottom ↔ arm_l/j1_housing.j1_servo_case_bottom | j_arm_l_j1_servo_case_bottom | 25 · Left arm: shoulder housing, J1 servo, belt and springs (1 of 2)

PR0TOBOARD · UHDJJ-B-AG · Rev A · 2026-10-2491 / 116

Joyful Jack, Tier B, MidrangeAssembly guideJJ-B-AG

Mates (continued)

Mate | Interfaces | Harness | Step
arm_l/arm_l_j1_driver_on_horn | arm_l/shoulder_flex.horn ↔ arm_l/j1_driver.horn | j_arm_l_j1_driver_on_horn | 25 · Left arm: shoulder housing, J1 servo, belt and springs (1 of 2)
arm_l/arm_l_j1_dowel_in_pulley | arm_l/j1_driver.dowel ↔ arm_l/j1_dowel.end | — | 25 · Left arm: shoulder housing, J1 servo, belt and springs (1 of 2)
arm_l/arm_l_j1_driver_bearing_seat | arm_l/j1_housing.j1_driver_seat ↔ arm_l/j1_driver_bearing.od_face_top | — | 25 · Left arm: shoulder housing, J1 servo, belt and springs (1 of 2)
arm_l/arm_l_j1_belt_on_pulley | arm_l/j1_driver.belt ↔ arm_l/j1_belt.driver | — | 25 · Left arm: shoulder housing, J1 servo, belt and springs (1 of 2)
arm_l/arm_l_j1_bearing_1_seat | arm_l/j1_housing.j1_seat_1 ↔ arm_l/j1_bearing_1.od_face_top | — | 25 · Left arm: shoulder housing, J1 servo, belt and springs (1 of 2)
arm_l/arm_l_j1_hub_in_bearing_1 | arm_l/j1_bearing_1.bore ↔ arm_l/j1_hub.journal_1 | — | 25 · Left arm: shoulder housing, J1 servo, belt and springs (1 of 2)
arm_l/arm_l_j1_cap_on_drum | arm_l/j1_housing.j1_cap_seat ↔ arm_l/j1_cap.to_drum | j_arm_l_j1_cap_on_drum | 26 · Left arm: shoulder housing, J1 servo, belt and springs (2 of 2)
arm_l/arm_l_j1_bearing_2_in_cap | arm_l/j1_cap.seat ↔ arm_l/j1_bearing_2.od_face_top | — | 26 · Left arm: shoulder housing, J1 servo, belt and springs (2 of 2)
arm_l/arm_l_j1_hub_in_bearing_2 | arm_l/j1_bearing_2.bore ↔ arm_l/j1_hub.journal_2 | — | 26 · Left arm: shoulder housing, J1 servo, belt and springs (2 of 2)
arm_l/arm_l_j1_arbor_on_hub | arm_l/j1_hub.face_b ↔ arm_l/j1_arbor.on_hub | j_arm_l_j1_arbor_on_hub | 26 · Left arm: shoulder housing, J1 servo, belt and springs (2 of 2)
arm_l/arm_l_j1_spring_0_on_arbor | arm_l/j1_arbor.spring_0 ↔ arm_l/j1_spring_0.bore_a | — | 26 · Left arm: shoulder housing, J1 servo, belt and springs (2 of 2)

PR0TOBOARD · UHDJJ-B-AG · Rev A · 2026-10-2492 / 116

Joyful Jack, Tier B, MidrangeAssembly guideJJ-B-AG

Mates (continued)

Mate | Interfaces | Harness | Step
arm_l/arm_l_j1_spring_1_on_arbor | arm_l/j1_arbor.spring_1 ↔ arm_l/j1_spring_1.bore_a | — | 26 · Left arm: shoulder housing, J1 servo, belt and springs (2 of 2)
arm_l/arm_l_yoke_on_j1_hub | arm_l/j1_hub.face_a ↔ arm_l/yoke.on_j1_hub | j_arm_l_yoke_on_j1_hub | 26 · Left arm: shoulder housing, J1 servo, belt and springs (2 of 2)
arm_l/arm_l_j2_servo_case_top | arm_l/shoulder_out.case_top ↔ arm_l/upper.j2_servo_case_top | j_arm_l_j2_servo_case_top | 27 · Left arm: yoke and upper arm (shoulder-out and twist joints) (1 of 3)
arm_l/arm_l_j2_servo_case_bottom | arm_l/shoulder_out.case_bottom ↔ arm_l/upper.j2_servo_case_bottom | j_arm_l_j2_servo_case_bottom | 27 · Left arm: yoke and upper arm (shoulder-out and twist joints) (1 of 3)
arm_l/arm_l_j2_driver_on_horn | arm_l/shoulder_out.horn ↔ arm_l/j2_driver.horn | j_arm_l_j2_driver_on_horn | 27 · Left arm: yoke and upper arm (shoulder-out and twist joints) (1 of 3)
arm_l/arm_l_j2_dowel_in_pulley | arm_l/j2_driver.dowel ↔ arm_l/j2_dowel.end | — | 27 · Left arm: yoke and upper arm (shoulder-out and twist joints) (1 of 3)
arm_l/arm_l_j2_driver_bearing_seat | arm_l/upper.j2_driver_seat ↔ arm_l/j2_driver_bearing.od_face_top | — | 27 · Left arm: yoke and upper arm (shoulder-out and twist joints) (1 of 3)
arm_l/arm_l_j2_belt_on_pulley | arm_l/j2_driver.belt ↔ arm_l/j2_belt.driver | — | 27 · Left arm: yoke and upper arm (shoulder-out and twist joints) (1 of 3)
arm_l/arm_l_j2_bearing_1_seat | arm_l/upper.j2_seat_1 ↔ arm_l/j2_bearing_1.od_face_top | — | 27 · Left arm: yoke and upper arm (shoulder-out and twist joints) (1 of 3)

PR0TOBOARD · UHDJJ-B-AG · Rev A · 2026-10-2493 / 116

Joyful Jack, Tier B, MidrangeAssembly guideJJ-B-AG

Mates (continued)

Mate | Interfaces | Harness | Step
arm_l/arm_l_j2_hub_in_bearing_1 | arm_l/j2_bearing_1.bore ↔ arm_l/j2_hub.journal_1 | — | 27 · Left arm: yoke and upper arm (shoulder-out and twist joints) (1 of 3)
arm_l/arm_l_j2_cap_on_drum | arm_l/upper.j2_cap_seat ↔ arm_l/j2_cap.to_drum | j_arm_l_j2_cap_on_drum | 28 · Left arm: yoke and upper arm (shoulder-out and twist joints) (2 of 3)
arm_l/arm_l_j2_bearing_2_in_cap | arm_l/j2_cap.seat ↔ arm_l/j2_bearing_2.od_face_top | — | 28 · Left arm: yoke and upper arm (shoulder-out and twist joints) (2 of 3)
arm_l/arm_l_j2_hub_in_bearing_2 | arm_l/j2_bearing_2.bore ↔ arm_l/j2_hub.journal_2 | — | 28 · Left arm: yoke and upper arm (shoulder-out and twist joints) (2 of 3)
arm_l/arm_l_yoke_fork_face_a | arm_l/j2_hub.face_a ↔ arm_l/yoke.fork_face_a | j_arm_l_yoke_fork_face_a | 28 · Left arm: yoke and upper arm (shoulder-out and twist joints) (2 of 3)
arm_l/arm_l_yoke_fork_face_b | arm_l/j2_hub.face_b ↔ arm_l/yoke.fork_face_b | j_arm_l_yoke_fork_face_b | 28 · Left arm: yoke and upper arm (shoulder-out and twist joints) (2 of 3)
arm_l/arm_l_j3_servo_case_top | arm_l/upper_twist.case_top ↔ arm_l/upper.j3_servo_case_top | j_arm_l_j3_servo_case_top | 28 · Left arm: yoke and upper arm (shoulder-out and twist joints) (2 of 3)
arm_l/arm_l_j3_servo_case_bottom | arm_l/upper_twist.case_bottom ↔ arm_l/upper.j3_servo_case_bottom | j_arm_l_j3_servo_case_bottom | 28 · Left arm: yoke and upper arm (shoulder-out and twist joints) (2 of 3)
arm_l/arm_l_j3_bearing_up_seat | arm_l/upper.j3_seat_up ↔ arm_l/j3_bearing_up.od_face_top | — | 28 · Left arm: yoke and upper arm (shoulder-out and twist joints) (2 of 3)
arm_l/arm_l_j3_bearing_lo_seat | arm_l/upper.j3_seat_lo ↔ arm_l/j3_bearing_lo.od_face_top | — | 29 · Left arm: yoke and upper arm (shoulder-out and twist joints) (3 of 3)
arm_l/arm_l_j3_disc_on_horn | arm_l/upper_twist.horn ↔ arm_l/j3_disc.horn | j_arm_l_j3_disc_on_horn | 29 · Left arm: yoke and upper arm (shoulder-out and twist joints) (3 of 3)
arm_l/arm_l_j3_hub_in_bearing | arm_l/j3_bearing_lo.bore ↔ arm_l/j3_hub.journal | — | 29 · Left arm: yoke and upper arm (shoulder-out and twist joints) (3 of 3)
arm_l/arm_l_j3_hub_to_disc | arm_l/j3_disc.hub ↔ arm_l/j3_hub.top | j_arm_l_j3_hub_to_disc | 29 · Left arm: yoke and upper arm (shoulder-out and twist joints) (3 of 3)

PR0TOBOARD · UHDJJ-B-AG · Rev A · 2026-10-2494 / 116

Joyful Jack, Tier B, MidrangeAssembly guideJJ-B-AG

Mates (continued)

Mate | Interfaces | Harness | Step
arm_l/arm_l_j2_arbor_on_yoke | arm_l/yoke.arbor_seat ↔ arm_l/j2_arbor.on_yoke | j_arm_l_j2_arbor_on_yoke | 29 · Left arm: yoke and upper arm (shoulder-out and twist joints) (3 of 3)
arm_l/arm_l_j2_spring_0_on_arbor | arm_l/j2_arbor.spring_0 ↔ arm_l/j2_spring_0.bore_a | — | 29 · Left arm: yoke and upper arm (shoulder-out and twist joints) (3 of 3)
arm_l/arm_l_j2_spring_1_on_arbor | arm_l/j2_arbor.spring_1 ↔ arm_l/j2_spring_1.bore_a | — | 29 · Left arm: yoke and upper arm (shoulder-out and twist joints) (3 of 3)
arm_l/arm_l_j4_servo_case_top | arm_l/elbow.case_top ↔ arm_l/elbow_housing.j4_servo_case_top | j_arm_l_j4_servo_case_top | 30 · Left arm: elbow housing and elbow drive (1 of 2)
arm_l/arm_l_j4_servo_case_bottom | arm_l/elbow.case_bottom ↔ arm_l/elbow_housing.j4_servo_case_bottom | j_arm_l_j4_servo_case_bottom | 30 · Left arm: elbow housing and elbow drive (1 of 2)
arm_l/arm_l_j4_driver_on_horn | arm_l/elbow.horn ↔ arm_l/j4_driver.horn | j_arm_l_j4_driver_on_horn | 30 · Left arm: elbow housing and elbow drive (1 of 2)
arm_l/arm_l_j4_dowel_in_pulley | arm_l/j4_driver.dowel ↔ arm_l/j4_dowel.end | — | 30 · Left arm: elbow housing and elbow drive (1 of 2)
arm_l/arm_l_j4_driver_bearing_seat | arm_l/elbow_housing.j4_driver_seat ↔ arm_l/j4_driver_bearing.od_face_top | — | 30 · Left arm: elbow housing and elbow drive (1 of 2)
arm_l/arm_l_j4_belt_on_pulley | arm_l/j4_driver.belt ↔ arm_l/j4_belt.driver | — | 30 · Left arm: elbow housing and elbow drive (1 of 2)

PR0TOBOARD · UHDJJ-B-AG · Rev A · 2026-10-2495 / 116

Joyful Jack, Tier B, MidrangeAssembly guideJJ-B-AG

Mates (continued)

Mate | Interfaces | Harness | Step
arm_l/arm_l_j4_bearing_1_seat | arm_l/elbow_housing.j4_seat_1 ↔ arm_l/j4_bearing_1.od_face_top | — | 31 · Left arm: elbow housing and elbow drive (2 of 2)
arm_l/arm_l_j4_hub_in_bearing_1 | arm_l/j4_bearing_1.bore ↔ arm_l/j4_hub.journal_1 | — | 31 · Left arm: elbow housing and elbow drive (2 of 2)
arm_l/arm_l_j4_cap_on_drum | arm_l/elbow_housing.j4_cap_seat ↔ arm_l/j4_cap.to_drum | j_arm_l_j4_cap_on_drum | 31 · Left arm: elbow housing and elbow drive (2 of 2)
arm_l/arm_l_j4_bearing_2_in_cap | arm_l/j4_cap.seat ↔ arm_l/j4_bearing_2.od_face_top | — | 31 · Left arm: elbow housing and elbow drive (2 of 2)
arm_l/arm_l_j4_hub_in_bearing_2 | arm_l/j4_bearing_2.bore ↔ arm_l/j4_hub.journal_2 | — | 31 · Left arm: elbow housing and elbow drive (2 of 2)
arm_l/arm_l_elbow_on_j3_hub | arm_l/j3_hub.out ↔ arm_l/elbow_housing.on_j3 | j_arm_l_elbow_on_j3_hub | 31 · Left arm: elbow housing and elbow drive (2 of 2)
arm_l/arm_l_fork_in_on_j4 | arm_l/j4_hub.face_b ↔ arm_l/fork_in.on_hub | j_arm_l_fork_in_on_j4 | 32 · Left arm: forearm and wrist-twist joint (1 of 2)
arm_l/arm_l_fork_out_on_j4 | arm_l/j4_hub.face_a ↔ arm_l/fork_out.on_hub | j_arm_l_fork_out_on_j4 | 32 · Left arm: forearm and wrist-twist joint (1 of 2)
arm_l/arm_l_j5_servo_case_top | arm_l/wrist_twist.case_top ↔ arm_l/fore.j5_servo_case_top | j_arm_l_j5_servo_case_top | 32 · Left arm: forearm and wrist-twist joint (1 of 2)
arm_l/arm_l_j5_servo_case_bottom | arm_l/wrist_twist.case_bottom ↔ arm_l/fore.j5_servo_case_bottom | j_arm_l_j5_servo_case_bottom | 32 · Left arm: forearm and wrist-twist joint (1 of 2)
arm_l/arm_l_j5_bearing_up_seat | arm_l/fore.j5_seat_up ↔ arm_l/j5_bearing_up.od_face_top | — | 32 · Left arm: forearm and wrist-twist joint (1 of 2)
arm_l/arm_l_j5_bearing_lo_seat | arm_l/fore.j5_seat_lo ↔ arm_l/j5_bearing_lo.od_face_top | — | 32 · Left arm: forearm and wrist-twist joint (1 of 2)
arm_l/arm_l_j5_disc_on_horn | arm_l/wrist_twist.horn ↔ arm_l/j5_disc.horn | j_arm_l_j5_disc_on_horn | 33 · Left arm: forearm and wrist-twist joint (2 of 2)
arm_l/arm_l_j5_hub_in_bearing | arm_l/j5_bearing_lo.bore ↔ arm_l/j5_hub.journal | — | 33 · Left arm: forearm and wrist-twist joint (2 of 2)
arm_l/arm_l_j5_hub_to_disc | arm_l/j5_disc.hub ↔ arm_l/j5_hub.top | j_arm_l_j5_hub_to_disc | 33 · Left arm: forearm and wrist-twist joint (2 of 2)
arm_l/arm_l_fork_in_to_body | arm_l/fore.to_fork_in ↔ arm_l/fork_in.to_body | j_arm_l_fork_in_to_body | 33 · Left arm: forearm and wrist-twist joint (2 of 2)

PR0TOBOARD · UHDJJ-B-AG · Rev A · 2026-10-2496 / 116

Joyful Jack, Tier B, MidrangeAssembly guideJJ-B-AG

Mates (continued)

Mate | Interfaces | Harness | Step
arm_l/arm_l_fork_out_to_body | arm_l/fore.to_fork_out ↔ arm_l/fork_out.to_body | j_arm_l_fork_out_to_body | 33 · Left arm: forearm and wrist-twist joint (2 of 2)
arm_l/arm_l_hand_palm_on_wrist | arm_l/j5_hub.out ↔ arm_l/hand__palm.on_wrist | j_arm_l_hand_palm_on_wrist | 34 · Left arm: hand (1 of 2)
arm_l/arm_l_hand_fingers_servo_case_top | arm_l/fingers.case_top ↔ arm_l/hand__palm.fingers_servo_case_top | j_arm_l_hand_fingers_servo_case_top | 34 · Left arm: hand (1 of 2)
arm_l/arm_l_hand_fingers_servo_case_bottom | arm_l/fingers.case_bottom ↔ arm_l/hand__palm.fingers_servo_case_bottom | j_arm_l_hand_fingers_servo_case_bottom | 34 · Left arm: hand (1 of 2)
arm_l/arm_l_hand_thumb_servo_case_top | arm_l/thumb.case_top ↔ arm_l/hand__palm.thumb_servo_case_top | j_arm_l_hand_thumb_servo_case_top | 34 · Left arm: hand (1 of 2)
arm_l/arm_l_hand_thumb_servo_case_bottom | arm_l/thumb.case_bottom ↔ arm_l/hand__palm.thumb_servo_case_bottom | j_arm_l_hand_thumb_servo_case_bottom | 34 · Left arm: hand (1 of 2)
arm_l/arm_l_hand_fingers_on_horn | arm_l/fingers.horn ↔ arm_l/hand__fingers.on_horn | j_arm_l_hand_fingers_on_horn | 35 · Left arm: hand (2 of 2)
arm_l/arm_l_hand_fingers_on_rear_horn | arm_l/fingers.horn_back ↔ arm_l/hand__fingers.on_rear_horn | j_arm_l_hand_fingers_on_rear_horn | 35 · Left arm: hand (2 of 2)
arm_l/arm_l_hand_thumb_on_horn | arm_l/thumb.horn ↔ arm_l/hand__thumb.on_horn | j_arm_l_hand_thumb_on_horn | 35 · Left arm: hand (2 of 2)
arm_l/arm_l_hand_thumb_on_rear_horn | arm_l/thumb.horn_back ↔ arm_l/hand__thumb.on_rear_horn | j_arm_l_hand_thumb_on_rear_horn | 35 · Left arm: hand (2 of 2)

## Hardware placements

Hardware (continued)

Harness / child | Parts | Joint | Step
j_head_on_neck_plate/iso7089_m5 | 4 × M5 flat washer, ISO 7089 | head_on_neck_plate | 37 · Fit the head on the neck plate
j_head_on_neck_plate/iso10511_m5 | 4 × M5 nyloc hex nut, ISO 10511 | head_on_neck_plate | 37 · Fit the head on the neck plate

PR0TOBOARD · UHDJJ-B-AG · Rev A · 2026-10-2497 / 116

Joyful Jack, Tier B, MidrangeAssembly guideJJ-B-AG

Hardware (continued)

Harness / child | Parts | Joint | Step
j_head_on_neck_plate/iso4762_m5x20 | 4 × M5 x 20 SHCS | head_on_neck_plate | 37 · Fit the head on the neck plate
j_dock_1_on_base/iso7089_m4 | 4 × M4 flat washer, ISO 7089 | dock_1_on_base | 13 · Put the power parts in their trays and bolt down the battery docks (2 of 2)
j_dock_1_on_base/iso10511_m4 | 2 × M4 nyloc hex nut, ISO 10511 | dock_1_on_base | 13 · Put the power parts in their trays and bolt down the battery docks (2 of 2)
j_dock_1_on_base/iso4762_m4x20 | 2 × M4 x 20 SHCS | dock_1_on_base | 13 · Put the power parts in their trays and bolt down the battery docks (2 of 2)
j_dock_2_on_base/iso7089_m4 | 4 × M4 flat washer, ISO 7089 | dock_2_on_base | 13 · Put the power parts in their trays and bolt down the battery docks (2 of 2)
j_dock_2_on_base/iso10511_m4 | 2 × M4 nyloc hex nut, ISO 10511 | dock_2_on_base | 13 · Put the power parts in their trays and bolt down the battery docks (2 of 2)
j_dock_2_on_base/iso4762_m4x20 | 2 × M4 x 20 SHCS | dock_2_on_base | 13 · Put the power parts in their trays and bolt down the battery docks (2 of 2)
j_arm_r_foot/tnut_2020_m5 | 2 × M5 roll-in T-nut for 2020 extrusion | arm_r_foot | 36 · Mount the arms on the torso
j_arm_r_foot/iso4762_m5x12 | 2 × M5 x 12 SHCS | arm_r_foot | 36 · Mount the arms on the torso
j_arm_l_foot/tnut_2020_m5 | 2 × M5 roll-in T-nut for 2020 extrusion | arm_l_foot | 36 · Mount the arms on the torso
j_arm_l_foot/iso4762_m5x12 | 2 × M5 x 12 SHCS | arm_l_foot | 36 · Mount the arms on the torso
body/j_bucket_on_skirt/hex_bolt_1_4_20x1_25in | 4 × 1/4-20 x 1.25 in hex bolt, zinc | body/bucket_on_skirt | 1 · Build the base: skirt, bucket, flanges and mast
body/j_bucket_on_skirt/nylock_1_4_20 | 4 × 1/4-20 nylon-insert lock nut, zinc | body/bucket_on_skirt | 1 · Build the base: skirt, bucket, flanges and mast
body/j_plate_on_flange/nylock_1_4_20 | 4 × 1/4-20 nylon-insert lock nut, zinc | body/plate_on_flange | 2 · Build the torso frame on the top flange (1 of 5)
body/j_plate_on_flange/hex_bolt_1_4_20x1in | 4 × 1/4-20 x 1 in hex bolt, zinc | body/plate_on_flange | 2 · Build the torso frame on the top flange (1 of 5)
body/j_upright_rf_on_plate/iso4762_m5x12 | 1 × M5 x 12 SHCS | body/upright_rf_on_plate | 2 · Build the torso frame on the top flange (1 of 5)
body/j_upright_rb_on_plate/iso4762_m5x12 | 1 × M5 x 12 SHCS | body/upright_rb_on_plate | 2 · Build the torso frame on the top flange (1 of 5)
body/j_upright_lf_on_plate/iso4762_m5x12 | 1 × M5 x 12 SHCS | body/upright_lf_on_plate | 2 · Build the torso frame on the top flange (1 of 5)
body/j_upright_lb_on_plate/iso4762_m5x12 | 1 × M5 x 12 SHCS | body/upright_lb_on_plate | 2 · Build the torso frame on the top flange (1 of 5)

PR0TOBOARD · UHDJJ-B-AG · Rev A · 2026-10-2498 / 116

Joyful Jack, Tier B, MidrangeAssembly guideJJ-B-AG

Hardware (continued)

Harness / child | Parts | Joint | Step
body/j_bracket_01_on_rail/tnut_2020_m5 | 1 × M5 roll-in T-nut for 2020 extrusion | body/bracket_01_on_rail | 2 · Build the torso frame on the top flange (1 of 5)
body/j_bracket_01_on_rail/iso4762_m5x10 | 1 × M5 x 10 SHCS | body/bracket_01_on_rail | 2 · Build the torso frame on the top flange (1 of 5)
body/j_bracket_01_on_upright/tnut_2020_m5 | 1 × M5 roll-in T-nut for 2020 extrusion | body/bracket_01_on_upright | 2 · Build the torso frame on the top flange (1 of 5)
body/j_bracket_01_on_upright/iso4762_m5x10 | 1 × M5 x 10 SHCS | body/bracket_01_on_upright | 2 · Build the torso frame on the top flange (1 of 5)
body/j_bracket_02_on_rail/tnut_2020_m5 | 1 × M5 roll-in T-nut for 2020 extrusion | body/bracket_02_on_rail | 2 · Build the torso frame on the top flange (1 of 5)
body/j_bracket_02_on_rail/iso4762_m5x10 | 1 × M5 x 10 SHCS | body/bracket_02_on_rail | 2 · Build the torso frame on the top flange (1 of 5)
body/j_bracket_02_on_upright/tnut_2020_m5 | 1 × M5 roll-in T-nut for 2020 extrusion | body/bracket_02_on_upright | 3 · Build the torso frame on the top flange (2 of 5)
body/j_bracket_02_on_upright/iso4762_m5x10 | 1 × M5 x 10 SHCS | body/bracket_02_on_upright | 3 · Build the torso frame on the top flange (2 of 5)
body/j_bracket_03_on_rail/tnut_2020_m5 | 1 × M5 roll-in T-nut for 2020 extrusion | body/bracket_03_on_rail | 3 · Build the torso frame on the top flange (2 of 5)
body/j_bracket_03_on_rail/iso4762_m5x10 | 1 × M5 x 10 SHCS | body/bracket_03_on_rail | 3 · Build the torso frame on the top flange (2 of 5)
body/j_bracket_03_on_upright/tnut_2020_m5 | 1 × M5 roll-in T-nut for 2020 extrusion | body/bracket_03_on_upright | 3 · Build the torso frame on the top flange (2 of 5)
body/j_bracket_03_on_upright/iso4762_m5x10 | 1 × M5 x 10 SHCS | body/bracket_03_on_upright | 3 · Build the torso frame on the top flange (2 of 5)
body/j_bracket_04_on_rail/tnut_2020_m5 | 1 × M5 roll-in T-nut for 2020 extrusion | body/bracket_04_on_rail | 3 · Build the torso frame on the top flange (2 of 5)
body/j_bracket_04_on_rail/iso4762_m5x10 | 1 × M5 x 10 SHCS | body/bracket_04_on_rail | 3 · Build the torso frame on the top flange (2 of 5)
body/j_bracket_04_on_upright/tnut_2020_m5 | 1 × M5 roll-in T-nut for 2020 extrusion | body/bracket_04_on_upright | 3 · Build the torso frame on the top flange (2 of 5)
body/j_bracket_04_on_upright/iso4762_m5x10 | 1 × M5 x 10 SHCS | body/bracket_04_on_upright | 3 · Build the torso frame on the top flange (2 of 5)
body/j_bracket_05_on_rail/tnut_2020_m5 | 1 × M5 roll-in T-nut for 2020 extrusion | body/bracket_05_on_rail | 3 · Build the torso frame on the top flange (2 of 5)
body/j_bracket_05_on_rail/iso4762_m5x10 | 1 × M5 x 10 SHCS | body/bracket_05_on_rail | 3 · Build the torso frame on the top flange (2 of 5)
body/j_bracket_05_on_upright/tnut_2020_m5 | 1 × M5 roll-in T-nut for 2020 extrusion | body/bracket_05_on_upright | 3 · Build the torso frame on the top flange (2 of 5)
body/j_bracket_05_on_upright/iso4762_m5x10 | 1 × M5 x 10 SHCS | body/bracket_05_on_upright | 3 · Build the torso frame on the top flange (2 of 5)

PR0TOBOARD · UHDJJ-B-AG · Rev A · 2026-10-2499 / 116

Joyful Jack, Tier B, MidrangeAssembly guideJJ-B-AG

Hardware (continued)

Harness / child | Parts | Joint | Step
body/j_bracket_06_on_rail/tnut_2020_m5 | 1 × M5 roll-in T-nut for 2020 extrusion | body/bracket_06_on_rail | 3 · Build the torso frame on the top flange (2 of 5)
body/j_bracket_06_on_rail/iso4762_m5x10 | 1 × M5 x 10 SHCS | body/bracket_06_on_rail | 3 · Build the torso frame on the top flange (2 of 5)
body/j_bracket_06_on_upright/tnut_2020_m5 | 1 × M5 roll-in T-nut for 2020 extrusion | body/bracket_06_on_upright | 4 · Build the torso frame on the top flange (3 of 5)
body/j_bracket_06_on_upright/iso4762_m5x10 | 1 × M5 x 10 SHCS | body/bracket_06_on_upright | 4 · Build the torso frame on the top flange (3 of 5)
body/j_bracket_07_on_rail/tnut_2020_m5 | 1 × M5 roll-in T-nut for 2020 extrusion | body/bracket_07_on_rail | 4 · Build the torso frame on the top flange (3 of 5)
body/j_bracket_07_on_rail/iso4762_m5x10 | 1 × M5 x 10 SHCS | body/bracket_07_on_rail | 4 · Build the torso frame on the top flange (3 of 5)
body/j_bracket_07_on_upright/tnut_2020_m5 | 1 × M5 roll-in T-nut for 2020 extrusion | body/bracket_07_on_upright | 4 · Build the torso frame on the top flange (3 of 5)
body/j_bracket_07_on_upright/iso4762_m5x10 | 1 × M5 x 10 SHCS | body/bracket_07_on_upright | 4 · Build the torso frame on the top flange (3 of 5)
body/j_bracket_08_on_rail/tnut_2020_m5 | 1 × M5 roll-in T-nut for 2020 extrusion | body/bracket_08_on_rail | 4 · Build the torso frame on the top flange (3 of 5)
body/j_bracket_08_on_rail/iso4762_m5x10 | 1 × M5 x 10 SHCS | body/bracket_08_on_rail | 4 · Build the torso frame on the top flange (3 of 5)
body/j_bracket_08_on_upright/tnut_2020_m5 | 1 × M5 roll-in T-nut for 2020 extrusion | body/bracket_08_on_upright | 4 · Build the torso frame on the top flange (3 of 5)
body/j_bracket_08_on_upright/iso4762_m5x10 | 1 × M5 x 10 SHCS | body/bracket_08_on_upright | 4 · Build the torso frame on the top flange (3 of 5)
body/j_bracket_09_on_rail/tnut_2020_m5 | 1 × M5 roll-in T-nut for 2020 extrusion | body/bracket_09_on_rail | 4 · Build the torso frame on the top flange (3 of 5)
body/j_bracket_09_on_rail/iso4762_m5x10 | 1 × M5 x 10 SHCS | body/bracket_09_on_rail | 4 · Build the torso frame on the top flange (3 of 5)
body/j_bracket_09_on_upright/tnut_2020_m5 | 1 × M5 roll-in T-nut for 2020 extrusion | body/bracket_09_on_upright | 4 · Build the torso frame on the top flange (3 of 5)
body/j_bracket_09_on_upright/iso4762_m5x10 | 1 × M5 x 10 SHCS | body/bracket_09_on_upright | 4 · Build the torso frame on the top flange (3 of 5)
body/j_bracket_10_on_rail/tnut_2020_m5 | 1 × M5 roll-in T-nut for 2020 extrusion | body/bracket_10_on_rail | 4 · Build the torso frame on the top flange (3 of 5)
body/j_bracket_10_on_rail/iso4762_m5x10 | 1 × M5 x 10 SHCS | body/bracket_10_on_rail | 4 · Build the torso frame on the top flange (3 of 5)
body/j_bracket_10_on_upright/tnut_2020_m5 | 1 × M5 roll-in T-nut for 2020 extrusion | body/bracket_10_on_upright | 5 · Build the torso frame on the top flange (4 of 5)
body/j_bracket_10_on_upright/iso4762_m5x10 | 1 × M5 x 10 SHCS | body/bracket_10_on_upright | 5 · Build the torso frame on the top flange (4 of 5)

PR0TOBOARD · UHDJJ-B-AG · Rev A · 2026-10-24100 / 116

Joyful Jack, Tier B, MidrangeAssembly guideJJ-B-AG

Hardware (continued)

Harness / child | Parts | Joint | Step
body/j_bracket_11_on_rail/tnut_2020_m5 | 1 × M5 roll-in T-nut for 2020 extrusion | body/bracket_11_on_rail | 5 · Build the torso frame on the top flange (4 of 5)
body/j_bracket_11_on_rail/iso4762_m5x10 | 1 × M5 x 10 SHCS | body/bracket_11_on_rail | 5 · Build the torso frame on the top flange (4 of 5)
body/j_bracket_11_on_upright/tnut_2020_m5 | 1 × M5 roll-in T-nut for 2020 extrusion | body/bracket_11_on_upright | 5 · Build the torso frame on the top flange (4 of 5)
body/j_bracket_11_on_upright/iso4762_m5x10 | 1 × M5 x 10 SHCS | body/bracket_11_on_upright | 5 · Build the torso frame on the top flange (4 of 5)
body/j_bracket_12_on_rail/tnut_2020_m5 | 1 × M5 roll-in T-nut for 2020 extrusion | body/bracket_12_on_rail | 5 · Build the torso frame on the top flange (4 of 5)
body/j_bracket_12_on_rail/iso4762_m5x10 | 1 × M5 x 10 SHCS | body/bracket_12_on_rail | 5 · Build the torso frame on the top flange (4 of 5)
body/j_bracket_12_on_upright/tnut_2020_m5 | 1 × M5 roll-in T-nut for 2020 extrusion | body/bracket_12_on_upright | 5 · Build the torso frame on the top flange (4 of 5)
body/j_bracket_12_on_upright/iso4762_m5x10 | 1 × M5 x 10 SHCS | body/bracket_12_on_upright | 5 · Build the torso frame on the top flange (4 of 5)
body/j_bracket_13_on_rail/tnut_2020_m5 | 1 × M5 roll-in T-nut for 2020 extrusion | body/bracket_13_on_rail | 5 · Build the torso frame on the top flange (4 of 5)
body/j_bracket_13_on_rail/iso4762_m5x10 | 1 × M5 x 10 SHCS | body/bracket_13_on_rail | 5 · Build the torso frame on the top flange (4 of 5)
body/j_bracket_13_on_upright/tnut_2020_m5 | 1 × M5 roll-in T-nut for 2020 extrusion | body/bracket_13_on_upright | 5 · Build the torso frame on the top flange (4 of 5)
body/j_bracket_13_on_upright/iso4762_m5x10 | 1 × M5 x 10 SHCS | body/bracket_13_on_upright | 5 · Build the torso frame on the top flange (4 of 5)
body/j_bracket_14_on_rail/tnut_2020_m5 | 1 × M5 roll-in T-nut for 2020 extrusion | body/bracket_14_on_rail | 5 · Build the torso frame on the top flange (4 of 5)
body/j_bracket_14_on_rail/iso4762_m5x10 | 1 × M5 x 10 SHCS | body/bracket_14_on_rail | 5 · Build the torso frame on the top flange (4 of 5)
body/j_bracket_14_on_upright/tnut_2020_m5 | 1 × M5 roll-in T-nut for 2020 extrusion | body/bracket_14_on_upright | 6 · Build the torso frame on the top flange (5 of 5)
body/j_bracket_14_on_upright/iso4762_m5x10 | 1 × M5 x 10 SHCS | body/bracket_14_on_upright | 6 · Build the torso frame on the top flange (5 of 5)
body/j_bracket_15_on_rail/tnut_2020_m5 | 1 × M5 roll-in T-nut for 2020 extrusion | body/bracket_15_on_rail | 6 · Build the torso frame on the top flange (5 of 5)
body/j_bracket_15_on_rail/iso4762_m5x10 | 1 × M5 x 10 SHCS | body/bracket_15_on_rail | 6 · Build the torso frame on the top flange (5 of 5)
body/j_bracket_15_on_upright/tnut_2020_m5 | 1 × M5 roll-in T-nut for 2020 extrusion | body/bracket_15_on_upright | 6 · Build the torso frame on the top flange (5 of 5)
body/j_bracket_15_on_upright/iso4762_m5x10 | 1 × M5 x 10 SHCS | body/bracket_15_on_upright | 6 · Build the torso frame on the top flange (5 of 5)

PR0TOBOARD · UHDJJ-B-AG · Rev A · 2026-10-24101 / 116

Joyful Jack, Tier B, MidrangeAssembly guideJJ-B-AG

Hardware (continued)

Harness / child | Parts | Joint | Step
body/j_bracket_16_on_rail/tnut_2020_m5 | 1 × M5 roll-in T-nut for 2020 extrusion | body/bracket_16_on_rail | 6 · Build the torso frame on the top flange (5 of 5)
body/j_bracket_16_on_rail/iso4762_m5x10 | 1 × M5 x 10 SHCS | body/bracket_16_on_rail | 6 · Build the torso frame on the top flange (5 of 5)
body/j_bracket_16_on_upright/tnut_2020_m5 | 1 × M5 roll-in T-nut for 2020 extrusion | body/bracket_16_on_upright | 6 · Build the torso frame on the top flange (5 of 5)
body/j_bracket_16_on_upright/iso4762_m5x10 | 1 × M5 x 10 SHCS | body/bracket_16_on_upright | 6 · Build the torso frame on the top flange (5 of 5)
body/j_neck_plate_on_neck_post_f/iso4762_m5x12 | 1 × M5 x 12 SHCS | body/neck_plate_on_neck_post_f | 7 · Fit the neck posts and the neck plate (1 of 2)
body/j_neck_post_f_bracket_0_on_rail/tnut_2020_m5 | 1 × M5 roll-in T-nut for 2020 extrusion | body/neck_post_f_bracket_0_on_rail | 7 · Fit the neck posts and the neck plate (1 of 2)
body/j_neck_post_f_bracket_0_on_rail/iso4762_m5x10 | 1 × M5 x 10 SHCS | body/neck_post_f_bracket_0_on_rail | 7 · Fit the neck posts and the neck plate (1 of 2)
body/j_neck_post_f_bracket_0_on_post/tnut_2020_m5 | 1 × M5 roll-in T-nut for 2020 extrusion | body/neck_post_f_bracket_0_on_post | 7 · Fit the neck posts and the neck plate (1 of 2)
body/j_neck_post_f_bracket_0_on_post/iso4762_m5x10 | 1 × M5 x 10 SHCS | body/neck_post_f_bracket_0_on_post | 7 · Fit the neck posts and the neck plate (1 of 2)
body/j_neck_post_f_bracket_1_on_rail/tnut_2020_m5 | 1 × M5 roll-in T-nut for 2020 extrusion | body/neck_post_f_bracket_1_on_rail | 7 · Fit the neck posts and the neck plate (1 of 2)
body/j_neck_post_f_bracket_1_on_rail/iso4762_m5x10 | 1 × M5 x 10 SHCS | body/neck_post_f_bracket_1_on_rail | 7 · Fit the neck posts and the neck plate (1 of 2)
body/j_neck_post_f_bracket_1_on_post/tnut_2020_m5 | 1 × M5 roll-in T-nut for 2020 extrusion | body/neck_post_f_bracket_1_on_post | 7 · Fit the neck posts and the neck plate (1 of 2)
body/j_neck_post_f_bracket_1_on_post/iso4762_m5x10 | 1 × M5 x 10 SHCS | body/neck_post_f_bracket_1_on_post | 7 · Fit the neck posts and the neck plate (1 of 2)

PR0TOBOARD · UHDJJ-B-AG · Rev A · 2026-10-24102 / 116

Joyful Jack, Tier B, MidrangeAssembly guideJJ-B-AG

Hardware (continued)

Harness / child | Parts | Joint | Step
body/j_neck_plate_on_neck_post_b/iso4762_m5x12 | 1 × M5 x 12 SHCS | body/neck_plate_on_neck_post_b | 8 · Fit the neck posts and the neck plate (2 of 2)
body/j_neck_post_b_bracket_0_on_rail/tnut_2020_m5 | 1 × M5 roll-in T-nut for 2020 extrusion | body/neck_post_b_bracket_0_on_rail | 8 · Fit the neck posts and the neck plate (2 of 2)
body/j_neck_post_b_bracket_0_on_rail/iso4762_m5x10 | 1 × M5 x 10 SHCS | body/neck_post_b_bracket_0_on_rail | 8 · Fit the neck posts and the neck plate (2 of 2)
body/j_neck_post_b_bracket_0_on_post/tnut_2020_m5 | 1 × M5 roll-in T-nut for 2020 extrusion | body/neck_post_b_bracket_0_on_post | 8 · Fit the neck posts and the neck plate (2 of 2)
body/j_neck_post_b_bracket_0_on_post/iso4762_m5x10 | 1 × M5 x 10 SHCS | body/neck_post_b_bracket_0_on_post | 8 · Fit the neck posts and the neck plate (2 of 2)
body/j_neck_post_b_bracket_1_on_rail/tnut_2020_m5 | 1 × M5 roll-in T-nut for 2020 extrusion | body/neck_post_b_bracket_1_on_rail | 8 · Fit the neck posts and the neck plate (2 of 2)
body/j_neck_post_b_bracket_1_on_rail/iso4762_m5x10 | 1 × M5 x 10 SHCS | body/neck_post_b_bracket_1_on_rail | 8 · Fit the neck posts and the neck plate (2 of 2)
body/j_neck_post_b_bracket_1_on_post/tnut_2020_m5 | 1 × M5 roll-in T-nut for 2020 extrusion | body/neck_post_b_bracket_1_on_post | 8 · Fit the neck posts and the neck plate (2 of 2)
body/j_neck_post_b_bracket_1_on_post/iso4762_m5x10 | 1 × M5 x 10 SHCS | body/neck_post_b_bracket_1_on_post | 8 · Fit the neck posts and the neck plate (2 of 2)
body/j_ebd_tab_0/tnut_2020_m5 | 1 × M5 roll-in T-nut for 2020 extrusion | body/ebd_tab_0 | 9 · Fit the electronics board, its trays and the E-stop bracket (1 of 3)
body/j_ebd_tab_0/iso4762_m5x12 | 1 × M5 x 12 SHCS | body/ebd_tab_0 | 9 · Fit the electronics board, its trays and the E-stop bracket (1 of 3)
body/j_ebd_tab_1/tnut_2020_m5 | 1 × M5 roll-in T-nut for 2020 extrusion | body/ebd_tab_1 | 9 · Fit the electronics board, its trays and the E-stop bracket (1 of 3)
body/j_ebd_tab_1/iso4762_m5x12 | 1 × M5 x 12 SHCS | body/ebd_tab_1 | 9 · Fit the electronics board, its trays and the E-stop bracket (1 of 3)
body/j_ebd_tab_2/tnut_2020_m5 | 1 × M5 roll-in T-nut for 2020 extrusion | body/ebd_tab_2 | 9 · Fit the electronics board, its trays and the E-stop bracket (1 of 3)

PR0TOBOARD · UHDJJ-B-AG · Rev A · 2026-10-24103 / 116

Joyful Jack, Tier B, MidrangeAssembly guideJJ-B-AG

Hardware (continued)

Harness / child | Parts | Joint | Step
body/j_ebd_tab_2/iso4762_m5x12 | 1 × M5 x 12 SHCS | body/ebd_tab_2 | 9 · Fit the electronics board, its trays and the E-stop bracket (1 of 3)
body/j_ebd_tab_3/tnut_2020_m5 | 1 × M5 roll-in T-nut for 2020 extrusion | body/ebd_tab_3 | 9 · Fit the electronics board, its trays and the E-stop bracket (1 of 3)
body/j_ebd_tab_3/iso4762_m5x12 | 1 × M5 x 12 SHCS | body/ebd_tab_3 | 9 · Fit the electronics board, its trays and the E-stop bracket (1 of 3)
body/j_tray_or_1_on_board/wood_screw_4x0_5in | 2 × #4 x 0.5 in flat head wood screw | body/tray_or_1_on_board | 9 · Fit the electronics board, its trays and the E-stop bracket (1 of 3)
body/j_tray_or_2_on_board/wood_screw_4x0_5in | 2 × #4 x 0.5 in flat head wood screw | body/tray_or_2_on_board | 9 · Fit the electronics board, its trays and the E-stop bracket (1 of 3)
body/j_tray_monitor_on_board/wood_screw_4x0_5in | 2 × #4 x 0.5 in flat head wood screw | body/tray_monitor_on_board | 10 · Fit the electronics board, its trays and the E-stop bracket (2 of 3)
body/j_tray_lvc_on_board/wood_screw_4x0_5in | 2 × #4 x 0.5 in flat head wood screw | body/tray_lvc_on_board | 10 · Fit the electronics board, its trays and the E-stop bracket (2 of 3)
body/j_tray_fuses_on_board/wood_screw_4x0_5in | 2 × #4 x 0.5 in flat head wood screw | body/tray_fuses_on_board | 10 · Fit the electronics board, its trays and the E-stop bracket (2 of 3)
body/j_tray_relay_on_board/wood_screw_4x0_5in | 2 × #4 x 0.5 in flat head wood screw | body/tray_relay_on_board | 10 · Fit the electronics board, its trays and the E-stop bracket (2 of 3)
body/j_tray_buck_head_on_board/wood_screw_4x0_5in | 2 × #4 x 0.5 in flat head wood screw | body/tray_buck_head_on_board | 10 · Fit the electronics board, its trays and the E-stop bracket (2 of 3)
body/j_tray_buck_pi_on_board/wood_screw_4x0_5in | 2 × #4 x 0.5 in flat head wood screw | body/tray_buck_pi_on_board | 10 · Fit the electronics board, its trays and the E-stop bracket (2 of 3)
body/j_tray_buck_arm_r_on_board/wood_screw_4x0_5in | 2 × #4 x 0.5 in flat head wood screw | body/tray_buck_arm_r_on_board | 11 · Fit the electronics board, its trays and the E-stop bracket (3 of 3)
body/j_tray_buck_arm_l_on_board/wood_screw_4x0_5in | 2 × #4 x 0.5 in flat head wood screw | body/tray_buck_arm_l_on_board | 11 · Fit the electronics board, its trays and the E-stop bracket (3 of 3)

PR0TOBOARD · UHDJJ-B-AG · Rev A · 2026-10-24104 / 116

Joyful Jack, Tier B, MidrangeAssembly guideJJ-B-AG

Hardware (continued)

Harness / child | Parts | Joint | Step
body/j_tray_arm_r__bus_adapter_on_board/wood_screw_4x0_5in | 2 × #4 x 0.5 in flat head wood screw | body/tray_arm_r__bus_adapter_on_board | 11 · Fit the electronics board, its trays and the E-stop bracket (3 of 3)
body/j_tray_arm_l__bus_adapter_on_board/wood_screw_4x0_5in | 2 × #4 x 0.5 in flat head wood screw | body/tray_arm_l__bus_adapter_on_board | 11 · Fit the electronics board, its trays and the E-stop bracket (3 of 3)
body/j_estop_bracket_on_rail/tnut_2020_m5 | 1 × M5 roll-in T-nut for 2020 extrusion | body/estop_bracket_on_rail | 11 · Fit the electronics board, its trays and the E-stop bracket (3 of 3)
body/j_estop_bracket_on_rail/iso4762_m5x10 | 1 × M5 x 10 SHCS | body/estop_bracket_on_rail | 11 · Fit the electronics board, its trays and the E-stop bracket (3 of 3)
arm_r/j_arm_r_j1_servo_case_top/pa2x8 | 4 × PA2.0 x 8 pan head self-tapping screw (for plastic) | arm_r/arm_r_j1_servo_case_top | 14 · Right arm: shoulder housing, J1 servo, belt and springs (1 of 2)
arm_r/j_arm_r_j1_servo_case_bottom/pa2x8 | 4 × PA2.0 x 8 pan head self-tapping screw (for plastic) | arm_r/arm_r_j1_servo_case_bottom | 14 · Right arm: shoulder housing, J1 servo, belt and springs (1 of 2)
arm_r/j_arm_r_j1_driver_on_horn/iso4762_m3x14 | 4 × M3 x 14 SHCS | arm_r/arm_r_j1_driver_on_horn | 14 · Right arm: shoulder housing, J1 servo, belt and springs (1 of 2)
arm_r/j_arm_r_j1_cap_on_drum/heatset_insert_m3 | 4 × M3 brass heat-set insert (4.6 mm OD x 5.7 mm) | arm_r/arm_r_j1_cap_on_drum | 15 · Right arm: shoulder housing, J1 servo, belt and springs (2 of 2)

PR0TOBOARD · UHDJJ-B-AG · Rev A · 2026-10-24105 / 116

Joyful Jack, Tier B, MidrangeAssembly guideJJ-B-AG

Hardware (continued)

Harness / child | Parts | Joint | Step
arm_r/j_arm_r_j1_cap_on_drum/iso4762_m3x14 | 4 × M3 x 14 SHCS | arm_r/arm_r_j1_cap_on_drum | 15 · Right arm: shoulder housing, J1 servo, belt and springs (2 of 2)
arm_r/j_arm_r_j1_arbor_on_hub/heatset_insert_m3 | 4 × M3 brass heat-set insert (4.6 mm OD x 5.7 mm) | arm_r/arm_r_j1_arbor_on_hub | 15 · Right arm: shoulder housing, J1 servo, belt and springs (2 of 2)
arm_r/j_arm_r_j1_arbor_on_hub/iso4762_m3x12 | 4 × M3 x 12 SHCS | arm_r/arm_r_j1_arbor_on_hub | 15 · Right arm: shoulder housing, J1 servo, belt and springs (2 of 2)
arm_r/j_arm_r_yoke_on_j1_hub/heatset_insert_m3 | 4 × M3 brass heat-set insert (4.6 mm OD x 5.7 mm) | arm_r/arm_r_yoke_on_j1_hub | 15 · Right arm: shoulder housing, J1 servo, belt and springs (2 of 2)
arm_r/j_arm_r_yoke_on_j1_hub/iso4762_m3x12 | 4 × M3 x 12 SHCS | arm_r/arm_r_yoke_on_j1_hub | 15 · Right arm: shoulder housing, J1 servo, belt and springs (2 of 2)
arm_r/j_arm_r_j2_servo_case_top/pa2x8 | 4 × PA2.0 x 8 pan head self-tapping screw (for plastic) | arm_r/arm_r_j2_servo_case_top | 16 · Right arm: yoke and upper arm (shoulder-out and twist joints) (1 of 3)
arm_r/j_arm_r_j2_servo_case_bottom/pa2x8 | 4 × PA2.0 x 8 pan head self-tapping screw (for plastic) | arm_r/arm_r_j2_servo_case_bottom | 16 · Right arm: yoke and upper arm (shoulder-out and twist joints) (1 of 3)
arm_r/j_arm_r_j2_driver_on_horn/iso4762_m3x14 | 4 × M3 x 14 SHCS | arm_r/arm_r_j2_driver_on_horn | 16 · Right arm: yoke and upper arm (shoulder-out and twist joints) (1 of 3)
arm_r/j_arm_r_j2_cap_on_drum/heatset_insert_m3 | 4 × M3 brass heat-set insert (4.6 mm OD x 5.7 mm) | arm_r/arm_r_j2_cap_on_drum | 17 · Right arm: yoke and upper arm (shoulder-out and twist joints) (2 of 3)
arm_r/j_arm_r_j2_cap_on_drum/iso4762_m3x14 | 4 × M3 x 14 SHCS | arm_r/arm_r_j2_cap_on_drum | 17 · Right arm: yoke and upper arm (shoulder-out and twist joints) (2 of 3)
arm_r/j_arm_r_yoke_fork_face_a/heatset_insert_m3 | 4 × M3 brass heat-set insert (4.6 mm OD x 5.7 mm) | arm_r/arm_r_yoke_fork_face_a | 17 · Right arm: yoke and upper arm (shoulder-out and twist joints) (2 of 3)
arm_r/j_arm_r_yoke_fork_face_a/iso4762_m3x12 | 4 × M3 x 12 SHCS | arm_r/arm_r_yoke_fork_face_a | 17 · Right arm: yoke and upper arm (shoulder-out and twist joints) (2 of 3)
arm_r/j_arm_r_yoke_fork_face_b/heatset_insert_m3 | 4 × M3 brass heat-set insert (4.6 mm OD x 5.7 mm) | arm_r/arm_r_yoke_fork_face_b | 17 · Right arm: yoke and upper arm (shoulder-out and twist joints) (2 of 3)

PR0TOBOARD · UHDJJ-B-AG · Rev A · 2026-10-24106 / 116

Joyful Jack, Tier B, MidrangeAssembly guideJJ-B-AG

Hardware (continued)

Harness / child | Parts | Joint | Step
arm_r/j_arm_r_yoke_fork_face_b/iso4762_m3x12 | 4 × M3 x 12 SHCS | arm_r/arm_r_yoke_fork_face_b | 17 · Right arm: yoke and upper arm (shoulder-out and twist joints) (2 of 3)
arm_r/j_arm_r_j3_servo_case_top/pa2x8 | 4 × PA2.0 x 8 pan head self-tapping screw (for plastic) | arm_r/arm_r_j3_servo_case_top | 17 · Right arm: yoke and upper arm (shoulder-out and twist joints) (2 of 3)
arm_r/j_arm_r_j3_servo_case_bottom/pa2x8 | 4 × PA2.0 x 8 pan head self-tapping screw (for plastic) | arm_r/arm_r_j3_servo_case_bottom | 17 · Right arm: yoke and upper arm (shoulder-out and twist joints) (2 of 3)
arm_r/j_arm_r_j3_disc_on_horn/iso4762_m3x6 | 4 × M3 x 6 SHCS | arm_r/arm_r_j3_disc_on_horn | 18 · Right arm: yoke and upper arm (shoulder-out and twist joints) (3 of 3)
arm_r/j_arm_r_j3_hub_to_disc/heatset_insert_m3 | 3 × M3 brass heat-set insert (4.6 mm OD x 5.7 mm) | arm_r/arm_r_j3_hub_to_disc | 18 · Right arm: yoke and upper arm (shoulder-out and twist joints) (3 of 3)
arm_r/j_arm_r_j3_hub_to_disc/iso4762_m3x30 | 3 × M3 x 30 SHCS | arm_r/arm_r_j3_hub_to_disc | 18 · Right arm: yoke and upper arm (shoulder-out and twist joints) (3 of 3)
arm_r/j_arm_r_j2_arbor_on_yoke/heatset_insert_m3 | 4 × M3 brass heat-set insert (4.6 mm OD x 5.7 mm) | arm_r/arm_r_j2_arbor_on_yoke | 18 · Right arm: yoke and upper arm (shoulder-out and twist joints) (3 of 3)
arm_r/j_arm_r_j2_arbor_on_yoke/iso4762_m3x12 | 4 × M3 x 12 SHCS | arm_r/arm_r_j2_arbor_on_yoke | 18 · Right arm: yoke and upper arm (shoulder-out and twist joints) (3 of 3)
arm_r/j_arm_r_j4_servo_case_top/pa2x8 | 4 × PA2.0 x 8 pan head self-tapping screw (for plastic) | arm_r/arm_r_j4_servo_case_top | 19 · Right arm: elbow housing and elbow drive (1 of 2)
arm_r/j_arm_r_j4_servo_case_bottom/pa2x8 | 4 × PA2.0 x 8 pan head self-tapping screw (for plastic) | arm_r/arm_r_j4_servo_case_bottom | 19 · Right arm: elbow housing and elbow drive (1 of 2)
arm_r/j_arm_r_j4_driver_on_horn/iso4762_m3x14 | 4 × M3 x 14 SHCS | arm_r/arm_r_j4_driver_on_horn | 19 · Right arm: elbow housing and elbow drive (1 of 2)
arm_r/j_arm_r_j4_cap_on_drum/heatset_insert_m3 | 4 × M3 brass heat-set insert (4.6 mm OD x 5.7 mm) | arm_r/arm_r_j4_cap_on_drum | 20 · Right arm: elbow housing and elbow drive (2 of 2)
arm_r/j_arm_r_j4_cap_on_drum/iso4762_m3x14 | 4 × M3 x 14 SHCS | arm_r/arm_r_j4_cap_on_drum | 20 · Right arm: elbow housing and elbow drive (2 of 2)

PR0TOBOARD · UHDJJ-B-AG · Rev A · 2026-10-24107 / 116

Joyful Jack, Tier B, MidrangeAssembly guideJJ-B-AG

Hardware (continued)

Harness / child | Parts | Joint | Step
arm_r/j_arm_r_elbow_on_j3_hub/heatset_insert_m3 | 4 × M3 brass heat-set insert (4.6 mm OD x 5.7 mm) | arm_r/arm_r_elbow_on_j3_hub | 20 · Right arm: elbow housing and elbow drive (2 of 2)
arm_r/j_arm_r_elbow_on_j3_hub/iso4762_m3x14 | 4 × M3 x 14 SHCS | arm_r/arm_r_elbow_on_j3_hub | 20 · Right arm: elbow housing and elbow drive (2 of 2)
arm_r/j_arm_r_fork_in_on_j4/heatset_insert_m3 | 4 × M3 brass heat-set insert (4.6 mm OD x 5.7 mm) | arm_r/arm_r_fork_in_on_j4 | 21 · Right arm: forearm and wrist-twist joint (1 of 2)
arm_r/j_arm_r_fork_in_on_j4/iso4762_m3x12 | 4 × M3 x 12 SHCS | arm_r/arm_r_fork_in_on_j4 | 21 · Right arm: forearm and wrist-twist joint (1 of 2)
arm_r/j_arm_r_fork_out_on_j4/heatset_insert_m3 | 4 × M3 brass heat-set insert (4.6 mm OD x 5.7 mm) | arm_r/arm_r_fork_out_on_j4 | 21 · Right arm: forearm and wrist-twist joint (1 of 2)
arm_r/j_arm_r_fork_out_on_j4/iso4762_m3x12 | 4 × M3 x 12 SHCS | arm_r/arm_r_fork_out_on_j4 | 21 · Right arm: forearm and wrist-twist joint (1 of 2)
arm_r/j_arm_r_j5_servo_case_top/pa2x8 | 4 × PA2.0 x 8 pan head self-tapping screw (for plastic) | arm_r/arm_r_j5_servo_case_top | 21 · Right arm: forearm and wrist-twist joint (1 of 2)
arm_r/j_arm_r_j5_servo_case_bottom/pa2x8 | 4 × PA2.0 x 8 pan head self-tapping screw (for plastic) | arm_r/arm_r_j5_servo_case_bottom | 21 · Right arm: forearm and wrist-twist joint (1 of 2)
arm_r/j_arm_r_j5_disc_on_horn/iso4762_m3x6 | 4 × M3 x 6 SHCS | arm_r/arm_r_j5_disc_on_horn | 22 · Right arm: forearm and wrist-twist joint (2 of 2)
arm_r/j_arm_r_j5_hub_to_disc/heatset_insert_m3 | 3 × M3 brass heat-set insert (4.6 mm OD x 5.7 mm) | arm_r/arm_r_j5_hub_to_disc | 22 · Right arm: forearm and wrist-twist joint (2 of 2)
arm_r/j_arm_r_j5_hub_to_disc/iso4762_m3x30 | 3 × M3 x 30 SHCS | arm_r/arm_r_j5_hub_to_disc | 22 · Right arm: forearm and wrist-twist joint (2 of 2)
arm_r/j_arm_r_fork_in_to_body/heatset_insert_m3 | 2 × M3 brass heat-set insert (4.6 mm OD x 5.7 mm) | arm_r/arm_r_fork_in_to_body | 22 · Right arm: forearm and wrist-twist joint (2 of 2)
arm_r/j_arm_r_fork_in_to_body/iso4762_m3x12 | 2 × M3 x 12 SHCS | arm_r/arm_r_fork_in_to_body | 22 · Right arm: forearm and wrist-twist joint (2 of 2)
arm_r/j_arm_r_fork_out_to_body/heatset_insert_m3 | 2 × M3 brass heat-set insert (4.6 mm OD x 5.7 mm) | arm_r/arm_r_fork_out_to_body | 22 · Right arm: forearm and wrist-twist joint (2 of 2)
arm_r/j_arm_r_fork_out_to_body/iso4762_m3x12 | 2 × M3 x 12 SHCS | arm_r/arm_r_fork_out_to_body | 22 · Right arm: forearm and wrist-twist joint (2 of 2)

PR0TOBOARD · UHDJJ-B-AG · Rev A · 2026-10-24108 / 116

Joyful Jack, Tier B, MidrangeAssembly guideJJ-B-AG

Hardware (continued)

Harness / child | Parts | Joint | Step
arm_r/j_arm_r_hand_palm_on_wrist/heatset_insert_m3 | 4 × M3 brass heat-set insert (4.6 mm OD x 5.7 mm) | arm_r/arm_r_hand_palm_on_wrist | 23 · Right arm: hand (1 of 2)
arm_r/j_arm_r_hand_palm_on_wrist/iso4762_m3x12 | 4 × M3 x 12 SHCS | arm_r/arm_r_hand_palm_on_wrist | 23 · Right arm: hand (1 of 2)
arm_r/j_arm_r_hand_fingers_servo_case_top/pa2x6 | 4 × PA2.0 x 6 pan head self-tapping screw (for plastic) | arm_r/arm_r_hand_fingers_servo_case_top | 23 · Right arm: hand (1 of 2)
arm_r/j_arm_r_hand_fingers_servo_case_bottom/pa2x6 | 4 × PA2.0 x 6 pan head self-tapping screw (for plastic) | arm_r/arm_r_hand_fingers_servo_case_bottom | 23 · Right arm: hand (1 of 2)
arm_r/j_arm_r_hand_thumb_servo_case_top/pa2x6 | 4 × PA2.0 x 6 pan head self-tapping screw (for plastic) | arm_r/arm_r_hand_thumb_servo_case_top | 23 · Right arm: hand (1 of 2)
arm_r/j_arm_r_hand_thumb_servo_case_bottom/pa2x6 | 4 × PA2.0 x 6 pan head self-tapping screw (for plastic) | arm_r/arm_r_hand_thumb_servo_case_bottom | 23 · Right arm: hand (1 of 2)
arm_r/j_arm_r_hand_fingers_on_horn/iso4762_m3x8 | 4 × M3 x 8 SHCS | arm_r/arm_r_hand_fingers_on_horn | 24 · Right arm: hand (2 of 2)
arm_r/j_arm_r_hand_fingers_on_rear_horn/iso4762_m3x8 | 4 × M3 x 8 SHCS | arm_r/arm_r_hand_fingers_on_rear_horn | 24 · Right arm: hand (2 of 2)
arm_r/j_arm_r_hand_thumb_on_horn/iso4762_m3x8 | 4 × M3 x 8 SHCS | arm_r/arm_r_hand_thumb_on_horn | 24 · Right arm: hand (2 of 2)
arm_r/j_arm_r_hand_thumb_on_rear_horn/iso4762_m3x8 | 4 × M3 x 8 SHCS | arm_r/arm_r_hand_thumb_on_rear_horn | 24 · Right arm: hand (2 of 2)

PR0TOBOARD · UHDJJ-B-AG · Rev A · 2026-10-24109 / 116

Joyful Jack, Tier B, MidrangeAssembly guideJJ-B-AG

Hardware (continued)

Harness / child | Parts | Joint | Step
arm_l/j_arm_l_j1_servo_case_top/pa2x8 | 4 × PA2.0 x 8 pan head self-tapping screw (for plastic) | arm_l/arm_l_j1_servo_case_top | 25 · Left arm: shoulder housing, J1 servo, belt and springs (1 of 2)
arm_l/j_arm_l_j1_servo_case_bottom/pa2x8 | 4 × PA2.0 x 8 pan head self-tapping screw (for plastic) | arm_l/arm_l_j1_servo_case_bottom | 25 · Left arm: shoulder housing, J1 servo, belt and springs (1 of 2)
arm_l/j_arm_l_j1_driver_on_horn/iso4762_m3x14 | 4 × M3 x 14 SHCS | arm_l/arm_l_j1_driver_on_horn | 25 · Left arm: shoulder housing, J1 servo, belt and springs (1 of 2)
arm_l/j_arm_l_j1_cap_on_drum/heatset_insert_m3 | 4 × M3 brass heat-set insert (4.6 mm OD x 5.7 mm) | arm_l/arm_l_j1_cap_on_drum | 26 · Left arm: shoulder housing, J1 servo, belt and springs (2 of 2)
arm_l/j_arm_l_j1_cap_on_drum/iso4762_m3x14 | 4 × M3 x 14 SHCS | arm_l/arm_l_j1_cap_on_drum | 26 · Left arm: shoulder housing, J1 servo, belt and springs (2 of 2)
arm_l/j_arm_l_j1_arbor_on_hub/heatset_insert_m3 | 4 × M3 brass heat-set insert (4.6 mm OD x 5.7 mm) | arm_l/arm_l_j1_arbor_on_hub | 26 · Left arm: shoulder housing, J1 servo, belt and springs (2 of 2)
arm_l/j_arm_l_j1_arbor_on_hub/iso4762_m3x12 | 4 × M3 x 12 SHCS | arm_l/arm_l_j1_arbor_on_hub | 26 · Left arm: shoulder housing, J1 servo, belt and springs (2 of 2)
arm_l/j_arm_l_yoke_on_j1_hub/heatset_insert_m3 | 4 × M3 brass heat-set insert (4.6 mm OD x 5.7 mm) | arm_l/arm_l_yoke_on_j1_hub | 26 · Left arm: shoulder housing, J1 servo, belt and springs (2 of 2)
arm_l/j_arm_l_yoke_on_j1_hub/iso4762_m3x12 | 4 × M3 x 12 SHCS | arm_l/arm_l_yoke_on_j1_hub | 26 · Left arm: shoulder housing, J1 servo, belt and springs (2 of 2)
arm_l/j_arm_l_j2_servo_case_top/pa2x8 | 4 × PA2.0 x 8 pan head self-tapping screw (for plastic) | arm_l/arm_l_j2_servo_case_top | 27 · Left arm: yoke and upper arm (shoulder-out and twist joints) (1 of 3)
arm_l/j_arm_l_j2_servo_case_bottom/pa2x8 | 4 × PA2.0 x 8 pan head self-tapping screw (for plastic) | arm_l/arm_l_j2_servo_case_bottom | 27 · Left arm: yoke and upper arm (shoulder-out and twist joints) (1 of 3)
arm_l/j_arm_l_j2_driver_on_horn/iso4762_m3x14 | 4 × M3 x 14 SHCS | arm_l/arm_l_j2_driver_on_horn | 27 · Left arm: yoke and upper arm (shoulder-out and twist joints) (1 of 3)
arm_l/j_arm_l_j2_cap_on_drum/heatset_insert_m3 | 4 × M3 brass heat-set insert (4.6 mm OD x 5.7 mm) | arm_l/arm_l_j2_cap_on_drum | 28 · Left arm: yoke and upper arm (shoulder-out and twist joints) (2 of 3)
arm_l/j_arm_l_j2_cap_on_drum/iso4762_m3x14 | 4 × M3 x 14 SHCS | arm_l/arm_l_j2_cap_on_drum | 28 · Left arm: yoke and upper arm (shoulder-out and twist joints) (2 of 3)

PR0TOBOARD · UHDJJ-B-AG · Rev A · 2026-10-24110 / 116

Joyful Jack, Tier B, MidrangeAssembly guideJJ-B-AG

Hardware (continued)

Harness / child | Parts | Joint | Step
arm_l/j_arm_l_yoke_fork_face_a/heatset_insert_m3 | 4 × M3 brass heat-set insert (4.6 mm OD x 5.7 mm) | arm_l/arm_l_yoke_fork_face_a | 28 · Left arm: yoke and upper arm (shoulder-out and twist joints) (2 of 3)
arm_l/j_arm_l_yoke_fork_face_a/iso4762_m3x12 | 4 × M3 x 12 SHCS | arm_l/arm_l_yoke_fork_face_a | 28 · Left arm: yoke and upper arm (shoulder-out and twist joints) (2 of 3)
arm_l/j_arm_l_yoke_fork_face_b/heatset_insert_m3 | 4 × M3 brass heat-set insert (4.6 mm OD x 5.7 mm) | arm_l/arm_l_yoke_fork_face_b | 28 · Left arm: yoke and upper arm (shoulder-out and twist joints) (2 of 3)
arm_l/j_arm_l_yoke_fork_face_b/iso4762_m3x12 | 4 × M3 x 12 SHCS | arm_l/arm_l_yoke_fork_face_b | 28 · Left arm: yoke and upper arm (shoulder-out and twist joints) (2 of 3)
arm_l/j_arm_l_j3_servo_case_top/pa2x8 | 4 × PA2.0 x 8 pan head self-tapping screw (for plastic) | arm_l/arm_l_j3_servo_case_top | 28 · Left arm: yoke and upper arm (shoulder-out and twist joints) (2 of 3)
arm_l/j_arm_l_j3_servo_case_bottom/pa2x8 | 4 × PA2.0 x 8 pan head self-tapping screw (for plastic) | arm_l/arm_l_j3_servo_case_bottom | 28 · Left arm: yoke and upper arm (shoulder-out and twist joints) (2 of 3)
arm_l/j_arm_l_j3_disc_on_horn/iso4762_m3x6 | 4 × M3 x 6 SHCS | arm_l/arm_l_j3_disc_on_horn | 29 · Left arm: yoke and upper arm (shoulder-out and twist joints) (3 of 3)
arm_l/j_arm_l_j3_hub_to_disc/heatset_insert_m3 | 3 × M3 brass heat-set insert (4.6 mm OD x 5.7 mm) | arm_l/arm_l_j3_hub_to_disc | 29 · Left arm: yoke and upper arm (shoulder-out and twist joints) (3 of 3)
arm_l/j_arm_l_j3_hub_to_disc/iso4762_m3x30 | 3 × M3 x 30 SHCS | arm_l/arm_l_j3_hub_to_disc | 29 · Left arm: yoke and upper arm (shoulder-out and twist joints) (3 of 3)
arm_l/j_arm_l_j2_arbor_on_yoke/heatset_insert_m3 | 4 × M3 brass heat-set insert (4.6 mm OD x 5.7 mm) | arm_l/arm_l_j2_arbor_on_yoke | 29 · Left arm: yoke and upper arm (shoulder-out and twist joints) (3 of 3)
arm_l/j_arm_l_j2_arbor_on_yoke/iso4762_m3x12 | 4 × M3 x 12 SHCS | arm_l/arm_l_j2_arbor_on_yoke | 29 · Left arm: yoke and upper arm (shoulder-out and twist joints) (3 of 3)
arm_l/j_arm_l_j4_servo_case_top/pa2x8 | 4 × PA2.0 x 8 pan head self-tapping screw (for plastic) | arm_l/arm_l_j4_servo_case_top | 30 · Left arm: elbow housing and elbow drive (1 of 2)
arm_l/j_arm_l_j4_servo_case_bottom/pa2x8 | 4 × PA2.0 x 8 pan head self-tapping screw (for plastic) | arm_l/arm_l_j4_servo_case_bottom | 30 · Left arm: elbow housing and elbow drive (1 of 2)

PR0TOBOARD · UHDJJ-B-AG · Rev A · 2026-10-24111 / 116

Joyful Jack, Tier B, MidrangeAssembly guideJJ-B-AG

Hardware (continued)

Harness / child | Parts | Joint | Step
arm_l/j_arm_l_j4_driver_on_horn/iso4762_m3x14 | 4 × M3 x 14 SHCS | arm_l/arm_l_j4_driver_on_horn | 30 · Left arm: elbow housing and elbow drive (1 of 2)
arm_l/j_arm_l_j4_cap_on_drum/heatset_insert_m3 | 4 × M3 brass heat-set insert (4.6 mm OD x 5.7 mm) | arm_l/arm_l_j4_cap_on_drum | 31 · Left arm: elbow housing and elbow drive (2 of 2)
arm_l/j_arm_l_j4_cap_on_drum/iso4762_m3x14 | 4 × M3 x 14 SHCS | arm_l/arm_l_j4_cap_on_drum | 31 · Left arm: elbow housing and elbow drive (2 of 2)
arm_l/j_arm_l_elbow_on_j3_hub/heatset_insert_m3 | 4 × M3 brass heat-set insert (4.6 mm OD x 5.7 mm) | arm_l/arm_l_elbow_on_j3_hub | 31 · Left arm: elbow housing and elbow drive (2 of 2)
arm_l/j_arm_l_elbow_on_j3_hub/iso4762_m3x14 | 4 × M3 x 14 SHCS | arm_l/arm_l_elbow_on_j3_hub | 31 · Left arm: elbow housing and elbow drive (2 of 2)
arm_l/j_arm_l_fork_in_on_j4/heatset_insert_m3 | 4 × M3 brass heat-set insert (4.6 mm OD x 5.7 mm) | arm_l/arm_l_fork_in_on_j4 | 32 · Left arm: forearm and wrist-twist joint (1 of 2)
arm_l/j_arm_l_fork_in_on_j4/iso4762_m3x12 | 4 × M3 x 12 SHCS | arm_l/arm_l_fork_in_on_j4 | 32 · Left arm: forearm and wrist-twist joint (1 of 2)
arm_l/j_arm_l_fork_out_on_j4/heatset_insert_m3 | 4 × M3 brass heat-set insert (4.6 mm OD x 5.7 mm) | arm_l/arm_l_fork_out_on_j4 | 32 · Left arm: forearm and wrist-twist joint (1 of 2)
arm_l/j_arm_l_fork_out_on_j4/iso4762_m3x12 | 4 × M3 x 12 SHCS | arm_l/arm_l_fork_out_on_j4 | 32 · Left arm: forearm and wrist-twist joint (1 of 2)
arm_l/j_arm_l_j5_servo_case_top/pa2x8 | 4 × PA2.0 x 8 pan head self-tapping screw (for plastic) | arm_l/arm_l_j5_servo_case_top | 32 · Left arm: forearm and wrist-twist joint (1 of 2)
arm_l/j_arm_l_j5_servo_case_bottom/pa2x8 | 4 × PA2.0 x 8 pan head self-tapping screw (for plastic) | arm_l/arm_l_j5_servo_case_bottom | 32 · Left arm: forearm and wrist-twist joint (1 of 2)
arm_l/j_arm_l_j5_disc_on_horn/iso4762_m3x6 | 4 × M3 x 6 SHCS | arm_l/arm_l_j5_disc_on_horn | 33 · Left arm: forearm and wrist-twist joint (2 of 2)
arm_l/j_arm_l_j5_hub_to_disc/heatset_insert_m3 | 3 × M3 brass heat-set insert (4.6 mm OD x 5.7 mm) | arm_l/arm_l_j5_hub_to_disc | 33 · Left arm: forearm and wrist-twist joint (2 of 2)
arm_l/j_arm_l_j5_hub_to_disc/iso4762_m3x30 | 3 × M3 x 30 SHCS | arm_l/arm_l_j5_hub_to_disc | 33 · Left arm: forearm and wrist-twist joint (2 of 2)
arm_l/j_arm_l_fork_in_to_body/heatset_insert_m3 | 2 × M3 brass heat-set insert (4.6 mm OD x 5.7 mm) | arm_l/arm_l_fork_in_to_body | 33 · Left arm: forearm and wrist-twist joint (2 of 2)
arm_l/j_arm_l_fork_in_to_body/iso4762_m3x12 | 2 × M3 x 12 SHCS | arm_l/arm_l_fork_in_to_body | 33 · Left arm: forearm and wrist-twist joint (2 of 2)

PR0TOBOARD · UHDJJ-B-AG · Rev A · 2026-10-24112 / 116

Joyful Jack, Tier B, MidrangeAssembly guideJJ-B-AG

Hardware (continued)

Harness / child | Parts | Joint | Step
arm_l/j_arm_l_fork_out_to_body/heatset_insert_m3 | 2 × M3 brass heat-set insert (4.6 mm OD x 5.7 mm) | arm_l/arm_l_fork_out_to_body | 33 · Left arm: forearm and wrist-twist joint (2 of 2)
arm_l/j_arm_l_fork_out_to_body/iso4762_m3x12 | 2 × M3 x 12 SHCS | arm_l/arm_l_fork_out_to_body | 33 · Left arm: forearm and wrist-twist joint (2 of 2)
arm_l/j_arm_l_hand_palm_on_wrist/heatset_insert_m3 | 4 × M3 brass heat-set insert (4.6 mm OD x 5.7 mm) | arm_l/arm_l_hand_palm_on_wrist | 34 · Left arm: hand (1 of 2)
arm_l/j_arm_l_hand_palm_on_wrist/iso4762_m3x12 | 4 × M3 x 12 SHCS | arm_l/arm_l_hand_palm_on_wrist | 34 · Left arm: hand (1 of 2)
arm_l/j_arm_l_hand_fingers_servo_case_top/pa2x6 | 4 × PA2.0 x 6 pan head self-tapping screw (for plastic) | arm_l/arm_l_hand_fingers_servo_case_top | 34 · Left arm: hand (1 of 2)
arm_l/j_arm_l_hand_fingers_servo_case_bottom/pa2x6 | 4 × PA2.0 x 6 pan head self-tapping screw (for plastic) | arm_l/arm_l_hand_fingers_servo_case_bottom | 34 · Left arm: hand (1 of 2)
arm_l/j_arm_l_hand_thumb_servo_case_top/pa2x6 | 4 × PA2.0 x 6 pan head self-tapping screw (for plastic) | arm_l/arm_l_hand_thumb_servo_case_top | 34 · Left arm: hand (1 of 2)
arm_l/j_arm_l_hand_thumb_servo_case_bottom/pa2x6 | 4 × PA2.0 x 6 pan head self-tapping screw (for plastic) | arm_l/arm_l_hand_thumb_servo_case_bottom | 34 · Left arm: hand (1 of 2)
arm_l/j_arm_l_hand_fingers_on_horn/iso4762_m3x8 | 4 × M3 x 8 SHCS | arm_l/arm_l_hand_fingers_on_horn | 35 · Left arm: hand (2 of 2)

PR0TOBOARD · UHDJJ-B-AG · Rev A · 2026-10-24113 / 116

Joyful Jack, Tier B, MidrangeAssembly guideJJ-B-AG

Hardware (continued)

Harness / child | Parts | Joint | Step
arm_l/j_arm_l_hand_fingers_on_rear_horn/iso4762_m3x8 | 4 × M3 x 8 SHCS | arm_l/arm_l_hand_fingers_on_rear_horn | 35 · Left arm: hand (2 of 2)
arm_l/j_arm_l_hand_thumb_on_horn/iso4762_m3x8 | 4 × M3 x 8 SHCS | arm_l/arm_l_hand_thumb_on_horn | 35 · Left arm: hand (2 of 2)
arm_l/j_arm_l_hand_thumb_on_rear_horn/iso4762_m3x8 | 4 × M3 x 8 SHCS | arm_l/arm_l_hand_thumb_on_rear_horn | 35 · Left arm: hand (2 of 2)

## Wiring links

Wiring (continued)

Link | Name | Harness | Step
pack1_dock | pack1_dock | — | 42 · Wire the power system: packs, docks, protection, fuses and converters
pack1_neg | pack1_neg | — | 42 · Wire the power system: packs, docks, protection, fuses and converters
pack2_dock | pack2_dock | — | 42 · Wire the power system: packs, docks, protection, fuses and converters
pack2_neg | pack2_neg | — | 42 · Wire the power system: packs, docks, protection, fuses and converters
dock1_or | dock1_or | — | 42 · Wire the power system: packs, docks, protection, fuses and converters
dock2_or | dock2_or | — | 42 · Wire the power system: packs, docks, protection, fuses and converters
gnd_common | Pack negatives joined | — | 42 · Wire the power system: packs, docks, protection, fuses and converters
or1_bus | OR bus (pack 1) | — | 42 · Wire the power system: packs, docks, protection, fuses and converters
or2_bus | OR bus (pack 2) | — | 42 · Wire the power system: packs, docks, protection, fuses and converters
monitor_lvc | monitor_lvc | — | 41 · Wire the head: computer, servo rail and monitor bus
lvc_gnd | lvc_gnd | — | 42 · Wire the power system: packs, docks, protection, fuses and converters
lvc_fuses | lvc_fuses | — | 42 · Wire the power system: packs, docks, protection, fuses and converters
fuses_gnd | fuses_gnd | — | 42 · Wire the power system: packs, docks, protection, fuses and converters
act_relay | Actuator feed to relay contacts | — | 42 · Wire the power system: packs, docks, protection, fuses and converters
estop_feed | estop_feed | — | 42 · Wire the power system: packs, docks, protection, fuses and converters
estop_coil | E-stop chain holds the relay | — | 42 · Wire the power system: packs, docks, protection, fuses and converters
relay_coil_gnd | relay_coil_gnd | — | 42 · Wire the power system: packs, docks, protection, fuses and converters
relay_arm_r | relay_arm_r | — | 42 · Wire the power system: packs, docks, protection, fuses and converters
relay_arm_l | relay_arm_l | — | 42 · Wire the power system: packs, docks, protection, fuses and converters
relay_head | relay_head | — | 41 · Wire the head: computer, servo rail and monitor bus
pi_feed | pi_feed | — | 41 · Wire the head: computer, servo rail and monitor bus
buck_head_gnd | buck_head_gnd | — | 41 · Wire the head: computer, servo rail and monitor bus
buck_pi_gnd | buck_pi_gnd | — | 42 · Wire the power system: packs, docks, protection, fuses and converters

PR0TOBOARD · UHDJJ-B-AG · Rev A · 2026-10-24114 / 116

Joyful Jack, Tier B, MidrangeAssembly guideJJ-B-AG

Wiring (continued)

Link | Name | Harness | Step
buck_arm_r_gnd | buck_arm_r_gnd | — | 42 · Wire the power system: packs, docks, protection, fuses and converters
buck_arm_l_gnd | buck_arm_l_gnd | — | 42 · Wire the power system: packs, docks, protection, fuses and converters
or_1_gnd | or_1_gnd | — | 42 · Wire the power system: packs, docks, protection, fuses and converters
or_2_gnd | or_2_gnd | — | 42 · Wire the power system: packs, docks, protection, fuses and converters
monitor_gnd | monitor_gnd | — | 41 · Wire the head: computer, servo rail and monitor bus
pi_5v | Pi 5 V | — | 41 · Wire the head: computer, servo rail and monitor bus
head_servo_rail | Head servo rail | — | 41 · Wire the head: computer, servo rail and monitor bus
head_gnd | head_gnd | — | 41 · Wire the head: computer, servo rail and monitor bus
monitor_i2c | I2C to the pack monitor (0x44) | — | 41 · Wire the head: computer, servo rail and monitor bus
monitor_logic | monitor_logic | — | 41 · Wire the head: computer, servo rail and monitor bus
arm_r_12v | arm_r_12v | — | 39 · Wire the right arm: servo bus and power
arm_l_12v | arm_l_12v | — | 40 · Wire the left arm: servo bus and power
arm_r_gnd | arm_r_gnd | — | 39 · Wire the right arm: servo bus and power
arm_l_gnd | arm_l_gnd | — | 40 · Wire the left arm: servo bus and power
arm_r_usb | USB to the right arm's bus | — | 39 · Wire the right arm: servo bus and power
arm_l_usb | USB to the left arm's bus | — | 40 · Wire the left arm: servo bus and power
arm_r/shoulder_flex_bus | shoulder_flex bus | — | 39 · Wire the right arm: servo bus and power
arm_r/shoulder_flex_vplus | shoulder_flex V+ | — | 39 · Wire the right arm: servo bus and power
arm_r/shoulder_flex_gnd | shoulder_flex GND | — | 39 · Wire the right arm: servo bus and power
arm_r/shoulder_out_bus | shoulder_out bus | — | 39 · Wire the right arm: servo bus and power
arm_r/shoulder_out_vplus | shoulder_out V+ | — | 39 · Wire the right arm: servo bus and power
arm_r/shoulder_out_gnd | shoulder_out GND | — | 39 · Wire the right arm: servo bus and power
arm_r/upper_twist_bus | upper_twist bus | — | 39 · Wire the right arm: servo bus and power
arm_r/upper_twist_vplus | upper_twist V+ | — | 39 · Wire the right arm: servo bus and power
arm_r/upper_twist_gnd | upper_twist GND | — | 39 · Wire the right arm: servo bus and power
arm_r/elbow_bus | elbow bus | — | 39 · Wire the right arm: servo bus and power
arm_r/elbow_vplus | elbow V+ | — | 39 · Wire the right arm: servo bus and power
arm_r/elbow_gnd | elbow GND | — | 39 · Wire the right arm: servo bus and power
arm_r/wrist_twist_bus | wrist_twist bus | — | 39 · Wire the right arm: servo bus and power
arm_r/wrist_twist_vplus | wrist_twist V+ | — | 39 · Wire the right arm: servo bus and power
arm_r/wrist_twist_gnd | wrist_twist GND | — | 39 · Wire the right arm: servo bus and power
arm_r/fingers_bus | fingers bus | — | 39 · Wire the right arm: servo bus and power
arm_r/fingers_vplus | fingers V+ | — | 39 · Wire the right arm: servo bus and power
arm_r/fingers_gnd | fingers GND | — | 39 · Wire the right arm: servo bus and power
arm_r/thumb_bus | thumb bus | — | 39 · Wire the right arm: servo bus and power
arm_r/thumb_vplus | thumb V+ | — | 39 · Wire the right arm: servo bus and power
arm_r/thumb_gnd | thumb GND | — | 39 · Wire the right arm: servo bus and power
arm_l/shoulder_flex_bus | shoulder_flex bus | — | 40 · Wire the left arm: servo bus and power
arm_l/shoulder_flex_vplus | shoulder_flex V+ | — | 40 · Wire the left arm: servo bus and power

PR0TOBOARD · UHDJJ-B-AG · Rev A · 2026-10-24115 / 116

Joyful Jack, Tier B, MidrangeAssembly guideJJ-B-AG

Wiring (continued)

Link | Name | Harness | Step
arm_l/shoulder_flex_gnd | shoulder_flex GND | — | 40 · Wire the left arm: servo bus and power
arm_l/shoulder_out_bus | shoulder_out bus | — | 40 · Wire the left arm: servo bus and power
arm_l/shoulder_out_vplus | shoulder_out V+ | — | 40 · Wire the left arm: servo bus and power
arm_l/shoulder_out_gnd | shoulder_out GND | — | 40 · Wire the left arm: servo bus and power
arm_l/upper_twist_bus | upper_twist bus | — | 40 · Wire the left arm: servo bus and power
arm_l/upper_twist_vplus | upper_twist V+ | — | 40 · Wire the left arm: servo bus and power
arm_l/upper_twist_gnd | upper_twist GND | — | 40 · Wire the left arm: servo bus and power
arm_l/elbow_bus | elbow bus | — | 40 · Wire the left arm: servo bus and power
arm_l/elbow_vplus | elbow V+ | — | 40 · Wire the left arm: servo bus and power
arm_l/elbow_gnd | elbow GND | — | 40 · Wire the left arm: servo bus and power
arm_l/wrist_twist_bus | wrist_twist bus | — | 40 · Wire the left arm: servo bus and power
arm_l/wrist_twist_vplus | wrist_twist V+ | — | 40 · Wire the left arm: servo bus and power
arm_l/wrist_twist_gnd | wrist_twist GND | — | 40 · Wire the left arm: servo bus and power
arm_l/fingers_bus | fingers bus | — | 40 · Wire the left arm: servo bus and power
arm_l/fingers_vplus | fingers V+ | — | 40 · Wire the left arm: servo bus and power
arm_l/fingers_gnd | fingers GND | — | 40 · Wire the left arm: servo bus and power
arm_l/thumb_bus | thumb bus | — | 40 · Wire the left arm: servo bus and power
arm_l/thumb_vplus | thumb V+ | — | 40 · Wire the left arm: servo bus and power
arm_l/thumb_gnd | thumb GND | — | 40 · Wire the left arm: servo bus and power

PR0TOBOARD · UHDJJ-B-AG · Rev A · 2026-10-24116 / 116
