MarkDannemiller/JackOLantern/protoboard/docs/sim-results.md

# Simulation results (generated by cad/mech/sim/report.py; do not edit)

python3 cad/mech/sim/report.py   ->  docs/sim-results.json and .md

Right arm (it carries the 0.25 kg payload): per gravity joint the peak servo torque as a fraction of stall, the mean
as a fraction of the rated third of stall, the worst tracking error, the peak belt tension (rated 179.6 N) and the
share of time the servo sat at its torque limit. Base: tilt and the push force that tipped it.

| Tier | Scenario | r_j1 stall peak / rated mean / err deg / belt N / sat | r_j2 stall peak / rated mean / err deg / belt N / sat | r_j4 stall peak / rated mean / err deg / belt N / sat | Tilt deg | Tip N |
|---|---|---|---|---|---|---|
| A | estop-bal-lim | 0.01 / 0.01 / 35.0 / 3 / 0.00 | 0.61 / 0.40 / 100.0 / 180 / 0.10 | 0.01 / 0.00 / 46.1 / 1 / 0.00 | 0.0 | - |
| A | estop-bal | 0.01 / 0.01 / 35.0 / 3 / 0.00 | 0.53 / 0.37 / 100.0 / 156 / 0.00 | 0.01 / 0.00 / 41.9 / 1 / 0.00 | 0.0 | - |
| A | estop | 0.01 / 0.01 / 24.7 / 4 / 0.00 | 0.53 / 0.37 / 100.0 / 156 / 0.00 | 0.01 / 0.00 / 42.6 / 1 / 0.00 | 0.0 | - |
| A | hold-bal-lim | 0.24 / 0.20 / 2.2 / 71 / 0.00 | 0.61 / 0.70 / 19.1 / 180 / 0.30 | 0.01 / 0.00 / 0.0 / 1 / 0.00 | 0.0 | - |
| A | hold-bal | 0.24 / 0.20 / 2.2 / 71 / 0.00 | 0.56 / 0.63 / 2.5 / 165 / 0.00 | 0.01 / 0.00 / 0.0 / 1 / 0.00 | 0.0 | - |
| A | hold | 0.61 / 0.64 / 2.5 / 181 (over) / 0.00 | 0.56 / 0.63 / 2.5 / 165 / 0.00 | 0.01 / 0.00 / 0.0 / 1 / 0.00 | 0.0 | - |
| A | push-bal | 0.49 / 0.04 / 0.9 / 145 / 0.00 | 0.99 / 0.99 / 3.9 / 294 (over) / 0.01 | 0.99 / 0.16 / 9.7 / 224 (over) / 0.01 | 100.6 | 154 |
| A | push | 0.46 / 0.04 / 1.2 / 135 / 0.00 | 0.99 / 1.02 / 3.9 / 294 (over) / 0.02 | 0.99 / 0.17 / 12.4 / 225 (over) / 0.01 | 101.2 | 154 |
| A | reach-bal-lim | 0.31 / 0.53 / 1.5 / 91 / 0.00 | 0.01 / 0.02 / 0.0 / 3 / 0.00 | 0.19 / 0.32 / 1.0 / 43 / 0.00 | 0.0 | - |
| A | reach-bal | 0.31 / 0.53 / 1.5 / 91 / 0.00 | 0.01 / 0.02 / 0.0 / 3 / 0.00 | 0.19 / 0.32 / 1.0 / 43 / 0.00 | 0.0 | - |
| A | reach | 0.55 / 1.15 / 1.8 / 162 / 0.00 | 0.01 / 0.02 / 0.0 / 4 / 0.00 | 0.35 / 0.71 / 1.0 / 79 / 0.00 | 0.0 | - |
| A | wave-bal-lim | 0.35 / 0.29 / 1.9 / 104 / 0.00 | 0.01 / 0.02 / 0.0 / 3 / 0.00 | 0.24 / 0.25 / 2.8 / 54 / 0.00 | 0.0 | - |
| A | wave-bal | 0.32 / 0.70 / 0.3 / 94 / 0.00 | 0.41 / 0.74 / 2.2 / 120 / 0.00 | 0.18 / 0.22 / 3.4 / 42 / 0.00 | 0.0 | - |
| A | wave-lim | 0.56 / 0.72 / 2.2 / 165 / 0.00 | 0.01 / 0.01 / 0.0 / 3 / 0.00 | 0.38 / 0.41 / 2.8 / 87 / 0.00 | 0.0 | - |
| A | wave | 0.32 / 0.70 / 0.3 / 94 / 0.00 | 0.41 / 0.74 / 2.2 / 120 / 0.00 | 0.18 / 0.22 / 3.4 / 42 / 0.00 | 0.0 | - |
| A+SANDBAGS2 | push-bal | 0.30 / 0.04 / 1.2 / 90 / 0.00 | 0.99 / 1.18 / 7.4 / 294 (over) / 0.02 | 1.00 / 0.11 / 1.4 / 226 (over) / 0.00 | 100.7 | 205 |
| B | estop-bal-lim | 0.02 / 0.03 / 35.0 / 6 / 0.00 | 0.65 / 0.40 / 100.0 / 180 / 0.26 | 0.00 / 0.00 / 38.2 / 0 / 0.00 | 0.0 | - |
| B | estop-bal | 0.10 / 0.05 / 35.0 / 28 / 0.00 | 0.77 / 0.56 / 99.3 / 212 (over) / 0.19 | 0.01 / 0.00 / 47.6 / 4 / 0.00 | 0.0 | - |
| B | estop | 0.10 / 0.04 / 13.0 / 27 / 0.00 | 0.77 / 0.56 / 100.0 / 212 (over) / 0.19 | 0.01 / 0.00 / 47.3 / 4 / 0.00 | 0.0 | - |
| B | hold-bal-lim | 0.34 / 0.34 / 2.3 / 94 / 0.00 | 0.65 / 0.54 / 99.3 / 180 / 0.45 | 0.00 / 0.00 / 0.0 / 0 / 0.00 | 0.0 | - |
| B | hold-bal | 0.34 / 0.41 / 2.3 / 94 / 0.00 | 0.97 / 0.79 / 37.8 / 270 (over) / 0.16 | 0.01 / 0.00 / 0.0 / 4 / 0.00 | 0.0 | - |
| B | hold | 1.00 / 0.84 / 39.1 / 276 (over) / 0.16 | 0.97 / 0.80 / 37.8 / 270 (over) / 0.16 | 0.29 / 0.00 / 0.3 / 81 / 0.00 | 0.0 | - |
| B | push-bal | 0.52 / 0.20 / 0.6 / 144 / 0.00 | 0.96 / 1.35 / 13.1 / 265 (over) / 0.14 | 0.86 / 0.14 / 0.5 / 238 (over) / 0.00 | 100.5 | 162 |
| B | push | 0.91 / 0.20 / 0.9 / 253 (over) / 0.00 | 0.94 / 1.36 / 13.1 / 259 (over) / 0.14 | 0.99 / 0.13 / 1.3 / 275 (over) / 0.00 | 100.7 | 162 |
| B | reach-bal-lim | 0.40 / 0.73 / 1.6 / 110 / 0.00 | 0.01 / 0.01 / 0.0 / 3 / 0.00 | 0.19 / 0.35 / 1.0 / 52 / 0.00 | 0.0 | - |
| B | reach-bal | 0.40 / 0.73 / 1.6 / 110 / 0.00 | 0.01 / 0.01 / 0.0 / 3 / 0.00 | 0.19 / 0.35 / 1.0 / 52 / 0.00 | 0.0 | - |
| B | reach | 0.68 / 1.46 / 1.9 / 189 (over) / 0.02 | 0.02 / 0.03 / 0.0 / 5 / 0.00 | 0.33 / 0.68 / 1.0 / 92 / 0.00 | 0.0 | - |
| B | wave-bal-lim | 0.65 / 0.34 / 1.4 / 180 / 0.01 | 0.24 / 0.09 / 0.7 / 66 / 0.00 | 0.34 / 0.20 / 1.4 / 95 / 0.00 | 0.0 | - |
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
| C | wave | 1.00 / 1.98 / 35.0 / 462 (over) / 0.71 | 0.39 / 0.52 / 2.2 / 179 / 0.00 | 0.23 / 0.14 / 1.6 / 108 / 0.00 | 0.0 | - |
| C+SANDBAGS2 | push-bal | 0.83 / 0.06 / 0.9 / 382 (over) / 0.00 | 0.99 / 1.12 / 14.7 / 458 (over) / 0.12 | 0.93 / 0.07 / 1.8 / 429 (over) / 0.00 | 100.5 | 215 |
