MarkDannemiller/JackOLantern/SingingPumpkin/Christmas_version.py

import mediapipe
import cv2
import subprocess
import time
import RPi.GPIO as GPIO
import vlc
import pyautogui
#subprocess.Popen("unclutter -idle 0.01", shell=True)
# from PIL import Image
#from gpiozero import MotionSensor
#import pygame
#pir = MotionSensor(3)
drawingModule = mediapipe.solutions.drawing_utils
handsModule = mediapipe.solutions.hands
cam = cv2.VideoCapture(0)
pir_pin=17
GPIO.setmode(GPIO.BCM)
GPIO.setup(pir_pin, GPIO.IN)
index_top=0
index_lower=0
second_top=0
second_lower=0
third_top=0
third_lower=0
fourth_top=0
fourth_lower=0
thumb_top=0
thumb_lower=0
first_finger=0
second_finger=0
third_finger=0
fourth_finger=0
fifth_thumb=0
first_song=0
second_song=0
third_song=0
fourth_song=0
fifth_song=0
counter_tracking1=0
counter_tracking2=0
counter_tracking3=0
counter_tracking4=0
counter_tracking5=0
counter_tracking6=0
counter_tracking7=0
song=0
active=0
time_off=0
screen_power=0

def pumpkin_on(Path, song):

    time.sleep(.1)

    instance=vlc.Instance('--no-osd', '--no-video-title-show', '--vout=xvideo')
    display=instance.media_player_new()
    #display.set_fullscreen(True)
    video=instance.media_new(Path)
    display.set_media(video)
    #display.video_set_mouse_input(False)
    #display.video_set_key_input(False)
    #display.set_fullscreen(True)
    #display.set_fullscreen(False)
    #refresh_check()

    
    #display.toggle_fullscreen()
    time.sleep(.1)
    
    if song==1:
        song_duration=42
    elif song==2:
        song_duration=40
    elif song==3:
        song_duration=41
    elif song==4:
        song_duration=42
    elif song==5:
        song_duration=41
    elif song==6:
        song_duration=43
    elif song==7:
        song_duration=70
    else:
        song_duration=0

    #refresh_check()
    display.play()
    
    refresh()
    display.set_pause(0)
    time.sleep(1)
    display.set_pause(0)
    #refresh_check()
    display.set_fullscreen(True)
    
    time.sleep(1.3)
    #pyautogui.hotkey('alt', 'f11')
    #display.set_pause(1)
    #time.sleep(.1)
    #pyautogui.hotkey('alt', 'f11')
    display.set_pause(0)
    refresh()
    refresh_check()
    display.set_fullscreen(True)
    #print("hi")
    #pyautogui.hotkey('alt', 'f11')
    #display.set_fullscreen(True)
    #pyautogui.click(x=100, y=200)
    #pyautogui.hotkey('alt', 'f11')
    #refresh_check()
    
    time.sleep(song_duration)
    
    display.release()
    refresh()
    #screen_off
    #image.kill()
def screen_off():
    image_location="/home/pumpkin2/Music/blank.jpg"
    image=subprocess.Popen(["feh", "--hide-pointer", "--fullscreen", image_location])
def refresh():
    try:
        window="feh"
        command=f'xdotool search --name "{window}" windowactivate'
        subprocess.call(["/bin/bash", "-c", command])
    except:
        pass
def refresh_check():
    try:
        window="VLC media player"
        command=f'xdotool search --name "{window}" windowactivate'
        subprocess.call(["/bin/bash", "-c", command])
        #time.sleep(1)
        #pyautogui.hotkey('alt', 'f11')
        #print("good")
    except:
        pass


def screen_off_full():
    subprocess.run(["vcgencmd", "display_power", "0"])
def screen_on():
    subprocess.run(["vcgencmd", "display_power", "1"])
    
    

screen_off()     
with handsModule.Hands(static_image_mode=False, min_detection_confidence=0.45, min_tracking_confidence=0.7, max_num_hands=1) as hands:
#while True:
    #pir.wait_for_motion()
#     if GPIO.input(pir_pin):
#         cam=cv2.VideoCapture(0)
#         time_active=time.time()
#         active=0
#     if (time.time()-time_active>=10):
#         active=1
#         screen_off()
#         cam.release()
    #while (active!=1)
#while (pir_no_count<100):
#    if (GPIO.input(pir_pin)!=0):
#        pir_count=0
#    else:
#        pir_no_count=pir_count+1 300
    while (True):
        refresh()
        ret, frame = cam.read()
        frame1 = cv2.resize(frame, (1900, 1000))
        frame1=cv2.flip(frame1, flipCode=-1)
        frame1=frame1[200:, :]
           
        location = hands.process(cv2.cvtColor(frame1, cv2.COLOR_BGR2RGB))
           
        if location.multi_hand_landmarks==None:
            first_finger=0
            second_finger=0
            third_finger=0
            fourth_finger=0
            fifth_thumb=0
            counter_tracking1=0
            counter_tracking2=0
            counter_tracking3=0
            counter_tracking4=0
            counter_tracking5=0
            if time_off==0:
                time_off=time.time()
            if time.time()-time_off>=600 and screen_power==0:
                screen_off_full()
                screen_power=1
        elif location.multi_hand_landmarks != None:
            time_off=0
            if screen_power==1:
                screen_on()
                screen_power=0
                
            for handLandmarks in location.multi_hand_landmarks:
                drawingModule.draw_landmarks(frame1, handLandmarks, handsModule.HAND_CONNECTIONS)

                for point in handsModule.HandLandmark:
                      
                    Coordinate_points = handLandmarks.landmark[point]
                    if point==8:
                        index_top=Coordinate_points.y
                    if point==6:
                        index_lower=Coordinate_points.y
                    if point==12:
                        second_top=Coordinate_points.y
                    if point==10:
                        second_lower=Coordinate_points.y
                    if point==16:
                        third_top=Coordinate_points.y
                    if point==14:
                        third_lower=Coordinate_points.y
                    if point==20:

                        fourth_top=Coordinate_points.y
                    if point==18:
                        fourth_lower=Coordinate_points.y
                    if point==4:
                        thumb_top=Coordinate_points.y
                    if point==3:
                        thumb_lower=Coordinate_points.y
                        
                        
        first_finger=0
        second_finger=0
        third_finger=0
        fourth_finger=0
        fifth_thumb=0
        if ((index_top!=0 and index_lower!=0)) and (index_top<index_lower):
            first_finger=1


        if ((second_top!=0 and second_lower!=0)) and (second_top<second_lower):
            second_finger=1


        if ((third_top!=0 and third_lower!=0)) and (third_top<third_lower):
            third_finger=1
           
        
        if ((fourth_top!=0 and fourth_lower!=0)) and (fourth_top<fourth_lower):
            fourth_finger=1
            
            
        if ((thumb_top!=0 and thumb_lower!=0)) and (thumb_top<thumb_lower):
            fifth_thumb=1






        '''if (first_finger==1 and second_finger==0 and third_finger==0 and fourth_finger==0):
            counter_tracking1=counter_tracking1 + 1
            counter_tracking2=0
            counter_tracking3=0
            counter_tracking4=0
            counter_tracking5=0
            counter_tracking6=0
            counter_tracking7=0
            #print(counter_tracking1)
            if (counter_tracking1 >12):
                song=1
                #time.sleep(2)
                #screen_on()
                #print("Hi")
                Path = '/home/pumpkin2/Music/final/Thriller_Final.mp4'
                pumpkin_on(Path, song)
                first_song=0
                second_song=0
                third_song=0
                fourth_song=0
                fifth_song=0
                counter_tracking1=0
                #print( "Song: 1")
                #screen_off()
                time.sleep(5)
                song=0
        elif (first_finger==1 and second_finger==1 and third_finger==0 and fourth_finger==0):
            counter_tracking2=counter_tracking2 + 1
            counter_tracking1=0
            counter_tracking3=0
            counter_tracking4=0
            counter_tracking5=0
            counter_tracking6=0
            counter_tracking7=0
            #print(counter_tracking2)
            if (counter_tracking2> 12):
                song=2
                #screen_on()
                Path = '/home/pumpkin2/Music/final/Werewolves_1.mp4'
                pumpkin_on(Path, song)
                first_song=0
                second_song=0
                third_song=0
                fourth_song=0
                fifth_song=0
                counter_tracking2=0
                #print( "Song: 2")
                #screen_off()
                time.sleep(5)
                song=0
        elif (first_finger==1 and second_finger==1 and third_finger==1 and fourth_finger==0):
            counter_tracking3=counter_tracking3 + 1
            counter_tracking1=0
            counter_tracking2=0
            counter_tracking4=0
            counter_tracking5=0
            counter_tracking6=0
            counter_tracking7=0
            if (counter_tracking3>12):
                song=3
                #screen_on()
                Path = '/home/pumpkin2/Music/final/Addams_1.mp4'
                pumpkin_on(Path, song)
                first_song=0
                second_song=0
                third_song=0
                fourth_song=0
                fifth_song=0
                counter_tracking3=0
                #print( "Song: 3")
                #screen_off()
                time.sleep(5)
                song=0
        elif (first_finger==1 and second_finger==1 and third_finger==1 and fourth_finger==1):
            counter_tracking4=counter_tracking4 + 1
            counter_tracking1=0
            counter_tracking2=0
            counter_tracking3=0
            counter_tracking5=0
            counter_tracking6=0
            counter_tracking7=0
            if (counter_tracking4>12):
                song=4
                #screen_on()
                Path = '/home/pumpkin2/Music/final/Ghostbusters_1.mp4'
                pumpkin_on(Path, song)
                first_song=0
                second_song=0
                third_song=0
                fourth_song=0
                fifth_song=0
                counter_tracking4=0
                #print( "Song: 4")
                #screen_off()
                time.sleep(5)
                song=0
        elif (first_finger==0 and second_finger==0 and third_finger==0 and fourth_finger==1):
            counter_tracking5=counter_tracking5 + 1
            counter_tracking1=0
            counter_tracking2=0
            counter_tracking3=0
            counter_tracking4=0
            counter_tracking6=0
            counter_tracking7=0
            if (counter_tracking5>12):
                song=5
                #screen_on()
                Path = '/home/pumpkin2/Music/final/Monsters_1.mp4'
                pumpkin_on(Path, song)
                first_song=0
                second_song=0
                third_song=0
                fourth_song=0
                fifth_song=0
                counter_tracking5=0
                #print( "Song: 5")
                #screen_off()
                time.sleep(5)
                song=0'''
                
                
                
                
                
                
        if (first_finger==1 and second_finger==0 and third_finger==0 and fourth_finger==1):
            counter_tracking6=counter_tracking6 + 1
            counter_tracking1=0
            counter_tracking2=0
            counter_tracking3=0
            counter_tracking4=0
            counter_tracking5=0
            counter_tracking7=0
            if (counter_tracking6>12):
                song=6
                #screen_on()
                Path = '/home/pumpkin2/Music/final/video_1.mp4'
                pumpkin_on(Path, song)
                first_song=0
                second_song=0
                third_song=0
                fourth_song=0
                fifth_song=0
                counter_tracking6=0
                #print( "Song: 5")
                #screen_off()
                time.sleep(5)
                song=0
        elif (first_finger==1 and second_finger==1 and third_finger==0 and fourth_finger==1):
            counter_tracking7=counter_tracking7 + 1
            counter_tracking1=0
            counter_tracking2=0
            counter_tracking3=0
            counter_tracking4=0
            counter_tracking5=0
            counter_tracking6=0
            if (counter_tracking7>12):
                song=7
                #screen_on()
                Path = '/home/pumpkin2/Music/final/video_2.mp4'
                pumpkin_on(Path, song)
                first_song=0
                second_song=0
                third_song=0
                fourth_song=0
                fifth_song=0
                counter_tracking7=0
                #print( "Song: 5")
                #screen_off()
                time.sleep(5)
                song=0



        cv2.imshow("Frame", frame1);
        #screen_off
        key = cv2.waitKey(1) & 0xFF
           
        if key == ord("x"):
            screen_on()
            break
