MarkDannemiller/JackOLantern/(commit log)

2023-09-24 added new i2c lubrary
2023-09-27 characterized eye servos
2023-09-29 added pid servo
2023-09-29 added ServoFollower
2023-09-30 added speed limit to servo
2023-09-30 robot servo control code
2023-09-30 fixed circular import issue
    [motion_controller.py, pid_servo.py]
2023-10-03 Added stepper code
2023-10-07 stepper implementation
2023-10-07 stepper implement
2023-10-09 Changed Stepper_update_interval
2023-10-10 print face data
2023-10-11 fixed tracker forgetting too long
    [face_tracker.py, motion_controller.py]
2023-10-13 audio code playing
    [audio_data.csv]
2023-10-14 work on jaw
    [audio_data.csv]
2023-10-16 speaking code
    [audio_data.csv]
2023-10-24 updated control
    [audio_data.csv]
2023-10-24 change filename
    [audio_data_v1.csv]
2023-10-24 fixed neck movement
    [audio_data.csv]
2023-10-26 added new voice lines
    [audio_data.csv, audio_data_v2.csv]
2023-10-31 pumpkin diagram
2023-11-15 added new PID stepper class
2023-12-03 led eyes
2023-12-03 implement stepper and limit
2026-10-24 Joyful Jack: Protoboard project, head model, three body/arm tiers, CAD, renders, report
    - Sort the 2023 head repo into a Protoboard project (head code moved to protoboard/software/head)
    - Recreate the head in UHD from the Fusion/STEP files and the code
    - Model tiers A (<$500), B (<=$1200), C (maxed, humanoid hands); all pass protoboard check
    - Parametric CAD (build123d), sizing analysis, Blender renders and animations
    - Sourced BOMs and a design report (deliverables/2026-10-25-design-report)
    Claude-Session: https://claude.ai/code/session_019o7jjXLwJ1Ns7SQQJ7gmeW
2026-10-24 Joyful Jack: full-hardware model, build guides, Isaac Sim proof, BOM v2, report rev 2
    - Mechanical model of every printed part, bought part and fastener (cad/mech, build123d), generated into UHD;
    all three tiers check clean. GT3 9 mm belt joints, shoulder cable balancer, tier A on belt joints, tier C STS3250 elbow.
    - Build guides per tier from protoboard release 0.2.0-a/b/c (deliverables/2026-10-25-build-guides).
    - Wiring harness cut lists; BOM v2 from model quantities (research/sourcing/20261025-bom-v2.md).
    - Isaac Sim 6.2 scenarios with servo and belt torque limits (docs/sim-results.md, decision D15).
    - GLB export fix (build123d located shapes), detailed Blender renders and animations, r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
